cross-isaac/IsaacCross_Senior_Thesis/06_Figures_and_Media/Thesis_Figures/Ch03_Beam Source Design/He_leak_test_Ar_system.JPG

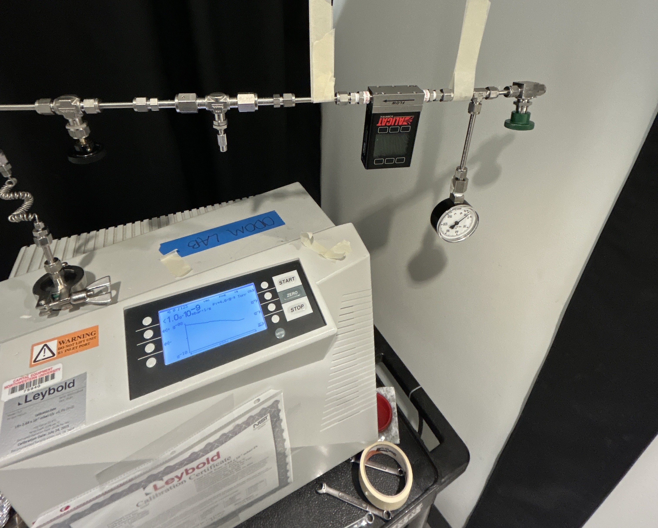
06_Figures_and_Media/Thesis_Figures/Ch03_Beam Source Design/He_leak_test_Ar_system.JPG
