cross-isaac/IsaacCross_Senior_Thesis/00_Thesis/README.md

# 00_Thesis — The thesis itself

- **`IsaacCross_SeniorThesis_2026.pdf`** — Final thesis (106 pages): *A Tunable Dual-Species
  Rubidium-Argon Beam Source for Controlled Doped Cryogenic Crystal Growth*.
  Chapters: 1 Intro · 2 Background (doped cryogenic crystals, T1/T2/T2*) ·
  3 Beam source design · 4 Characterization methods · 5 Characterization results ·
  6 Dipole-dipole broadening Monte Carlo · Appendices A–D (CAD drawings, Rb data,
  absorption data, simulation code).
- **`IsaacCross_SeniorThesis.zip`** — Full LaTeX source of the final document
  (chapter .tex files, figures, `references (2).bib`).
- **`thesis_content_tracker.md`** — Working outline used while writing: confirmed content,
  things tried and abandoned (fiber coupling, lock-in amplification), open questions
  (Method A vs. B divergence discrepancy, Rb flux ~100× below vapor-pressure expectation).
  Useful record of loose ends for follow-up work.

Note: an earlier, different LaTeX skeleton (9-chapter layout, AI-assisted) is archived at
`99_Archive/ai_generated_drafts/thesis_project_v2.zip`.
