cross-isaac/IsaacCross_Senior_Thesis/07_Talks_and_Posters/A Dual-Species Beam Source  for Doped Cryogenic Crystal Growth, CFP Pre talk.pptx

## A Dual-Species Beam Source for Doped Cryogenic Crystal Growth

Isaac K. Cross
04/14/2026 CFP Pre-talk

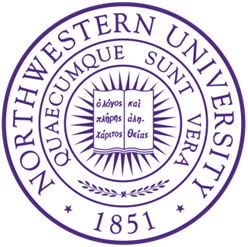
[picture p3: figure]
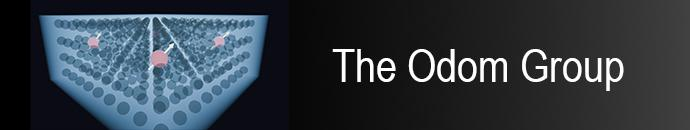
[picture p4: figure]
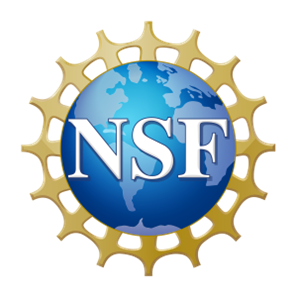
[picture p5: figure]

## Doped Cryogenic Crystal

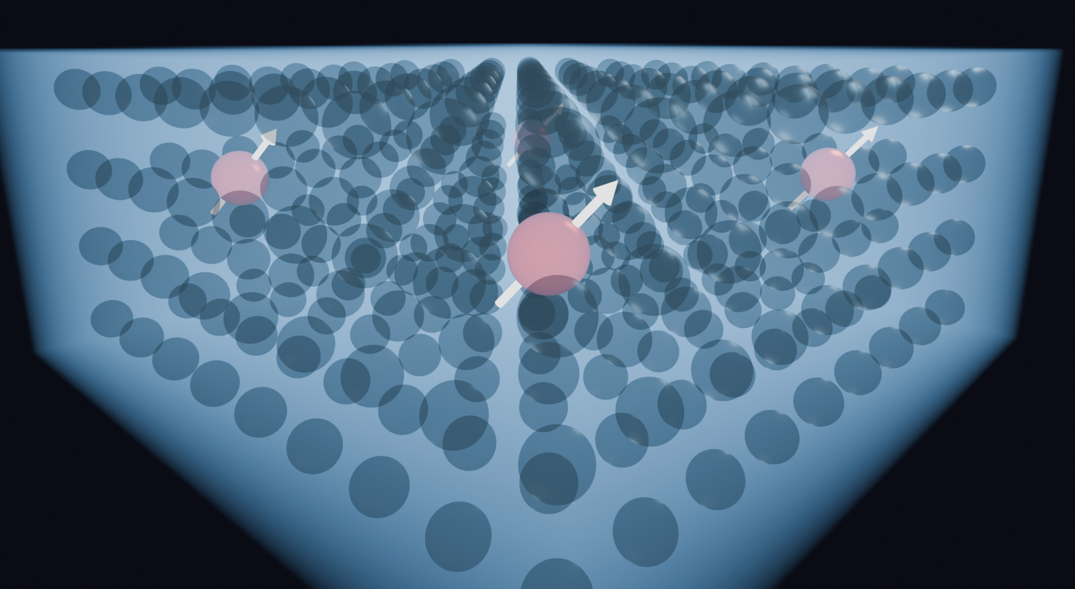
[picture p6: figure]

Inert Cryogenic Noble Gas Crystal Host
(e.g. Argon)

Dopant to be probed (e.g. Rb), up to 10^19 dopants/mm^3

*Not to scale

## Slide 3

Leading EDM Platforms

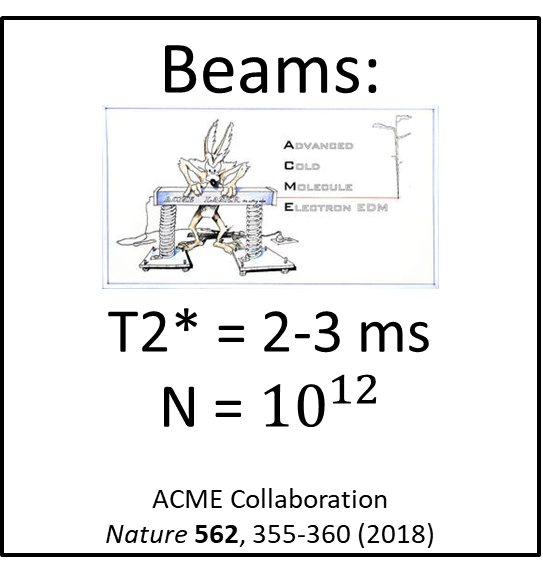
[picture p7: figure]
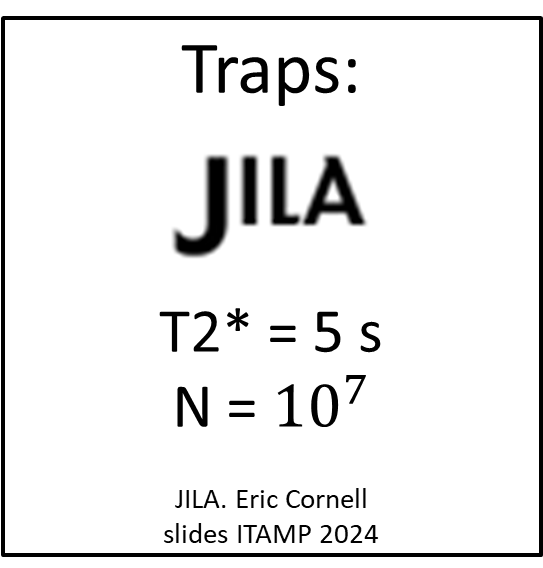
[picture p8: figure]
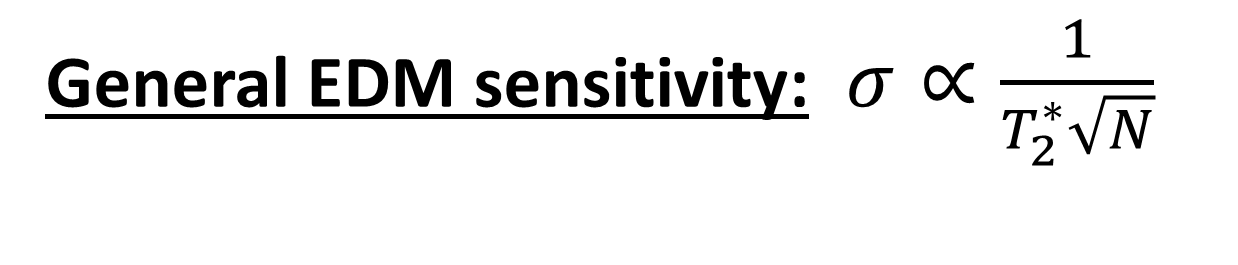
[picture p9: figure]

## Slide 4

Leading EDM Platforms

Doped Crystals?

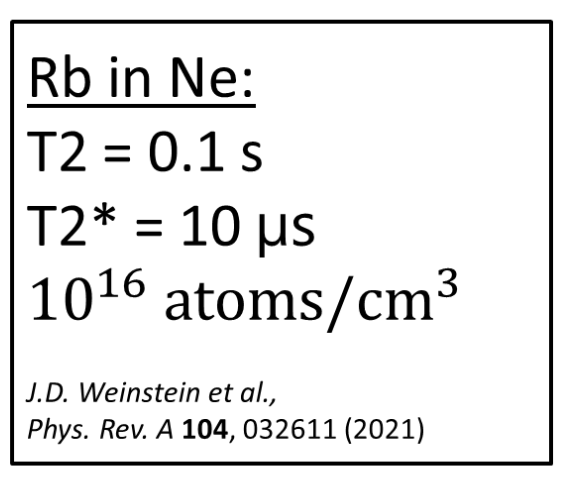
[picture p10: figure]

Notes: such that a doped cryocrystal could in principle provide in seconds the same uncertainty obtained by ACME in their 350-hour data set. Said a different way, the doped crystal would have over 1013 molecules in a 1 mm3 volume, which can be compared with the few hundred thousand molecules in the ACME-II beam at any given time.

## Our Growth Method

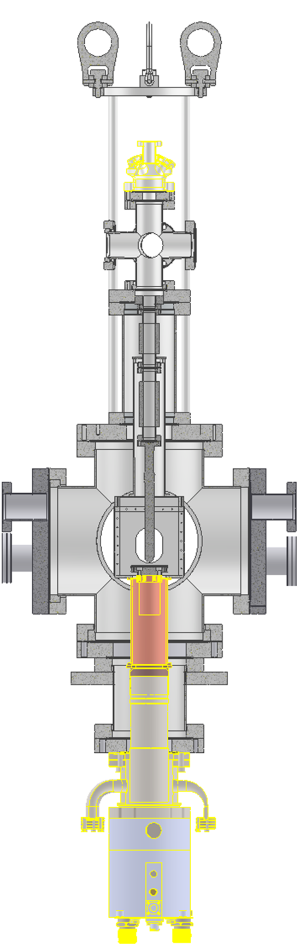
[picture p11: figure]
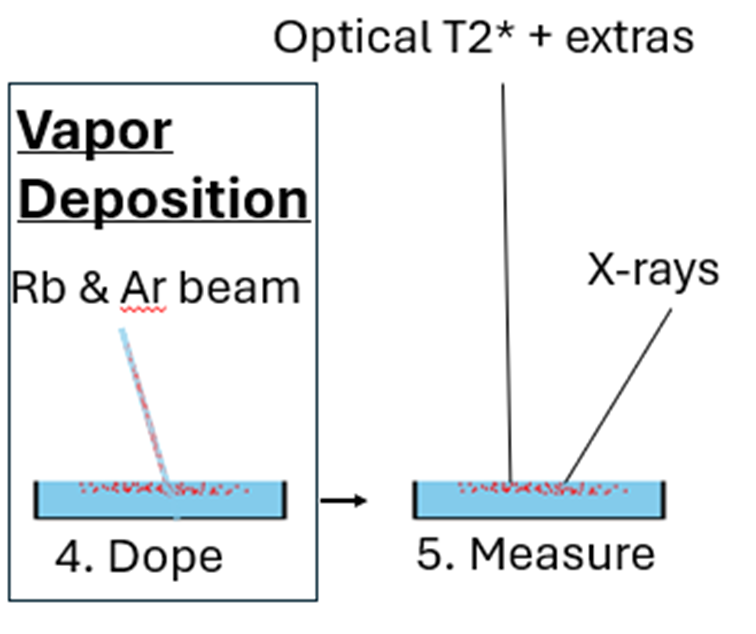
[picture p12: figure]
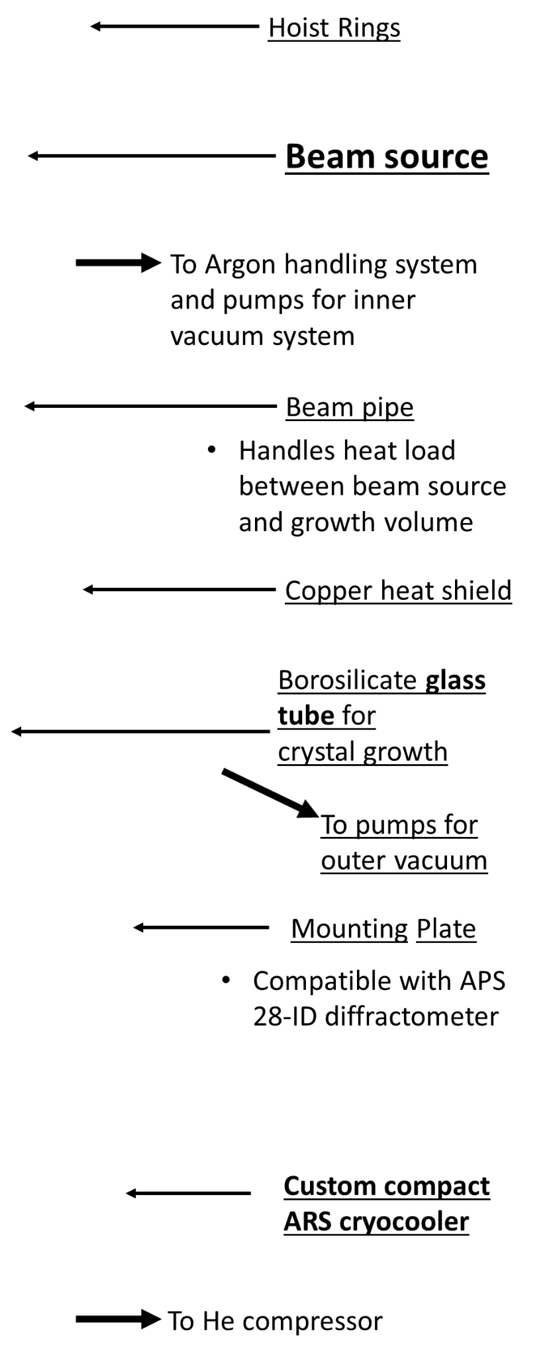
[picture p13: figure]

Notes: Expect to grow slower/ UHV

## Our Growth Method

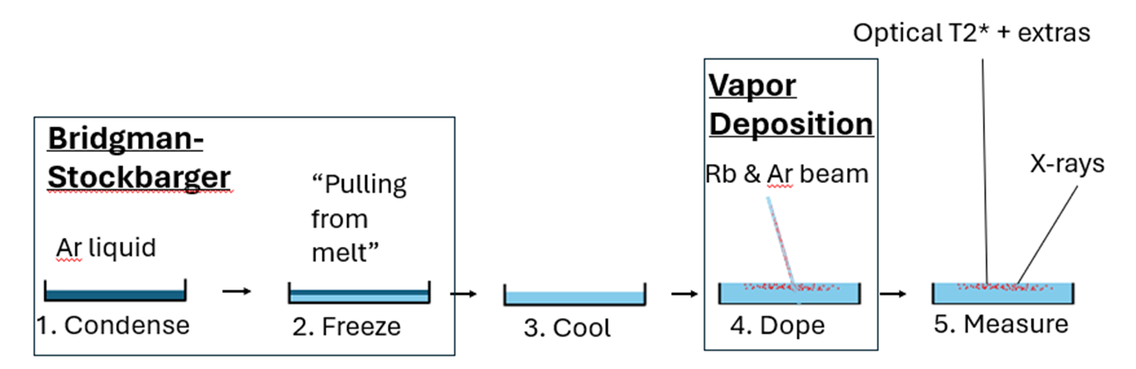
[picture p14: figure]
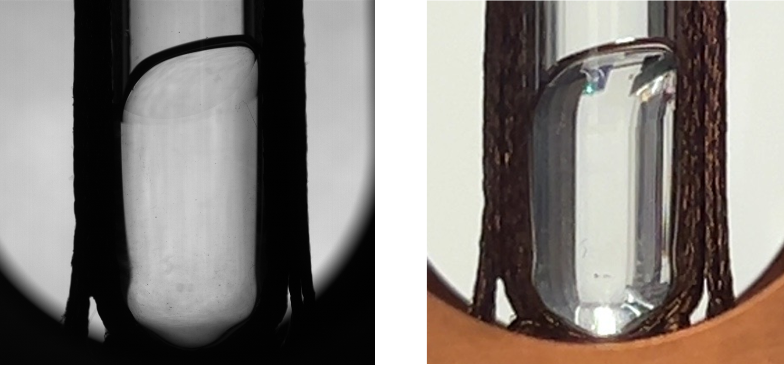
[picture p15: figure]

Ar Crystals!

Notes: Expect to grow slower/ UHV

## Our Growth Method

Ar Crystals!

Notes: Expect to grow slower/ UHV

## Beam Source Constraints

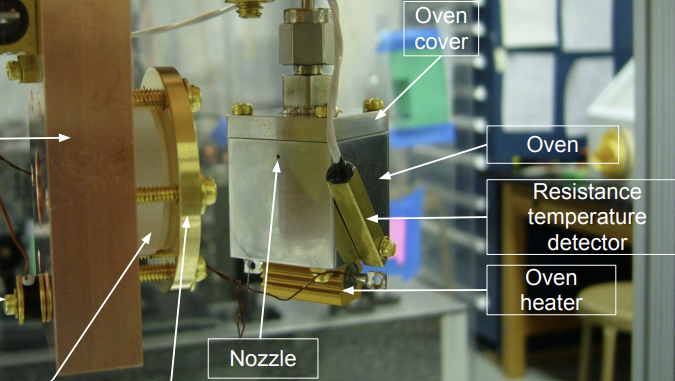
[picture p16: figure]

Regmi, 2013, M.S. thesis, University of Nevada, Reno.
Weinstein Group

Ar

Rb

- Dopant Density ∝P_(Rb) /P_(Ar)
- Growth Rate ∝P_(Ar) C_(nozzle)
- P_(Rb) ≪P_(Ar)

Notes: Also want slower growth rates than others therefore lower Ar Pressure and therefore even lower Rb pressure….

## Beam Source Constraints

Regmi, 2013, M.S. thesis, University of Nevada, Reno.
Weinstein Group

Ar

Rb

- Dopant Density ∝P_(Rb) /P_(Ar)
- Growth Rate ∝P_(Ar) C_(nozzle)
- P_(Rb) ≪P_(Ar) ⇒ T_(Rb) <0^(°) C

Notes: Also want slower growth rates than others therefore lower Ar Pressure and therefore even lower Rb pressure….

## Beam Source Constraints

Regmi, 2013, M.S. thesis, University of Nevada, Reno.
Weinstein Group

“Mixing Chamber”

Ar

“Rb Reservoir”

Rb

- P_(RbMc) ∝P_(RbRs) (C_V)/(C_V +C_N)

Notes: Check this shit plz

## Beam Source Constraints

~0.5 m

Ar

~1 cm

Rb

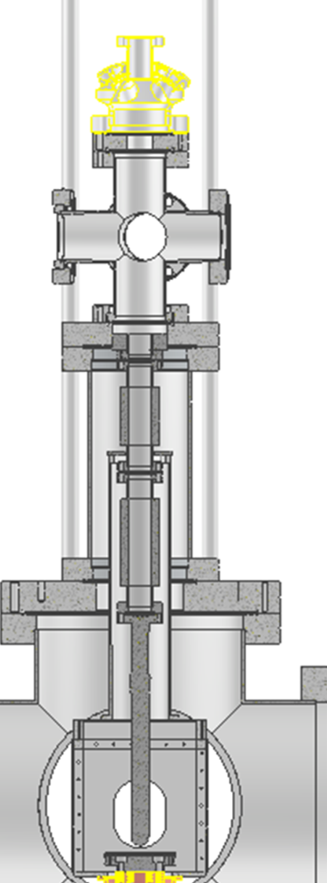
[picture p17: figure]

- Bridgman-Stockbarger ⇒ inner + outer chamber
- X-ray compatibility ⇒ strict spatial contraints
- ⇒ long path to reduce heat loads

Notes: Make it more clear how bridgman-stockbarger forces these connections and its a mechnical constraint.

## Beam Source Constraints

~0.5 m

Ar

Collimating Nozzle

~1 cm

Rb

- Need large Ar flux
- Narrow divergence

Notes: Be prepared for why not just increase Ar and Rb high enough and let it fly everywhere.

Think about Neon, gets very expensive….

## Microcapillary Nozzle Array

- 231, 100 µm ID, ~0.8 cm length microcapillaries
- Wire EDM cut 5ft microcapillary from MicroGroup
- Wire EDM cut 2.75” CF flange

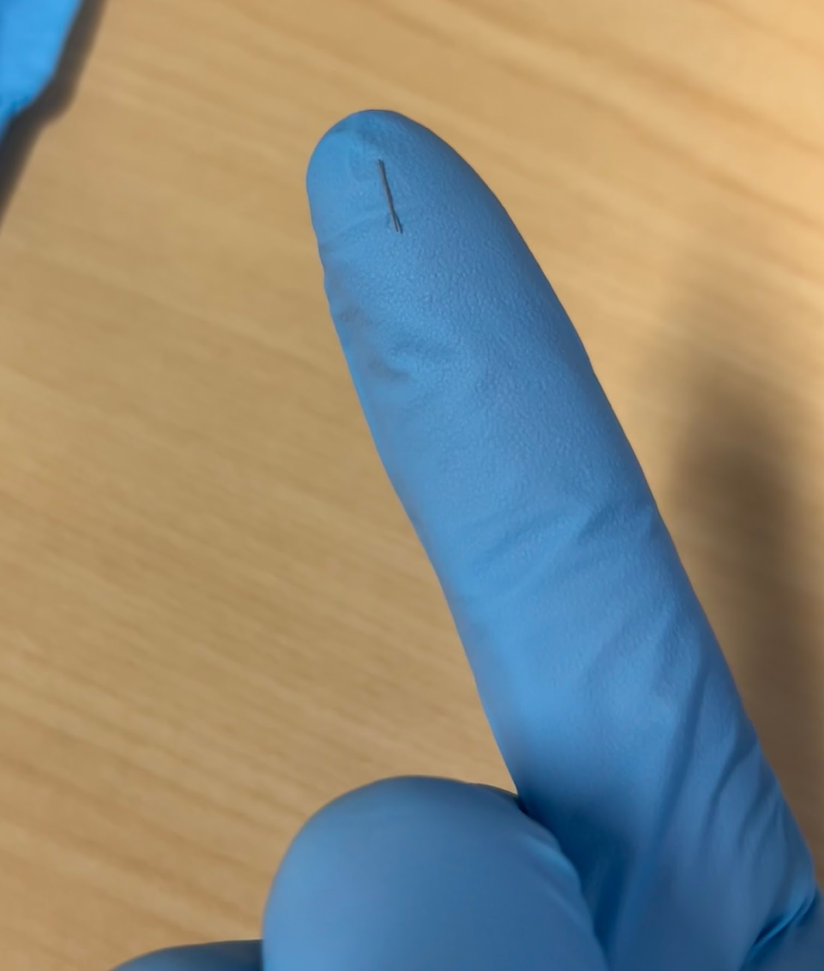
[picture p18: figure]
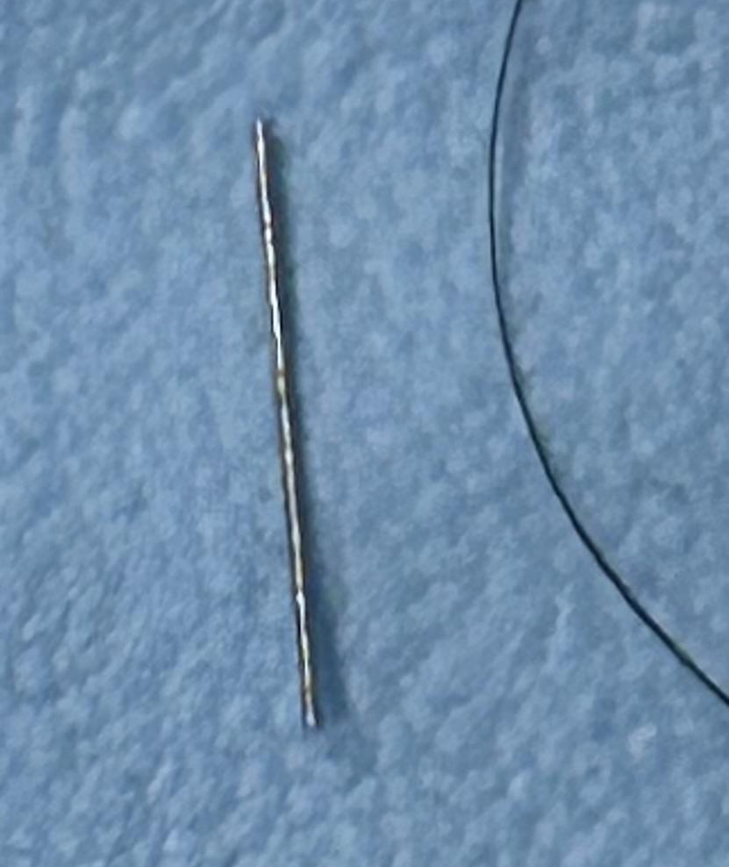
[picture p19: figure]

hair for reference

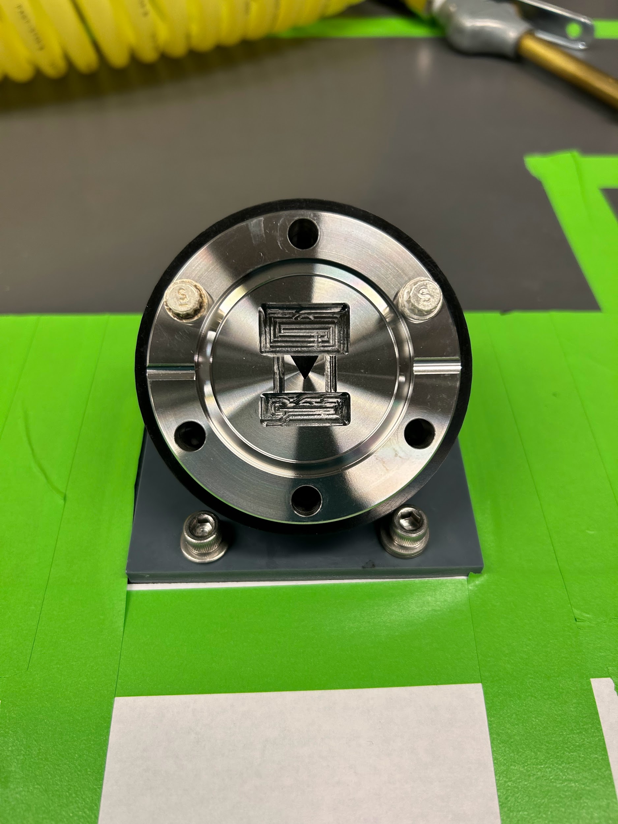
[picture p20: figure]

Assembly Setup

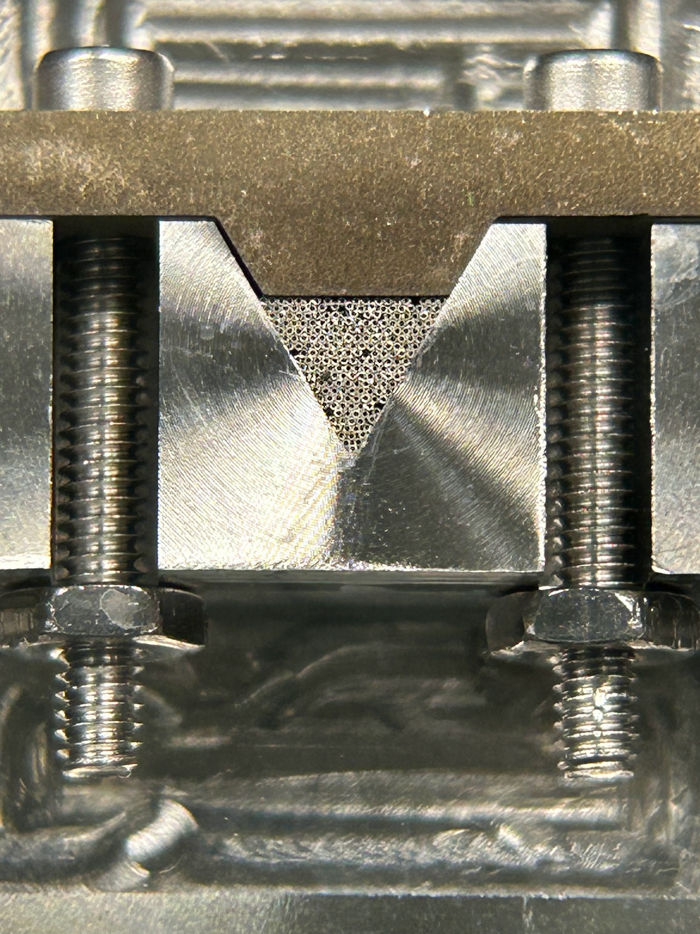
[picture p21: figure]

Oven Side

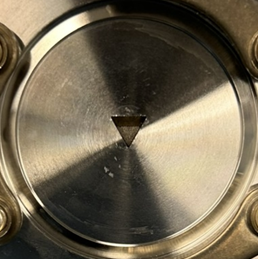
[picture p22: figure]

Growth Chamber Side

Original Design:
R. Senaratne et al., Rev. Sci. Instrum. 86, 023105 (2015).

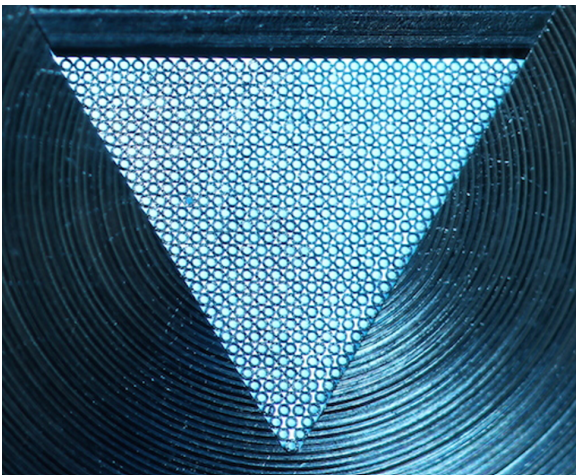
[picture p23: figure]
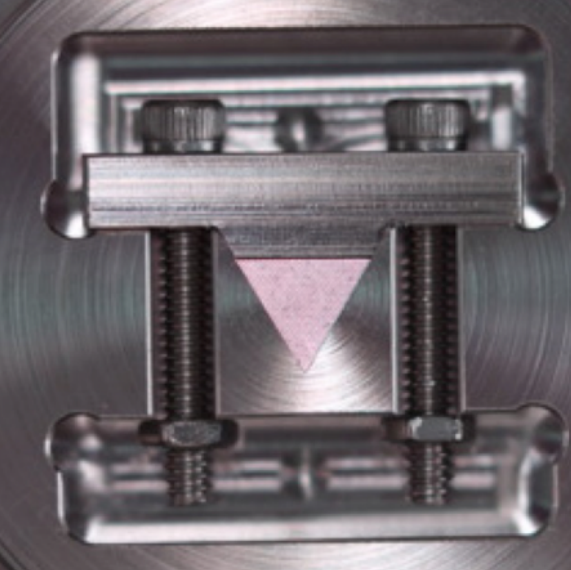
[picture p24: figure]

## Characterizing Beam Source

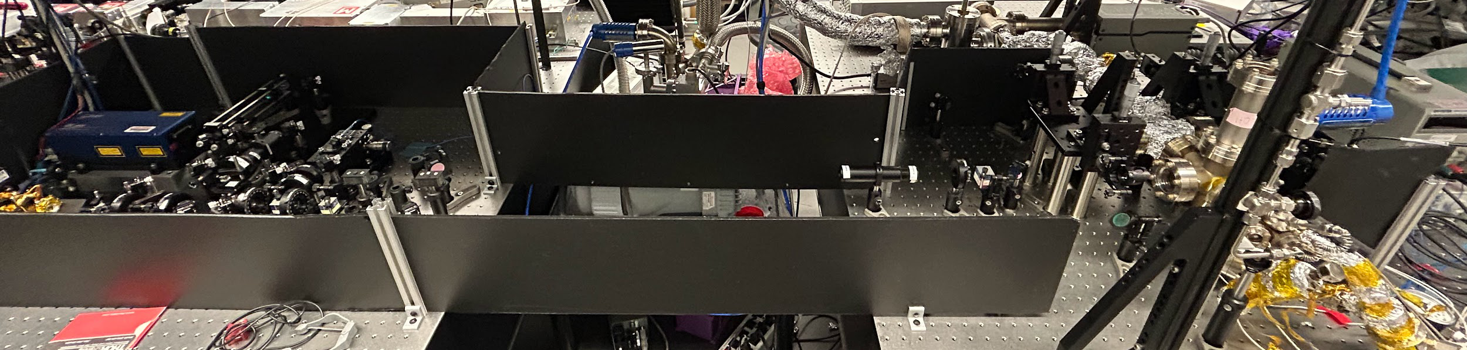
[picture p25: figure]

Nozzle

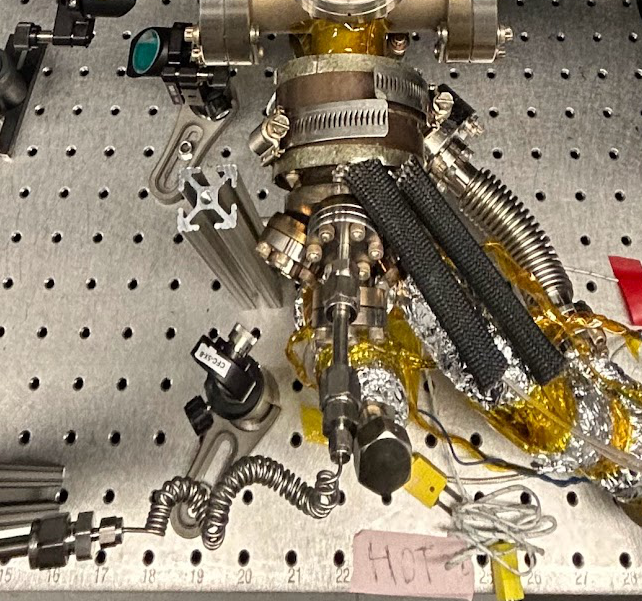
[picture p26: figure]

Rb Reservoir

Ar Line

## Characterizing Beam Source

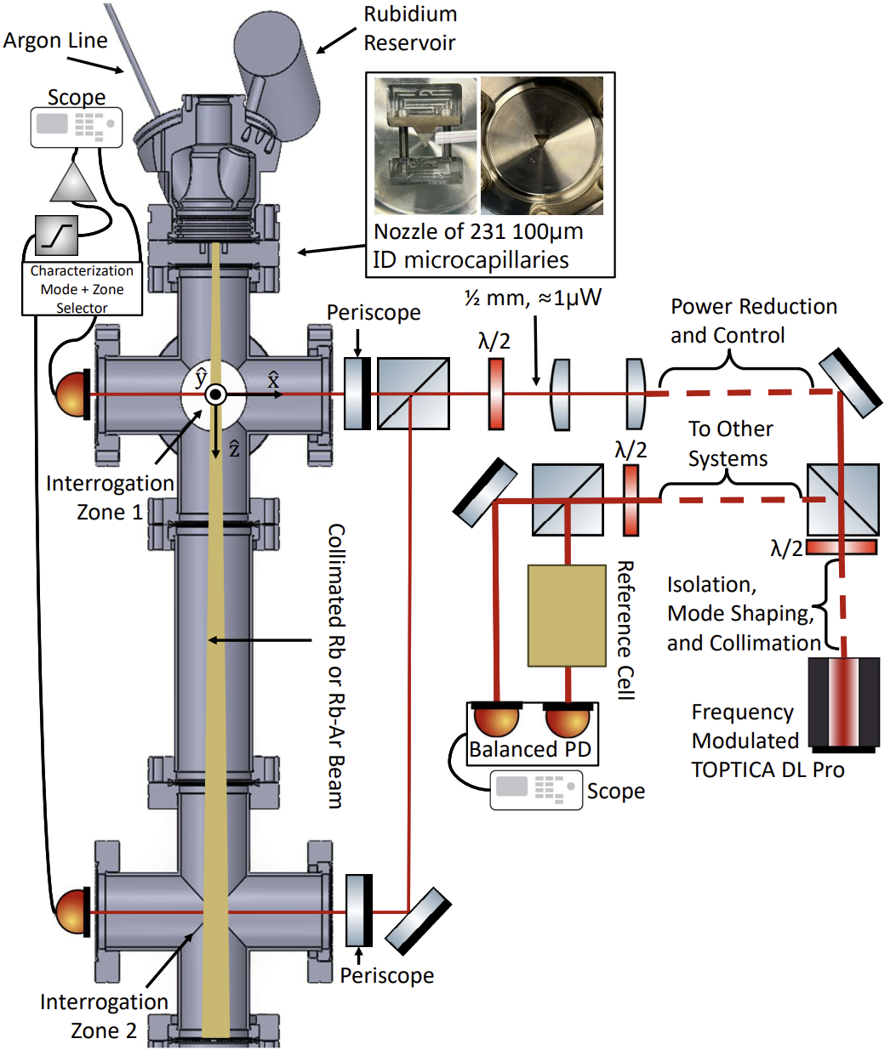
[picture p27: figure]
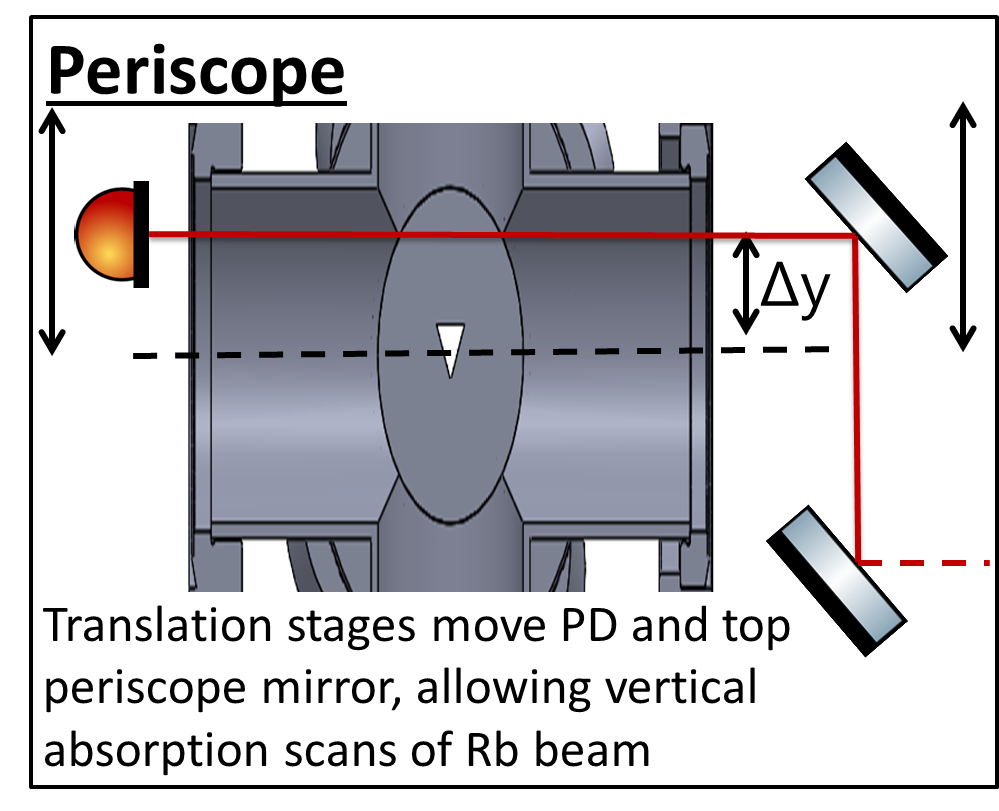
[picture p28: figure]

- λ_(Rb) ≤λ_(Ar)
- Want λ≥L_(cap)

## Characterizing Beam Source

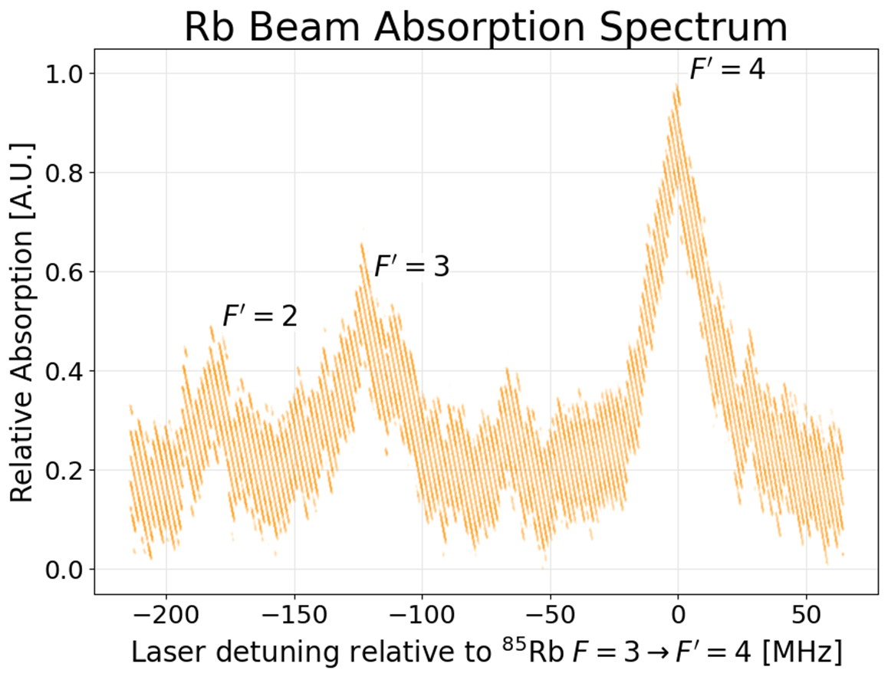
[picture p29: figure]
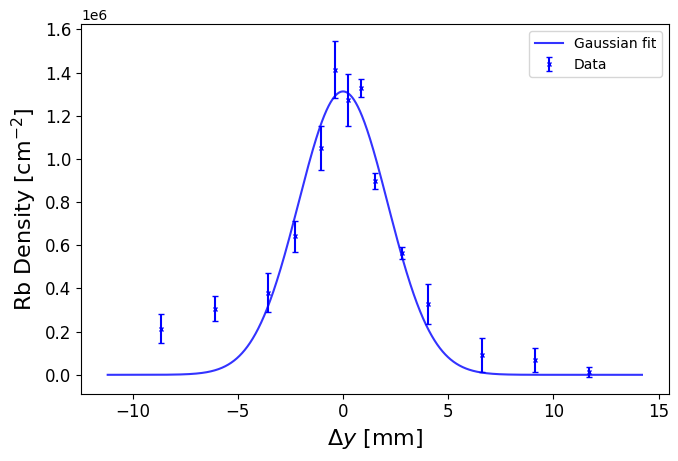
[picture p30: figure]

Notes:
Add line about sensitivity (acme stats) and time to grow crystal

## Characterizing Beam Source

- (α)_(1/e) =1±0.1 degrees
- Rb Flux: 2.5∗10^10 atoms/s
- Ar Flux: 5∗10^15 atoms/s
- Dopant Density: 10^17 dopants/cm^3
- Growth rate: 5 μm/hour

Notes:
Add line about sensitivity (acme stats) and time to grow crystal

## Characterizing Beam Source

- (α)_(1/e) =1±0.1 degrees
- Rb Flux: 2.5∗10^10 atoms/s
- Ar Flux: 5∗10^15 atoms/s
- Dopant Density: 10^17 dopants/cm^3
- Growth rate: 5 μm/hour
- ⇒10^13 dopants in 5 hours

Notes:
Add line about sensitivity (acme stats) and time to grow crystal

## Next Steps

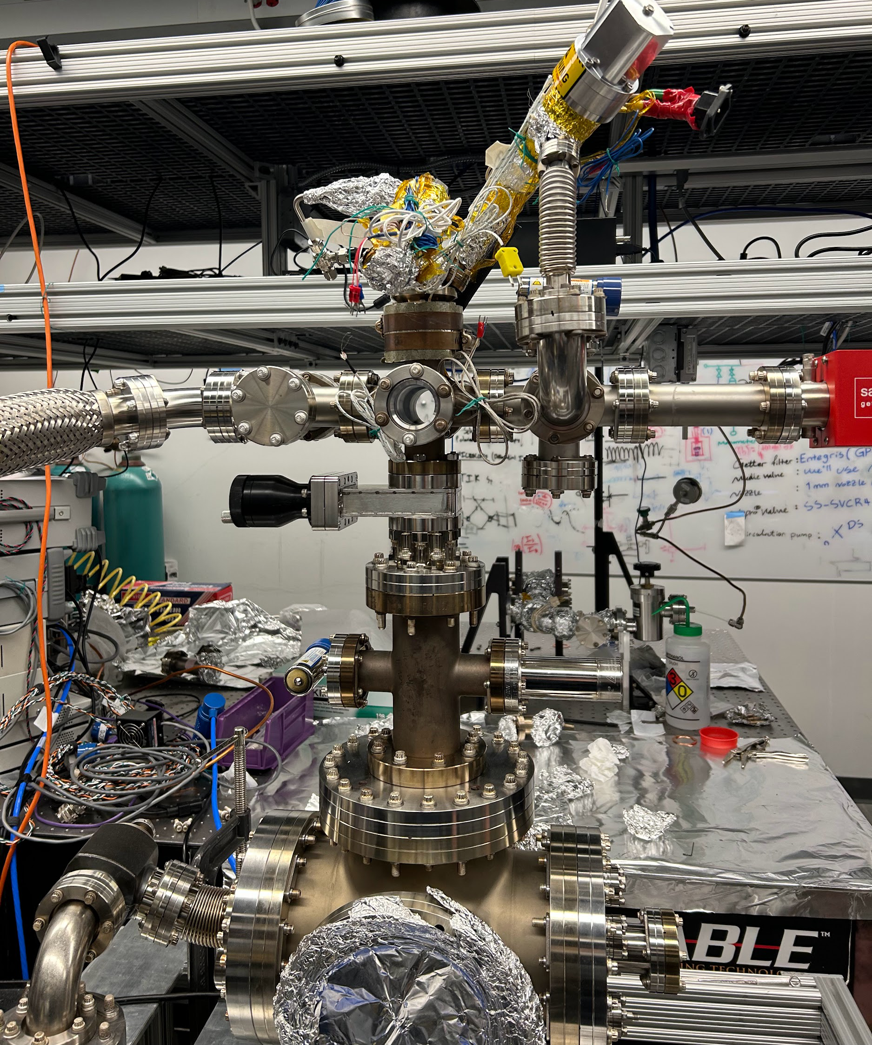
[picture p31: figure]

- Grow Doped Crystals!!
- Measure crystal properties to check beam characterization
  - Growth Rate/Dopant Density can be directly measured
- Explore larger parameter space

## Acknowledgements

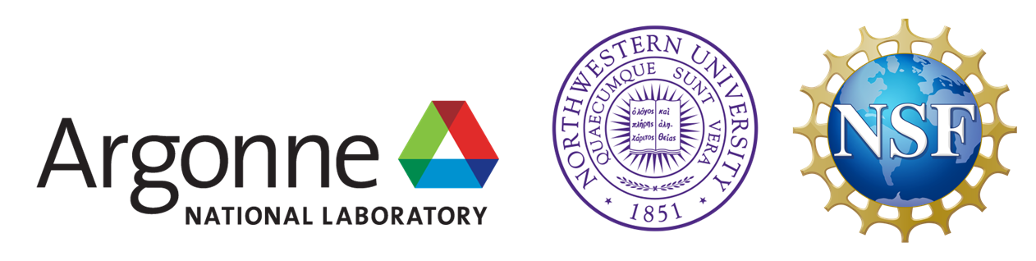
[picture p32: figure]
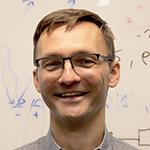
[picture p33: figure]

Brian Odom

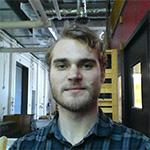
[picture p34: figure]

Daniel Lutes

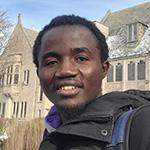
[picture p35: figure]

Joel Adhiambo

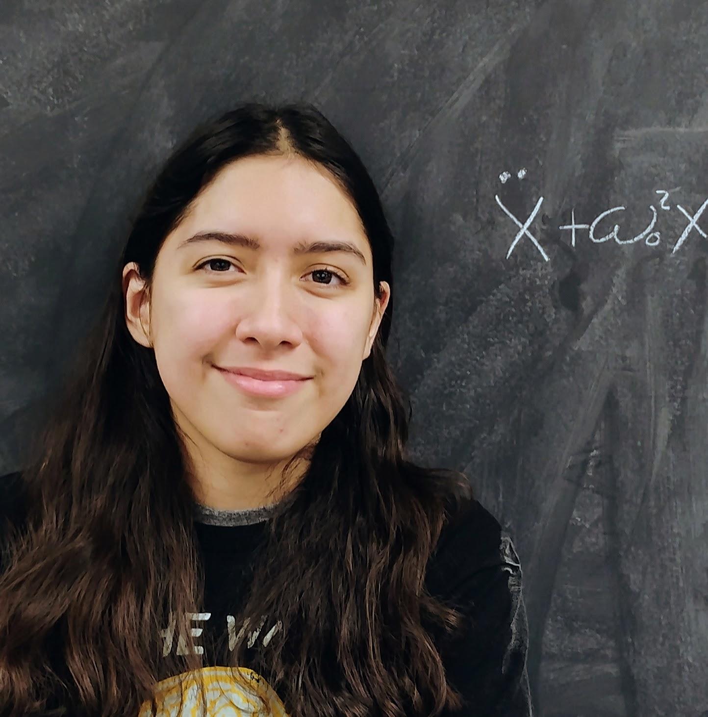
[picture p36: figure]

Haley Randall

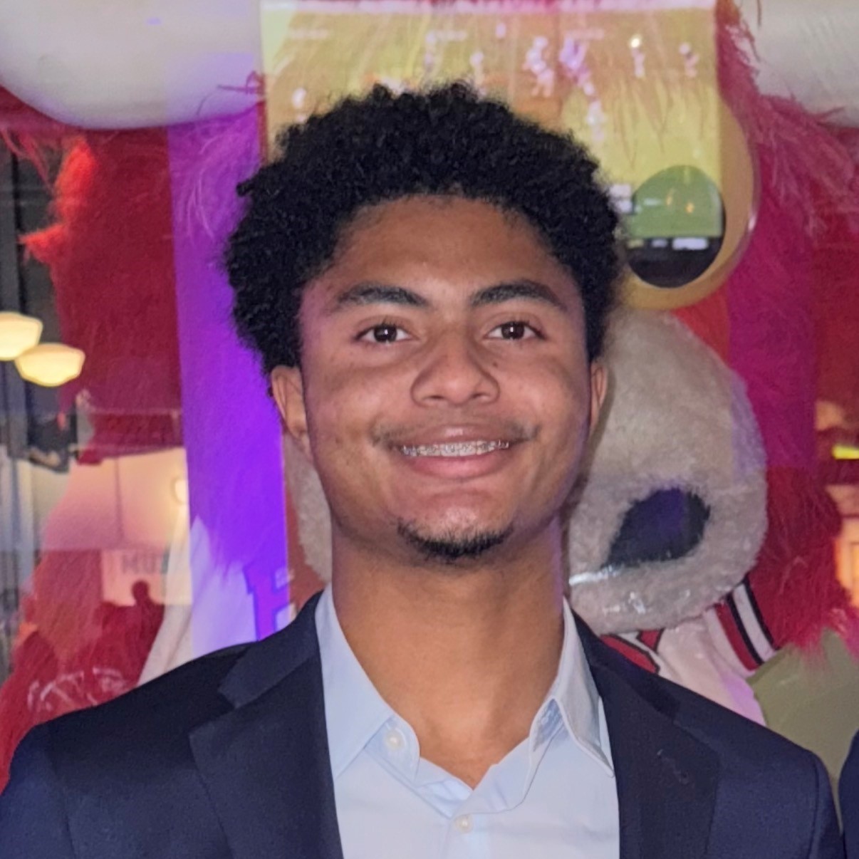
[picture p37: figure]

Brandon Lofton

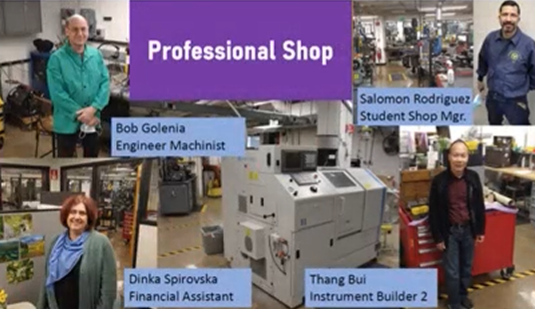
[picture p38: figure]

Kovachy
Lab

ACME

Xing Fan

Tim Kovachy

Sharika Saraf

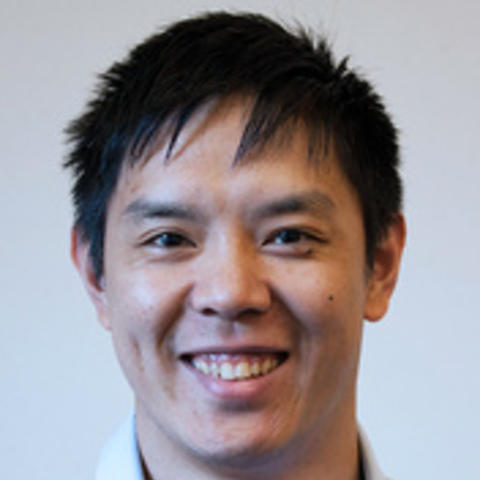
[picture p39: figure]
Prof. Xing Fan portrait

The study resulting in this presentation was assisted by a grant from the Undergraduate Research Grant Program which is administered by Northwestern University's Office of Undergraduate Research. However, the conclusions, opinions, and other statements in this presentation are the author's and not necessarily those of the sponsoring institution.

## Supplemental Slides:

## Divergence

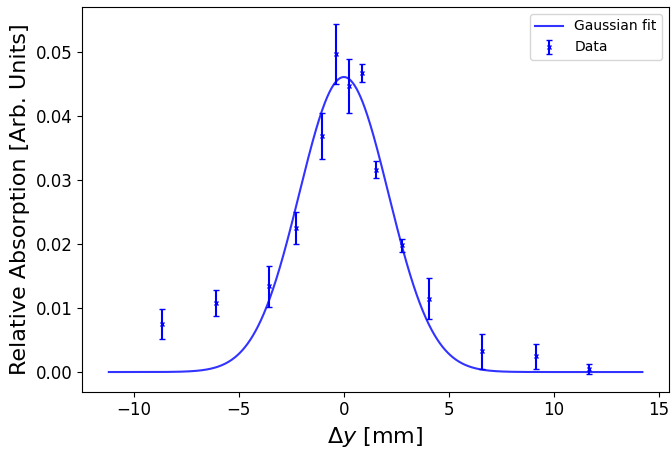
[picture p40: figure]

Θ

1/e width

Notes: Cut

## Slide 23

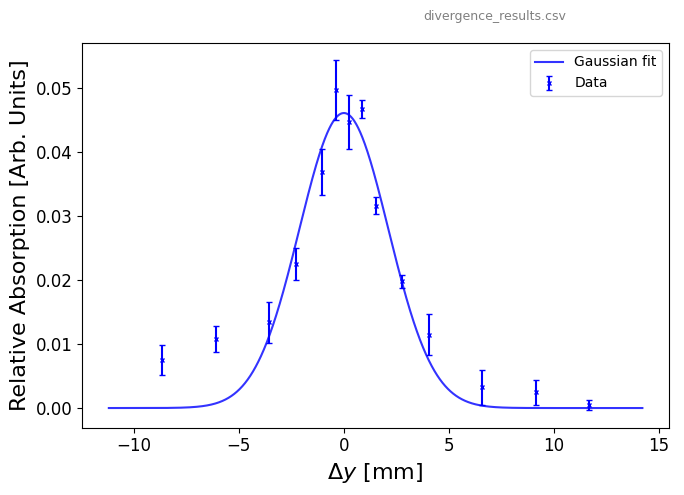
[picture p41: figure]
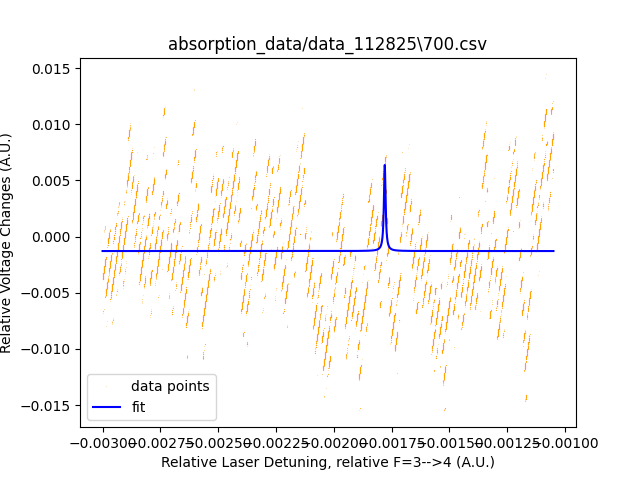
[picture p42: figure]

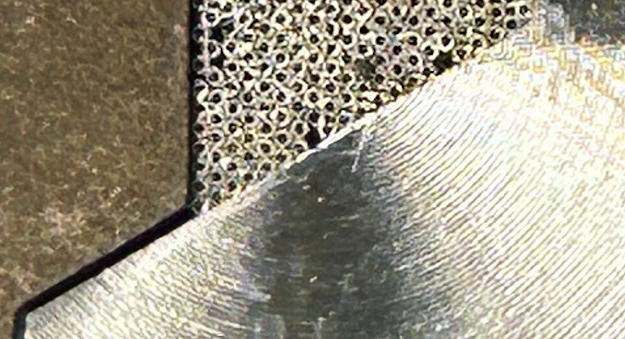
[picture p43: figure]

## Rb-Ar

Smth about Ar and Rb being same divergence….

- λ = k_B T/(sqrt[2]pi*d^2*P)
- Prb << Par
- λrb/λar ~ d_ar^2/d_rb^2
~½

- Want λ ~> L > d to get aspect ratio like divergence.
- -> λrb will exit ideal regime of divergence set by aspect ratio before λar does

Notes: Cut

## Slide 25

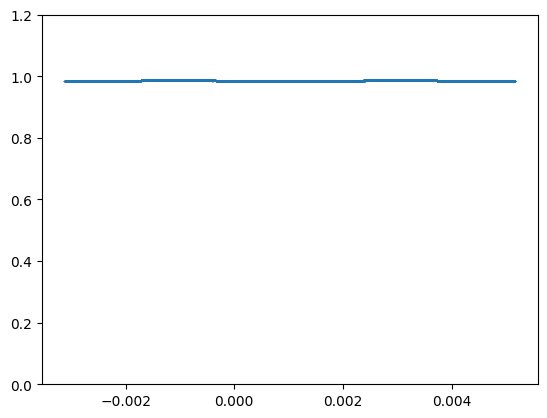
[picture p44: figure]
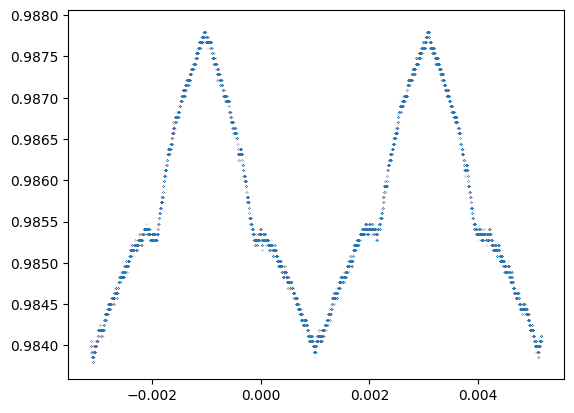
[picture p45: figure]
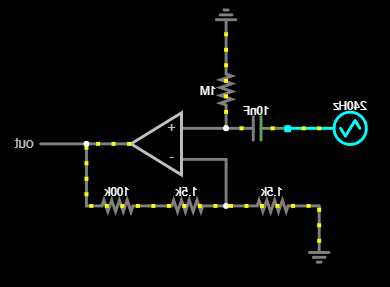
[picture p46: figure]
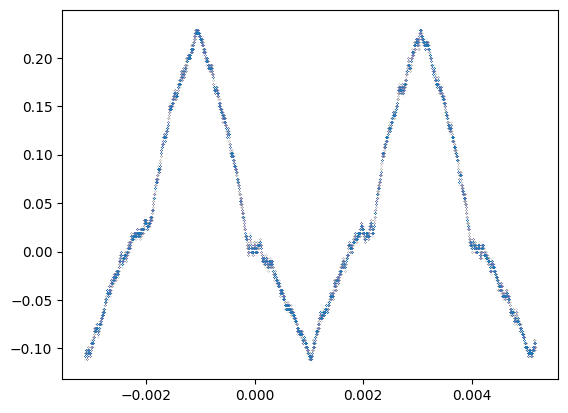
[picture p47: figure]
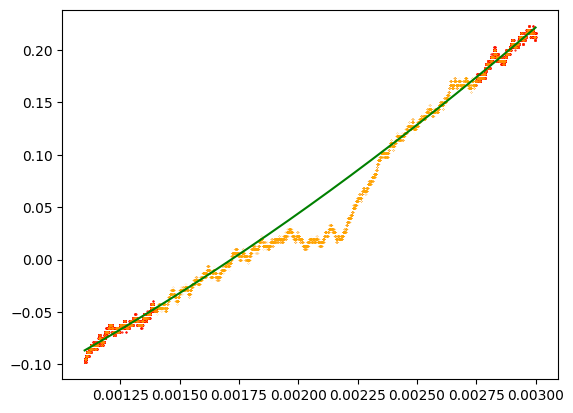
[picture p48: figure]
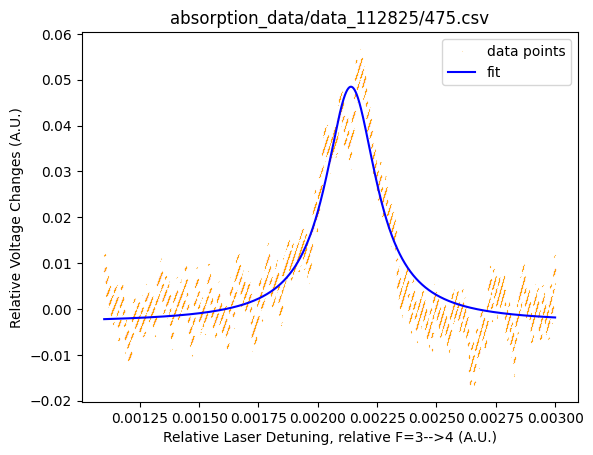
[picture p49: figure]

## Slide 26

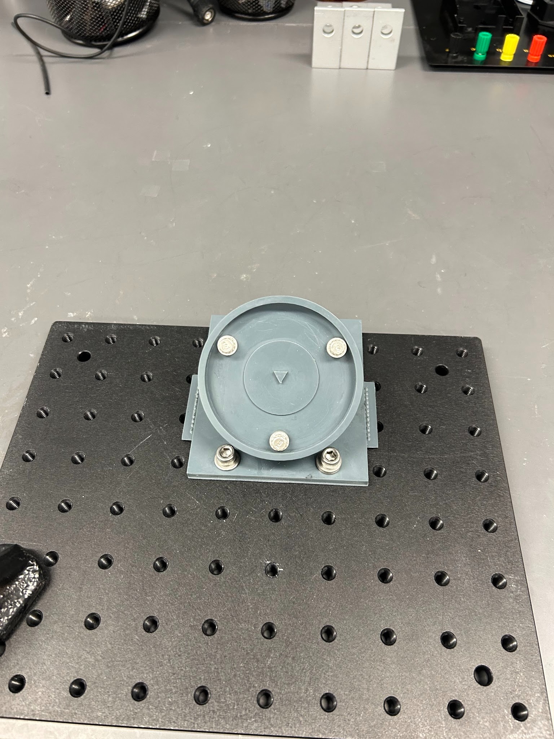
[picture p50: figure]
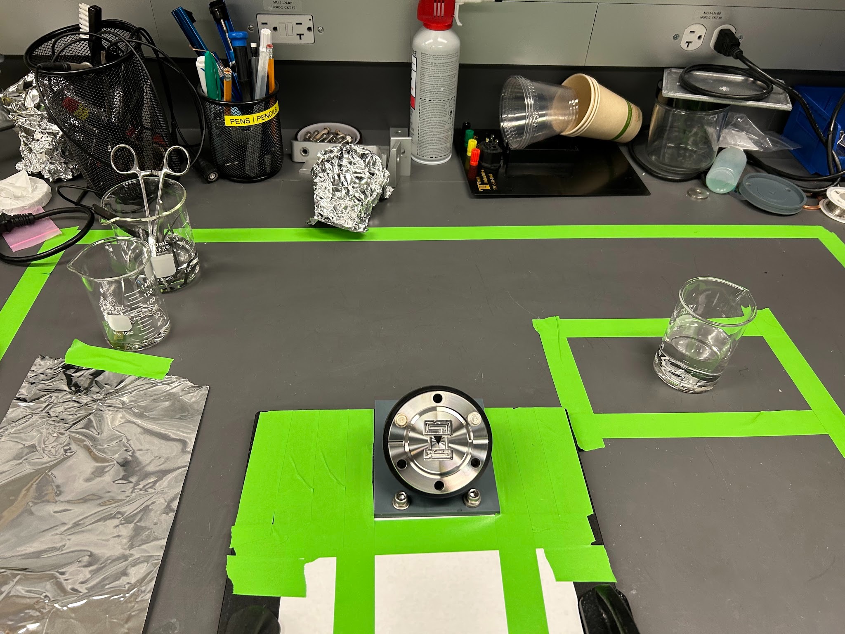
[picture p51: figure]
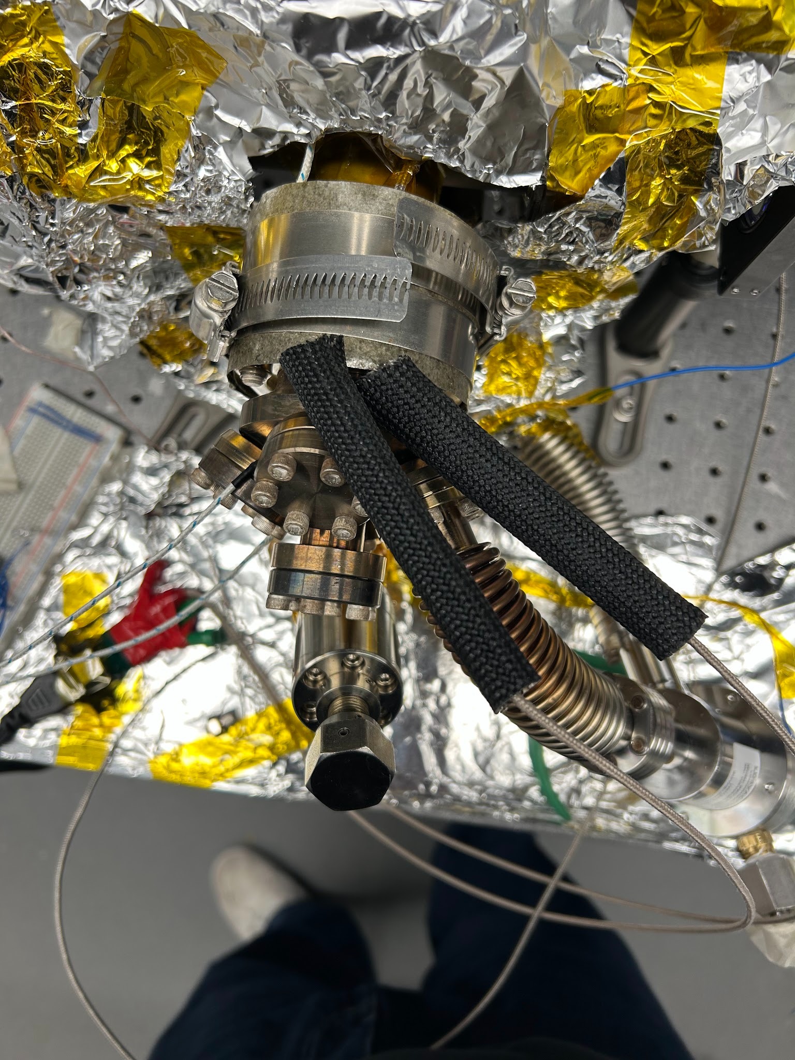
[picture p52: figure]

## Slide 27

Current Doped Cryogenic Crystals

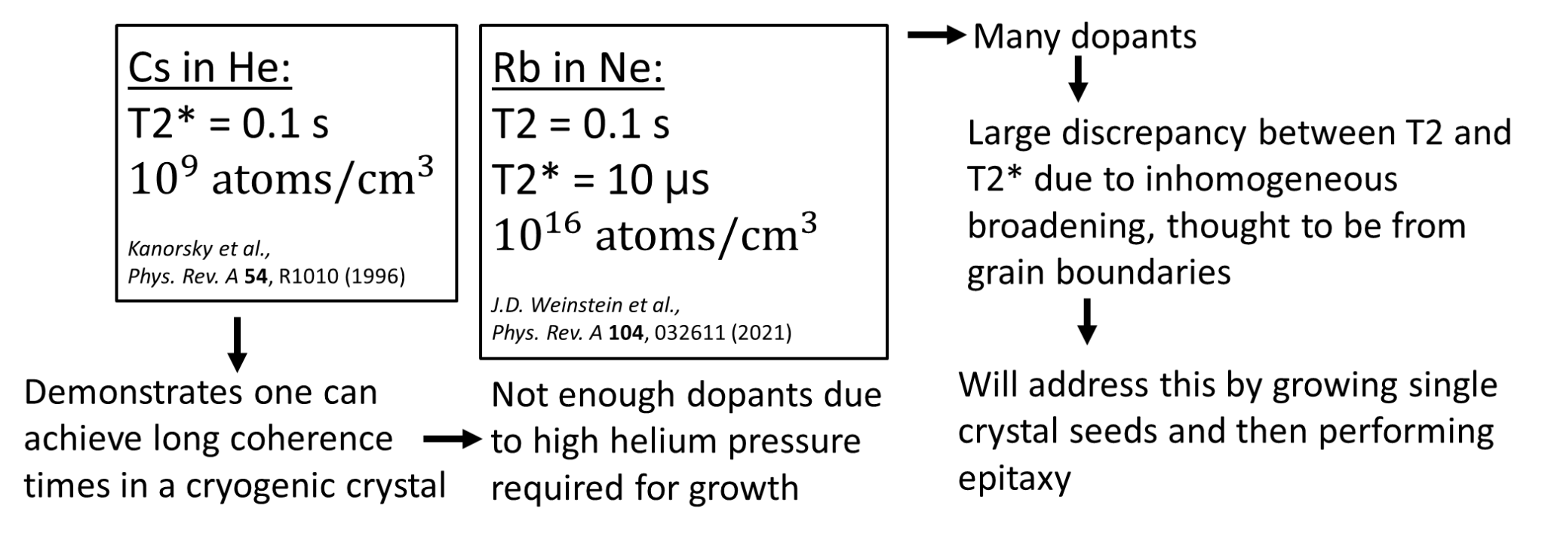
[picture p53: figure]

## Slide 28

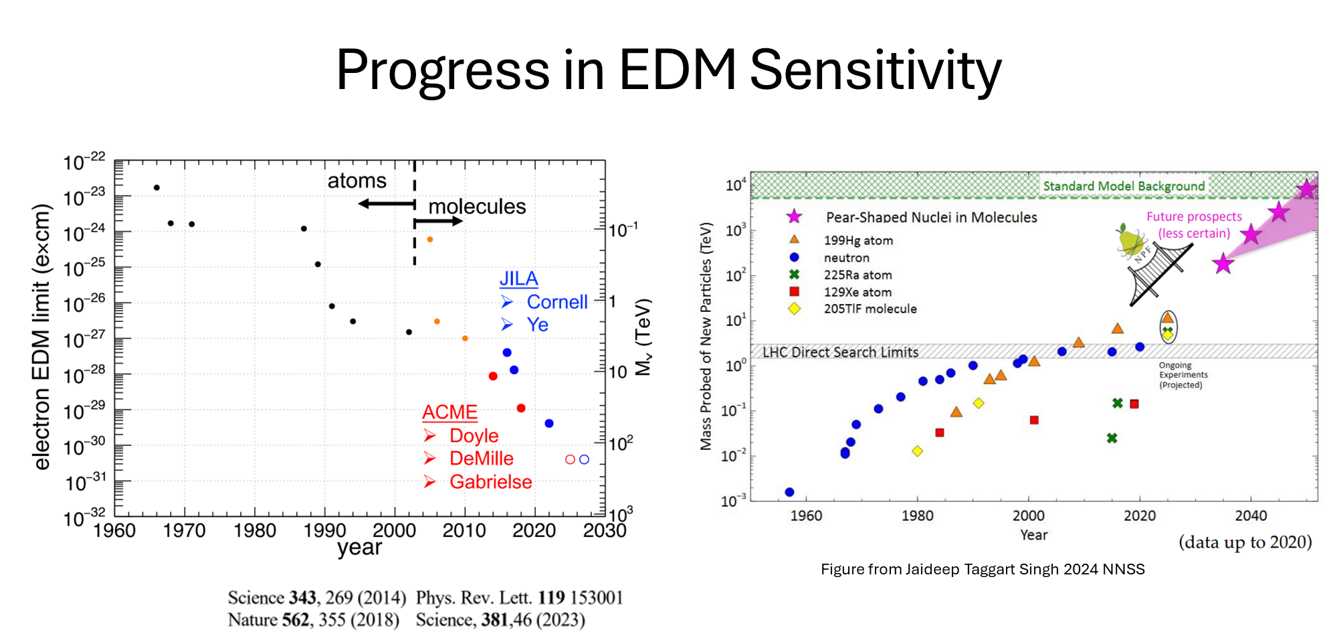
[picture p54: figure]

## Slide 29

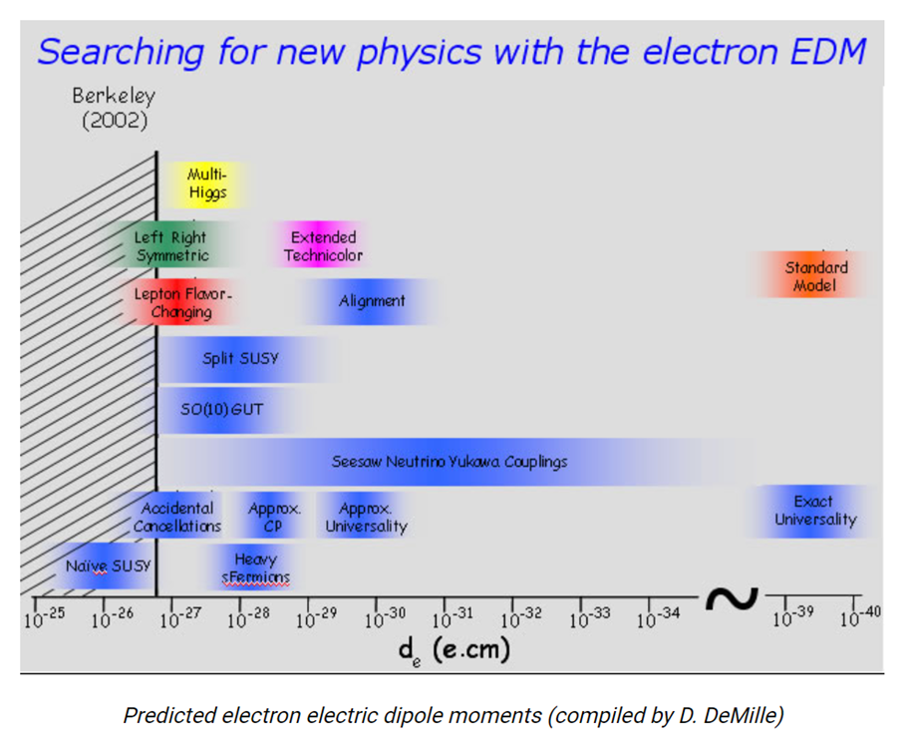
[picture p55: figure]
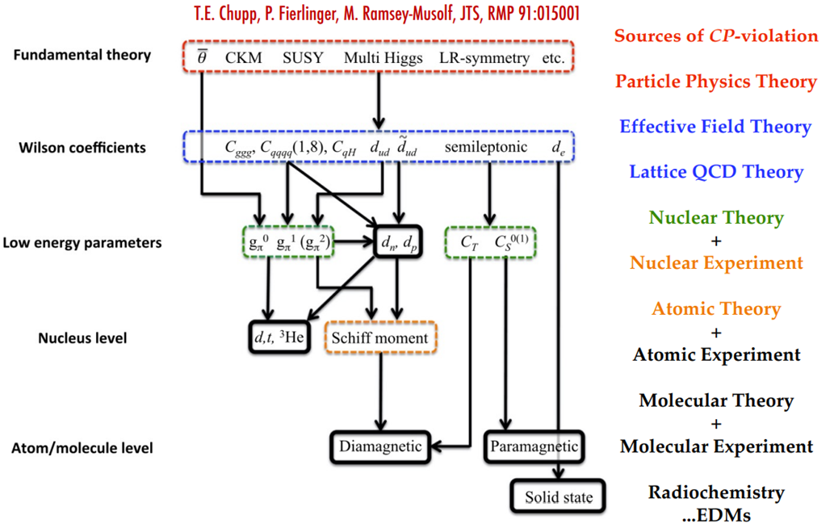
[picture p56: figure]

## Slide 30

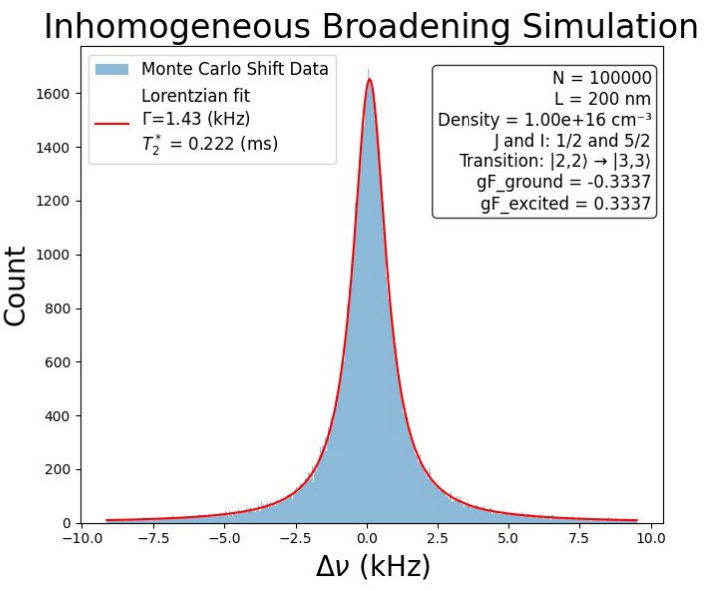
[picture p57: figure]
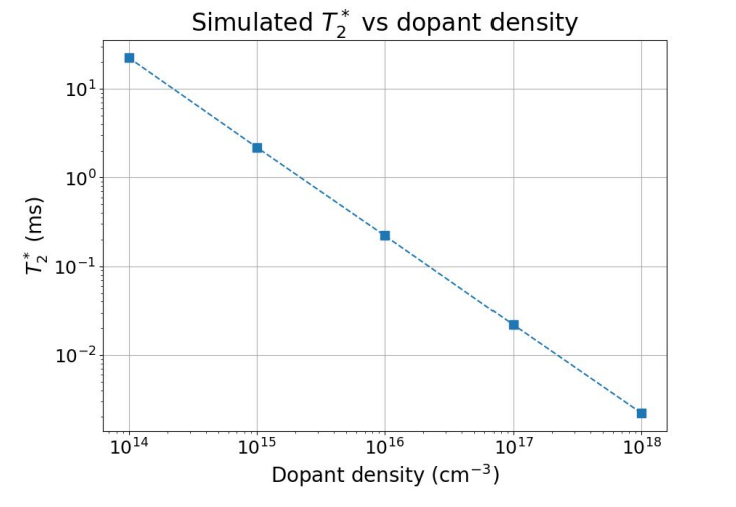
[picture p58: figure]

## Slide 31
