cross-isaac/IsaacCross_Senior_Thesis/07_Talks_and_Posters/ICross_421_Poster.pptx

POSTER TITLE
Author List
Department of Biomedical Engineering, Northwestern University, Evanston, IL, USA

Modeling Inhomogeneous Broadening through Spin-Spin Interactions
in Matrix Isolated Spin Ensembles
Isaac Cross
Northwestern University, Evanston, IL

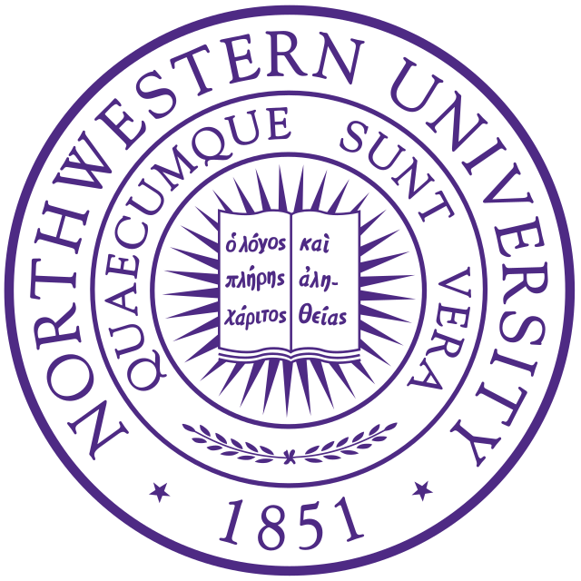
[picture p59: figure]
Northwestern University - Wikipedia
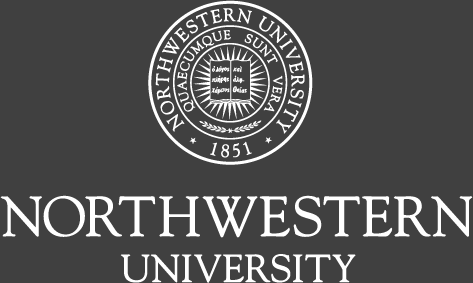
[picture p60: figure]

Introduction

A large field of physics involves looking at an atom’s internal “spin states” and the transitions between these states. These spin states act as incredibly sensitive probes and can be used to search for new physics. The sensitivity to many of these searches is proportional to 1/(T_2^(∗) √N) . We can improve N, number of spins probed, by isolating a huge number of them in a matrix. However, current matrix isolation experiments have a very small “coherence time”, T_2^(∗) due to inhomogeneous broadening. The source of this broadening is debated, some claim it’s from crystal defects, while others claim its from spins interacting. The goal of my project, therefore, is to model these spin interactions and the resulting inhomogeneous broadening using Monte Carlo Methods.

Broadening Model

- Inhomogeneous broadening can be thought of as the distribution of Δν in an ensemble of atoms (dopants).
- To estimate this distribution, we use a Monte Carlo method
- We start by defining a test cell with side length L . We place a test atom at the origin and distribute N_(neighbors) dopants, located at r_i , in the cell corresponding to the atom density ρ .

Test Cell Spin States Model:
- We choose an atomic transition to model at the central test atom
|F_1 ,m_(F,1) ⟩→|F_2 ,m_(F,2) ⟩
- Surrounding atoms are prepared into |F_1 ,m_(F,1) ⟩ using two “pumping efficiencies”
  - F efficiency p_F : fraction atoms forced into F_1 ; remaining assigned randomly to F_1 or F_2
  - m_F efficiency p_(m_F) : fraction atoms forced into m_(F,1) ; remaining assigned randomly over m_F =−F_1 ,…,+F_1

Spin Magnetization Model:
- Experiments typically apply a static magnetic field, B_0 , along the z-axes, which aligns the magnetic moments of our spins along z.
- To model variation in this alignment, we add alignment efficiency p_(align) : fraction of spins with magnetization set along z; remaining assigned random orientation on unit sphere.

Determining Broadening:
- Using the distribution of spins in our test cell we determine the total magnetic field at the origin and corresponding frequency shift:
B_z (0,0,0)=z⋅∑_(i=1)^(N_(neighbors)) B(−r_i ,m_i ) Δν=γ_(eff) B_z (0,0,0)
- By generating multiple test cells and collecting Δν each time, we can create a distribution of how often certain Δν ’s occur. Extracting inhomogeneous broadening

Results

How Broadening Model Scales With Key Inputs:
- Comparing T_2^(∗) times as we vary dopant density and change our pumping and alignment efficiencies.
- Modeling Rubidium-85 ( I=5/2 , J=1/2 ), transition: |2,2⟩→|3,3 ⟩

Compare to Experimental Results, High Dopant Density:
From [1]. Linewidths reported for K-39 ρ=5×10^16 cm^(−3) , Rb-85/87
ρ=1×10^18 cm^(−3) , and Cs-133 ρ=1×10^17 cm^(−3)

Compare to Experimental Results, Low Dopant Density:
From [2]. Rb-85 F=3, ρ=1.5×10^16 cm^(−3)

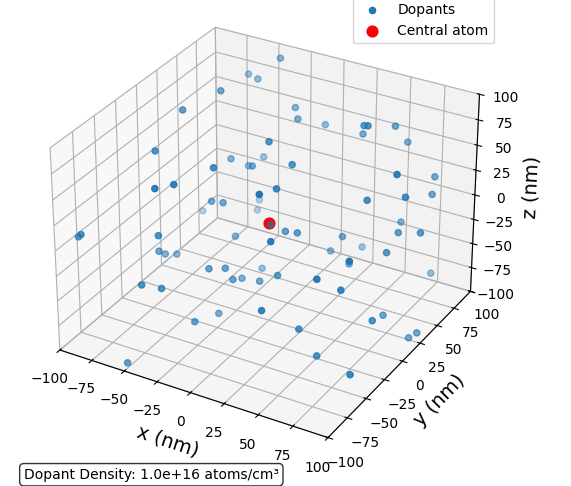
[picture p61: figure]

N_(neighbors) ~Poisson(λ)−1 , λ=ρL^3

r_i =(x_i ,y_i ,z_i )~Uniform[[−L/2,L/2]^3 ] , i=1,2,…,N_(neighbors)

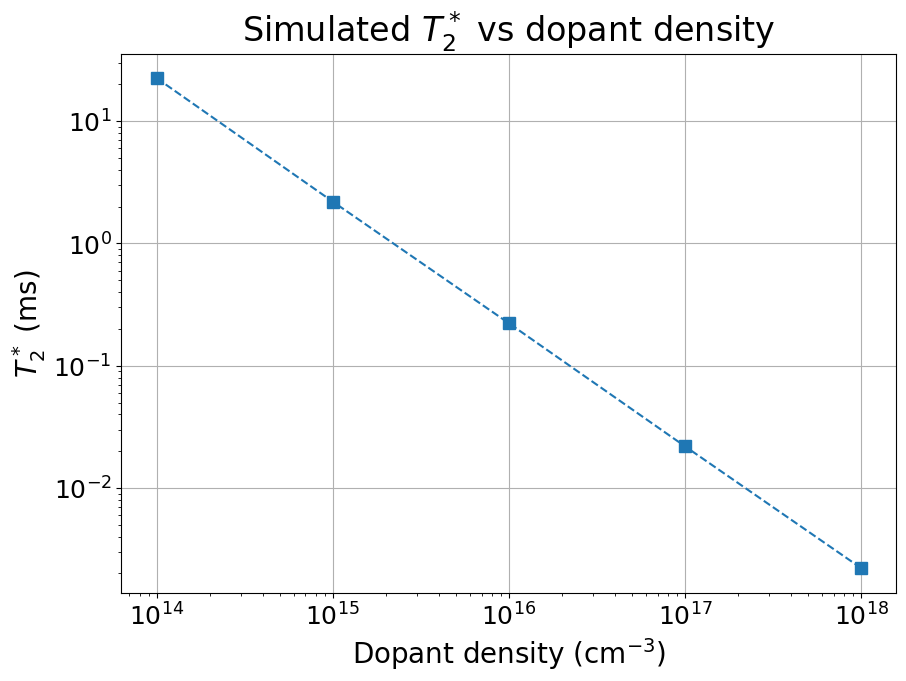
[picture p62: figure]
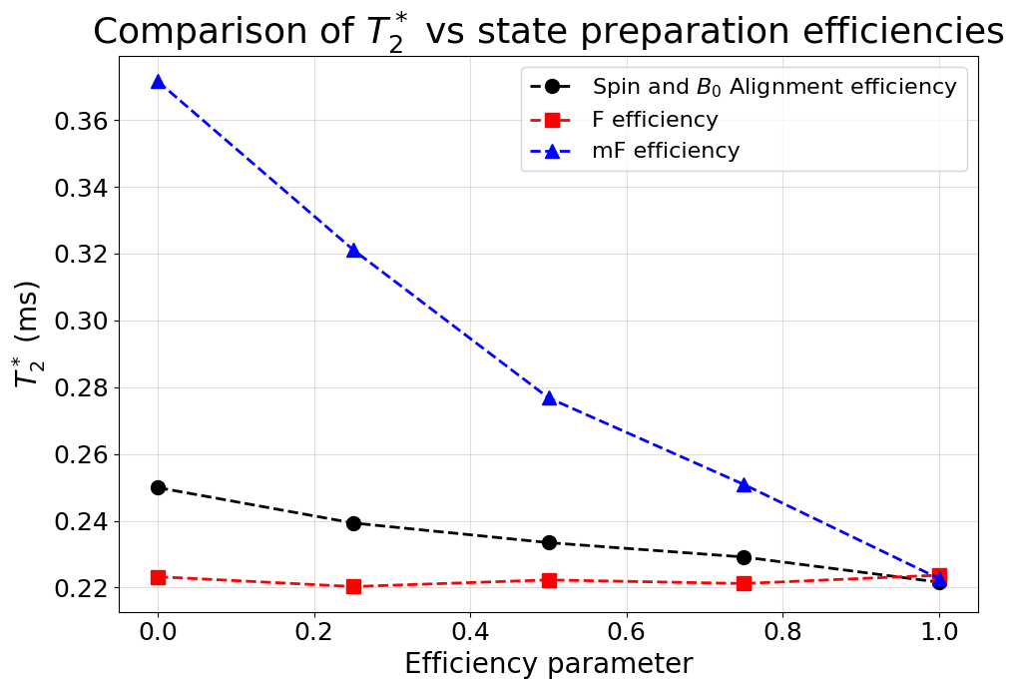
[picture p63: figure]

Spin-Spin Interaction Model

- Most experiments in atomic physics involve probing well defined transitions between spin states.
- This project models atomic transitions between two spin states labeled |F,m_F ⟩ .
- One drives this transition with a resonant frequency ν_0 .

- Ideally: all atoms in matrix have same energy splitting hν_0 . This would result in zero inhomogeneous broadening.
- However, neighboring spins can interact and shift each other’s energy. This interaction is largely through magnetic interactions.
- Model spins as dipole magnets (like a bar magnet)

Magnetic field at r relative to magnetic dipole:

Dipole “magnetic moment”:

Hyperfine Landé g-factor:

g_F ≈g_J (F(F+1)−I(I+1)+J(J+1))/(2F(F+1)) , g_J ≈2.0023

For the sake of this project, I,J,F, and m_F can all be thought of as input parameters defined by the atom and transition we are modeling.
Look at [4] if you want a physical understanding.

- Spin states experience “Zeeman shifts” in magnetic fields

Δν=(ΔE_(|F_2 ,m_(F,2) ⟩) −ΔE_(|F_1 ,m_(F,1) ⟩))/h=γ_(eff) B_z , γ_(eff) =(μ_B)/h(g_(F_2) m_(F,2) −g_(F_1) m_(F,1) )

Energy

|F_2 ,m_(F,2) ⟩

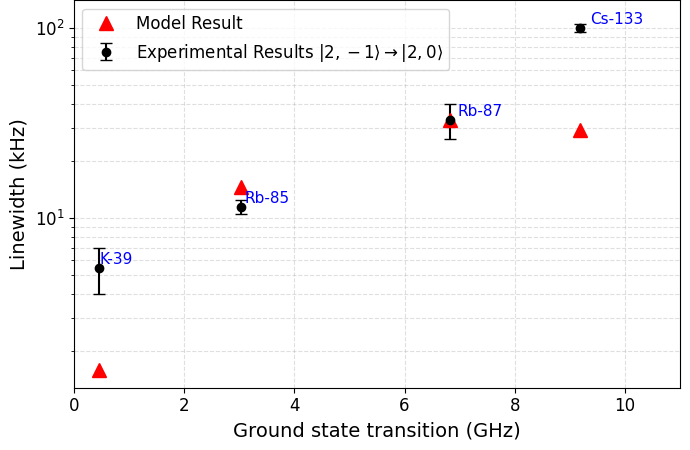
[picture p64: figure]
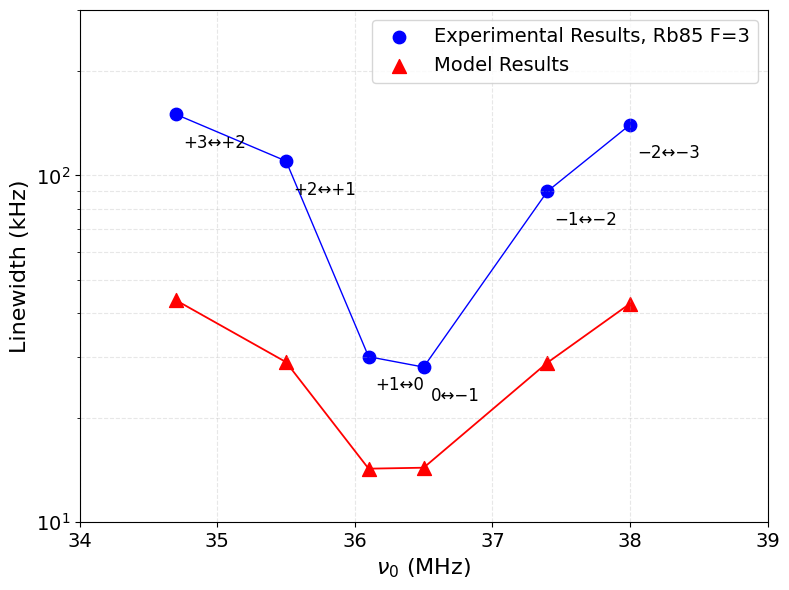
[picture p65: figure]

From [3] ρ=3×10^16 cm^(−3) :
Sodium-23 ( I=3/2 , J=1/2 ), transition: |1,1⟩→|2,2 ⟩
- Experimental Result: 989 kHz
- Model Result: 2.29 kHz

|F_1 ,m_(F,1) ⟩

hν_0

B(r,m)=(μ_0)/(4πr^3)[3r⋅(m⋅r)−m]

m= g_F m_F μ_B m

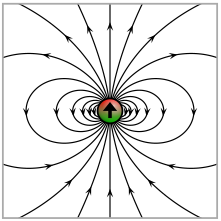
[picture p66: figure]

Modified from [5]

m

N

S

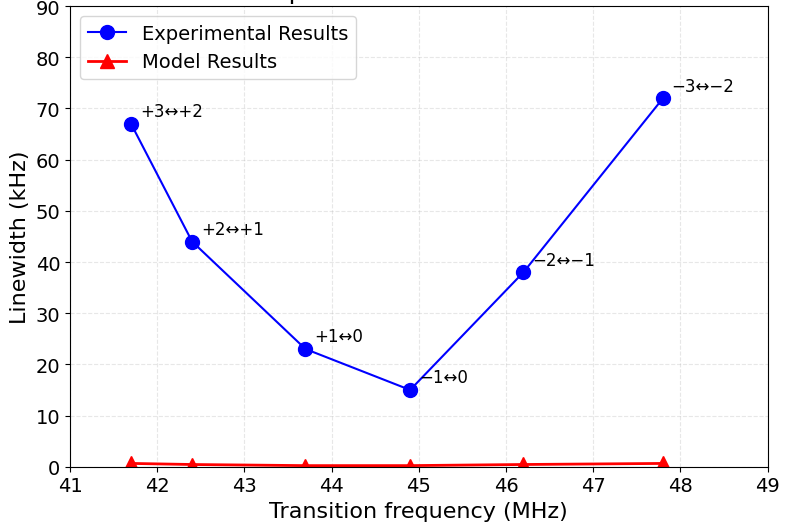
[picture p67: figure]

Conclusion

My inhomogeneous broadening simulation implies that while there is a regime where spin-spin interactions between atoms ( ρ≳10^18 atoms/cm^3 , for Rb) becomes a dominant factor for inhomogeneous broadening, at lower densities ( ρ~10^16 atoms/cm^3 ) it’s subdominant. Most labs tend to grow around ρ~10^16 atoms/cm^3 , so in this regime my model does not accurately predict inhomogeneous broadening. It is possible, however, that it provides a lower limit on broadening, that if achieved, would provide more sensitive measurements. One improvement, is that some matrices, like Ne, can have spins that interact with our atoms. Adding this would be important as both low dopant density results were in crystals that may have small spin-spin interactions.

Zeeman Shift: ΔE_(|F,m_F ⟩) =μ_B g_F m_F B_z

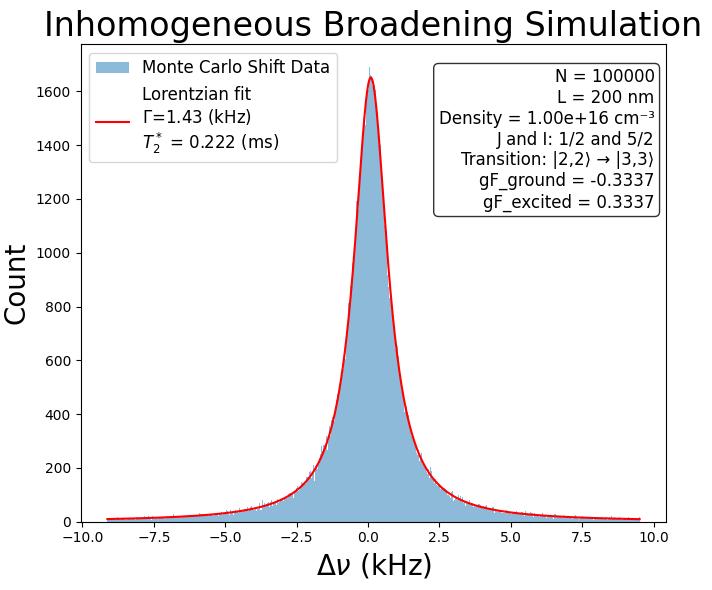
[picture p68: figure]

Fit with Lorentzian to extract inhomogeneous broadening linewidth Γ :

L(Δν)=A (Γ/2)/((Δν)^2 +(Γ/2)^2)

Coherence time:

Energy

|F_2 ,m_(F,2) ⟩

|F_1 ,m_(F,1) ⟩

ΔE_(|F_2 ,m_(F,2) ⟩)

h(ν_0 +Δν)

T_2^(∗) ≡1/(πΓ)

References & Acknowledgements

[1] S. Upadhyay, U. Dargyte, V. D. Dergachev, R. P. Prater, S. A. Varganov, T. V. Tscherbul, D. Patterson, and J. D. Weinstein, Spin coherence and optical properties of alkali-metal atoms in solid parahydrogen, Phys. Rev. A 100, 063419 (2019).
[2] U. Dargyte, D. M. Lancaster, and J. D. Weinstein, Optical and spin-coherence properties of rubidium atoms trapped in solid neon, Phys. Rev. A 104, 032611 (2021).
[3] A. N. Kanagin, N. de Zordo, A. Angerer, W. Kersten, N. Lagos, J. Schmiedmayer, and E. S. Redchenko, Impurities in cryogenic solids: a new platform for hybrid quantum systems, arXiv:2508.21651 (2025).
[4] D. A. Steck, Rubidium 85 D Line Data, available online at http://steck.us/alkalidata (revision 2.1.6, 20 September 2013).
[5] I. S. Grant and W. R. Phillips, Electromagnetism, 2nd ed., Manchester Physics Series (John Wiley & Sons, Chichester, 2008).
