cross-isaac/IsaacCross_Senior_Thesis/07_Talks_and_Posters/A Dual-Species Beam Source for Doped Cryogenic Crystal Growth, CFP Pre talk.pptx - Google Slides.pdf

# A Dual-Species Beam Source for Doped Cryogenic Crystal Growth

Isaac K. Cross

04/14/2026 CFP Pre-talk

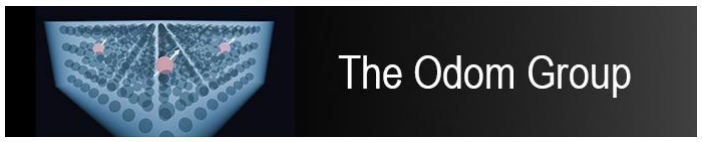
[picture p141: figure]
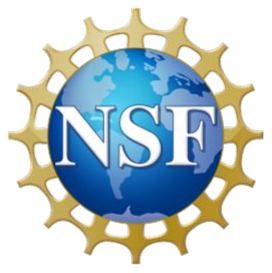
[picture p142: figure]
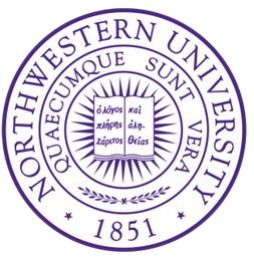
[picture p143: figure]

## Doped Cryogenic Crystal

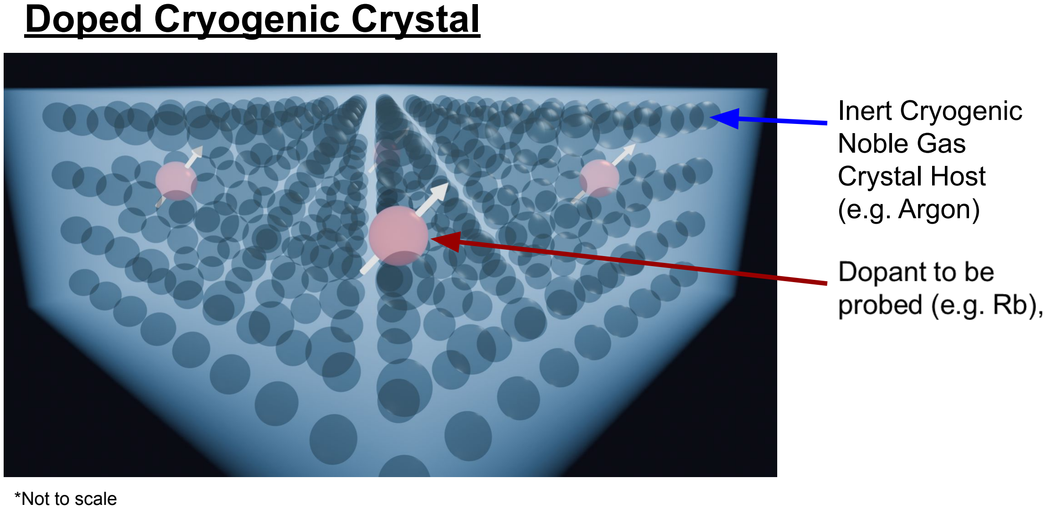
[picture p144: page 2]

Inert Cryogenic
Noble Gas
Crystal Host
(e.g. Argon)

*Not to scale

## Leading EDM Platforms

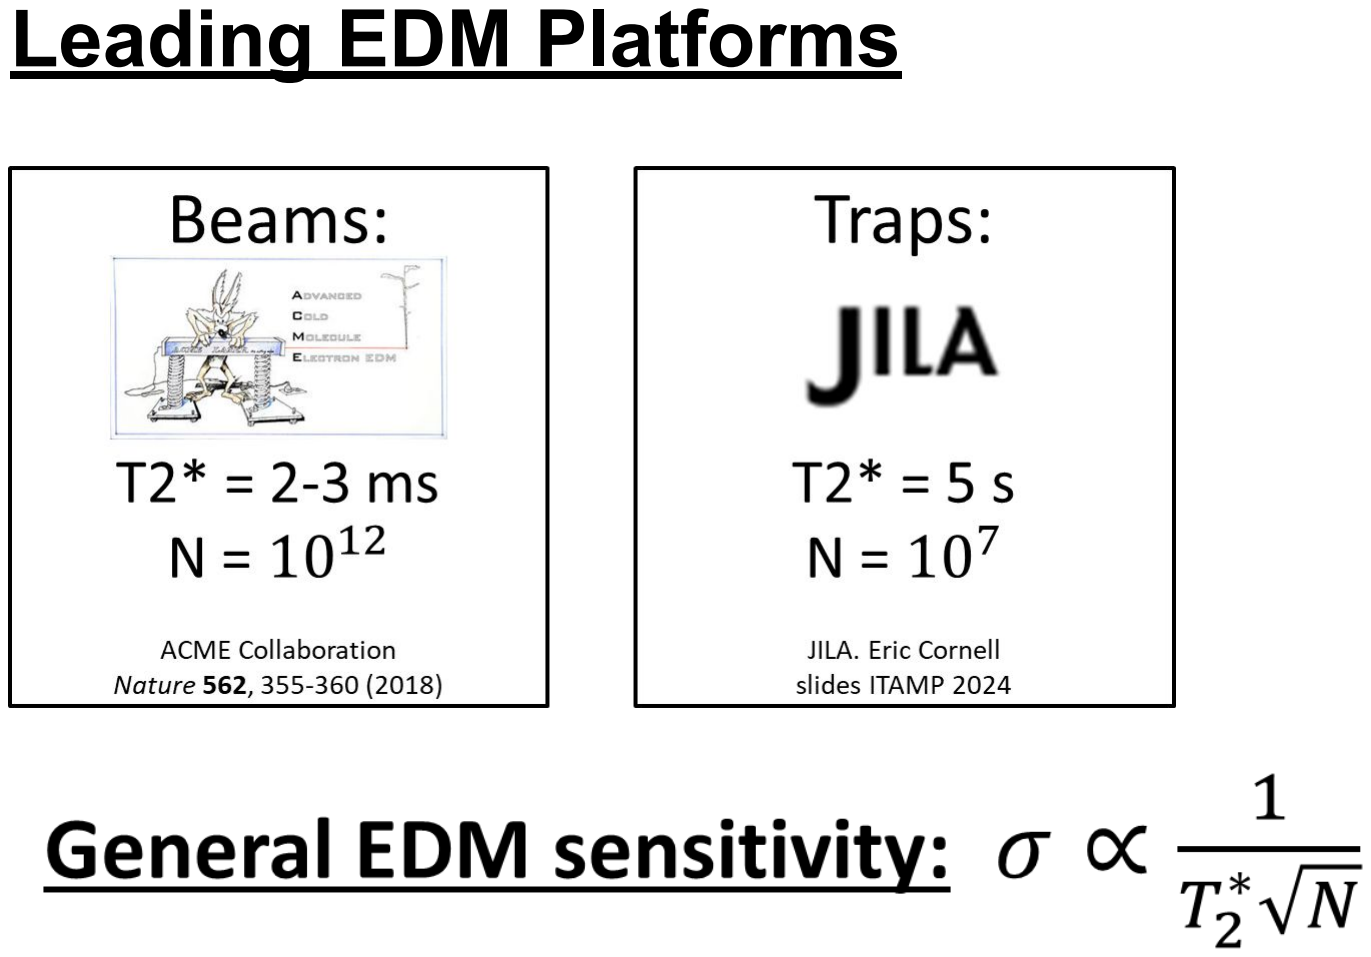
[picture p145: page 3]

## Leading EDM Platforms

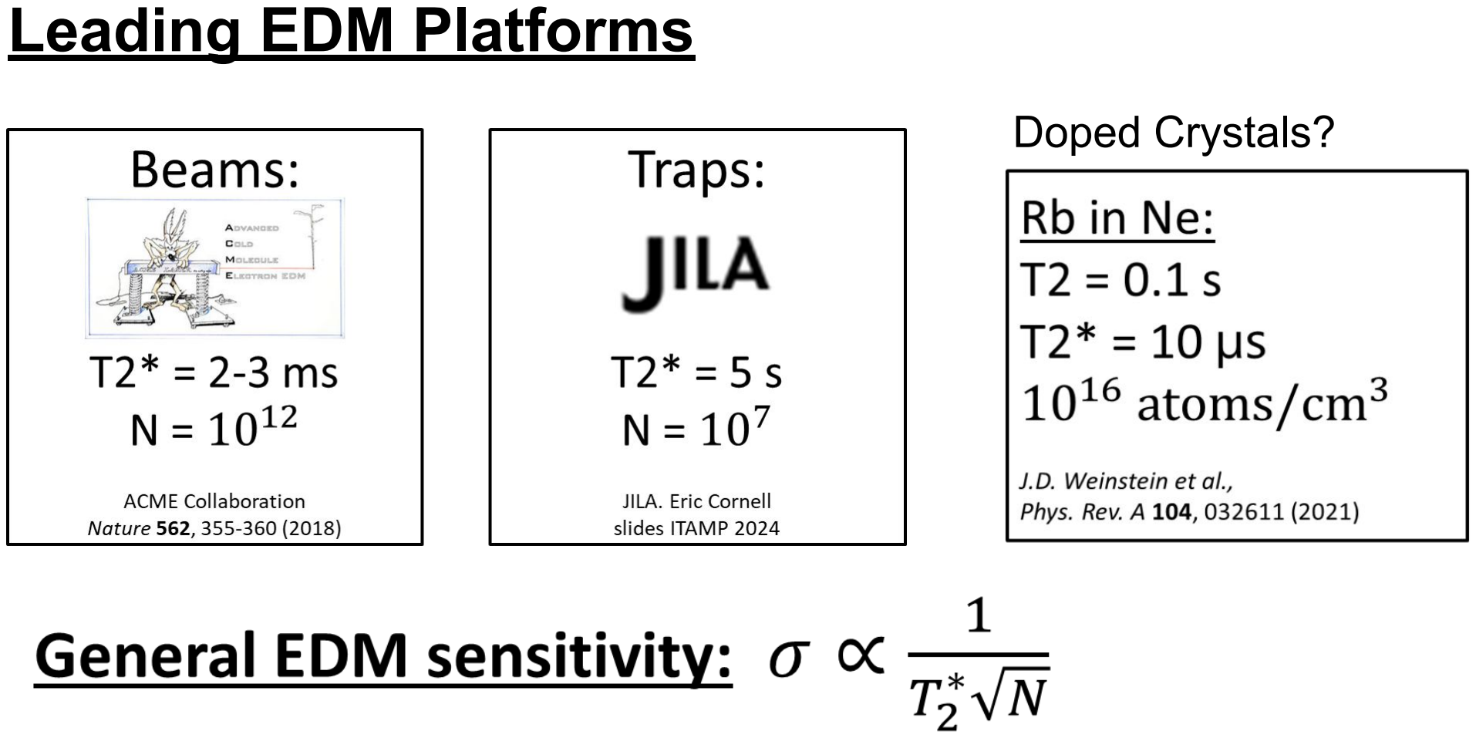
[picture p146: page 4]

Doped Crystals?

## Our Growth Method

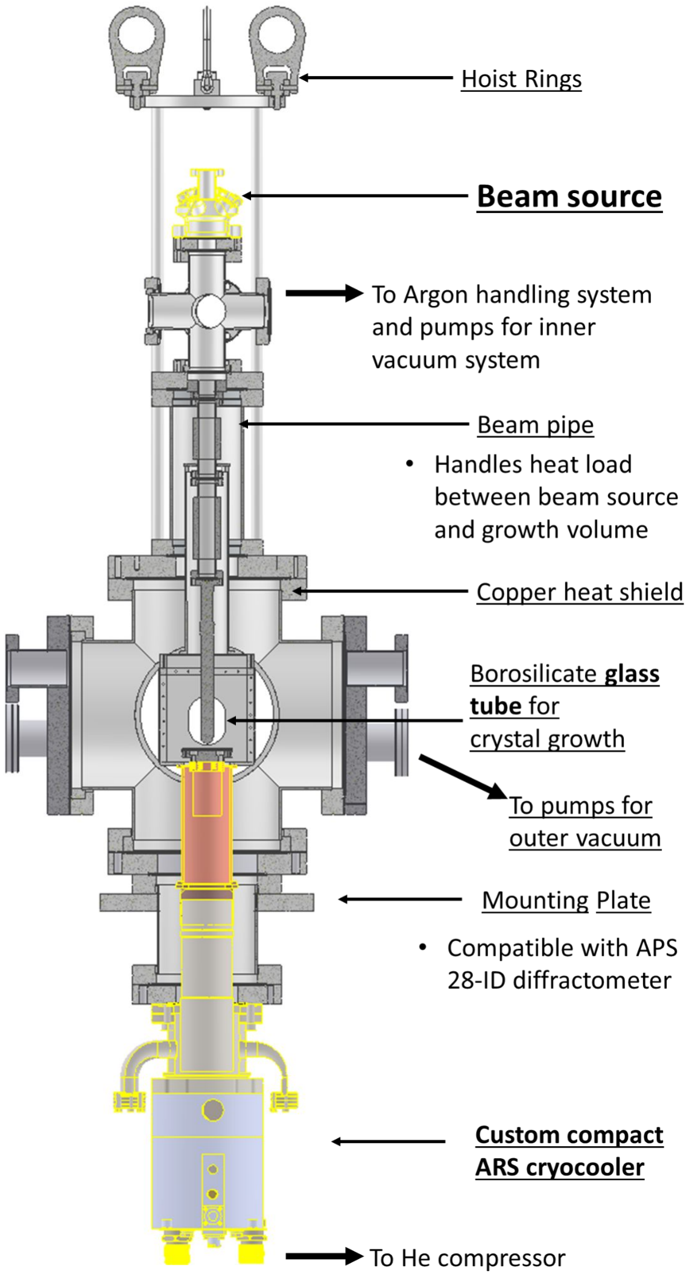
[picture p147: figure]
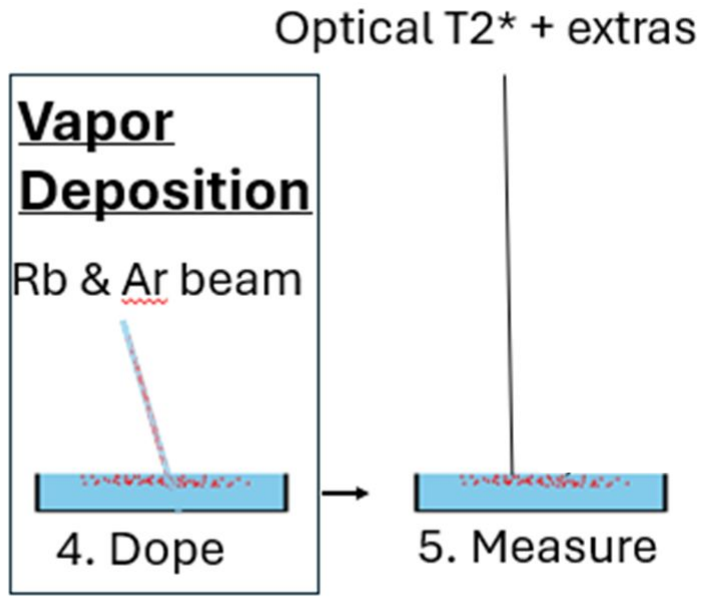
[picture p148: figure]

## Our Growth Method

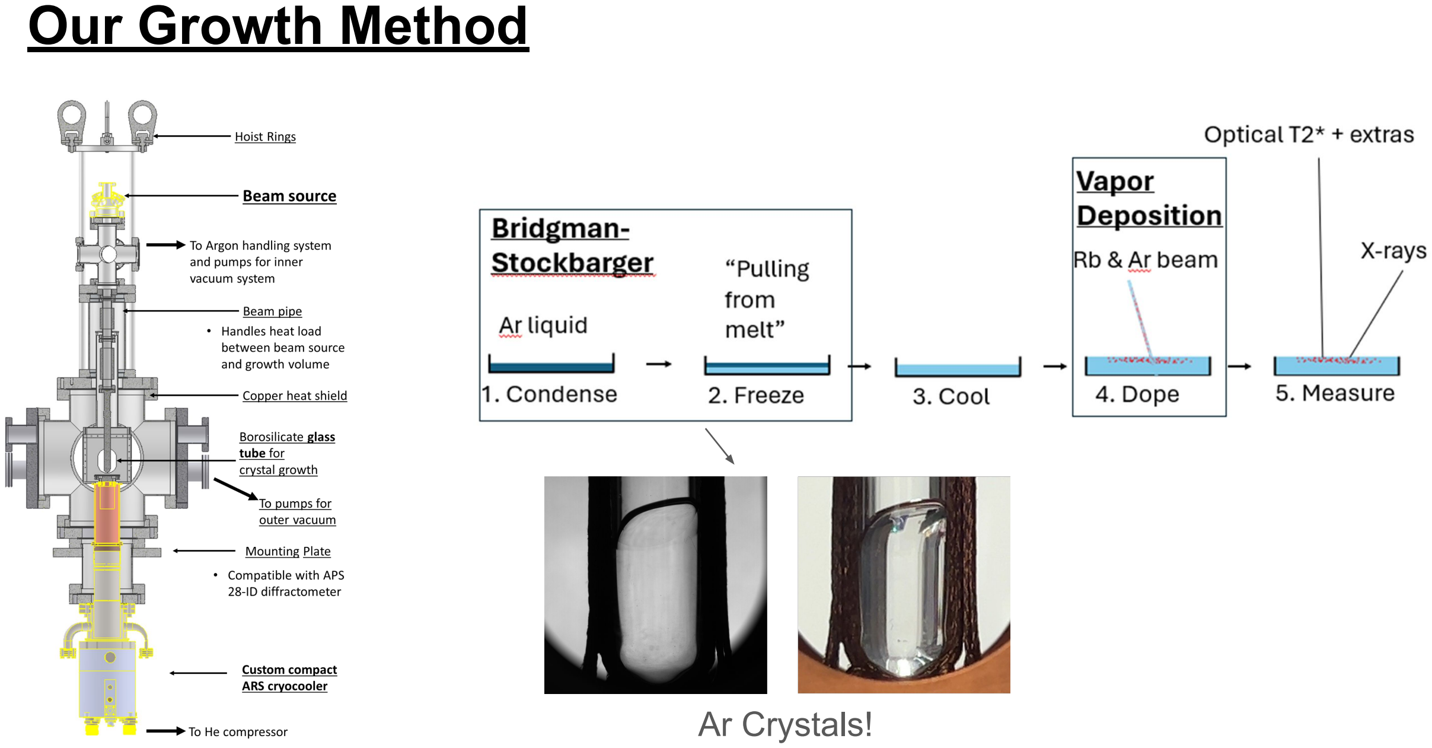
[picture p149: page 6]

Ar Crystals!

## Our Growth Method

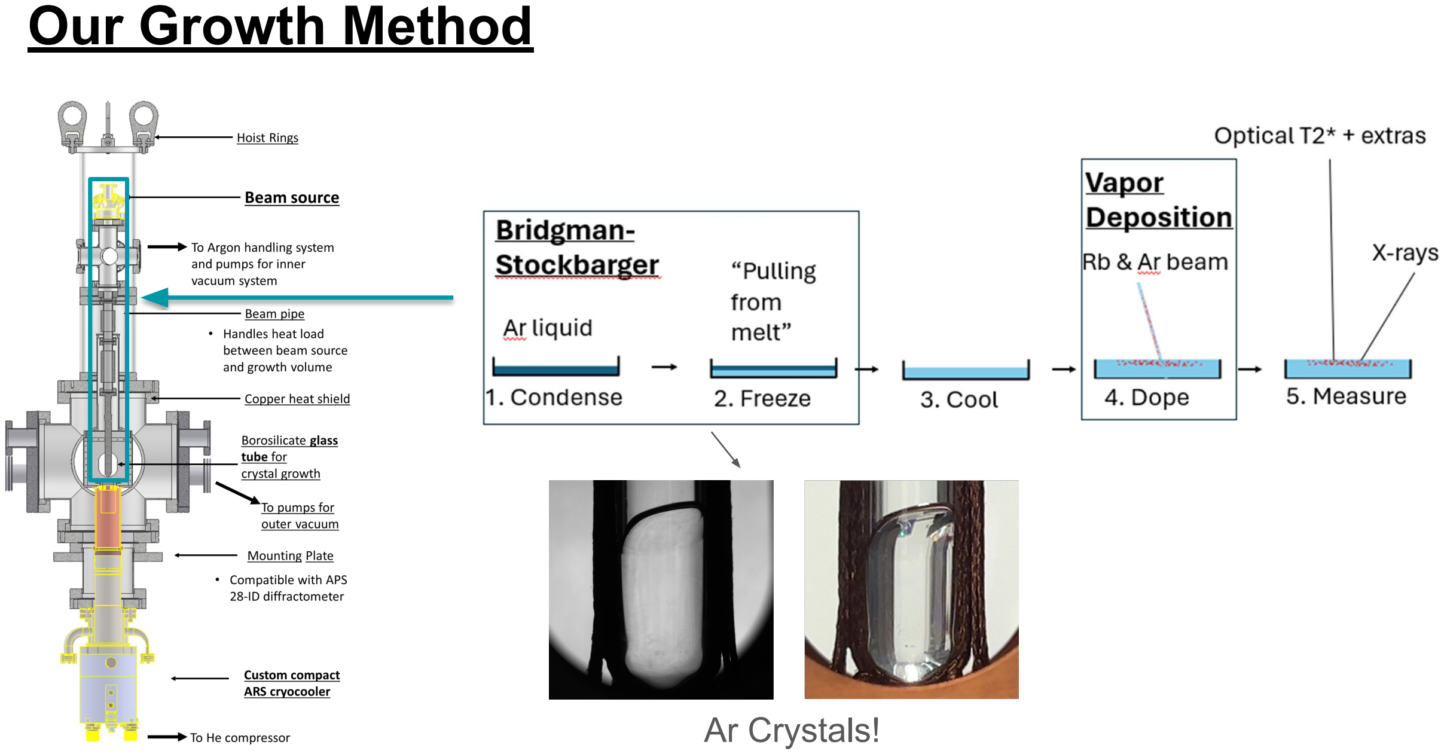
[picture p150: page 7]

Ar Crystals!

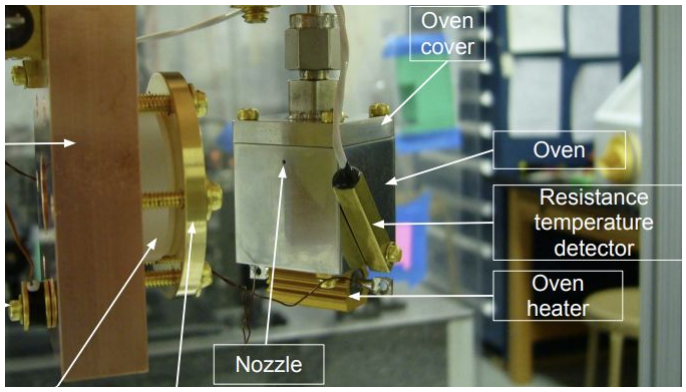
[picture p151: figure]

Regmi, 2013, M.S. thesis, University of Nevada, Reno. Weinstein Group

## Beam Source Constraints

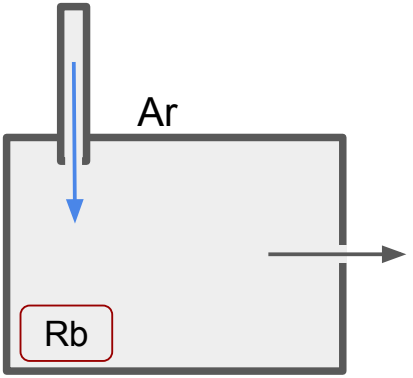
[picture p152: figure]

Regmi, 2013, M.S. thesis, University of Nevada, Reno. Weinstein Group

## Beam Source Constraints

## Beam Source Constraints

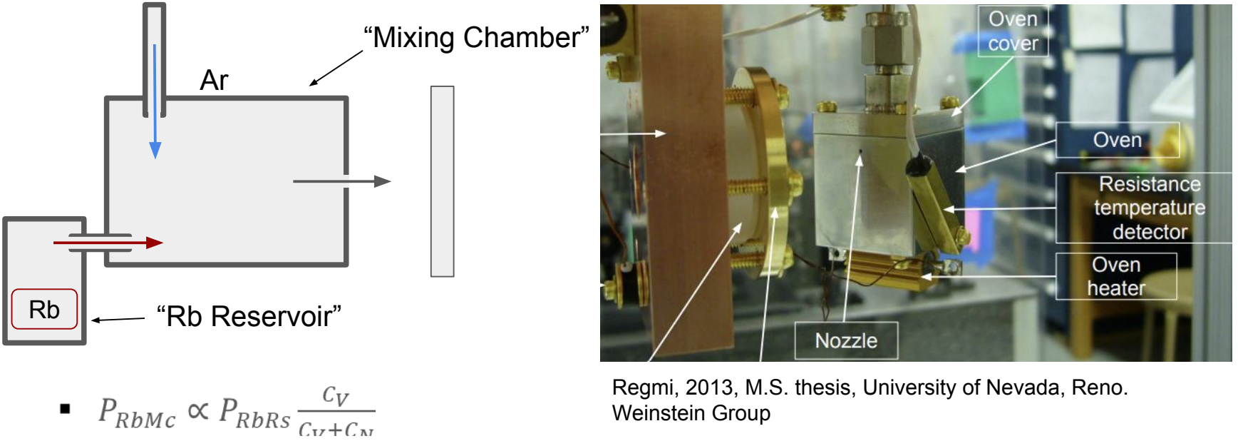
[picture p153: figure]
“Mixing Chamber”; “Rb Reservoir”; Weinstein Group

Regmi, 2013, M.S. thesis, University of Nevada, Reno.

## Beam Source Constraints

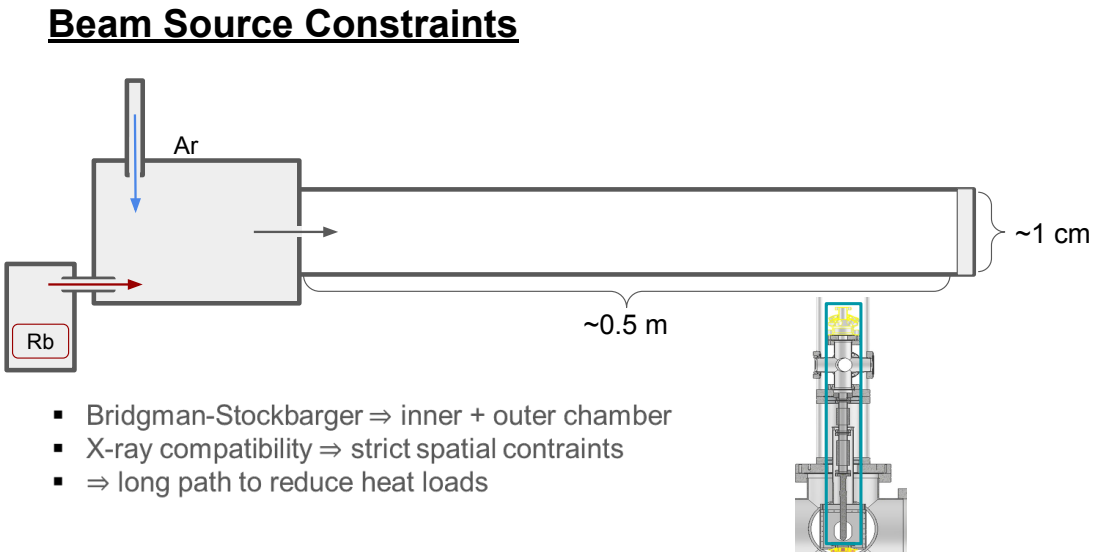
[picture p154: page 11]

## Beam Source Constraints

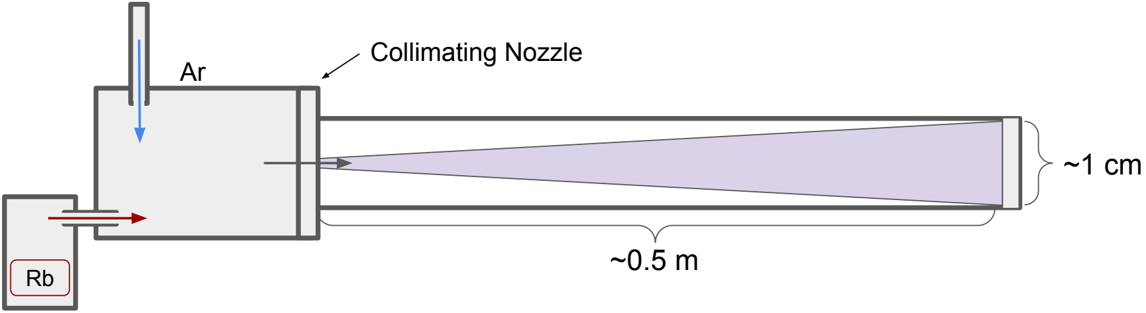
[picture p155: figure]
Collimating Nozzle

- Need large Ar flux
- Narrow divergence

## Microcapillary Nozzle Array

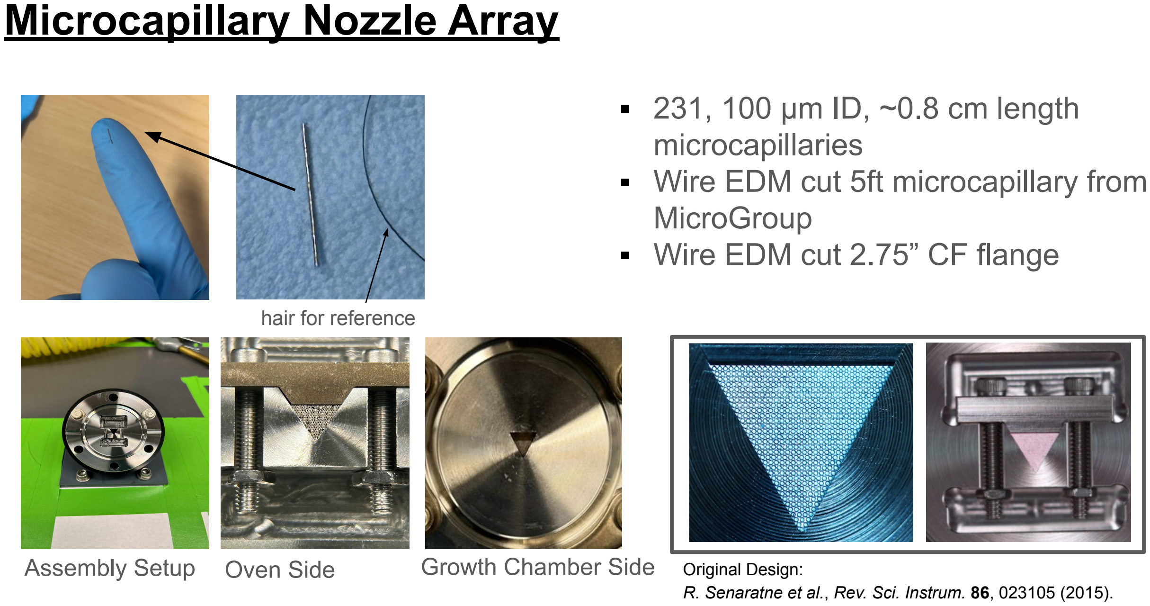
[picture p156: page 13]

Oven Side | Growth Chamber Side
- 231, 100 µm ID, ~0.8 cm length microcapillaries
- Wire EDM cut 5ft microcapillary from MicroGroup
- Wire EDM cut 2.75” CF flange

Assembly Setup

hair for reference

Original Design:
R. Senaratne et al., Rev. Sci. Instrum. 86, 023105 (2015).

## Characterizing Beam Source

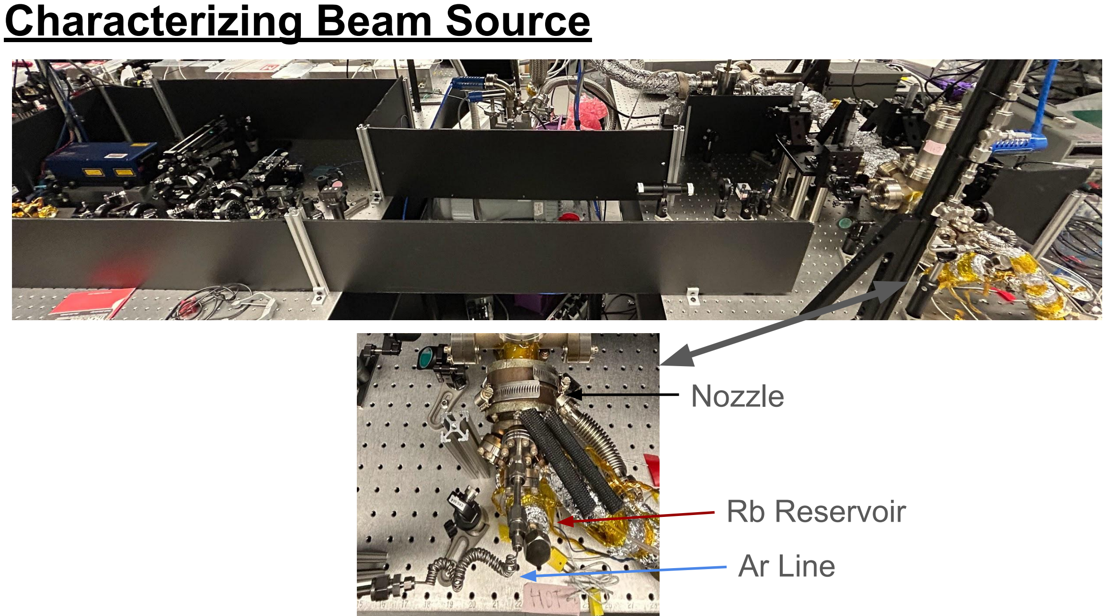
[picture p157: page 14]

Nozzle

Rb Reservoir

Ar Line

## Characterizing Beam Source

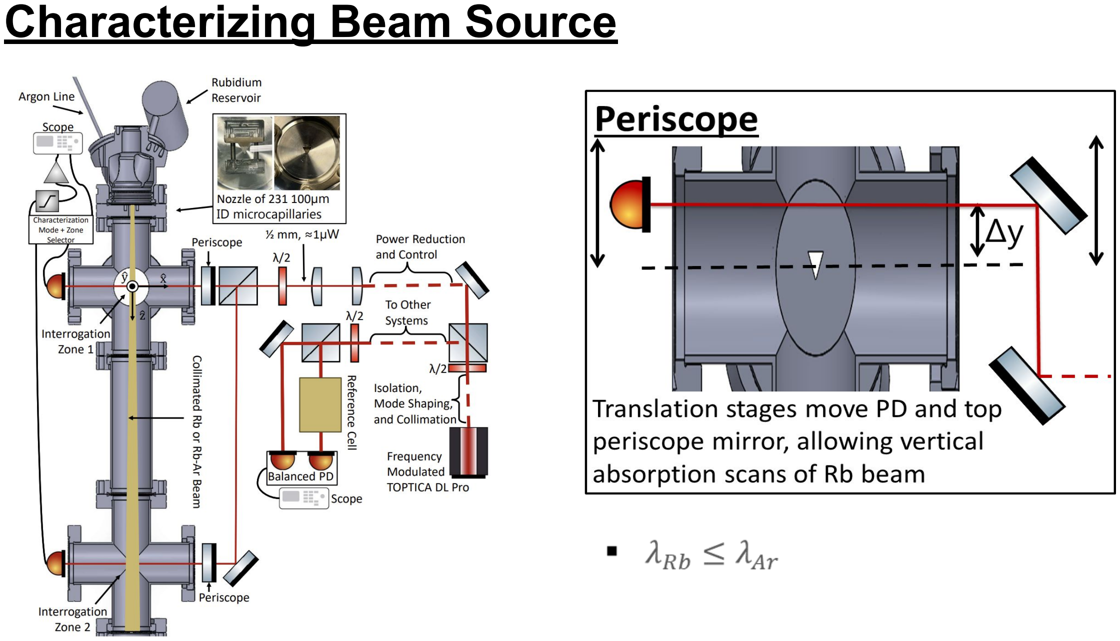
[picture p158: page 15]

## Characterizing Beam Source

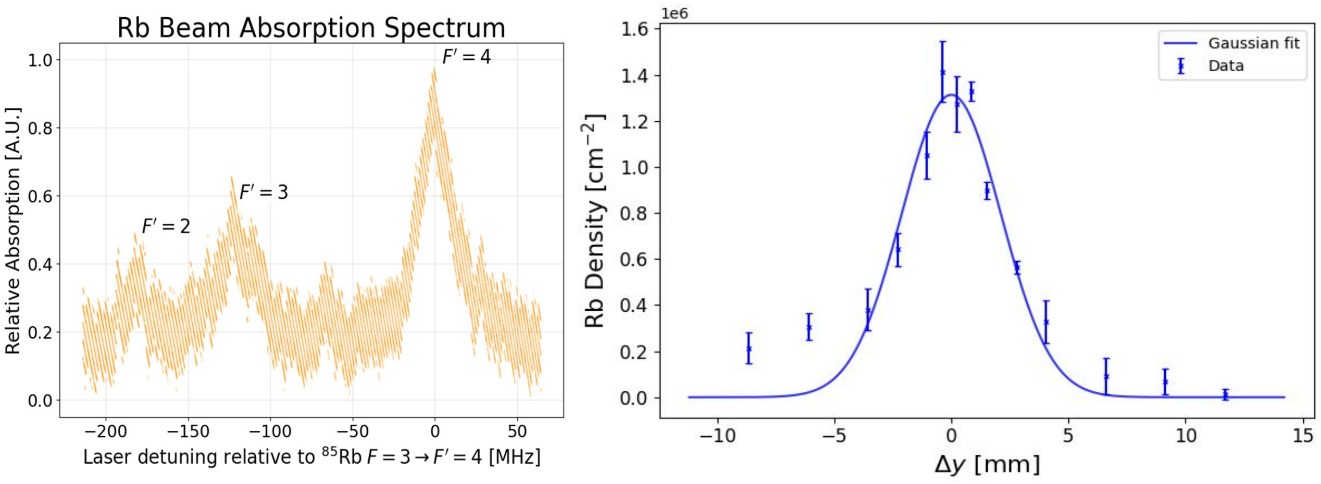
[picture p159: figure]

## Characterizing Beam Source

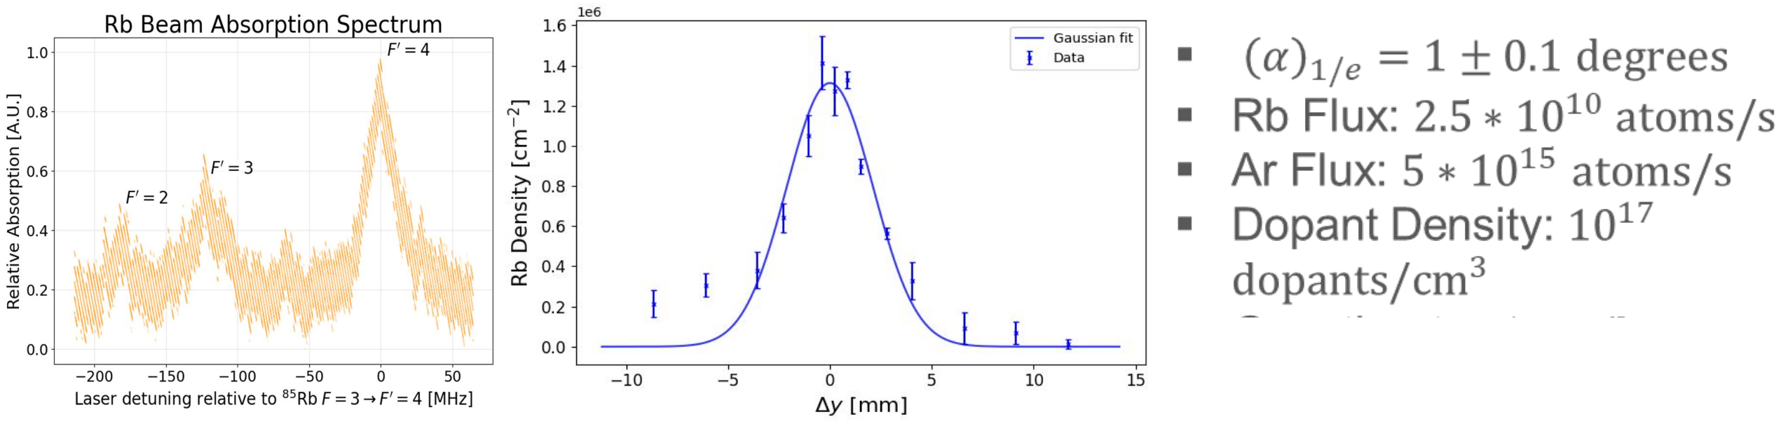
[picture p160: figure]

## Characterizing Beam Source

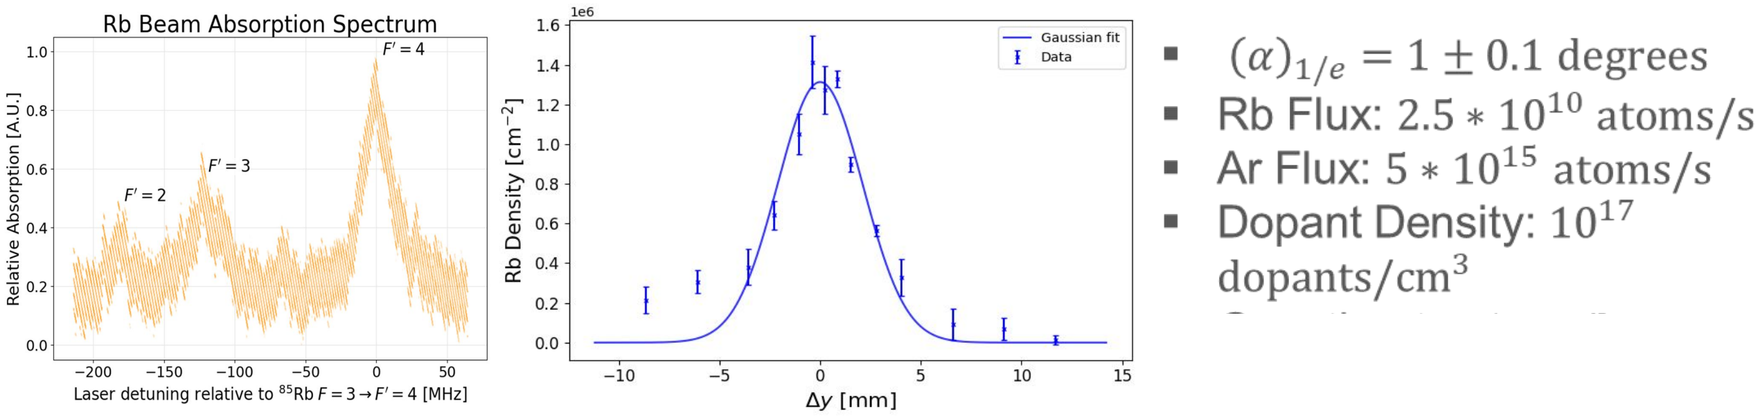
[picture p161: figure]

## Next Steps

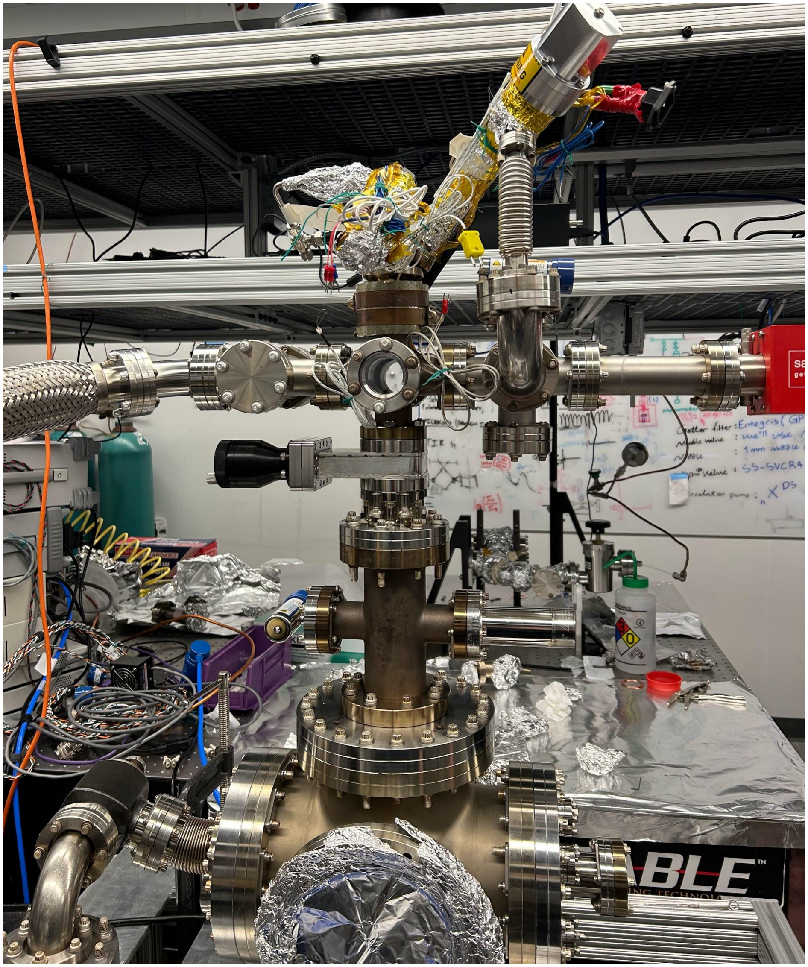
[picture p162: figure]

- Grow Doped Crystals!!
- Measure crystal properties to check beam characterization
- Growth Rate/Dopant Density can be directly measured
- Explore larger parameter space

## Acknowledgements

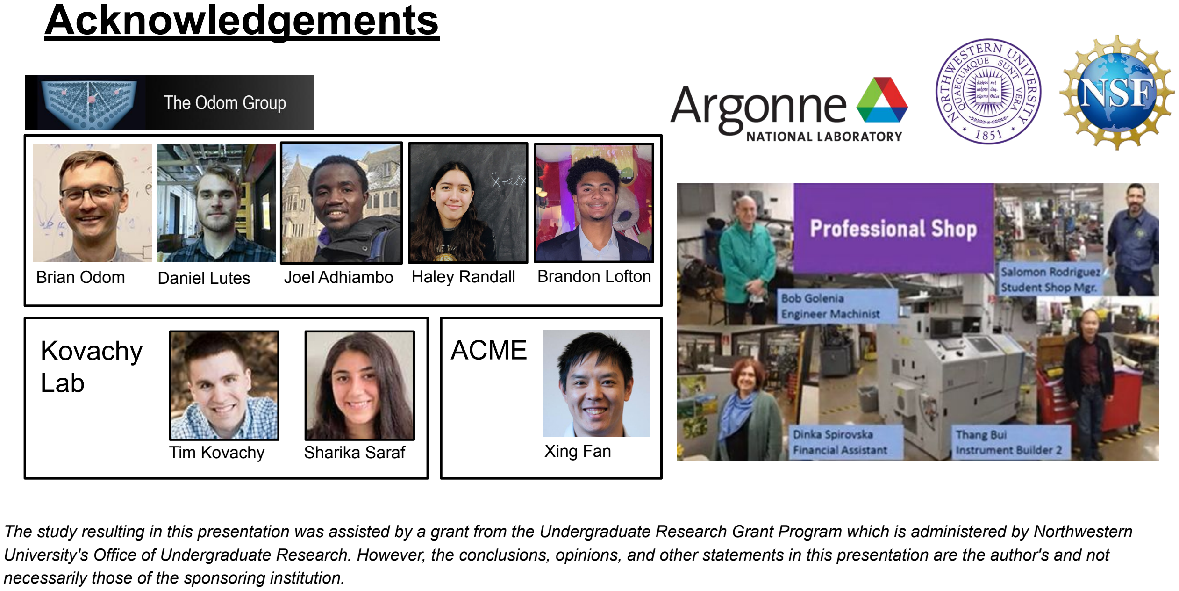
[picture p163: page 20]

The study resulting in this presentation was assisted by a grant from the Undergraduate Research Grant Program which is administered by Northwestern University's Office of Undergraduate Research. However, the conclusions, opinions, and other statements in this presentation are the author's and not necessarily those of the sponsoring institution.

Kovachy
Lab
Brian Odom | Daniel Lutes | Joel Adhiambo | Haley Randall | Brandon Lofton
Tim Kovachy | Sharika Saraf | Xing Fan

ACME

# Supplemental Slides:

## Divergence

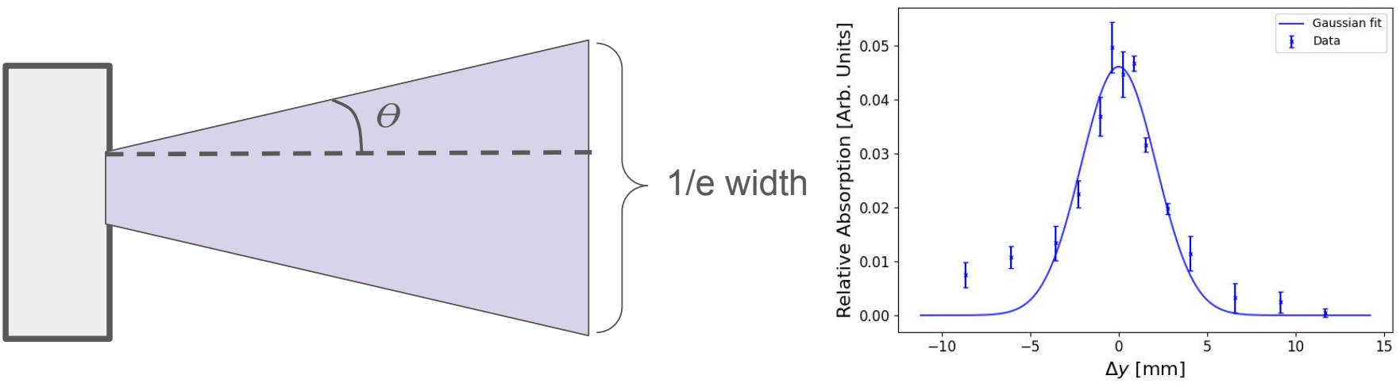
[picture p164: figure]
1/e width
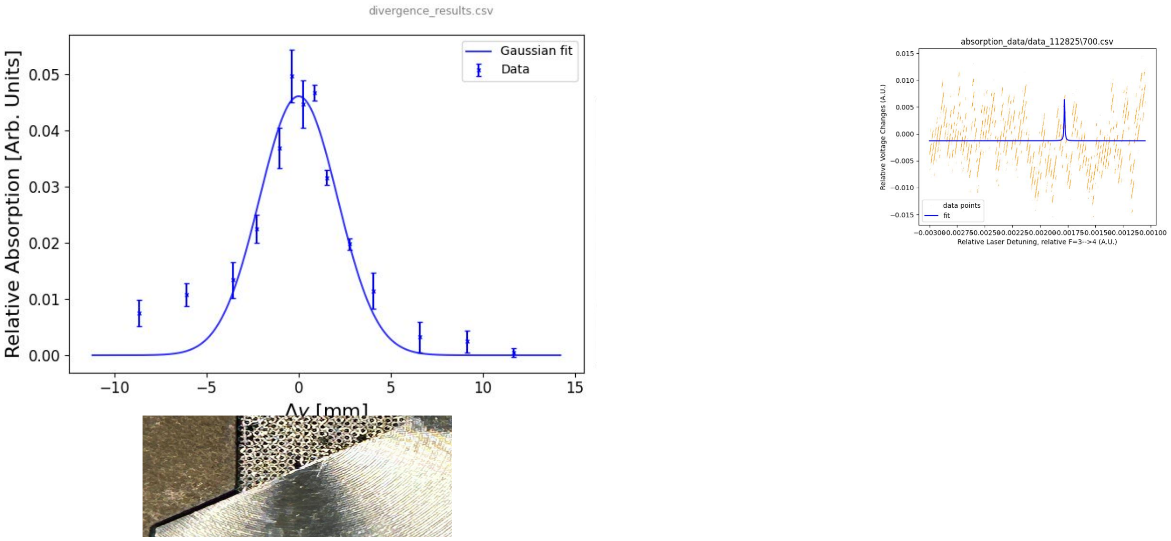
[picture p165: page 23]

## Rb-Ar

Smth about Ar and Rb being same divergence….

- λ = k_B T/(sqrt[2]pi*d^2*P)
- Prb << Par
- λrb/λar ~ d_ar^2/d_rb^2
~½

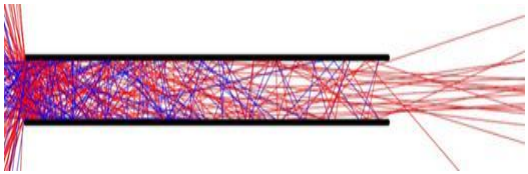
[picture p166: figure]

- Want λ ~> L > d to get
aspect ratio like divergence.
- -> λrb will exit ideal regime of divergence set by aspect ratio before λar does

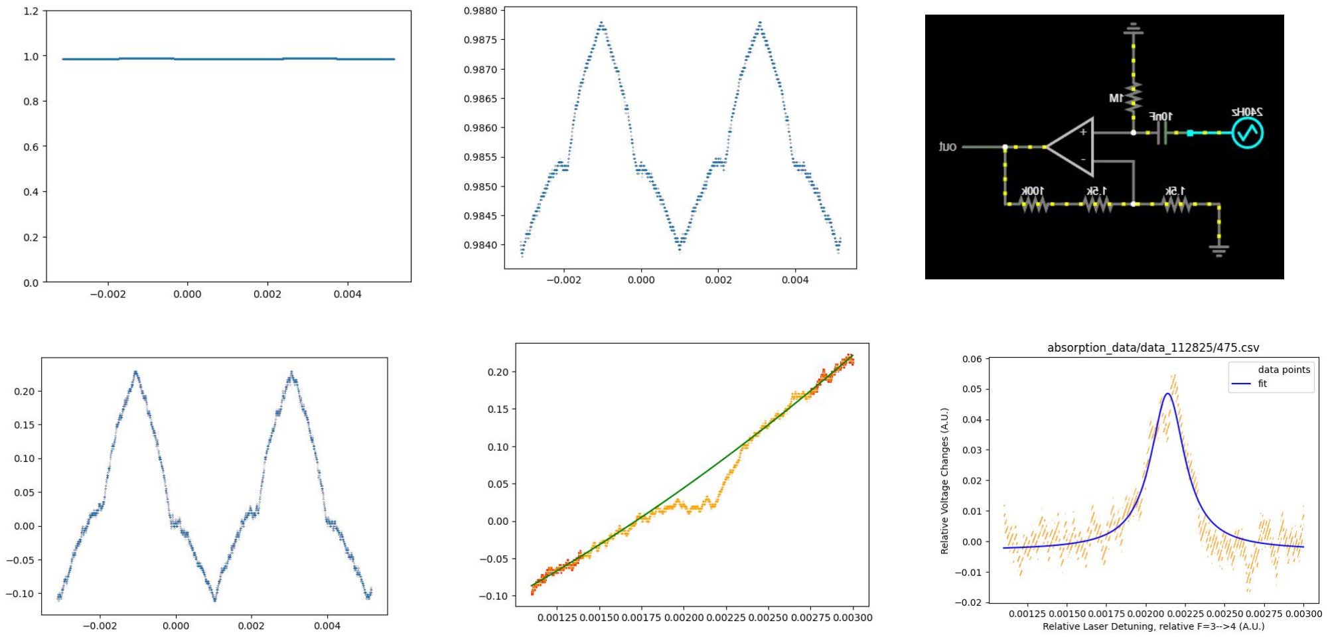
[picture p167: page 25]
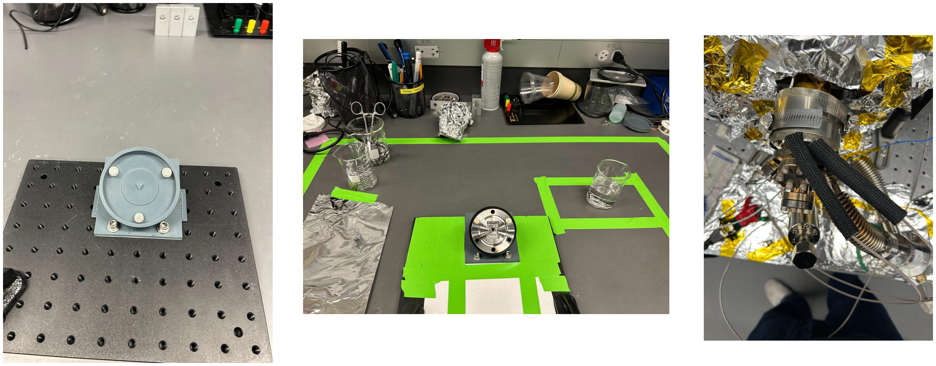
[picture p168: page 26]

## Current Doped Cryogenic Crystals

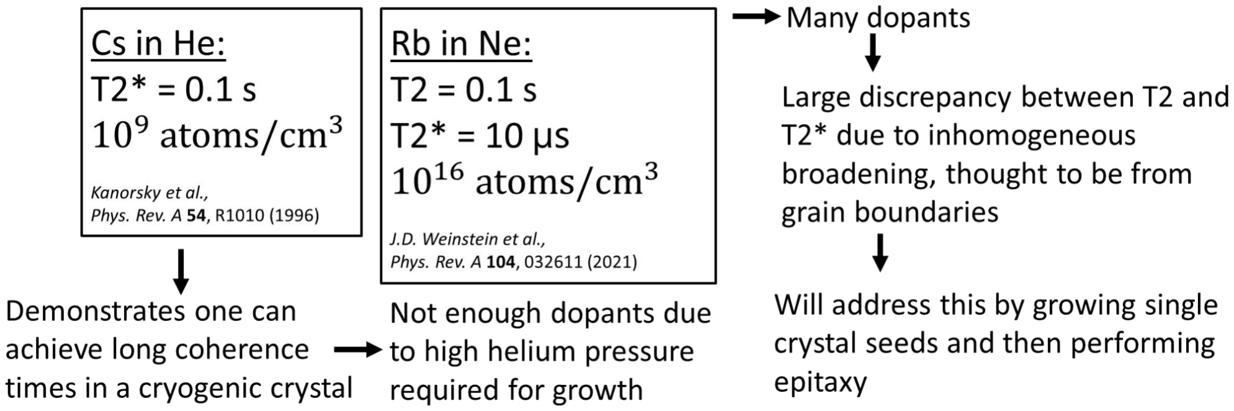
[picture p169: figure]
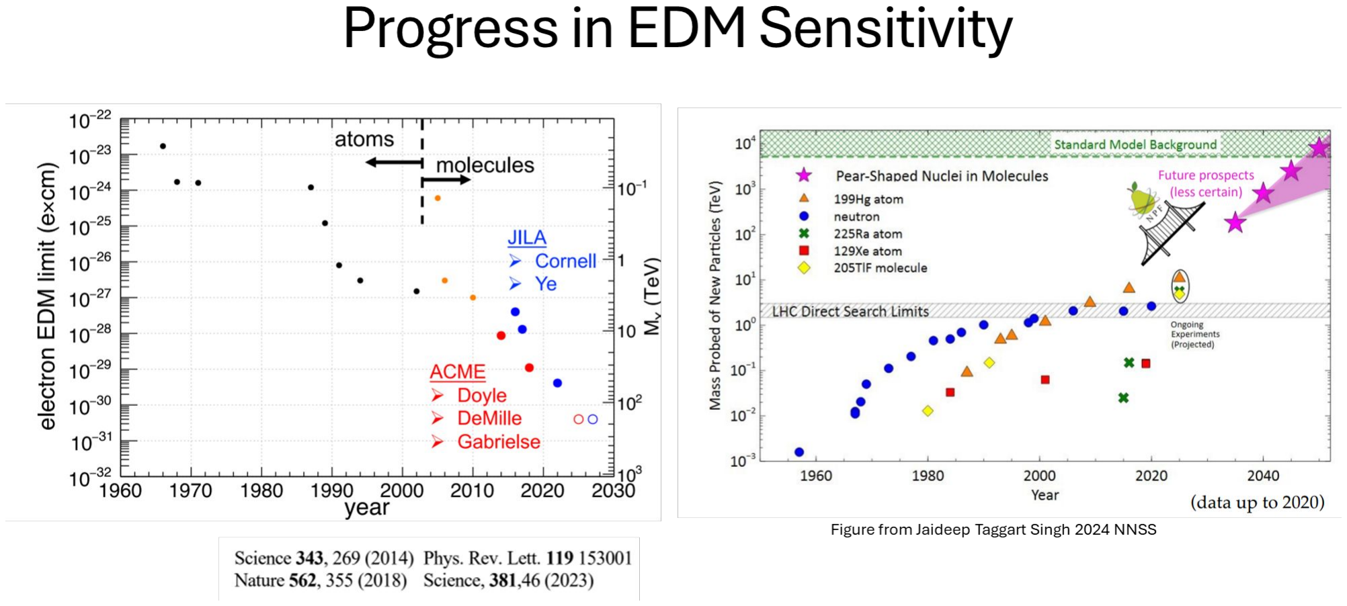
[picture p170: page 28]
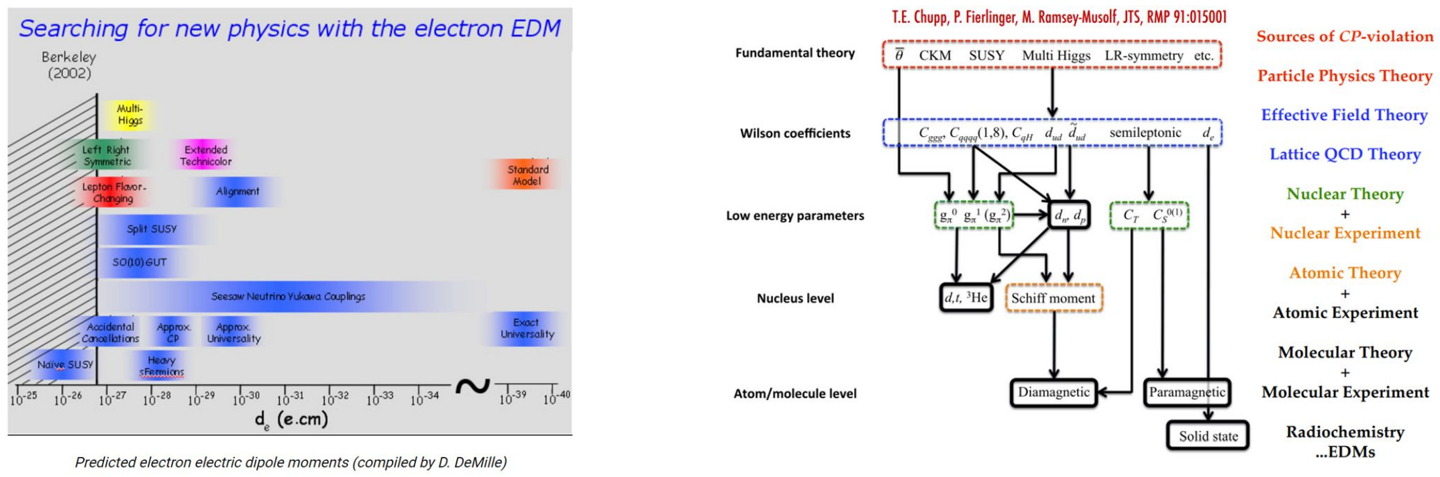
[picture p171: page 29]
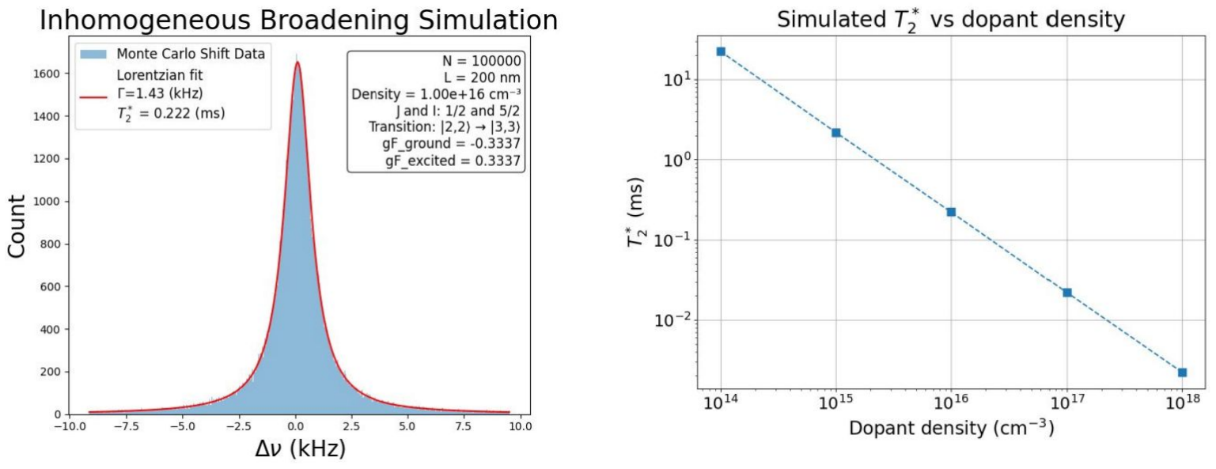
[picture p172: page 30]
