cross-isaac/IsaacCross_Senior_Thesis/08_Proposals_and_Applications/Reports/Apparatus_Diagram_and_Images.pdf

APPARATUS DIAGRAM AND IMAGES

Simplified diagram of dual-species beam characterization chamber and spectroscopy set up:

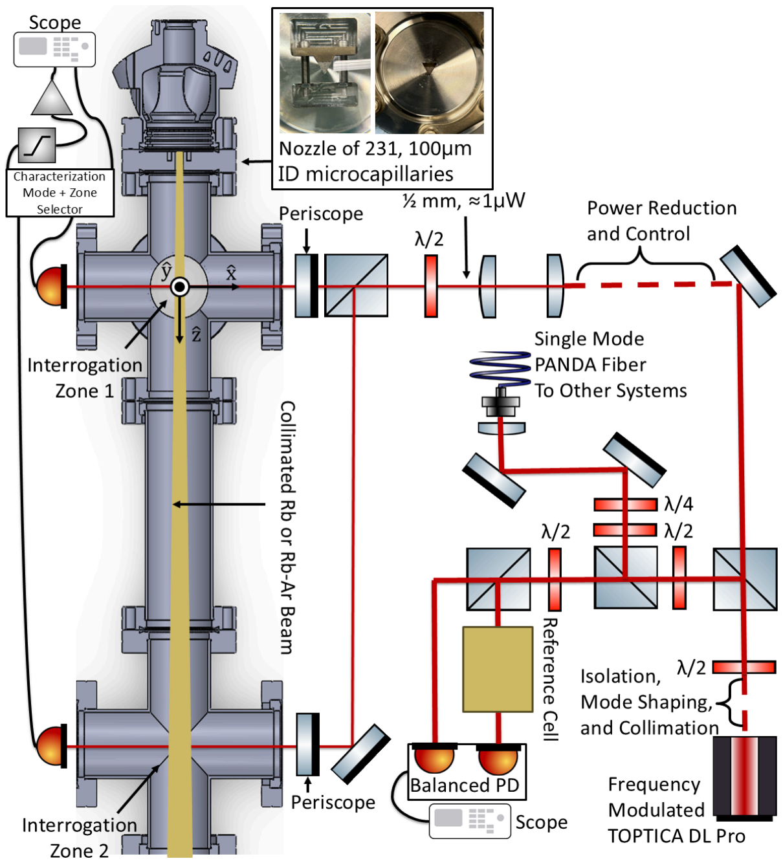
[picture p173: figure]

Rubidium spectroscopy setup for dual-species beam characterization:

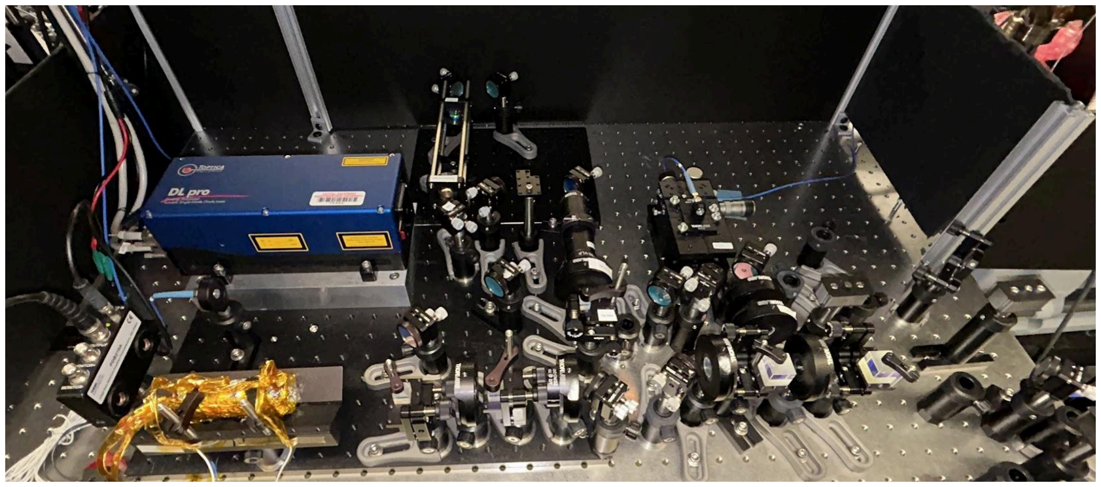
[picture p174: figure]

Dual-species characterization UHV chamber and beam source:

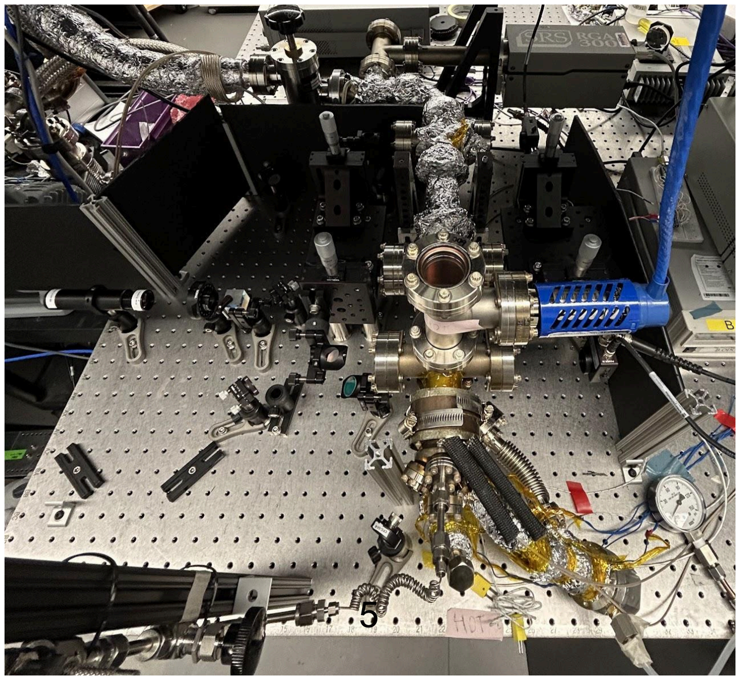
[picture p175: figure]
