cross-isaac/IsaacCross_Senior_Thesis/02_Beam_Source_Design/CAD/Crystal_Growth_Chamber/Local Aparatus Drawings/LA Split Labeled Drawing.pdf

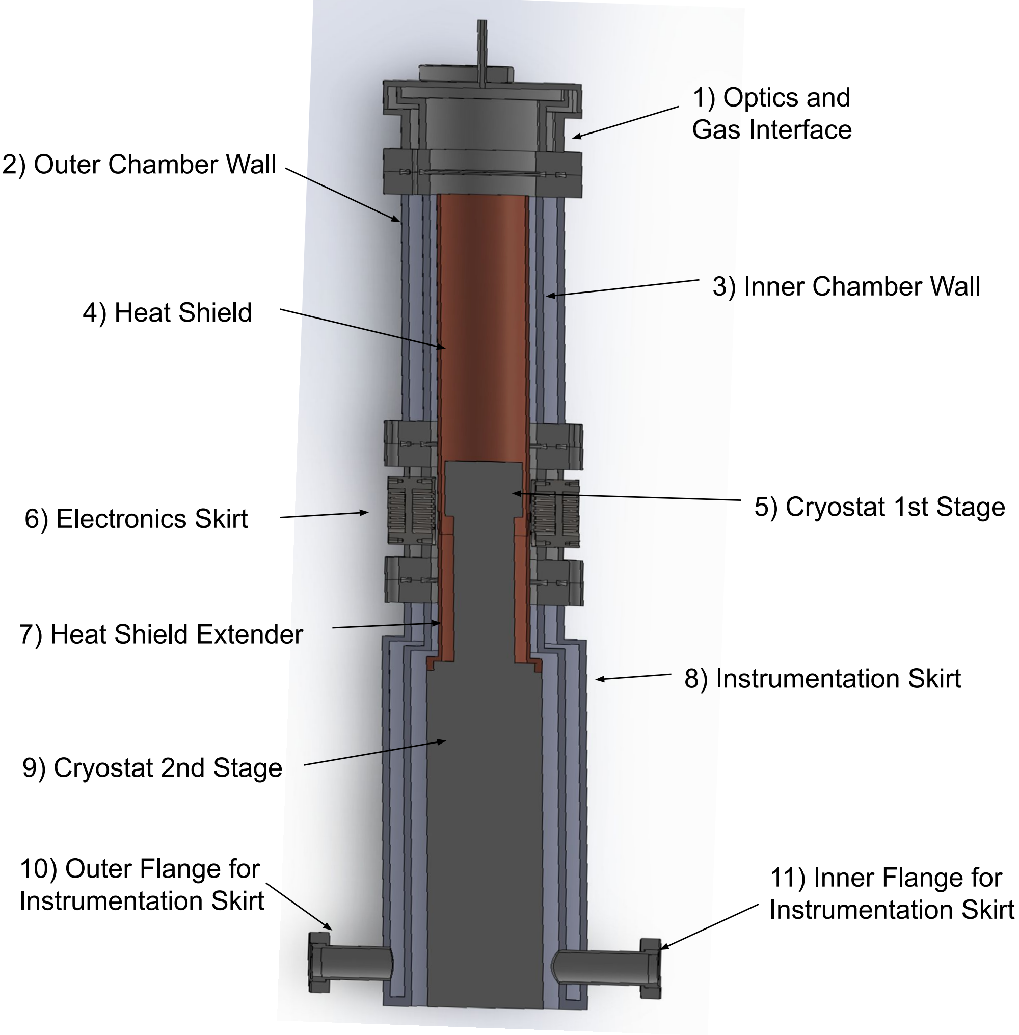
[picture p176: page 1]

1) Optics and
Gas Interface
2) Outer Chamber Wall
3) Inner Chamber Wall
4) Heat Shield
7) Heat Shield Extender
8) Instrumentation Skirt
9) Cryostat 2nd Stage
5) Cryostat 1st Stage 6) Electronics Skirt
11) Inner Flange for
Instrumentation Skirt
10) Outer Flange for
Instrumentation Skirt
