cross-isaac/IsaacCross_Senior_Thesis/02_Beam_Source_Design/CAD/Crystal_Growth_Chamber/CHEX Aparatus 2/CHEX Appartus 2 Drawings/Untitled drawing.pdf

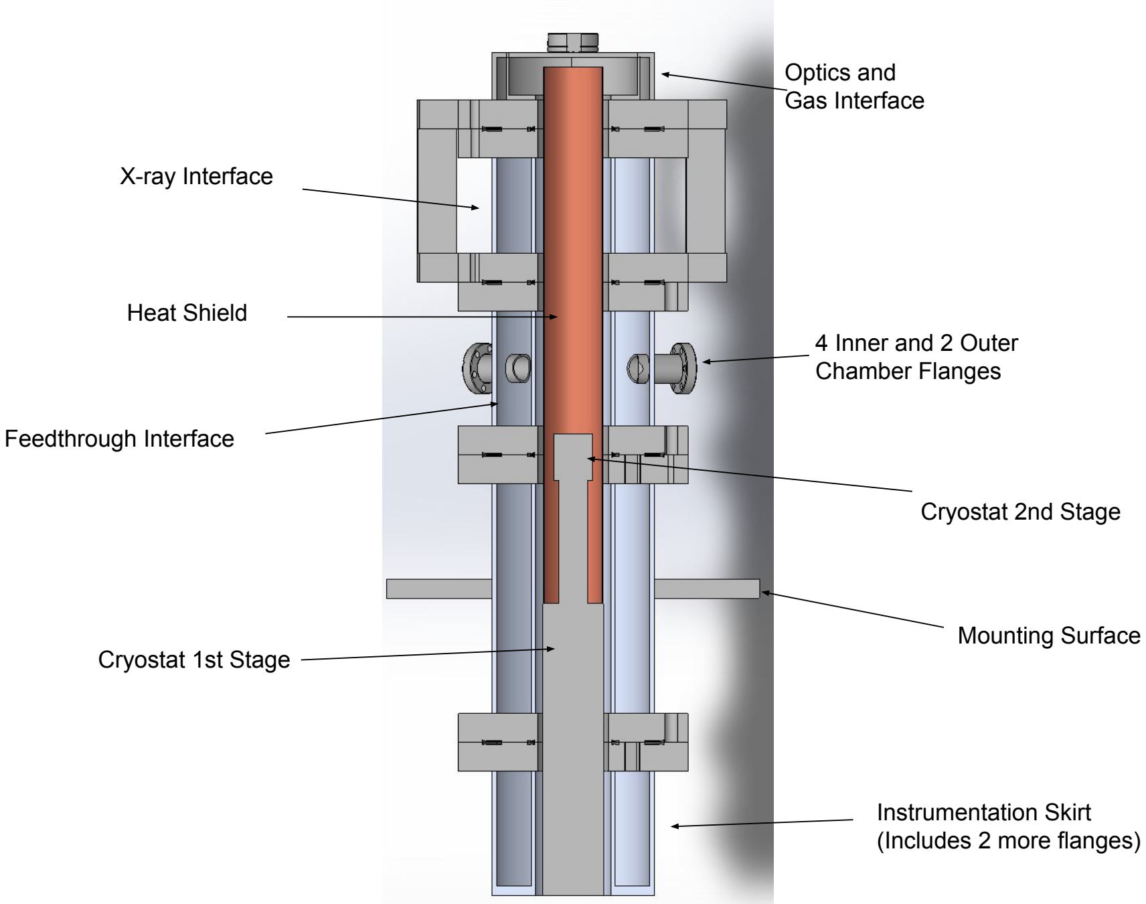
[picture p177: figure]
Optics and Gas Interface; Heat Shield; 4 Inner and 2 Outer Chamber Flanges; Instrumentation Skirt (Includes 2 more flanges); Cryostat 2nd Stage; Cryostat 1st Stage; X-ray Interface; Feedthrough Interface; Mounting Surface
