cross-isaac/IsaacCross_Senior_Thesis/09_Kovachy_Lab/Heating Data d4a6d0c4d1d640b1ab00f0d08784f62e.pdf

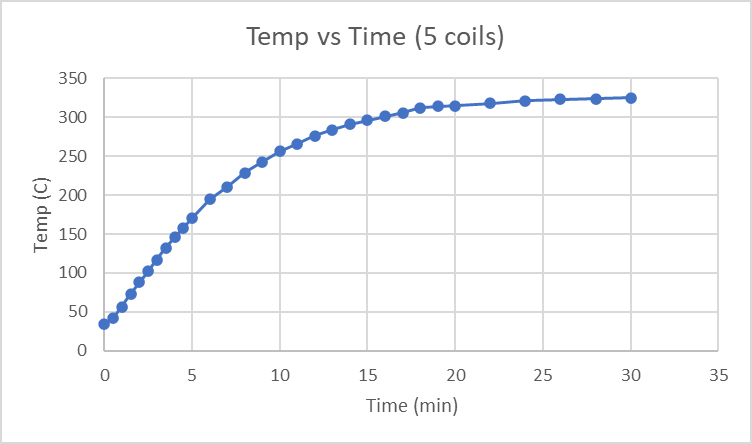
[picture p178: figure]

Heating Data | 1

# Heating Data

# SS Air Test @5amps

## 5 coils

Time (min) | Temp Core (C)
0 | 34
0.5 | 42.4
1 | 56.5
1.5 | 73.5
2 | 87.8
2.5 | 102.8
3 | 117.2
3.5 | 132.3
4 | 145.5
4.5 | 157.9
5 | 170.7
6 | 194.6
7 | 211
8 | 229
9 | 243
10 | 256
11 | 266
12 | 276
13 | 284
14 | 291
15 | 296
16 | 301

17 | 306
18 | 312
19 | 314
20 | 315
22 | 318
24 | 321
26 | 323
28 | 324
30 | 325

## 7 coils

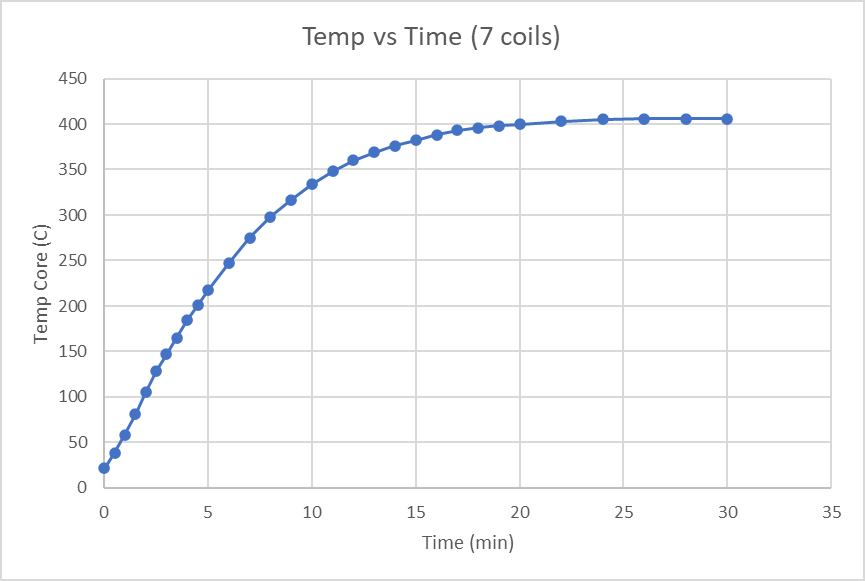
[picture p179: figure]

Time (min) | Temp Core (C)
0 | 21.8
0.5 | 38.8
1 | 58.6
1.5 | 81.2
2 | 105
2.5 | 128.7
3 | 146.8
3.5 | 165.1
4 | 184.7
4.5 | 201
5 | 218
6 | 247
7 | 275
8 | 298
9 | 317
10 | 334
11 | 348
12 | 360

13 | 369
14 | 376
15 | 382
16 | 388
17 | 393
18 | 396
19 | 398
20 | 400
22 | 403
24 | 405
26 | 406
28 | 406
30 | 406

## 9 coils

Time (min) | Temp Core (C)
0 | 25
0.5 | 43.6

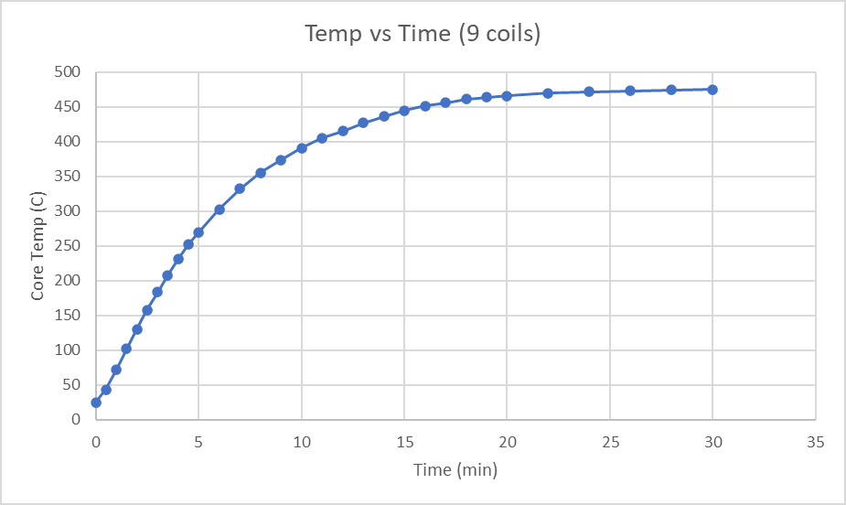
[picture p180: figure]

1 | 72.4
1.5 | 102.4
2 | 130.3
2.5 | 158.2
3 | 183.4
3.5 | 208
4 | 231
4.5 | 252
5 | 270
6 | 303
7 | 332

8 | 355
9 | 374
10 | 391
11 | 405
12 | 415
13 | 427
14 | 436
15 | 445
16 | 451
17 | 456
18 | 461
19 | 464
20 | 466
22 | 470
24 | 472
26 | 473
28 | 474
30 | 475

## 11 coils

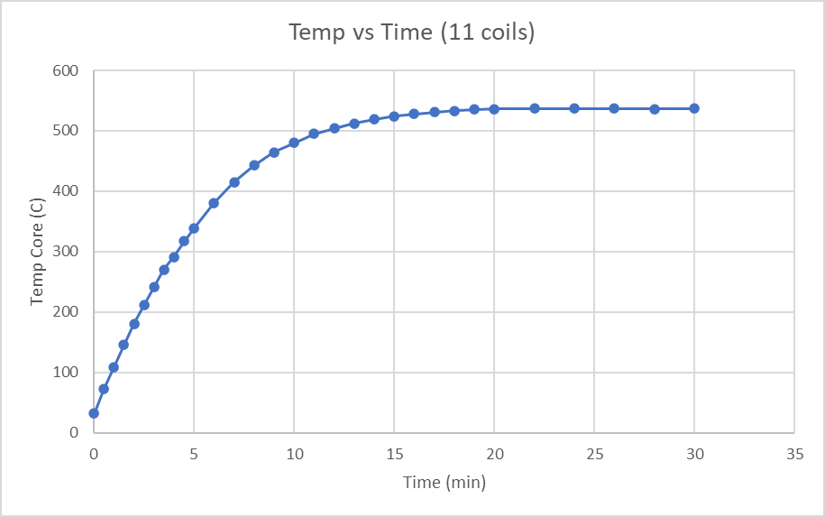
[picture p181: figure]

Time (min) | Temp Core (C)
0 | 32
0.5 | 73.1
1 | 108.4
1.5 | 145
2 | 180.2
2.5 | 211
3 | 241

3.5 | 270
4 | 291
4.5 | 317
5 | 339
6 | 381
7 | 415
8 | 443
9 | 464
10 | 480
11 | 495
12 | 504
13 | 512
14 | 519
15 | 524
16 | 528
17 | 531
18 | 533
19 | 535
20 | 536
22 | 537
24 | 537
26 | 537
28 | 536
30 | 537

## 13 coils

Time (min) | Temp Core (C)
0 | 28.9

Heating Data

6

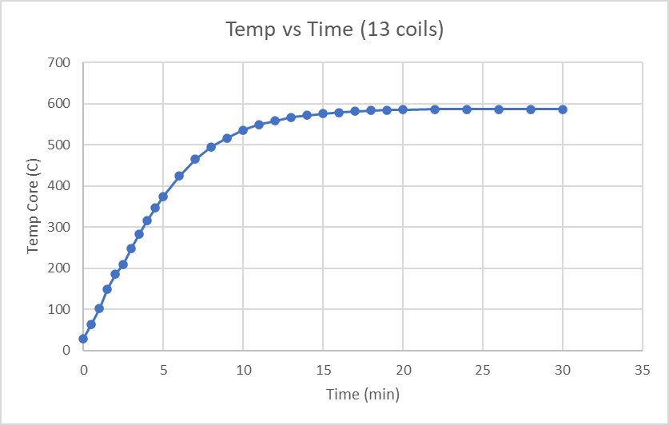
[picture p182: figure]

0.5 | 63.9 1 | 102
1.5 | 150 2 186
2.5 | 210 3 249
3.5 | 284 4 317
4.5 | 347 5 | 375 6 | 424 7 | 465 8 | 495 9 | 517
10 | 536 11 550
12 | 558
13 | 567
14 | 572
15 | 576
16 | 579
17 | 582
18 | 584
19 | 585
20 | 586
22 | 587
24 | 587
26 | 587
28 | 587
30 | 587

*Aluminum at 5amps and 13 coils reached 587 as well

# Max Temps:

The maximum temperatures for SS tests in air are: 325°C for 5 coils, 406°C for 7 coils, 475°C for 9 coils, 537°C for 11 coils, and 587°C for 13 coils. Maximum temperature for SS test in vacuum is: 362°C for 5 coils

# Max Temp vs #Coils

Coils | Max temp
5 | 325
7 | 406
9 | 475
11 | 537
13 | 587

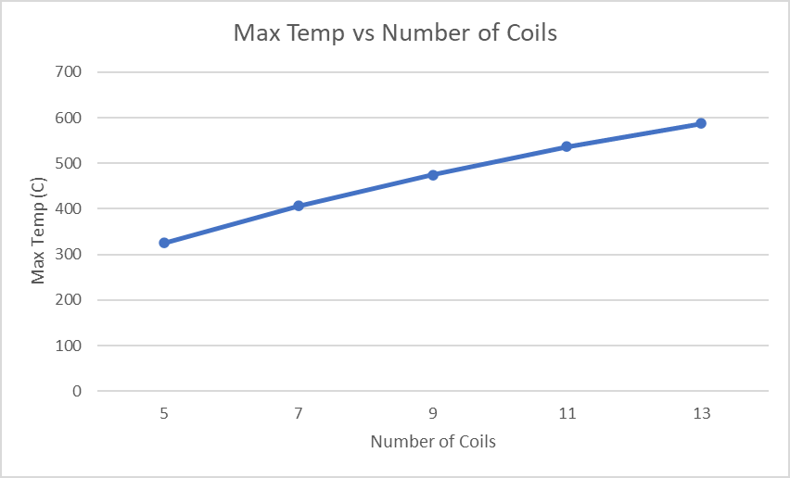
[picture p183: figure]

Approximate Equation for line:

# Copper Air Test @5amps

## 4 coils

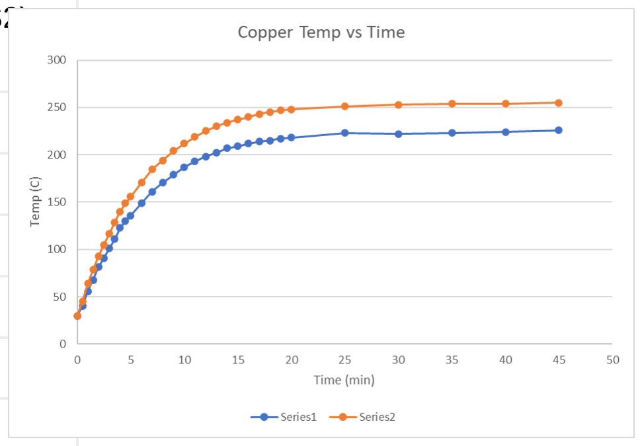
[picture p184: figure]

Time (min) | TOP (S1)(C) | BOTTOM (S2) (C)
0 | 30 | 30
0.5 | 40 | 45
1 | 56 | 64
1.5 | 67.8 | 78.6
2 | 81.5 | 92.5
2.5 | 90.6 | 104.5
3 | 101.4 | 117
3.5 | 110.9 | 128.8
4 | 122.9 | 140
4.5 | 129.7 | 148.8
5 | 135.8 | 155.7
6 | 148.9 | 170.6
7 | 161 | 184.5
8 | 170.5 | 194
9 | 179 | 204
10 | 186.9 | 212
11 | 192.9 | 219
12 | 198 | 225
13 | 202 | 230
14 | 207 | 234

## Tm = 32.75C + 171.25

15 | 209 | 237
16 | 212 | 240
17 | 214 | 243
18 | 215 | 245
19 | 217 | 247
20 | 218 | 248
25 | 223 | 251
30 | 222 | 253
35 | 223 | 254
40 | 224 | 254
45 | 226 | 255

## 5 coils

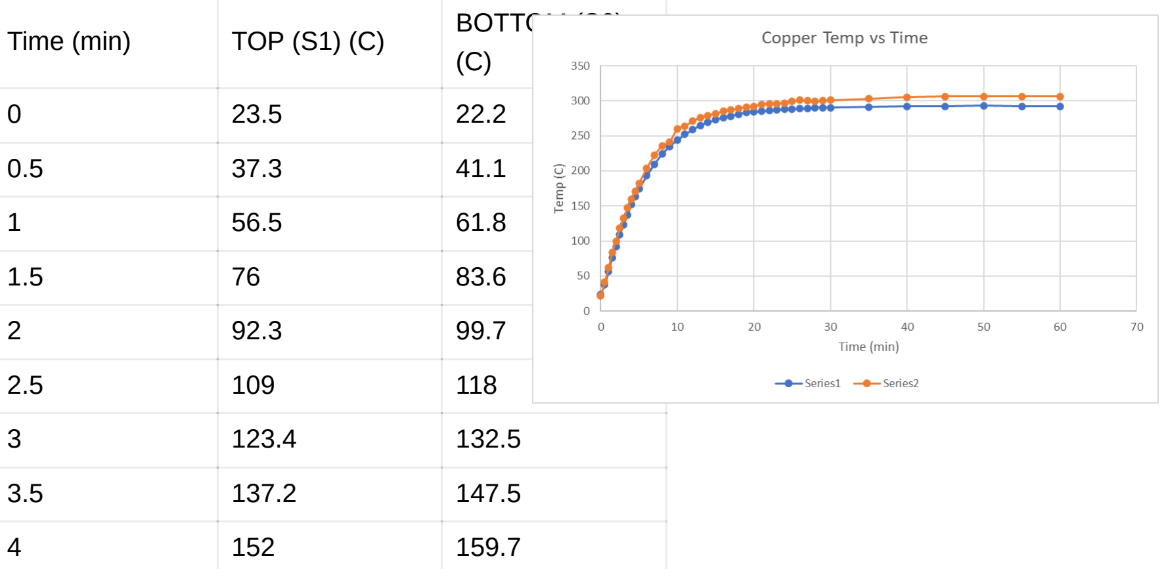
[picture p185: figure]
Time (min); TOP (S1) (C); BOTTOM (S2) (C)

4.5 | 163.7 | 170.6
5 | 174.3 | 181.7
6 | 193.3 | 204
7 | 209 | 222
8 | 224 | 236

9 | 235 | 241
10 | 244 252 | 260 11 264
12 | 259 | 271
13 | 265 | 276
14 | 269 | 279
15 | 273 | 282
16 | 276 | 285
17 | 278 | 287
18 | 281 | 289
19 | 283 | 291
20 | 284 | 292
21 | 285 | 295
22 | 286 | 296
23 | 287 | 296
24 | 288 | 297
25 | 288 | 299
26 | 289 | 301
27 | 289 | 300
28 | 290 | 299
29 | 290 | 300
30 | 290 | 301
35 | 291 | 303
40 | 292 | 305
45 | 292 | 306
50 | 293 | 306
55 | 292 | 306
60 | 292 | 306

## 6 coils

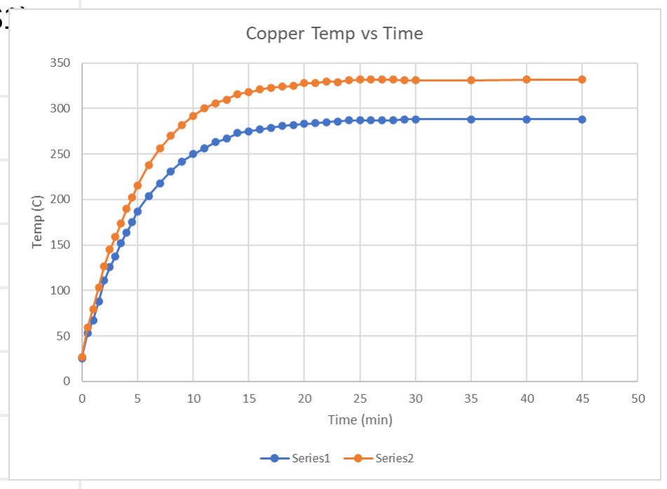
[picture p186: figure]

Time (min) | TOP (S1) (C) | BOTTOM (S1) (C)
0 | 25.6 | 26.6
0.5 | 52.8 | 59
1 | 67.1 | 79.5
1.5 | 87.5 | 103.5
2 | 110.7 | 126.5
2.5 | 125.4 | 144.9
3 | 137.3 | 158.7
3.5 | 152.3 | 173.8
4 | 163.6 | 189.8
4.5 | 175 | 202
5 | 186.8 | 215
6 | 204 | 238
7 | 218 | 256
8 | 231 | 270
9 | 242 | 282
10 | 250 | 292
11 | 256 | 300
12 | 263 | 306
13 | 267 | 310
14 | 273 | 316
15 | 275 | 318
16 | 277 | 321
17 | 279 | 323
18 | 281 | 324
19 | 282 | 325
20 | 283 | 328

21 | 284 | 328
22 | 285 | 330
23 | 286 | 329
24 | 287 | 331
25 | 287 | 332
26 | 287 | 332
27 | 287 | 332
28 | 287 | 332
29 | 288 | 331
30 | 288 | 331
35 | 288 | 331
40 | 288 | 332
45 | 288 | 332

# Vacuum Testing

# Empty Baseline

8/9/23

2:44

3:04

4:10

4:30

8/10/23

8:36

10:32

12:58

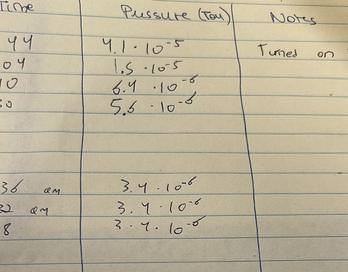
[picture p187: figure]

Started at 1131 torr and over ~24 hour dropped to 3.4E-6

Final Partial Pressures:

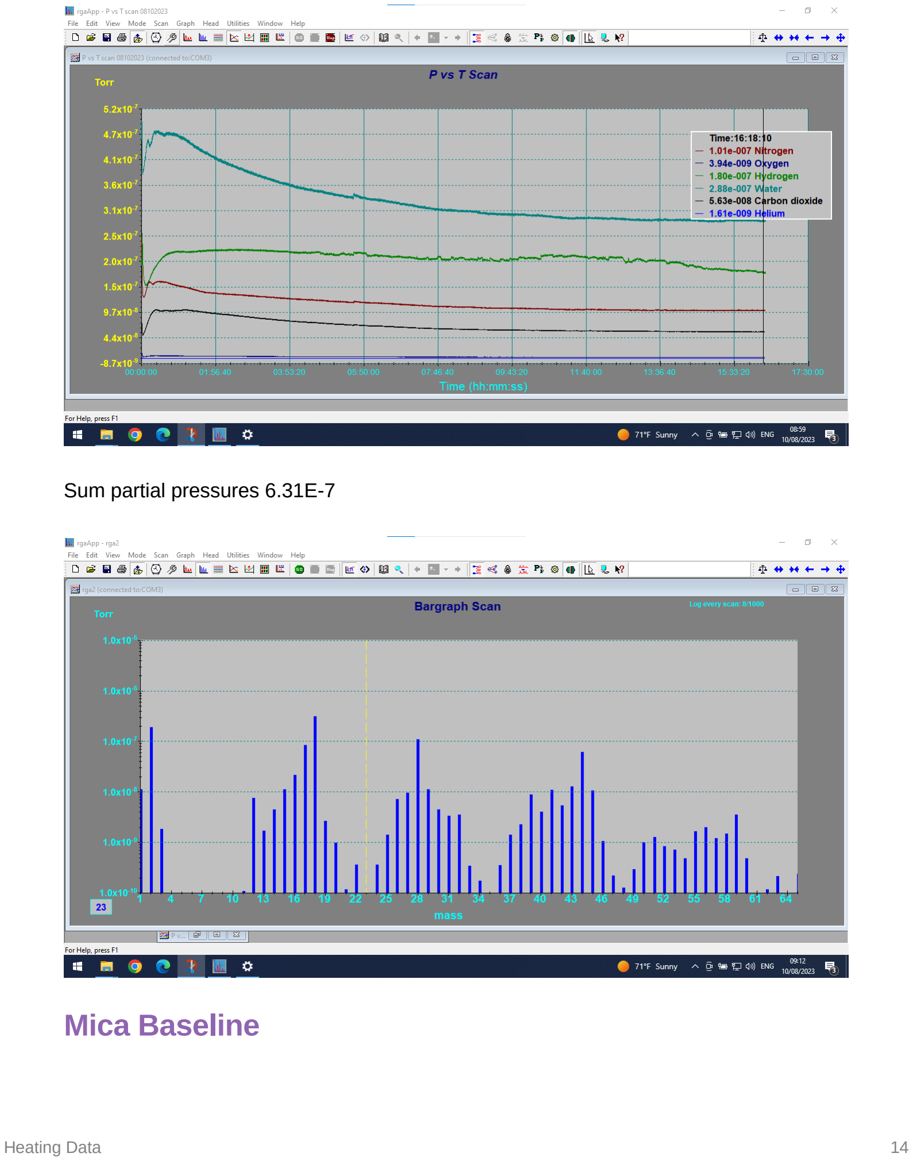
[picture p188: page 14]

Sum partial pressures 6.31E-7

# Mica Baseline

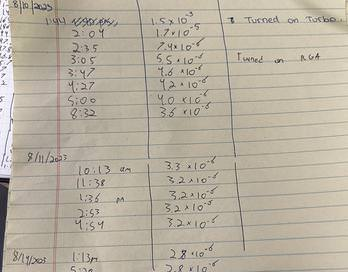
[picture p189: figure]

Started at 1131 torr, after 24 hours dropped to 3.2E-6, after ~124 hours dropped to 2.5E-6

Final Partial Pressures:

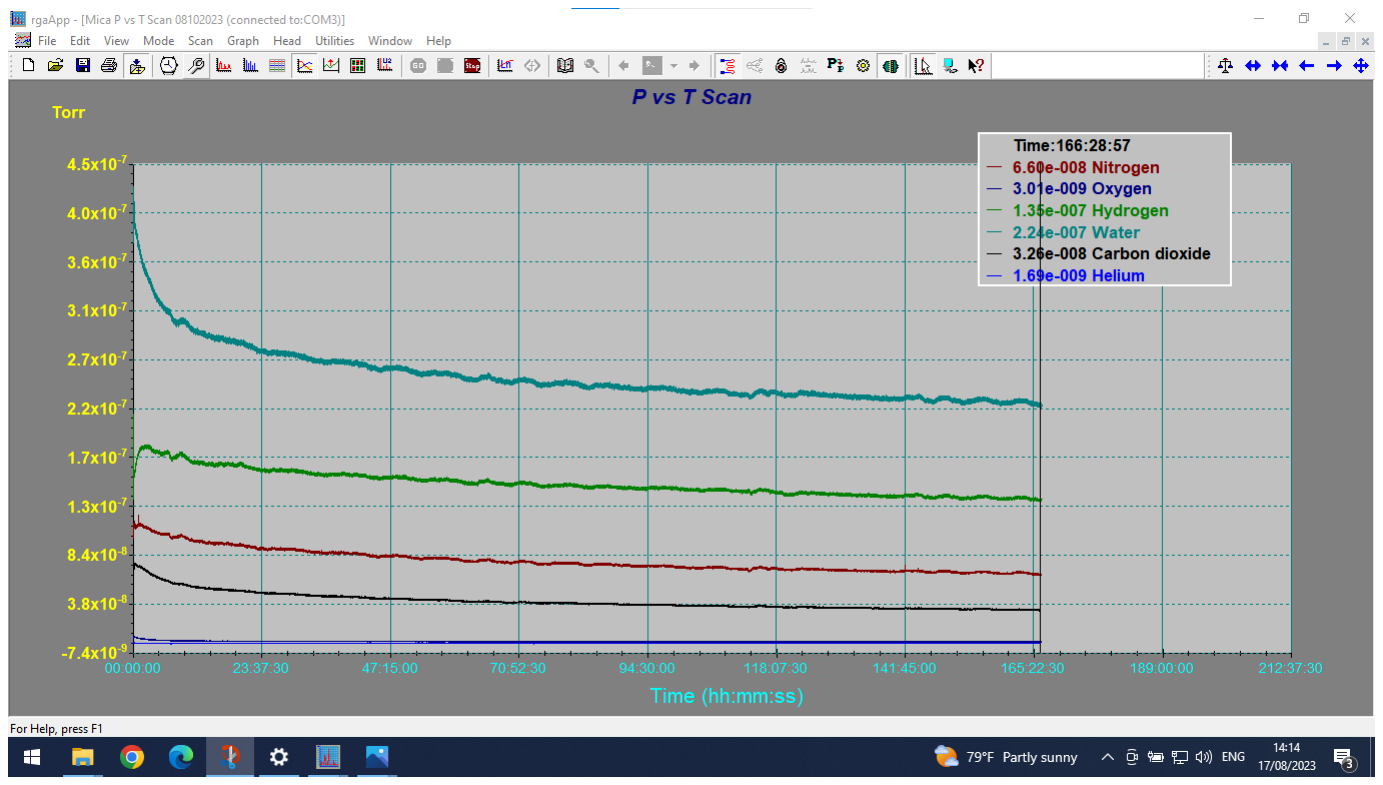
[picture p190: figure]

# Mica + SS Reservoir Baseline

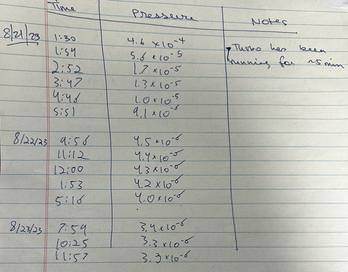
[picture p191: figure]

Started at ~1130 torr, after ~24 hours dropped to 4.3E-6 torr, after ~70 hours dropped to 3.3E-6

Final Partial Pressures/Partial Pressure Before Heating:

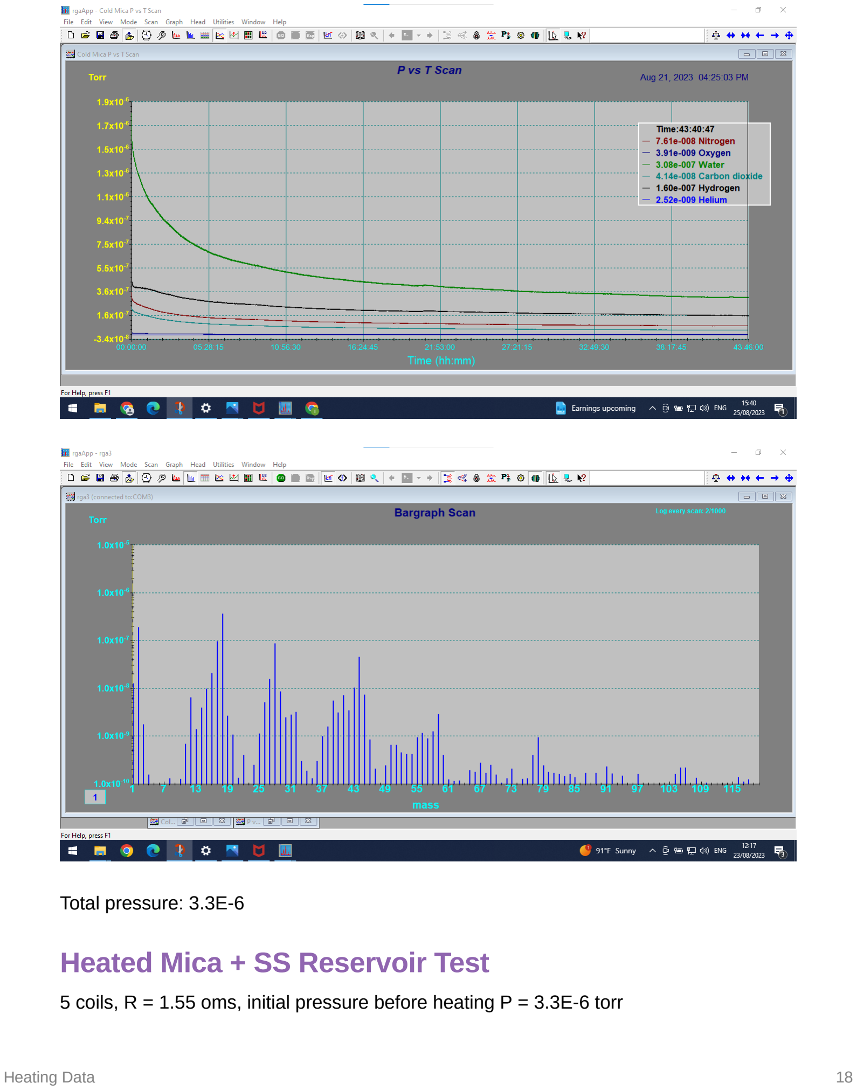
[picture p192: page 18]

Total pressure: 3.3E-6

# Heated Mica + SS Reservoir Test

5 coils, R = 1.55 oms, initial pressure before heating P = 3.3E-6 torr

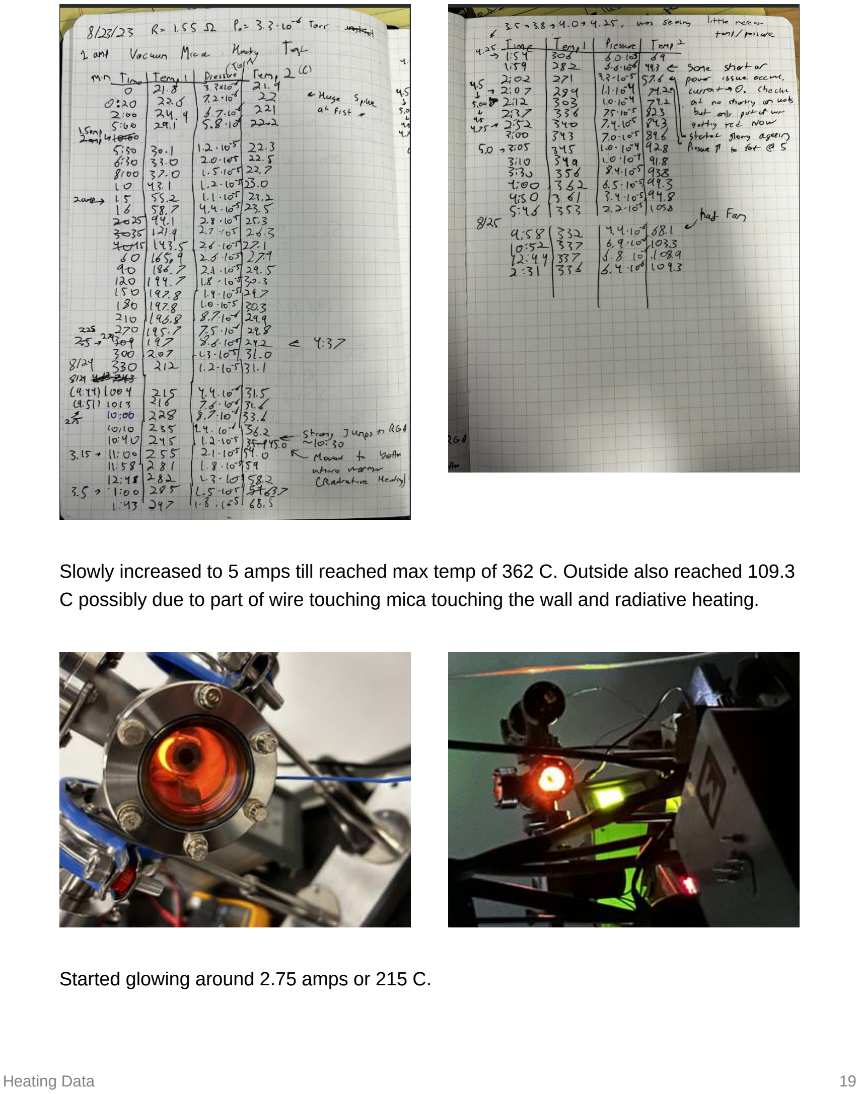
[picture p193: page 19]

Slowly increased to 5 amps till reached max temp of 362 C. Outside also reached 109.3 C possibly due to part of wire touching mica touching the wall and radiative heating.

Started glowing around 2.75 amps or 215 C.

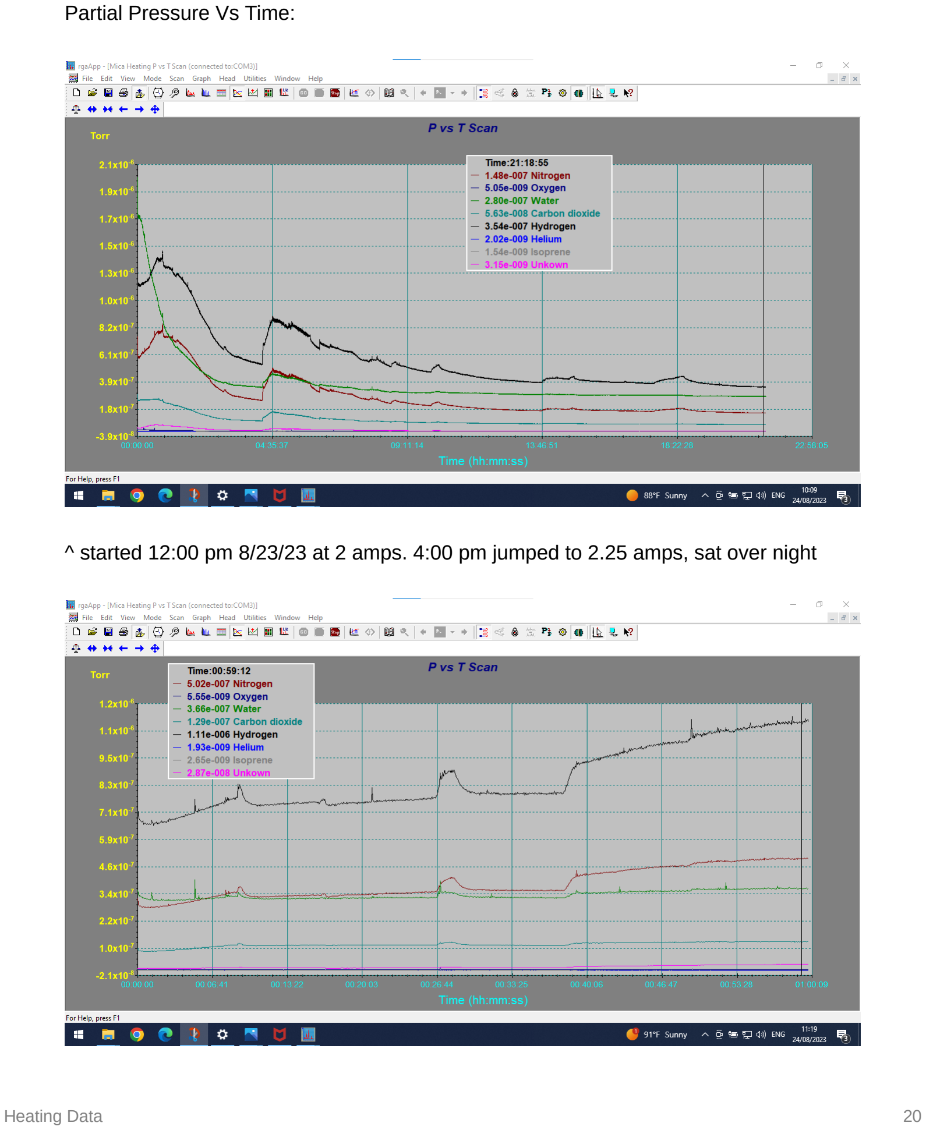
[picture p194: page 20]

Partial Pressure Vs Time:

^ started 12:00 pm 8/23/23 at 2 amps. 4:00 pm jumped to 2.25 amps, sat over night

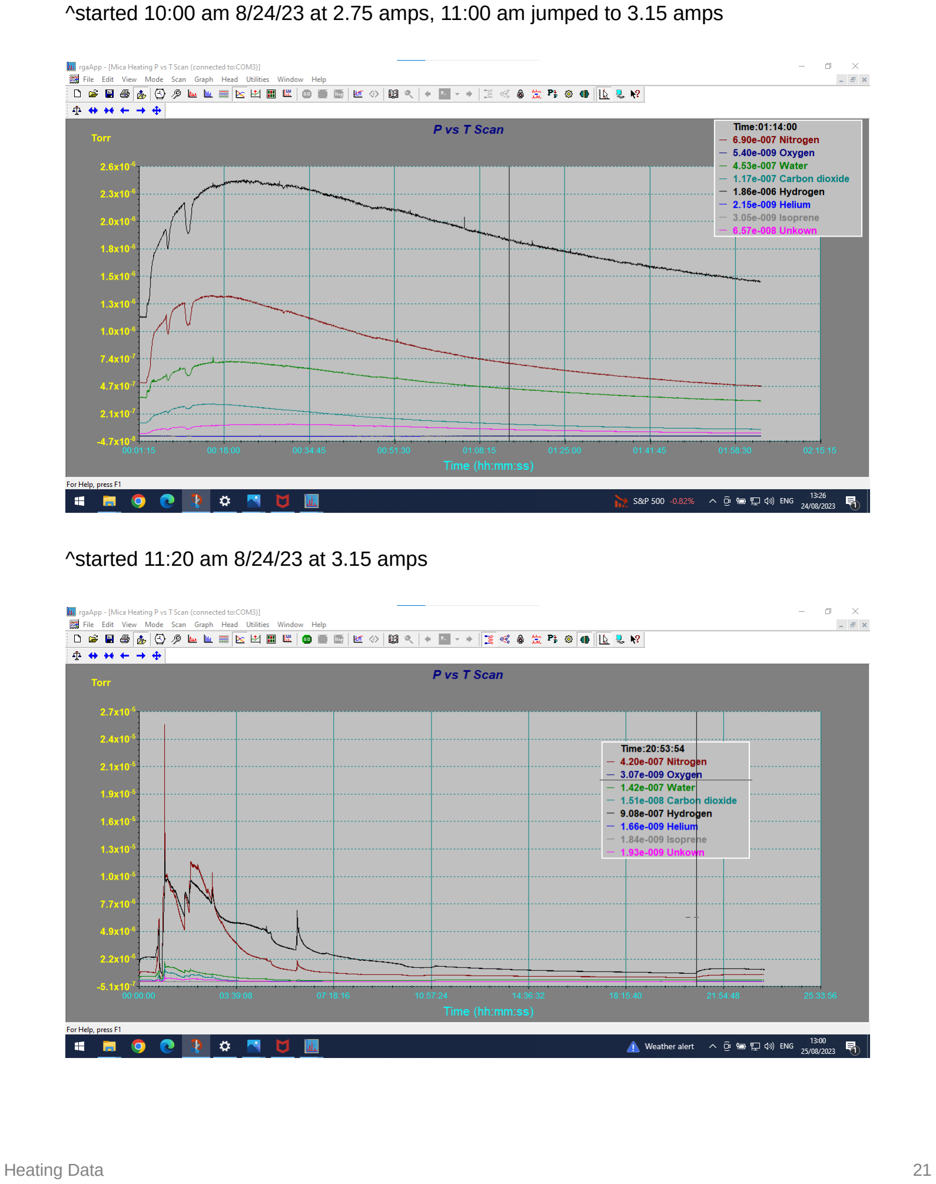
[picture p195: page 21]

^started 10:00 am 8/24/23 at 2.75 amps, 11:00 am jumped to 3.15 amps

^started 11:20 am 8/24/23 at 3.15 amps

^started 1:30 pm 8/24/23. 1:50 pm jumped to 4.25 amps, 2:10 pm jumped to 4.5 (accidently went to 5 for a second correlating to huge spike in nitrogen and helium seen before going back down to 4.5), 2:52 pm jumped to 4.75 amps, 3:05 jumped to 5.0 amps.

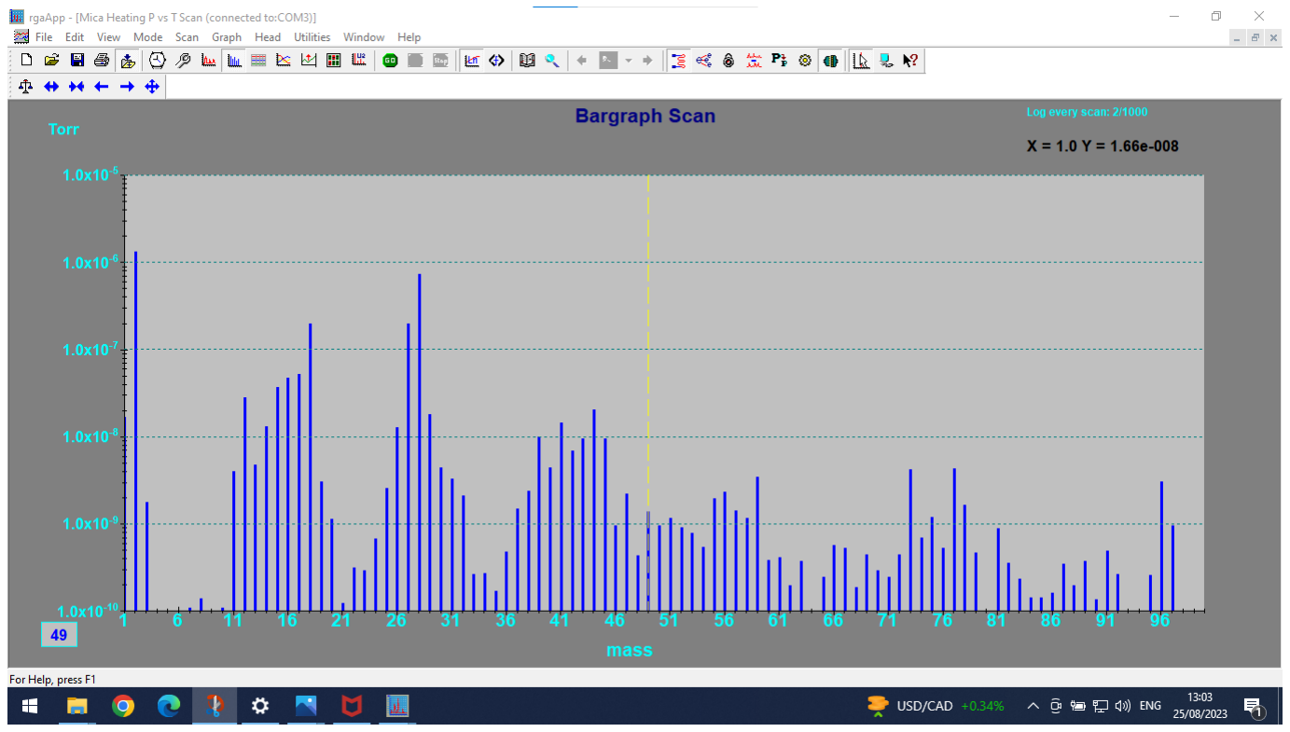
[picture p196: figure]

^Taken 12:40 pm 8/25/223. Total pressure 6.8E-6

# Comparing Hot and Cold Pressures:

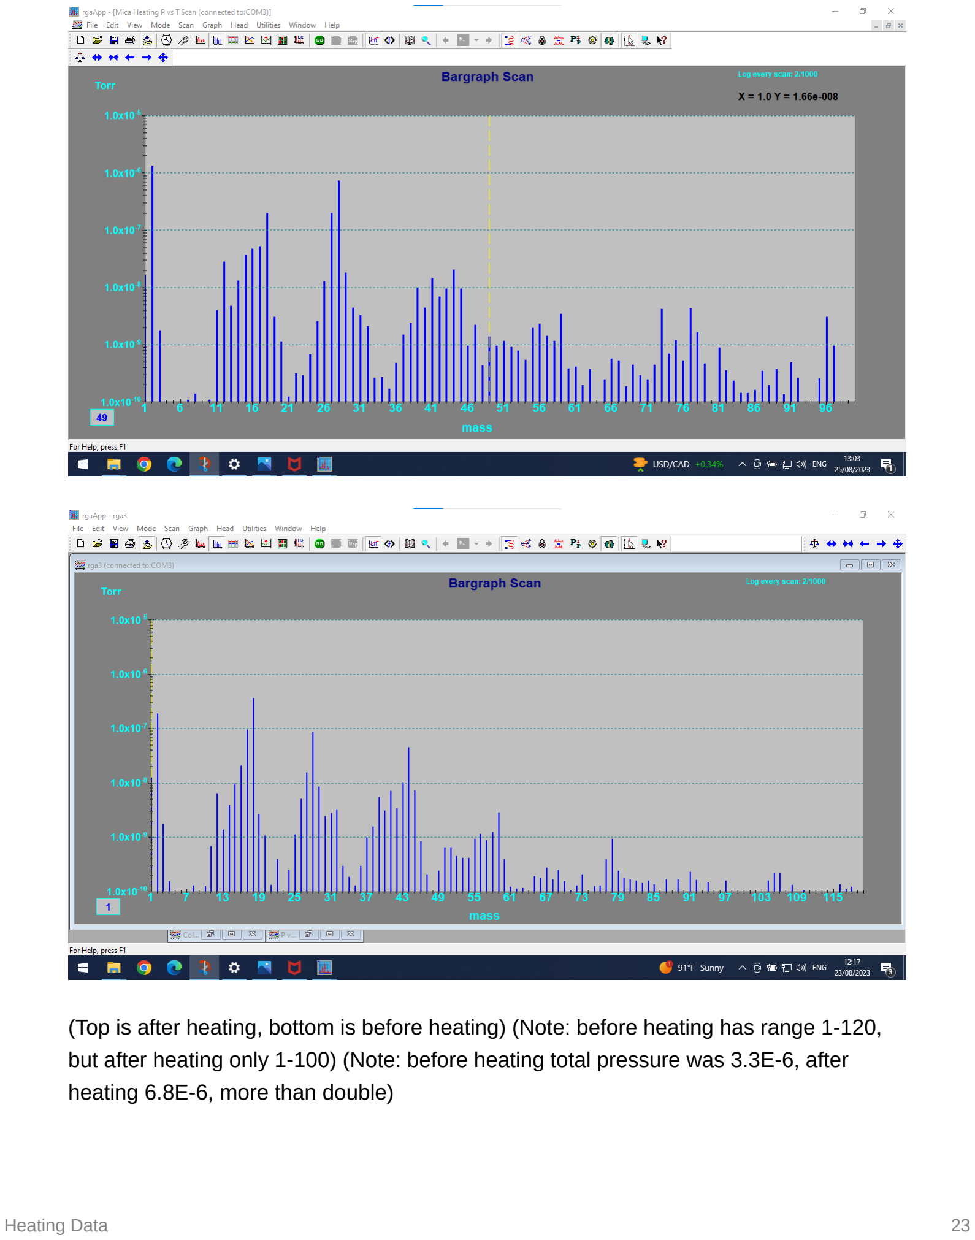
[picture p197: page 23]

(Top is after heating, bottom is before heating) (Note: before heating has range 1-120, but after heating only 1-100) (Note: before heating total pressure was 3.3E-6, after heating 6.8E-6, more than double)

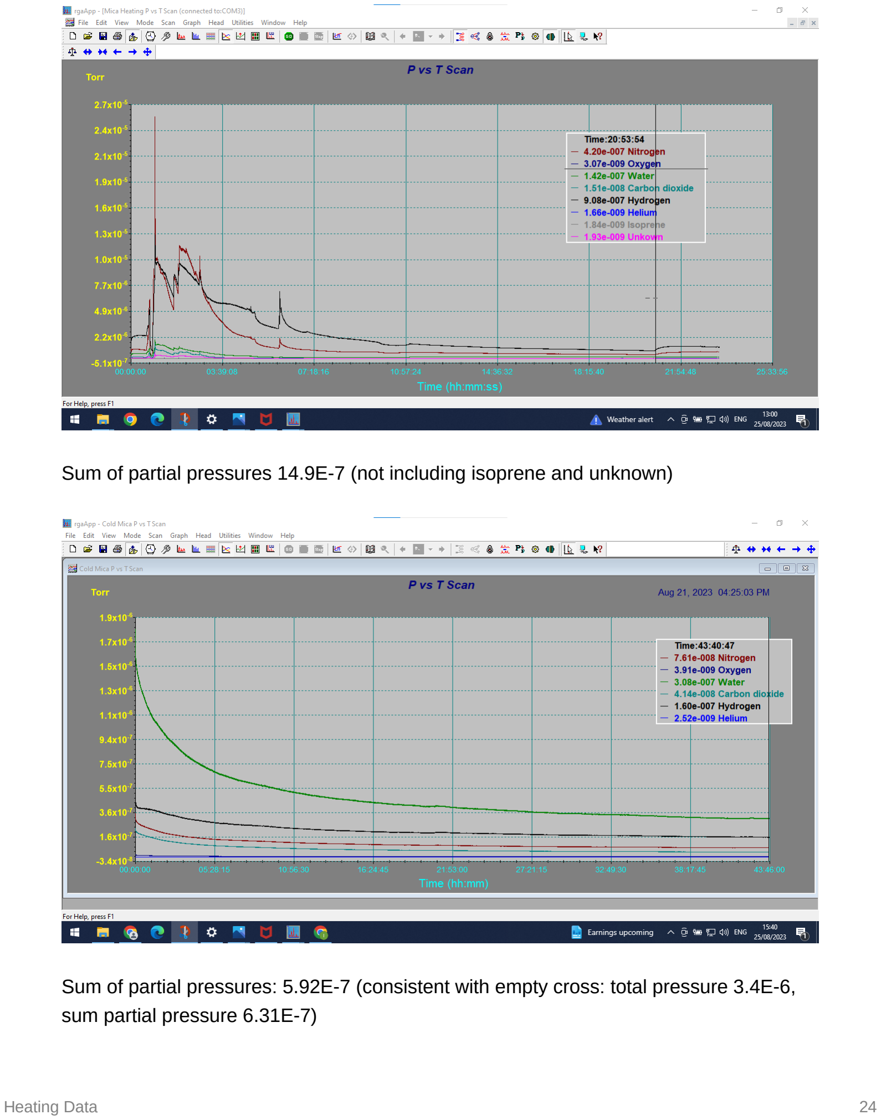
[picture p198: page 24]

Sum of partial pressures 14.9E-7 (not including isoprene and unknown)

Sum of partial pressures: 5.92E-7 (consistent with empty cross: total pressure 3.4E-6, sum partial pressure 6.31E-7)

Difference in partial pressures of each gass in heat compared to cold test:

Nitrogen: 1.86x

Oxygen: 0.79x

Water: 0.46x

Carbon Dioxide: 0.36x

Hydrogen: 1.76x

Helium: 0.65x

Chemical Compositions:

Isoprene: C5H8

Mica:

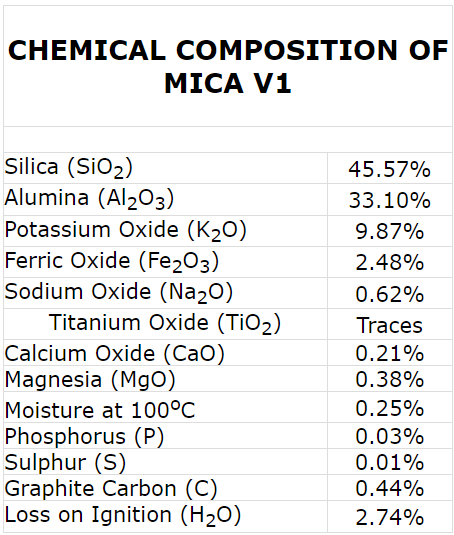
[picture p199: figure]
