cross-isaac/IsaacCross_Senior_Thesis/07_Talks_and_Posters/README.md

# 07_Talks_and_Posters — Presentations of this work

- **`A Dual-Species Beam Source for Doped Cryogenic Crystal Growth, CFP Pre talk.pptx`**
  (+ Google Slides PDF export) — talk on the beam source project (CFP prelim).
- **`MCAW_2025_OdomPoster.pptx/.pdf`** — Odom Lab poster, Midwest Cold Atom Workshop 2025.
- **`ICross_421_Poster.pptx/.pdf`** — poster for the ES_APPM 421 broadening-simulation
  project (see `05_Broadening_Simulation`).
- **`Rodd flyer2.pdf`** — outreach/recruiting flyer.
