cross-isaac/IsaacCross_Senior_Thesis/08_Proposals_and_Applications/README.md

# 08_Proposals_and_Applications — Funding, applications, and career documents

## Proposals/

Northwestern undergraduate research grant applications, named by outcome:
- `WURG2023_IsaacCross (Got).pdf` — Winter URG (funded; Kovachy lab work).
- `SURG2023/2024_IsaacCross (Did Not Get).pdf`, `MSRG2024/2025_IsaacCross (Did Not Get).pdf`
  — unfunded applications.
- `SURG2025_IsaacCross (Got).pdf` — Summer URG (funded; acknowledged in the thesis).
- `description_plus_extra_OdomLab.pdf` — Odom lab / project description supplement.

## Reports/

- `CrossIsaac_GRFP_GraduateResearchPlan2025.pdf`, `CrossIsaac_GRFP_PersonalStatement2025.pdf`
  — NSF GRFP application (the `01_References/NSF Research Plan Papers` folder was
  collected for this).
- `Isaac_Cross_SOP_JHU.pdf`, `Isaac_Cross_Personal_History_Statement.pdf` — grad school
  application documents.
- `ICross_421_Final_Report_BroadeningSim.pdf` — 421 course report (identical copy lives
  with the simulation in `05_Broadening_Simulation`).
- `ICross_480_Final_Report_CrystalClock.pdf` — Physics 480 final report (crystal clock).
- `Apparatus_Diagram_and_Images.pdf` — apparatus summary document.
- `Isaac_Cross_CV_Physics_II.pdf` — CV (newer version).

Root: `Isaac_Cross_CV_Physics.pdf` — earlier CV version (both kept intentionally).
