cross-isaac/IsaacCross_Senior_Thesis/02_Beam_Source_Design/CAD/Oven_SW_Models/Nozzle/Sketches/Untitled document - Google Docs.pdf

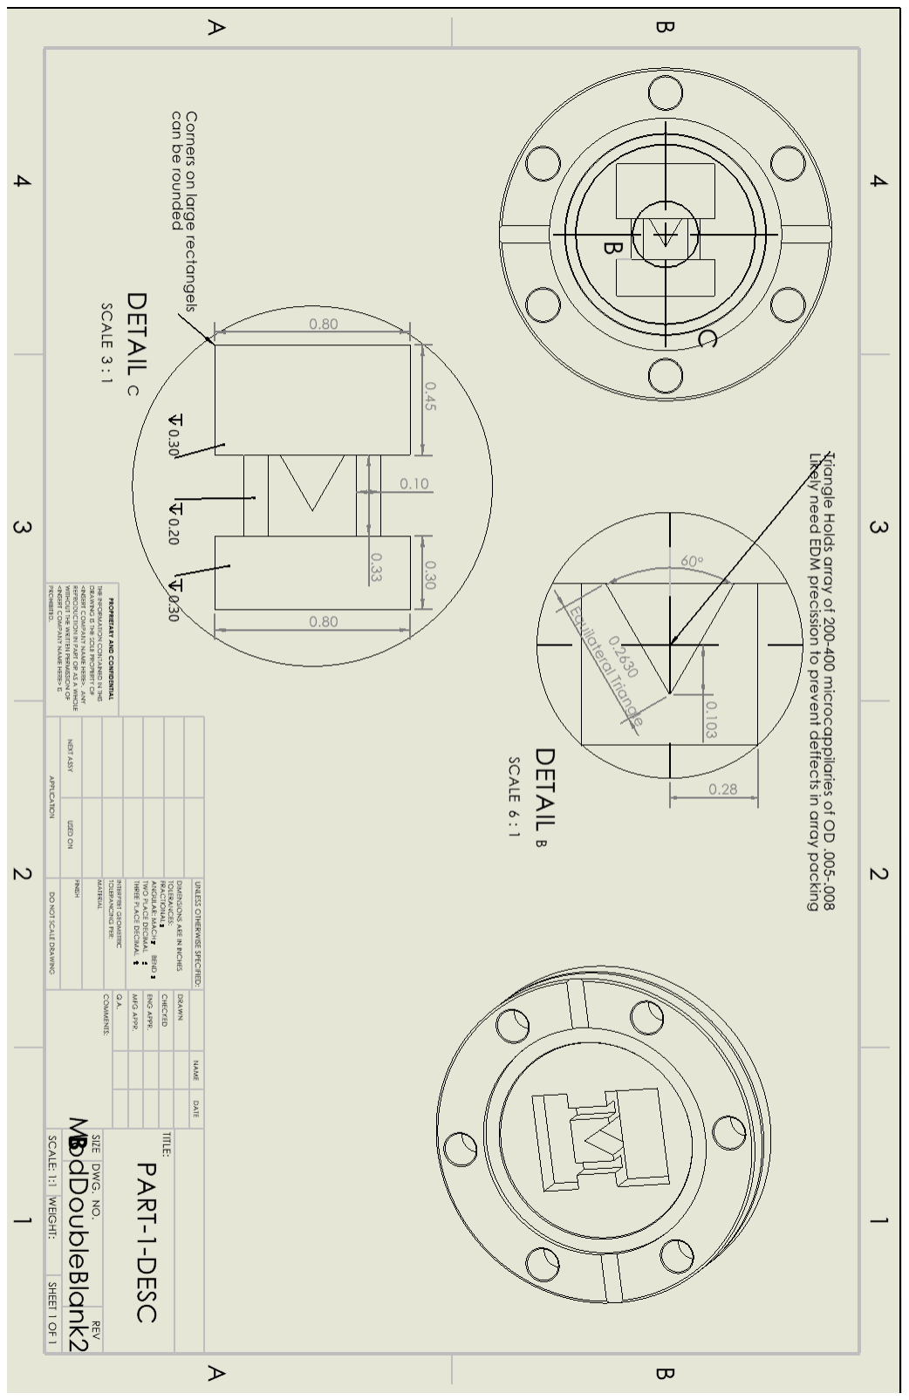
[picture p215: page 1]
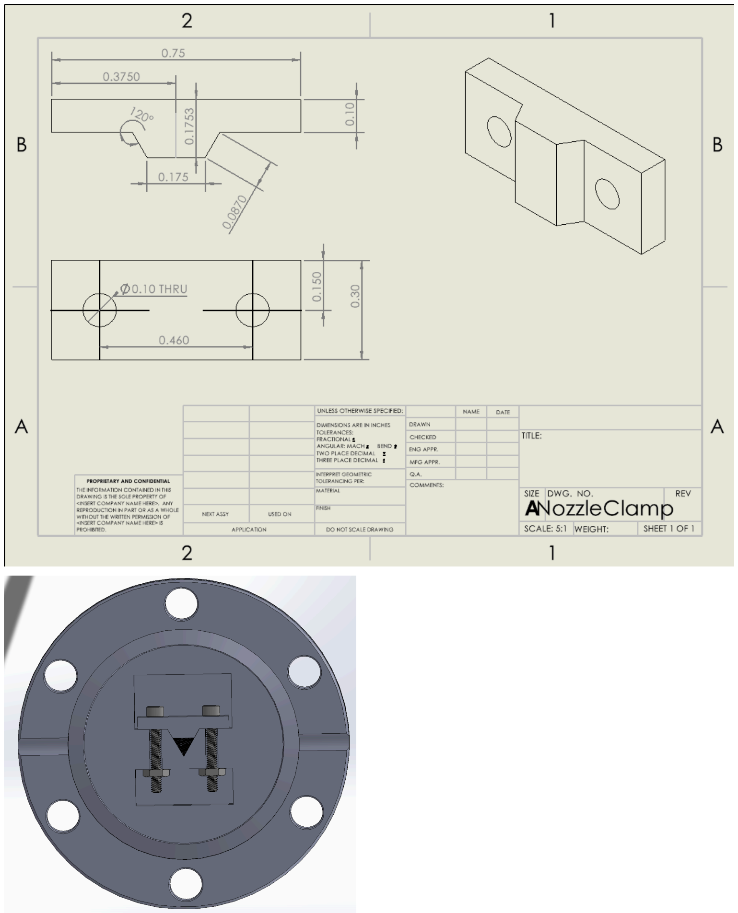
[picture p216: page 2]
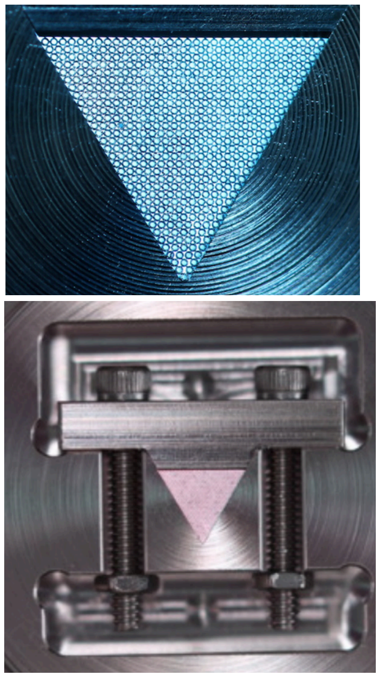
[picture p217: page 3]
