cross-isaac/IsaacCross_Senior_Thesis/99_Archive/README.md

# 99_Archive — Duplicates and drafts (safe to ignore, kept deliberately)

Nothing in here is needed to understand or reproduce the thesis.

## duplicates/ *(git-ignored)*

Byte-identical copies (verified by MD5 hash) of files that live elsewhere in the repo.
Moved here instead of deleted, per explicit choice:

- `data_101225_Far - Copy/`, `data_101225_Near - Copy/` — full copies of the raw
  absorption data in `04_.../absorption_data/data_101225/Far|Near`.
- `data_101225_full2converted.csv` — was at `data_101225/` root; identical to
  `data_101225/Far/full2converted.csv` (566 MB).
- `RelativeAbs{Far,Near} - Copy*.csv` — copies of results CSVs.
- `Summary Plots - Copy/`, `Summary Plots Good/` — copies/subset of
  `06_.../Thesis_Figures/ch06_results/Summary Plots`.
- `ICross_421_Poster.pptx` — identical to the copy in `07_Talks_and_Posters`.
- `MSRG2024.pdf`, `SURG2024.pdf`, `WURG Proposal 2023.pdf`,
  `description plus extra (1)*.pdf` — identical to the copies in `08_.../Proposals`.

(Exact-duplicate copies of *published papers* were deleted outright rather than archived —
one copy of each remains in `01_References`. This includes the former root files
`4409_1_online.pdf` (= Ross & Sonntag) and second copies of the Foot and Moore textbooks,
the Upadhyay and Regmi theses, and the Senaratne nozzle paper.)

## ai_generated_drafts/

AI-assisted drafts kept for reference (formerly the `AI shit` folder):
- `flux_derivation.pdf`, `oven_design.pdf` — draft derivations/design writeups.
- `thesis_project_v2.zip` — an alternate 9-chapter LaTeX skeleton that was not used
  (final thesis source is in `00_Thesis`).
- `Deep_Research_Prompt.pdf` — AI research prompt document.
