cross-isaac/IsaacCross_Senior_Thesis/99_Archive/ai_generated_drafts/Deep_Research_Prompt.pdf

# Understanding & Optimizing the Growth of Doped Cryogenic Noble Gas Crystals with a Dual-Species Atomic Beam

## 1 Objective

This Deep Research task aims to develop a detailed understanding of how to grow large, high-quality noble gas single crystals doped with Rb (or Cs) using a dual-species atomic beam of Rb and Ar. The focus is on:

- Understanding the key physics of cryogenic doped crystal formation.
- Identifying critical crystal properties that impact performance.
- Determining experimental variables to systematically explore the phase space of crystal growth.
- Investigating how the dual-species Rb/Ar beam interacts with crystal formation and which aspects of the beam must be characterized and controlled.

## 2 Key Areas of Focus

### 2.1 Deep Understanding of Cryogenic Doped Crystal Growth

- What are the fundamental physical principles governing the growth of noble gas single crystals doped with Rb or Cs?
- What mechanisms control dopant incorporation into the crystal lattice?
- How do temperature, deposition rates, and cooling conditions impact crystallinity and defect formation?
- What are the structural and phase stability conditions for noble gas solids?

1

### 2.2 Key Crystal Properties for Experimental Applications

- What crystal properties are most important for applications related to EDM measurements and long T

∗
2

times?

- What influences dopant uniformity, trapping site consistency, and defect density?
- How do different growth conditions impact dopant positioning and phase stability?

### 2.3 Experimental Framework for Investigating Crystal Growth

- Which key experimental parameters should be systematically varied?

– Temperature, deposition rate, cooling speed, Rb/Ar ratio, beam flux, divergence, substrate interactions.

- How should experimental results be analyzed to determine optimal growth conditions?
- What techniques exist for mapping out the phase space of crystal growth and defect formation?
- Are there precedents for using similar experimental approaches?

### 2.4 Understanding & Characterizing the Dual-Species Rb/Ar

Beam

- How does a dual-species beam affect doping efficiency and crystal growth compared to a single-species beam?
- What are the key parameters of the beam that need to be controlled and measured?

– Rb/Ar flux ratio, velocity distribution, divergence, sticking probability.

- What aspects of the beam can be adjusted in the oven design to influence doping?
- Are there existing studies using dual-species atomic beams for noble gas crystal growth? If not, what aspects make this approach novel?

### 2.5 Best Techniques for Analyzing the Beam & Crystal

- Beam Characterization:

– Schlieren imaging for Ar flow visualization.

2

– Saturated absorption spectroscopy (SAS) for Rb velocity distribution.
– Laser-induced fluorescence (LIF) for detecting Rb density & states.

– Absorption spectroscopy for measuring both Rb and Ar density profiles.

- Crystal Characterization:

– Photoluminescence (PL) and Raman spectroscopy for dopant distribution & defect detection.

– Fluorescence spectroscopy for assessing site uniformity.
– Potential (secondary) role of X-ray diffraction (XRD) for structural analysis.

### 2.6 Identifying Gaps in Knowledge & Future Experiments

- What experimental unknowns remain?
- What experimental steps should be taken first to explore phase space?
- How can these results be linked to optimizing oven conditions?

## 3 Research Approach & Methodology

- Analyze all provided PDFs and synthesize their findings.
- Conduct additional web-based research to find:

– Existing atomic beam doping techniques.
– Dual-species atomic beam applications (if they exist).

– Fundamental studies on dopant incorporation into noble gas solids.

– Experimental methodologies for cryogenic single crystal growth.

## 4 Strict Citation Requirements

- Every piece of information must be properly cited from either the provided sources or newly found research.
- If a question cannot be answered, the report must explicitly state this rather than inventing an answer.
- Maintain scientific integrity—no speculative claims, only evidence-based conclusions.

3

## 5 Expected Output Format

The Deep Research output should be a structured scientific report, including:

- Introduction: Overview of doped noble gas solids & their applications.
- Background on Cryogenic Crystal Growth: Theoretical principles of deposition & doping.
- Atomic Beam Physics & Characterization: How the dual-species Rb/Ar beam influences growth.
- Experimental Methods: Suggested techniques for beam & crystal analysis.
- Recommended Experimental Framework: How to systematically explore crystal growth conditions.
- Comparative Analysis: Comparison to prior research.
- Conclusions & Open Questions: Remaining experimental challenges & next steps.

4
