cross-isaac/IsaacCross_Senior_Thesis/02_Beam_Source_Design/CAD/Chamber_SW_Models/Block Diagram Beam Source Angle2.PNG

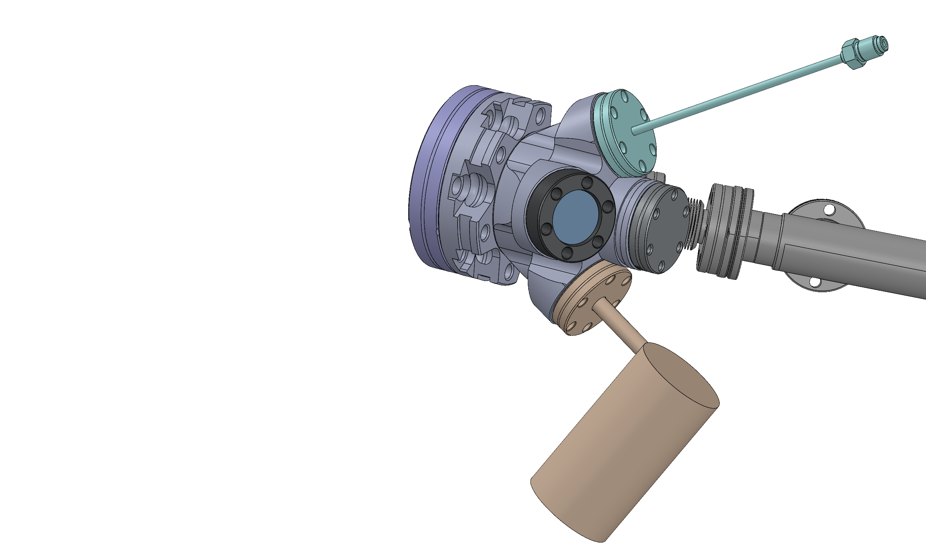
02_Beam_Source_Design/CAD/Chamber_SW_Models/Block Diagram Beam Source Angle2.PNG
