cross-isaac/IsaacCross_Senior_Thesis/02_Beam_Source_Design/CAD/Crystal_Growth_Chamber/CHEX Aparatus 2/CHEX Appartus 2 Drawings/Screenshot 2024-01-05 183253.png

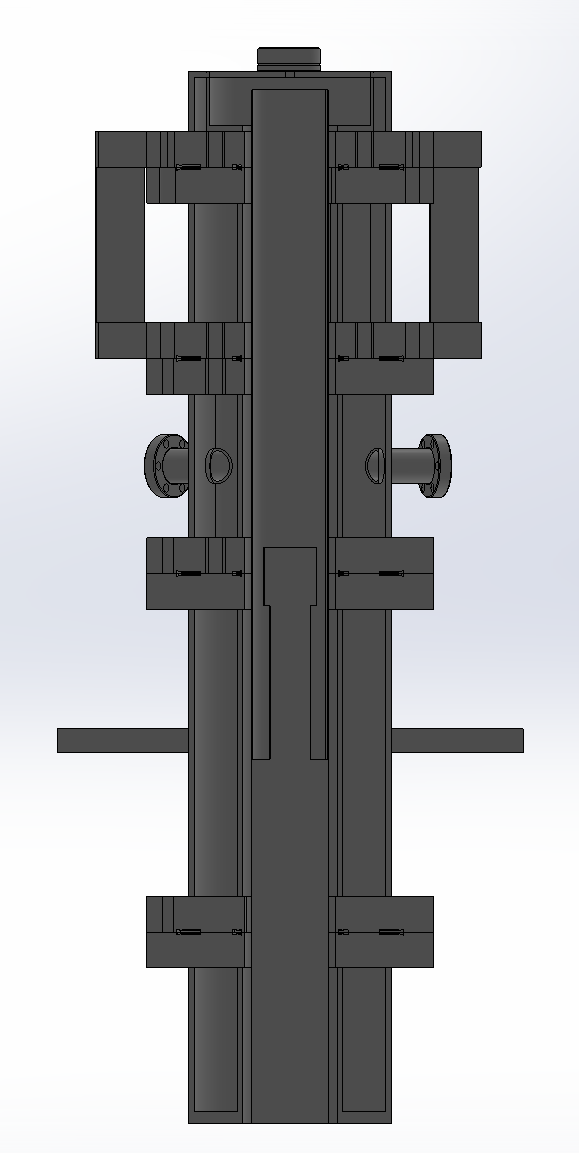
02_Beam_Source_Design/CAD/Crystal_Growth_Chamber/CHEX Aparatus 2/CHEX Appartus 2 Drawings/Screenshot 2024-01-05 183253.png
