cross-isaac/IsaacCross_Senior_Thesis/02_Beam_Source_Design/CAD/Crystal_Growth_Chamber/CHEX Aparatus 2/CHEX Appartus 2 Drawings/Screenshot 2024-01-08 161338.png

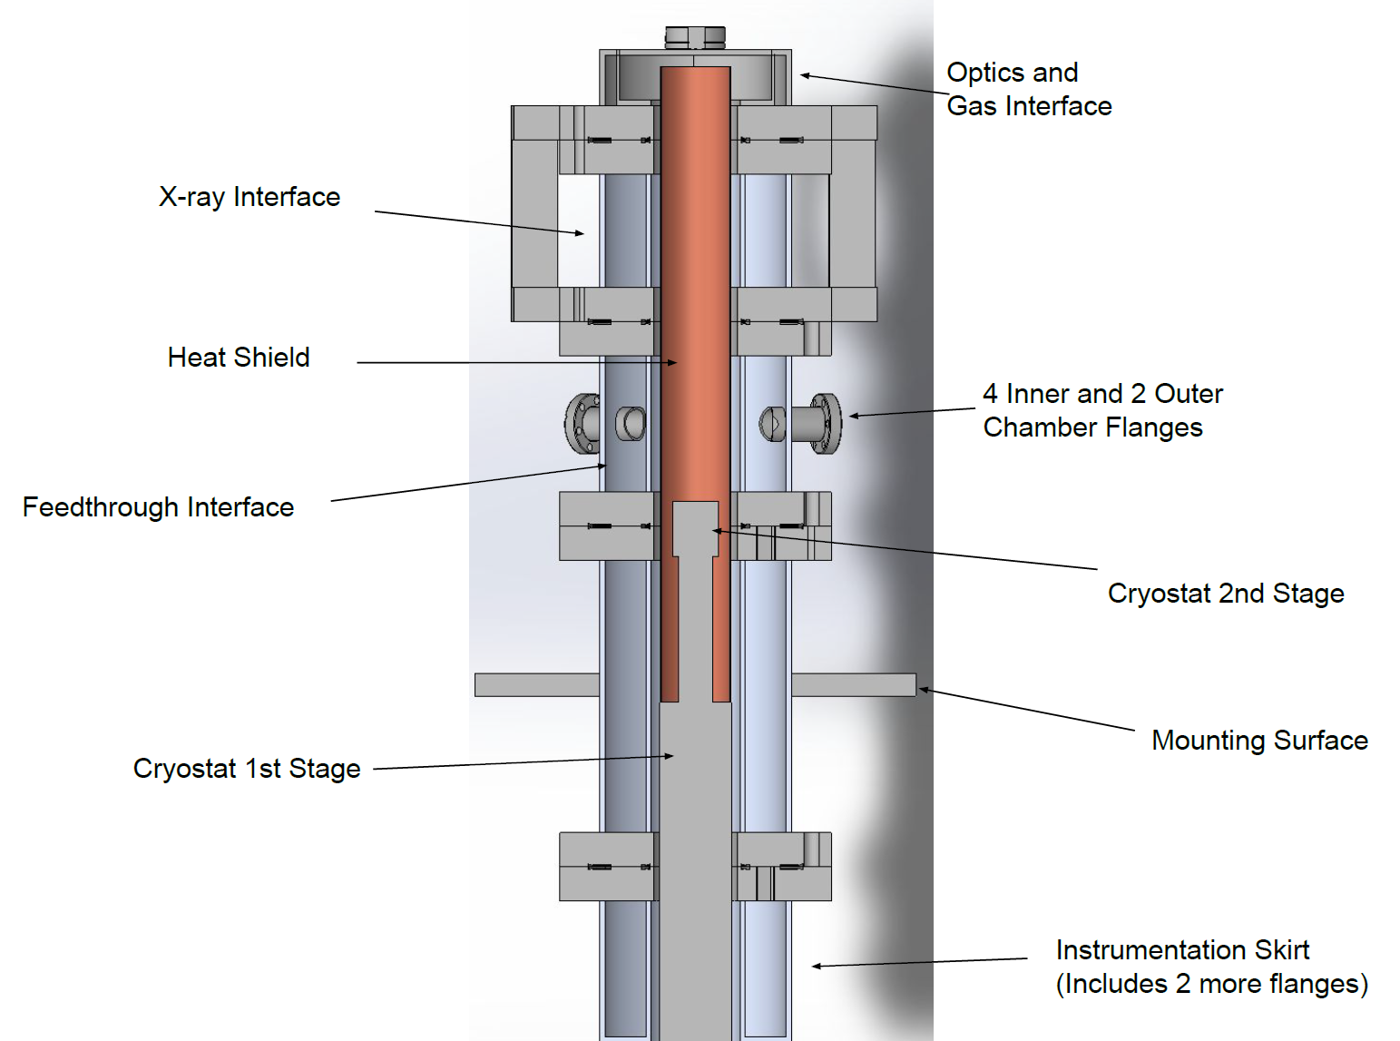
02_Beam_Source_Design/CAD/Crystal_Growth_Chamber/CHEX Aparatus 2/CHEX Appartus 2 Drawings/Screenshot 2024-01-08 161338.png
