cross-isaac/IsaacCross_Senior_Thesis/02_Beam_Source_Design/CAD/Crystal_Growth_Chamber/Local Aparatus Drawings/LA Top Slice.png

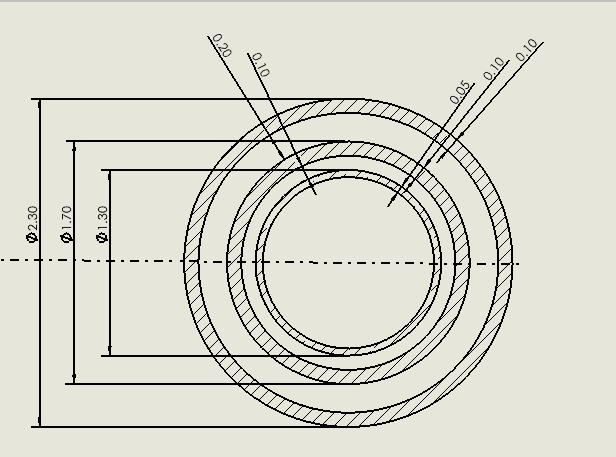
02_Beam_Source_Design/CAD/Crystal_Growth_Chamber/Local Aparatus Drawings/LA Top Slice.png
