cross-isaac/IsaacCross_Senior_Thesis/02_Beam_Source_Design/CAD/Oven_SW_Models/Nozzle/Sketches/ModBlankFront.png

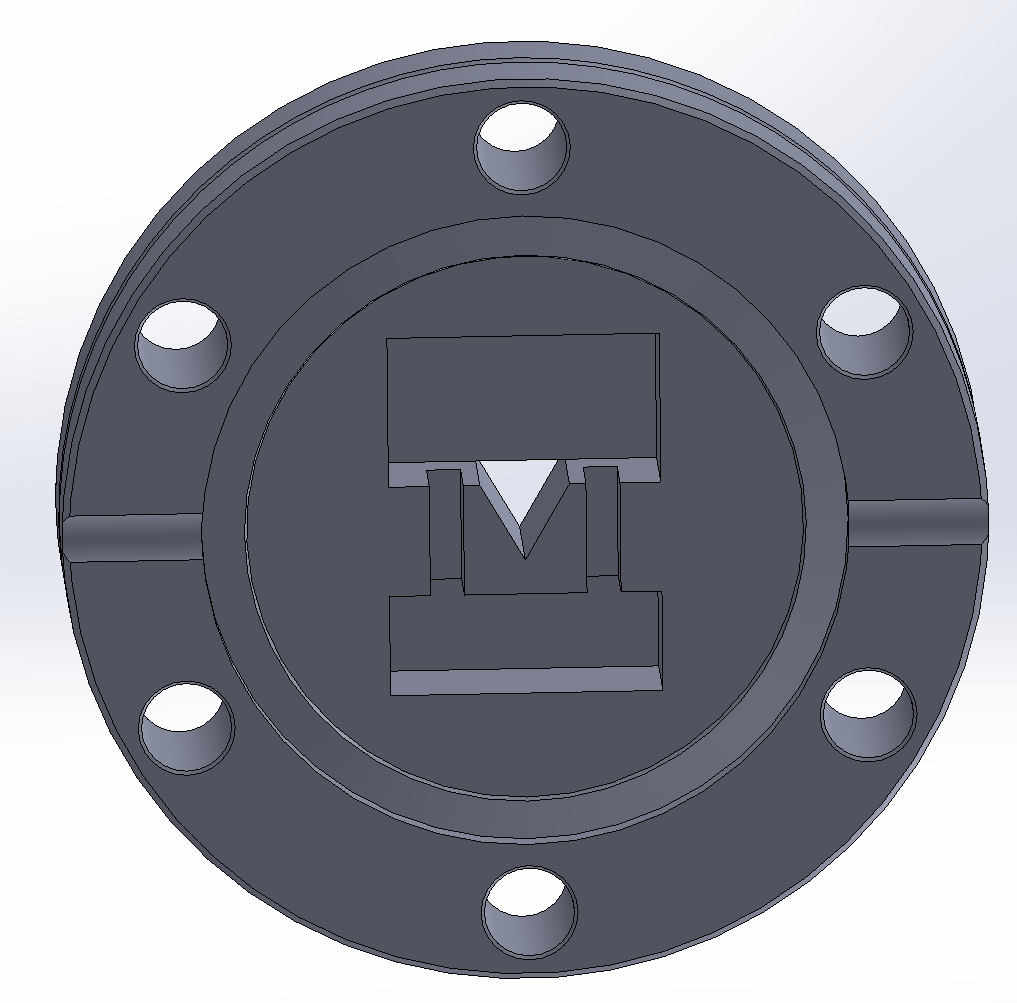
02_Beam_Source_Design/CAD/Oven_SW_Models/Nozzle/Sketches/ModBlankFront.png
