cross-isaac/IsaacCross_Senior_Thesis/02_Beam_Source_Design/TiltTolerances/NozzleTolCalcPic.png

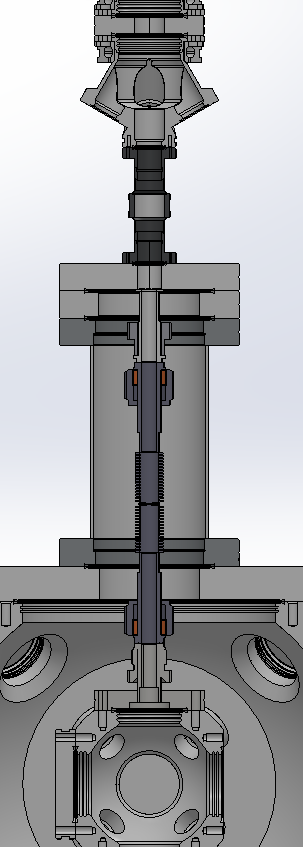
02_Beam_Source_Design/TiltTolerances/NozzleTolCalcPic.png
