cross-isaac/IsaacCross_Senior_Thesis/06_Figures_and_Media/Thesis_Figures/Ch03_Beam Source Design/half_loaded.jpg

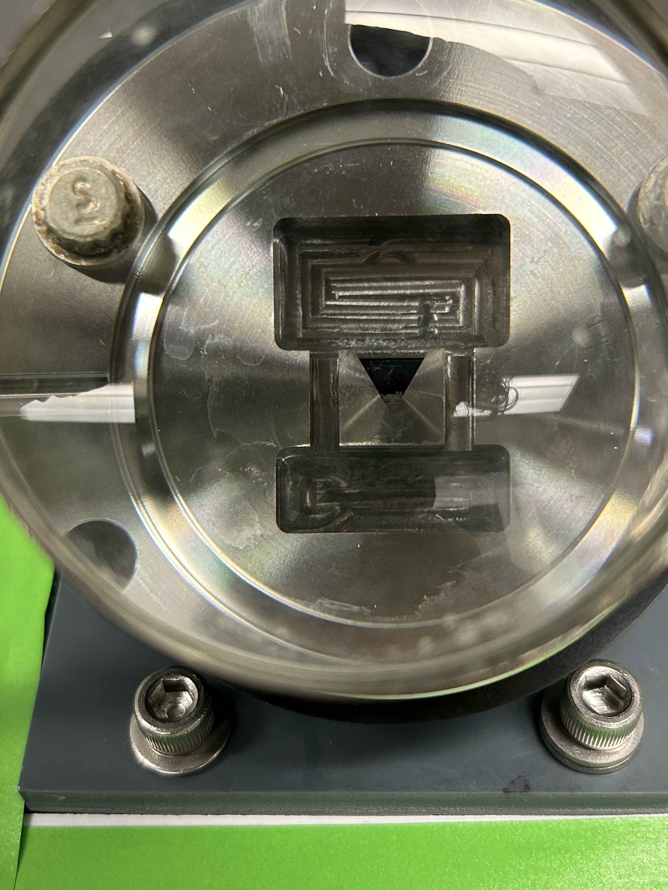
06_Figures_and_Media/Thesis_Figures/Ch03_Beam Source Design/half_loaded.jpg
