cross-isaac/IsaacCross_Senior_Thesis/06_Figures_and_Media/Thesis_Figures/Ch03_Beam Source Design/IMG_7610.jpg

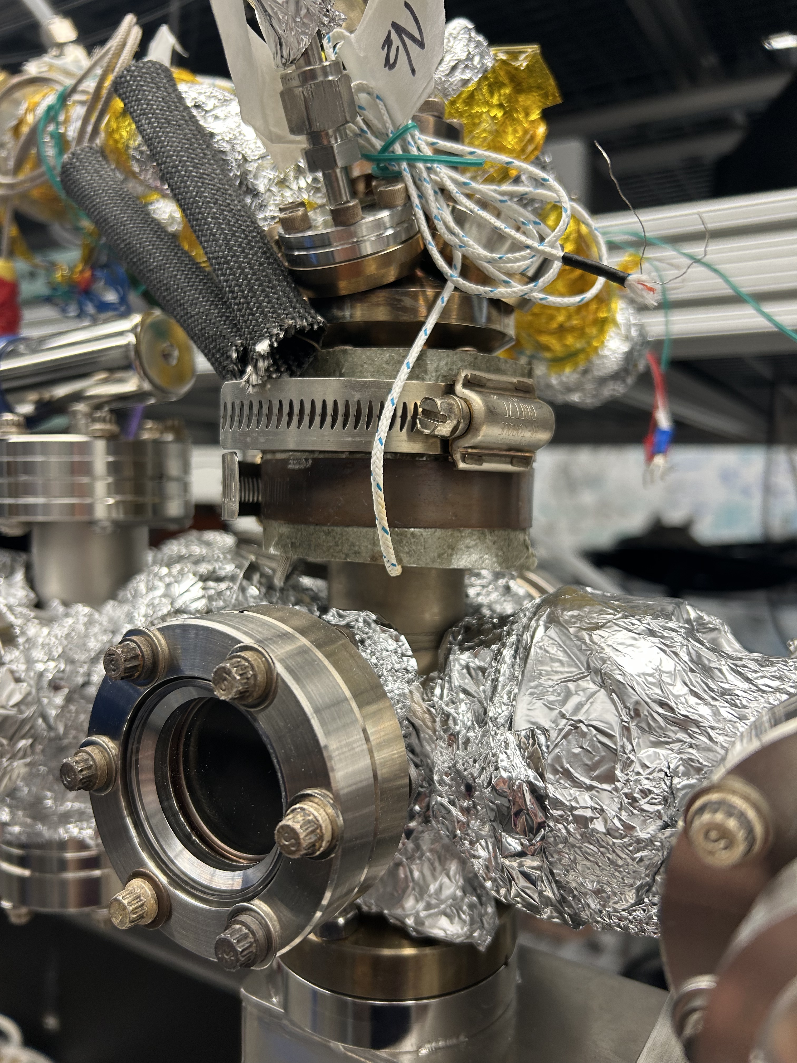
06_Figures_and_Media/Thesis_Figures/Ch03_Beam Source Design/IMG_7610.jpg
