cross-isaac/IsaacCross_Senior_Thesis/06_Figures_and_Media/Thesis_Figures/Ch03_Beam Source Design/IMG_92949DA8-83A5-45BE-927E-CF276A249BD9.JPEG

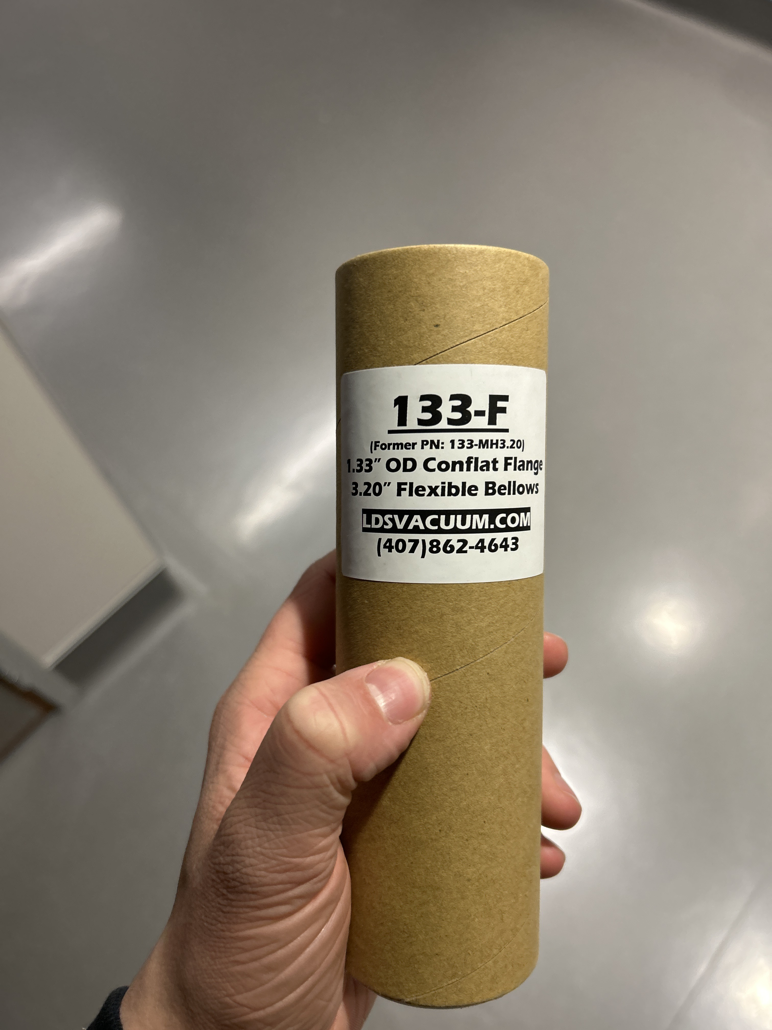
06_Figures_and_Media/Thesis_Figures/Ch03_Beam Source Design/IMG_92949DA8-83A5-45BE-927E-CF276A249BD9.JPEG
