cross-isaac/IsaacCross_Senior_Thesis/06_Figures_and_Media/Thesis_Figures/Ch03_Beam Source Design/Screenshot 2026-04-22 133359.png

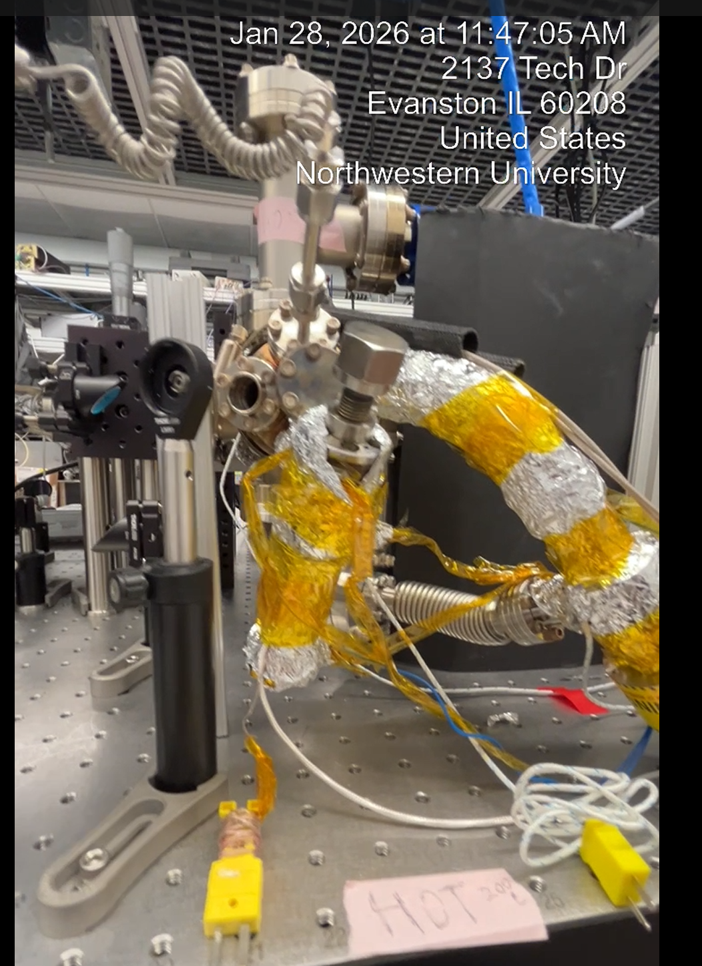
06_Figures_and_Media/Thesis_Figures/Ch03_Beam Source Design/Screenshot 2026-04-22 133359.png
