cross-isaac/IsaacCross_Senior_Thesis/06_Figures_and_Media/Thesis_Figures/Ch04_heater/reservoir_dim.png

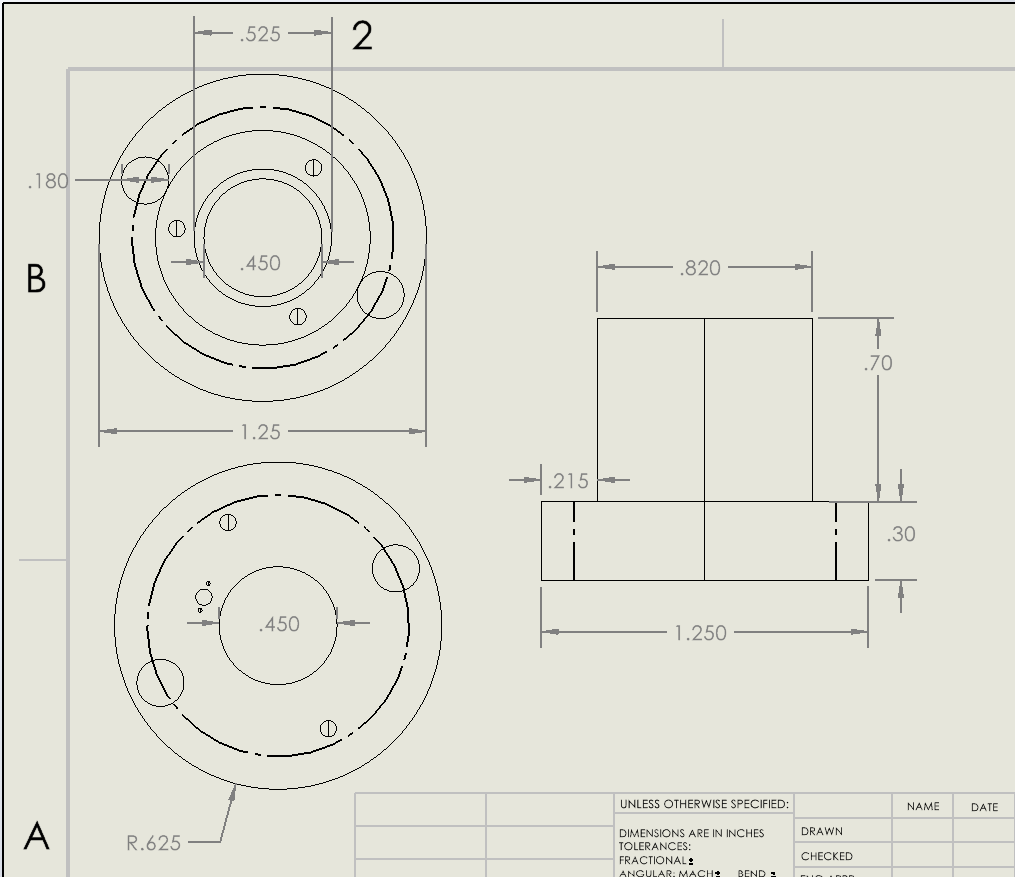
06_Figures_and_Media/Thesis_Figures/Ch04_heater/reservoir_dim.png
