cross-isaac/IsaacCross_Senior_Thesis/06_Figures_and_Media/Thesis_Figures/Ch05_characterization_methods/doppler_broadened_spectrum.png

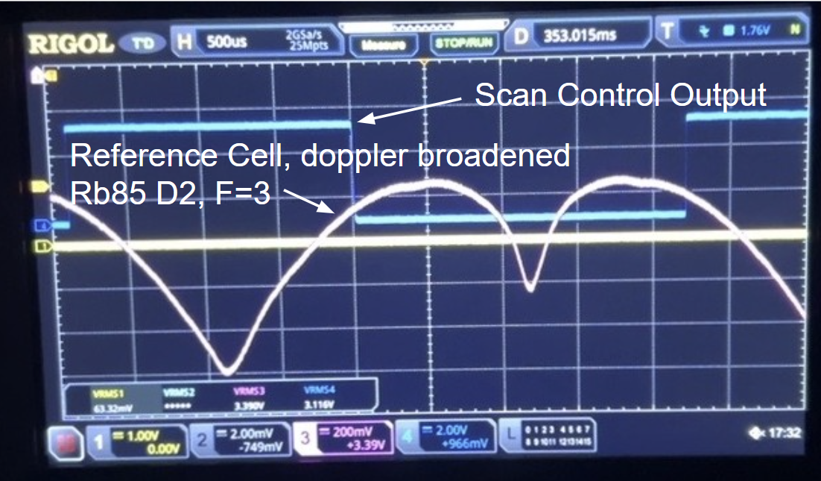
06_Figures_and_Media/Thesis_Figures/Ch05_characterization_methods/doppler_broadened_spectrum.png
