cross-isaac/IsaacCross_Senior_Thesis/06_Figures_and_Media/Thesis_Figures/Ch07_monte_carlo_sim/sim_v_analytic.png

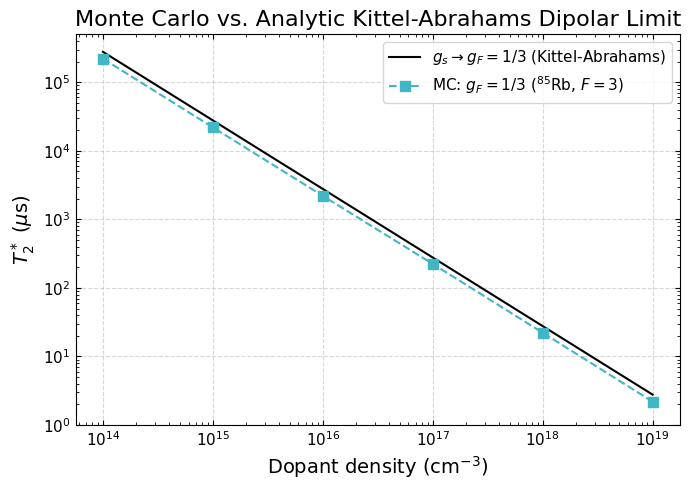
06_Figures_and_Media/Thesis_Figures/Ch07_monte_carlo_sim/sim_v_analytic.png
