cross-isaac/IsaacCross_Senior_Thesis/09_Kovachy_Lab/Referene Cell/Reference Cell/baffle/baffle assembly.SLDASM

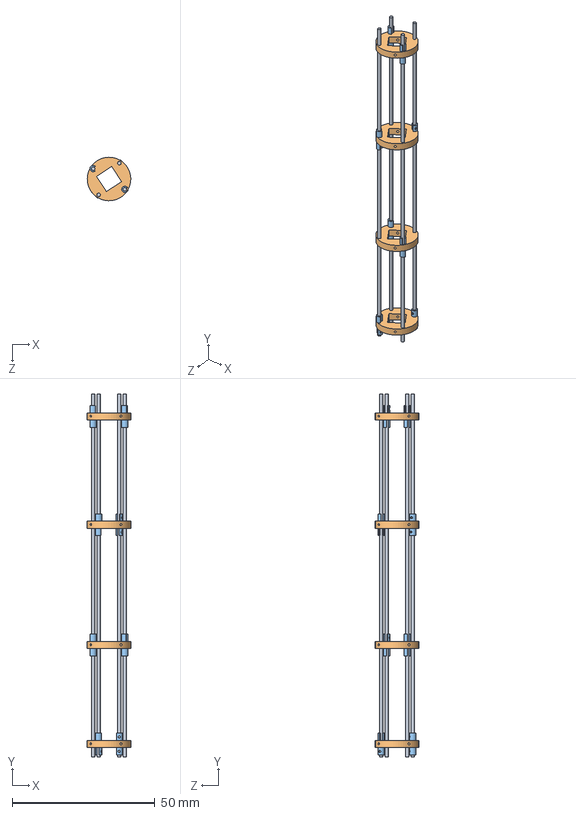
[picture p249: CAD file, 2026-07-06]
09_Kovachy_Lab/Referene Cell/Reference Cell/baffle/baffle assembly.SLDASM
15.2 x 127.0 x 15.2 mm
rod x 4
baffle piece x 4
clamp x 16
