cross-isaac/IsaacCross_Senior_Thesis/02_Beam_Source_Design/CAD/Crystal_Growth_Chamber/CHEX Cryo Chamber/CHEX stuff for Isaac/CHEX stuff for Isaac/CHEX S/CHEX S Full Chamber + Cryo.STEP

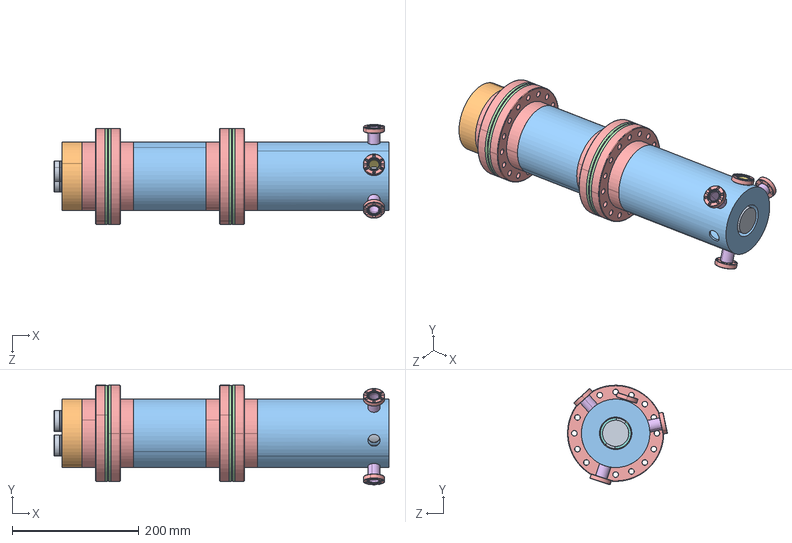
[picture p250: CAD file, 2026-07-06]
02_Beam_Source_Design/CAD/Crystal_Growth_Chamber/CHEX Cryo Chamber/CHEX stuff for Isaac/CHEX stuff for Isaac/CHEX S/CHEX S Full Chamber + Cryo.STEP
528.2 x 157.0 x 157.5 mm
Simple CryoStat
CHEX S Main Chamber
LOS5021049.stp
LOS5021027.stp
CHEX S OGI 1 inner.stp
9110025.stp x 2
CHEX S OGI 1 outer.stp
LOS5021027 x 3
LOS5021049 x 3
Intrsumentation Skirt CHEX S
CHEX S Heat Shield Extender
inner chamber flange pipe draft.stp x 3
longer flange thing draft
