cross-isaac/IsaacCross_Senior_Thesis/09_Kovachy_Lab/Referene Cell/Reference Cell/long 133cf ube.SLDASM

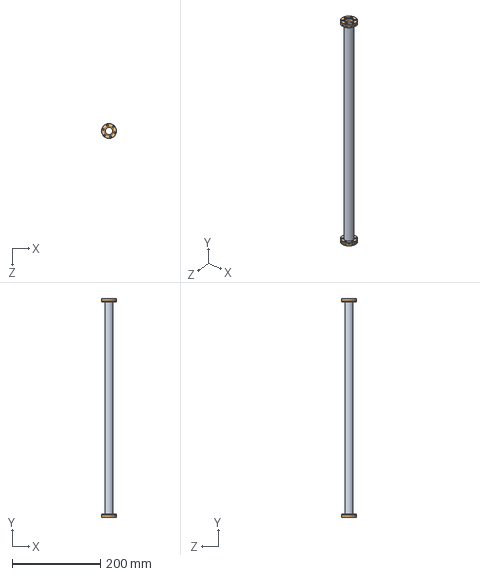
[picture p251: CAD file, 2026-07-06]
09_Kovachy_Lab/Referene Cell/Reference Cell/long 133cf ube.SLDASM
33.8 x 495.5 x 33.8 mm
tube
dff133x062.stp x 2
