cross-isaac/IsaacCross_Senior_Thesis/02_Beam_Source_Design/CAD/Crystal_Growth_Chamber/CHEX Cryo Chamber/CHEX stuff for Isaac/CHEX stuff for Isaac/CHEX S/CHEX S Main Chamber.SLDPRT

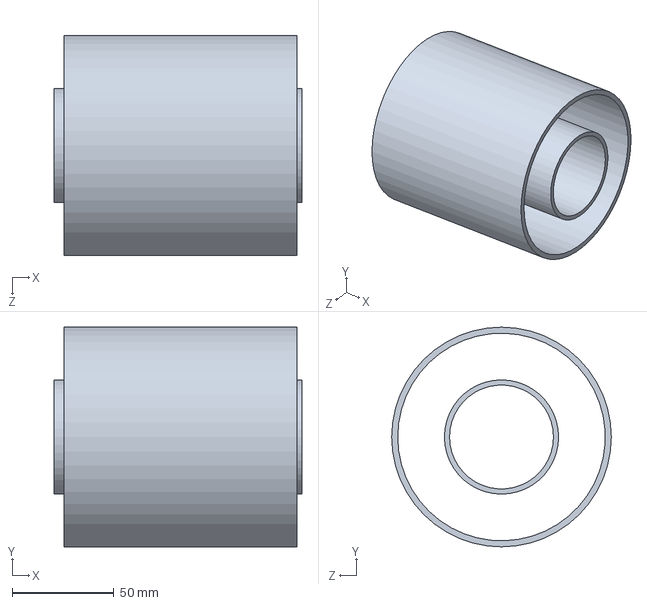
[picture p252: CAD file, 2026-07-06]
02_Beam_Source_Design/CAD/Crystal_Growth_Chamber/CHEX Cryo Chamber/CHEX stuff for Isaac/CHEX stuff for Isaac/CHEX S/CHEX S Main Chamber.SLDPRT
121.9 x 108.0 x 108.0 mm
