cross-isaac/IsaacCross_Senior_Thesis/09_Kovachy_Lab/Referene Cell/Reference Cell/hot window/hot window stack RHD.SLDASM

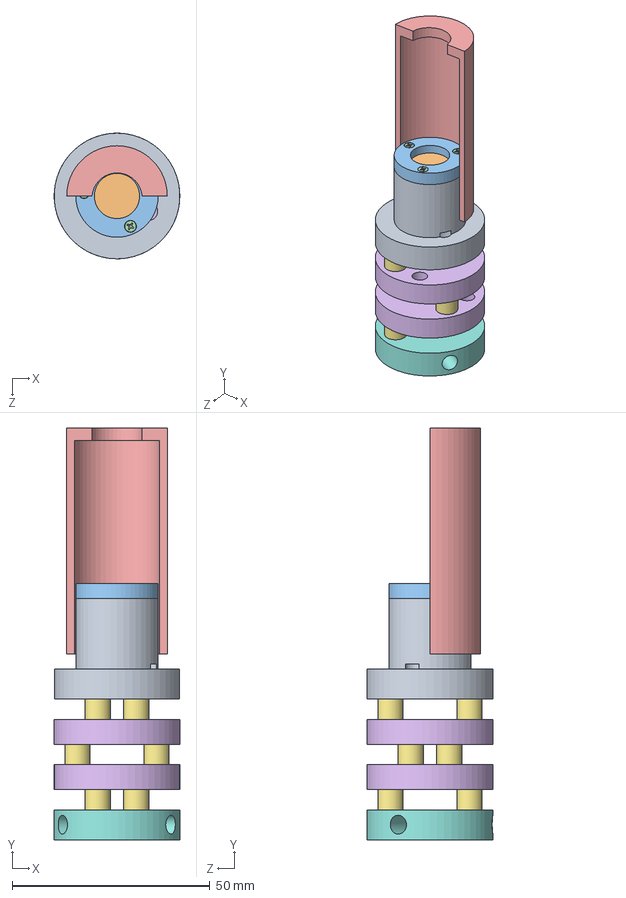
[picture p253: CAD file, 2026-07-06]
09_Kovachy_Lab/Referene Cell/Reference Cell/hot window/hot window stack RHD.SLDASM
31.7 x 104.1 x 31.8 mm
copper base_square
0.5window
window capture ring_RHD
91771A055_Passivated 18-8 Stainless Steel Phillips Flat Head Screw x 3
0.5shield
0.5middleringRHD x 2
spacer x 6
0.5outerringRHD
