cross-isaac/IsaacCross_Senior_Thesis/09_Kovachy_Lab/Strontium Resevoir/Assembled Res 2.0.SLDASM

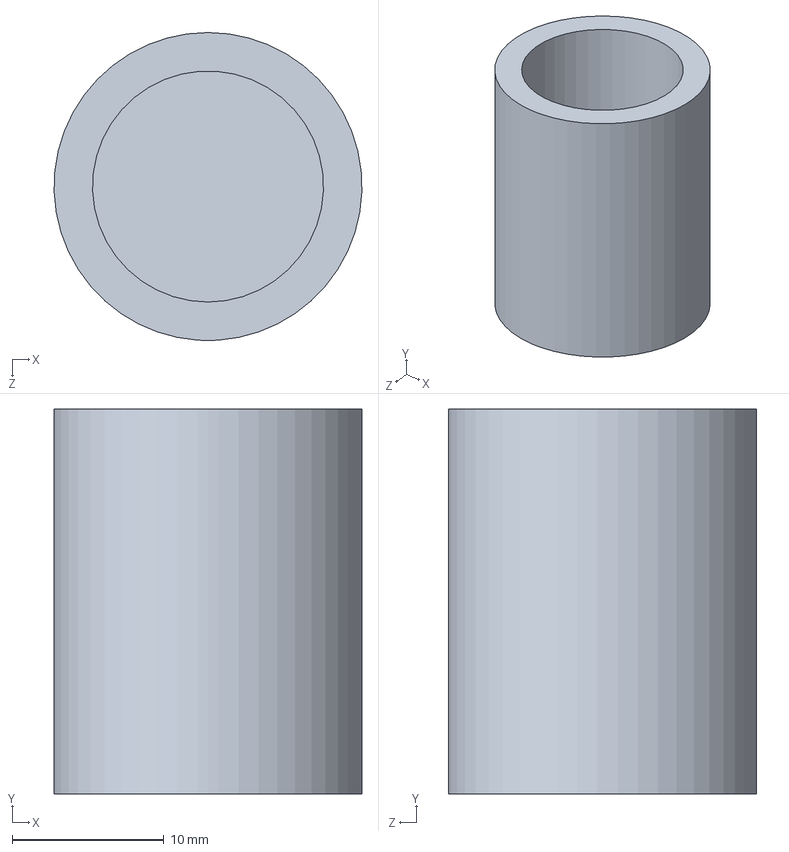
[picture p254: CAD file, 2026-07-06]
09_Kovachy_Lab/Strontium Resevoir/Assembled Res 2.0.SLDASM
20.3 x 25.4 x 20.3 mm
