cross-isaac/IsaacCross_Senior_Thesis/09_Kovachy_Lab/Copper Piece/hot window stack RHDRevC.SLDASM

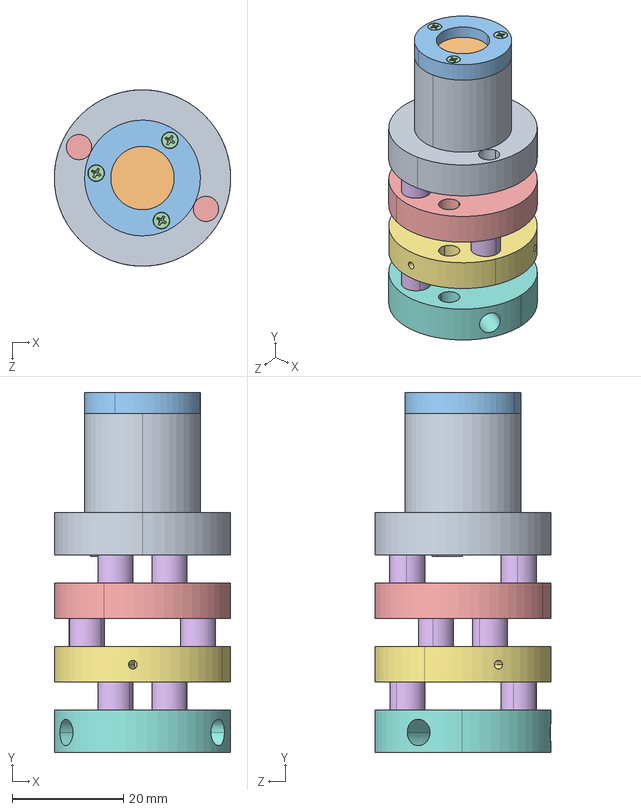
[picture p255: CAD file, 2026-07-06]
09_Kovachy_Lab/Copper Piece/hot window stack RHDRevC.SLDASM
31.7 x 64.8 x 31.8 mm
copper base_square.STEP
0.5window.STEP
window capture ring_RHD.STEP
91771A055_Passivated 18-8 Stainless Steel Phillips Flat Head Screw_91771A055.STEP x 3
0.5middleringRHD.STEP
spacer.STEP x 6
0.5middlemiddleringRHD.STEP
0.5outerringRHD.STEP
TCcapture.STEP
