cross-isaac/IsaacCross_Senior_Thesis/09_Kovachy_Lab/Referene Cell/Reference Cell/hot window/0.5 inch sapph window design/hotwindowstack0.5.SLDASM

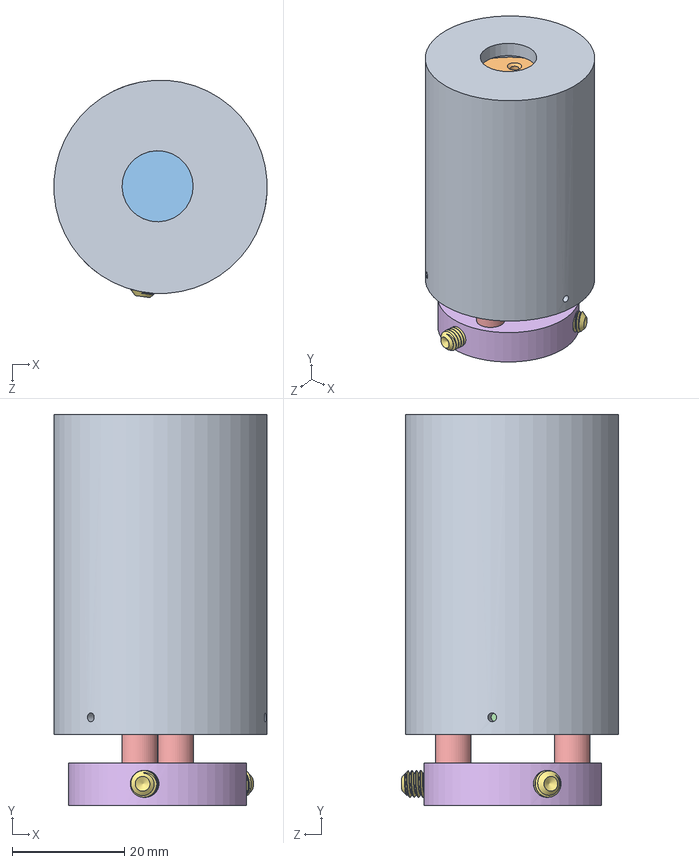
[picture p256: CAD file, 2026-07-06]
09_Kovachy_Lab/Referene Cell/Reference Cell/hot window/0.5 inch sapph window design/hotwindowstack0.5.SLDASM
38.0 x 69.8 x 38.8 mm
0.5copperbase
0.5window
0.5middlering x 2
spacer x 6
0.5outerring
0.5shield
92311A426_18-8 Stainless Steel Cup-Point Set Screw x 3
