cross-isaac/IsaacCross_Senior_Thesis/02_Beam_Source_Design/CAD/Crystal_Growth_Chamber/CHEX Cryo Chamber/CHEX stuff for Isaac/CHEX stuff for Isaac/CHEX L/CHEX L Full Chamber + Cryo.STEP

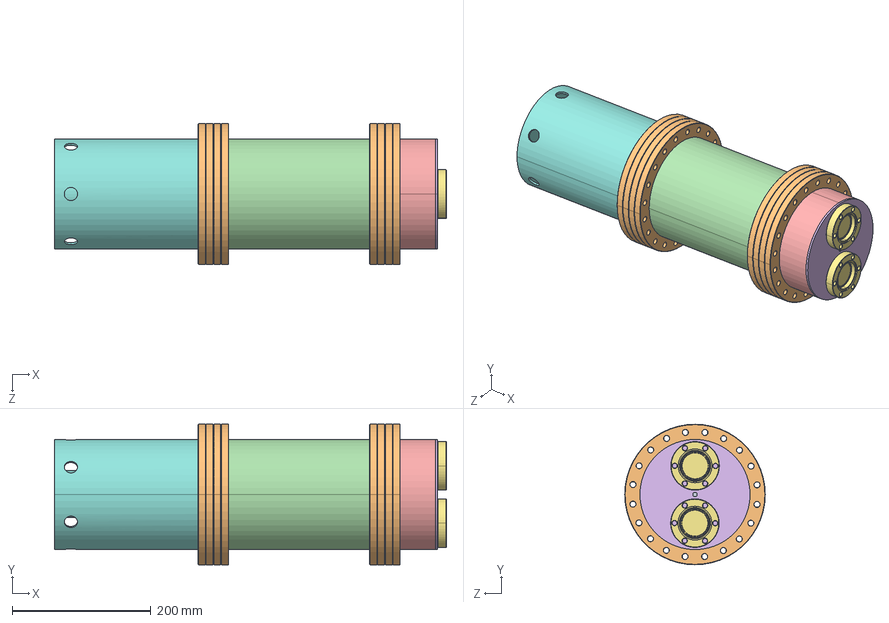
[picture p257: CAD file, 2026-07-06]
02_Beam_Source_Design/CAD/Crystal_Growth_Chamber/CHEX Cryo Chamber/CHEX stuff for Isaac/CHEX stuff for Isaac/CHEX L/CHEX L Full Chamber + Cryo.STEP
564.9 x 202.5 x 202.5 mm
5004103a x 3
5004149a x 3
CHEX L Main Chamber
5004149.stp
5004103.stp
L OGI outer 1.stp
L OGI Inner.stp
9110027.stp x 2
Intrsumentation Skirt CHEX L
Simple CryoStat
CHEX L Heat Shield
