cross-isaac/IsaacCross_Senior_Thesis/09_Kovachy_Lab/Optics Board/Optics Board Simple.SLDASM

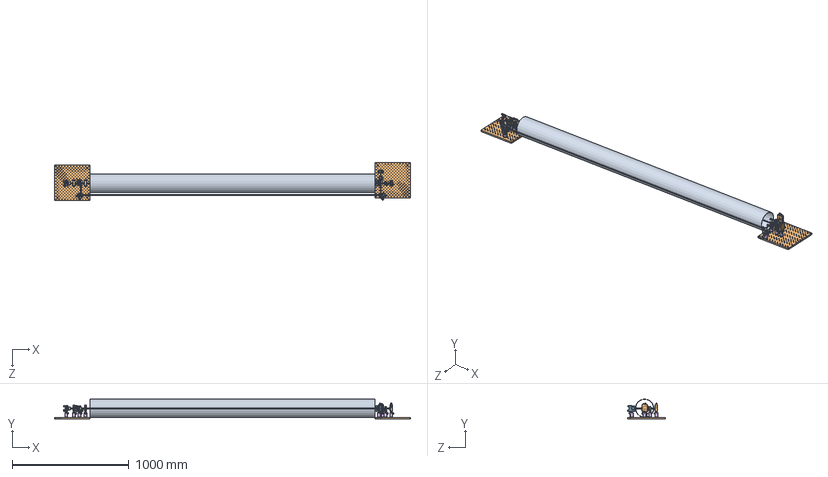
[picture p258: CAD file, 2026-07-06]
09_Kovachy_Lab/Optics Board/Optics Board Simple.SLDASM
3047.4 x 170.2 x 327.6 mm
MB12D-Solidworks x 2
WPH05M-694-Solidworks x 2
BE1-Solidworks x 11
TR1.5-Solidworks x 11
PH1.5-Solidworks x 11
RSP1-Solidworks x 2
PM3-Solidworks x 2
KM100PM-Solidworks x 2
PBS122-Solidworks x 2
KS1CE-Solidworks x 2
PF10-03-G01-Solidworks x 2
F810APC-635-Solidworks
KM100-Solidworks (2)
AD15NT-Solidworks
LBF254-040-Solidworks x 2
LMR1-Solidworks (1) x 2
PDA8A2-Solidworks x 2
Thick Laser 2.1
