cross-isaac/IsaacCross_Senior_Thesis/02_Beam_Source_Design/CAD/Crystal_Growth_Chamber/CHEX Cryo Chamber/CHEX stuff for Isaac/CHEX stuff for Isaac/CHEX L/CHEX L Main Chamber.SLDPRT

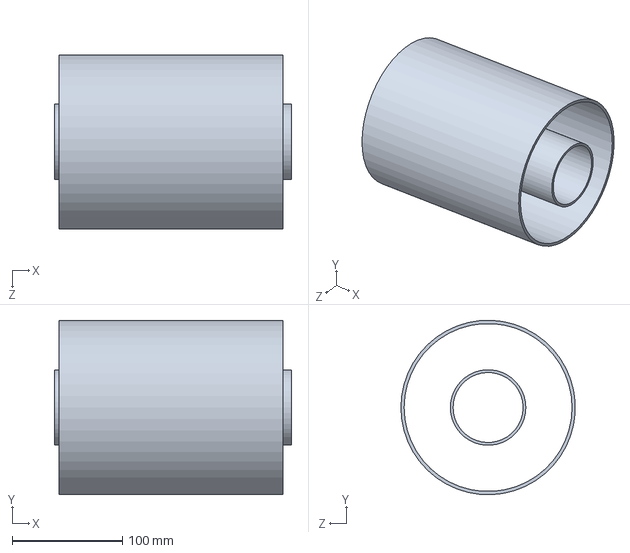
[picture p259: CAD file, 2026-07-06]
02_Beam_Source_Design/CAD/Crystal_Growth_Chamber/CHEX Cryo Chamber/CHEX stuff for Isaac/CHEX stuff for Isaac/CHEX L/CHEX L Main Chamber.SLDPRT
215.1 x 158.3 x 158.2 mm
