cross-isaac/IsaacCross_Senior_Thesis/09_Kovachy_Lab/Copper Piece/Copper Piece.SLDASM

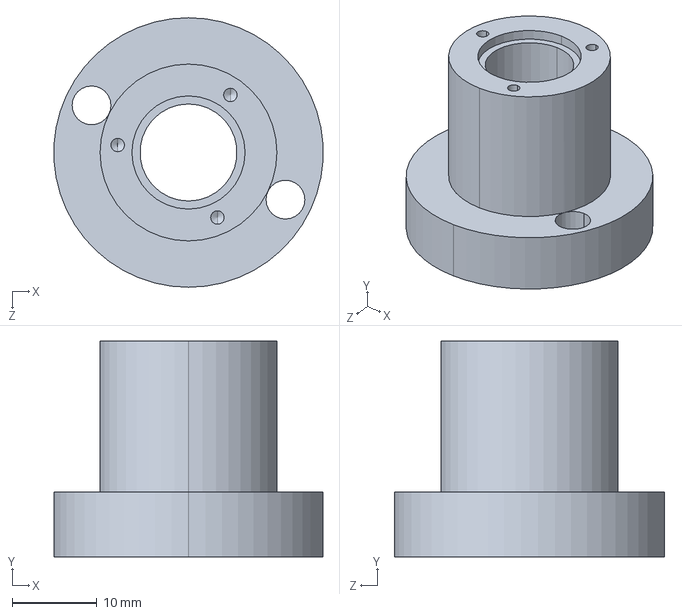
[picture p260: CAD file, 2026-07-06]
09_Kovachy_Lab/Copper Piece/Copper Piece.SLDASM
31.7 x 25.4 x 31.8 mm
