cross-isaac/IsaacCross_Senior_Thesis/09_Kovachy_Lab/Strontium Resevoir/_gold_evaporator (1).SLDASM

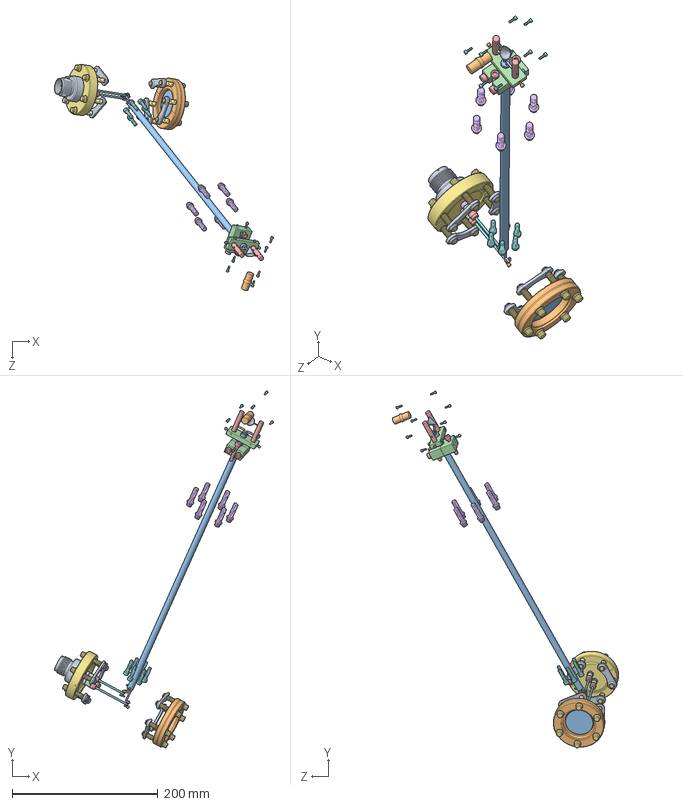
[picture p261: CAD file, 2026-07-06]
09_Kovachy_Lab/Strontium Resevoir/_gold_evaporator (1).SLDASM
300.5 x 489.7 x 310.2 mm
Filament
Sample Holder
New Double Bore Ceramic Insulator
Supporter Filament-Wire Ceramic Base
Supporter Wire-Filament Copper Pillar x 2
New Wire Long
New Wire Short
98511A111_LIGHTWEIGHT ALUMINUM SOCKET HEAD CAP SCREW x 8
92313A013_TYPE 316 SS CUP POINT SET SCREW x 10
98511A111_LIGHTWEIGHT ALUMINUM SOCKET HEAD CAP SCREW same x 4
92185A083_TYPE 316 SS SOCKET HEAD CAP SCREW x 2
New Sandwich Collar
92185A992_TYPE 316 SS SOCKET HEAD CAP SCREW x 4
0.875_91271A573_STEEL 12-POINT FLANGE HEAD CAP SCREW x 6
91271A573_STEEL 12-POINT FLANGE HEAD CAP SCREW x 12
92185A197_TYPE 316 SS SOCKET HEAD CAP SCREW x 6
platenut_CFF2.75_0.25_inch x 6
VPZL-275_FLANGE
VPZL-275_INNER
0012601K x 2
0010302U x 2
0010401S x 2
0337203A
0095104B x 2
0337402A
