cross-isaac/IsaacCross_Senior_Thesis/09_Kovachy_Lab/Referene Cell/Reference Cell/modifiedCFflange.SLDASM

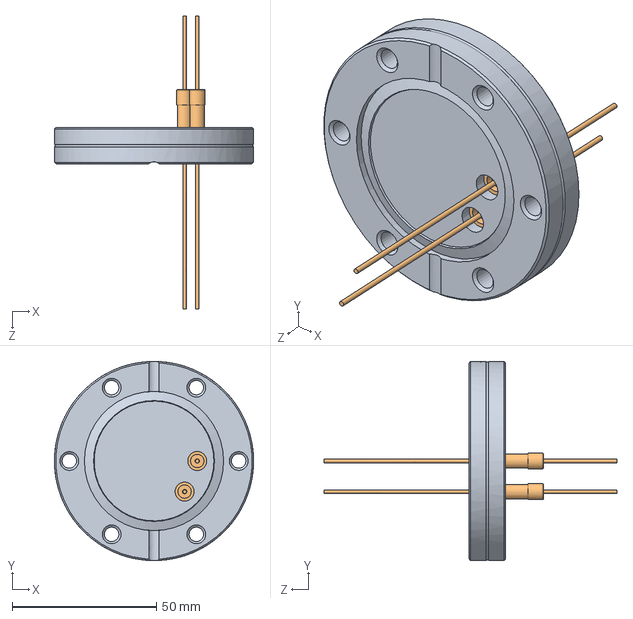
[picture p262: CAD file, 2026-07-06]
09_Kovachy_Lab/Referene Cell/Reference Cell/modifiedCFflange.SLDASM
69.1 x 69.1 x 101.6 mm
f0275x000_modified
P108041 x 2
