cross-isaac/IsaacCross_Senior_Thesis/02_Beam_Source_Design/CAD/Crystal_Growth_Chamber/Chambes Side by Side.STEP

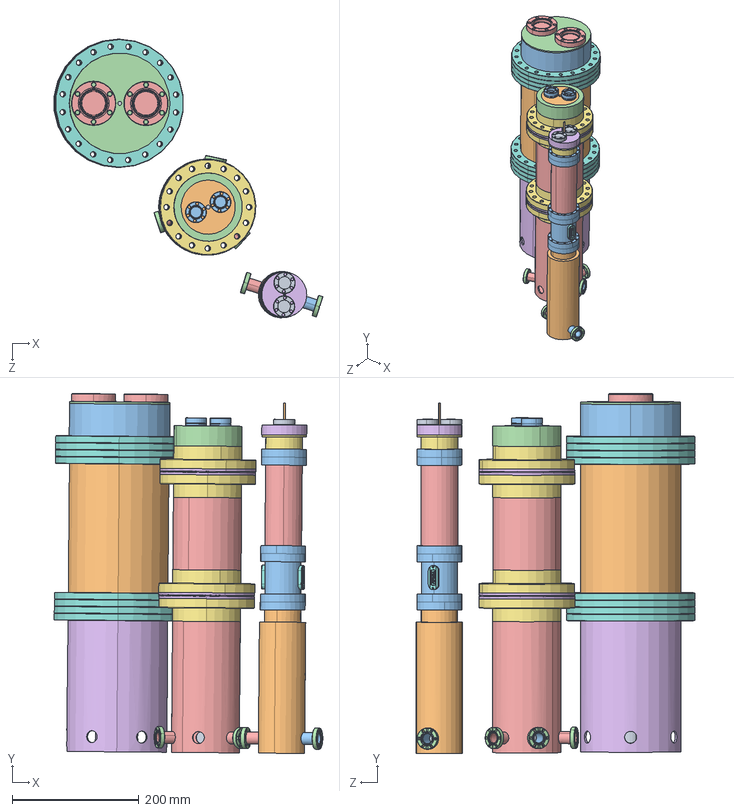
[picture p263: CAD file, 2026-07-06]
02_Beam_Source_Design/CAD/Crystal_Growth_Chamber/Chambes Side by Side.STEP
424.0 x 568.1 x 439.7 mm
Simple CryoStat x 3
Intrsumentation Skirt 1.0
double knife edge flange (1) x 5
outer chamber flange pipe draft.stp
Heat Shield Extender
Heat Shield
9218-D9-37-SS_15 pin 1mm.stp x 2
9210-PIN-FENI.stp x 30
electronics skirt walls.stp
Simplified Chamber
Top plate_1.stp
double knife edge flange_1.stp
outer wall nipple_1.stp
inner wall nipple_1.stp
A1671_1.stp x 2
straw_1.stp
longer flange thing draft x 2
CHEX S Main Chamber
LOS5021049.stp
LOS5021027.stp
CHEX S OGI 1 inner.stp
9110025.stp x 2
CHEX S OGI 1 outer.stp
LOS5021027 x 3
LOS5021049 x 3
Intrsumentation Skirt CHEX S
CHEX S Heat Shield Extender
inner chamber flange pipe draft.stp x 3
5004103a x 3
5004149a x 3
CHEX L Main Chamber
5004149.stp
5004103.stp
L OGI outer 1.stp
L OGI Inner.stp
9110027.stp x 2
Intrsumentation Skirt CHEX L
CHEX L Heat Shield
