cross-isaac/IsaacCross_Senior_Thesis/02_Beam_Source_Design/CAD/Crystal_Growth_Chamber/CHEX Aparatus 2/apparatus 2.stp

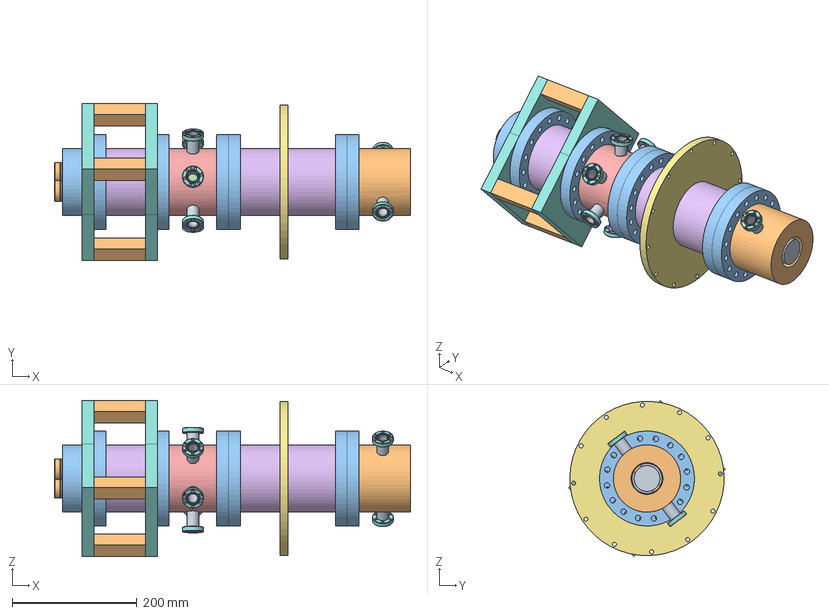
[picture p264: CAD file, 2026-07-06]
02_Beam_Source_Design/CAD/Crystal_Growth_Chamber/CHEX Aparatus 2/apparatus 2.stp
571.5 x 252.3 x 250.5 mm
Simple CryoStat
instrumentation skirt a2
SChex dkl 1 x 8
feedthru int a2
al portion 1
CHEX S OGI 1 inner
CHEX S OGI 1 outer
rough heat shield
extender wall
mounting plate
longer flange thing draft x 8
8020 standin x 4
