cross-isaac/IsaacCross_Senior_Thesis/02_Beam_Source_Design/CAD/Crystal_Growth_Chamber/CHEX Aparatus 2/Feedthru int for IC (1)/Inner Feedthrough Chamber.SLDPRT

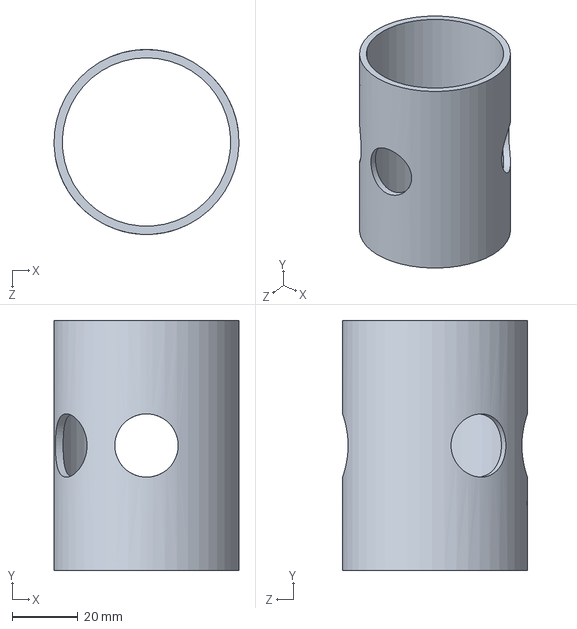
[picture p265: CAD file, 2026-07-06]
02_Beam_Source_Design/CAD/Crystal_Growth_Chamber/CHEX Aparatus 2/Feedthru int for IC (1)/Inner Feedthrough Chamber.SLDPRT
56.4 x 76.2 x 56.4 mm
