cross-isaac/IsaacCross_Senior_Thesis/02_Beam_Source_Design/CAD/Crystal_Growth_Chamber/CHEX Cryo Chamber/CHEX stuff for Isaac/CHEX stuff for Isaac/CHEX S/CHEX S Heat Shield Extender.SLDPRT

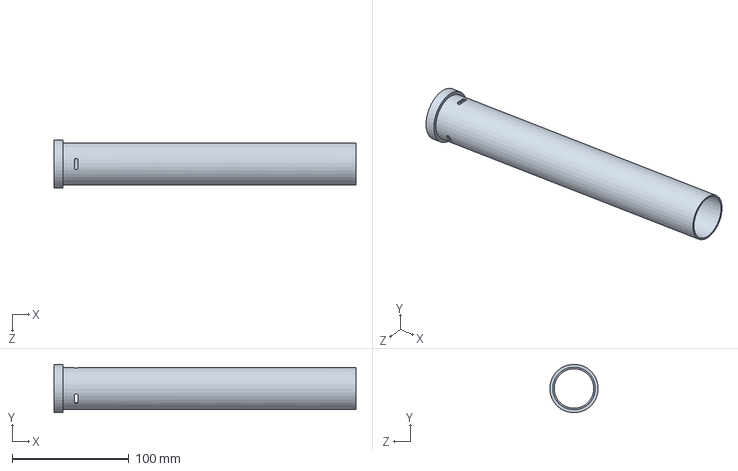
[picture p266: CAD file, 2026-07-06]
02_Beam_Source_Design/CAD/Crystal_Growth_Chamber/CHEX Cryo Chamber/CHEX stuff for Isaac/CHEX stuff for Isaac/CHEX S/CHEX S Heat Shield Extender.SLDPRT
258.3 x 41.3 x 41.4 mm
