cross-isaac/IsaacCross_Senior_Thesis/02_Beam_Source_Design/CAD/Crystal_Growth_Chamber/Cryo Skirt/double knife edge flange (1).stp

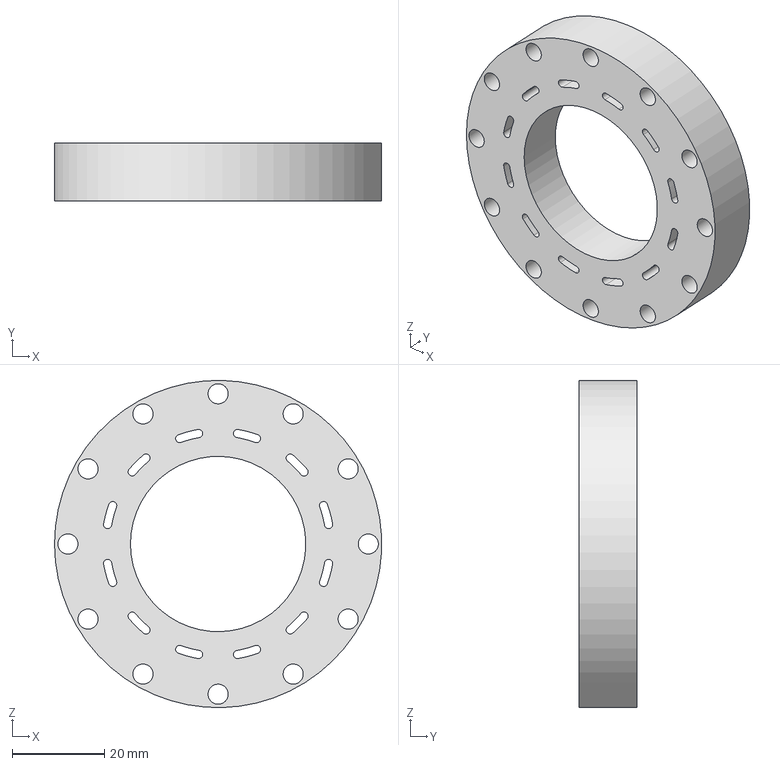
[picture p267: CAD file, 2026-07-06]
02_Beam_Source_Design/CAD/Crystal_Growth_Chamber/Cryo Skirt/double knife edge flange (1).stp
71.1 x 12.7 x 71.1 mm
