cross-isaac/IsaacCross_Senior_Thesis/02_Beam_Source_Design/CAD/Crystal_Growth_Chamber/Local Chamber/Intrsumentation Skirt 1.0.STEP

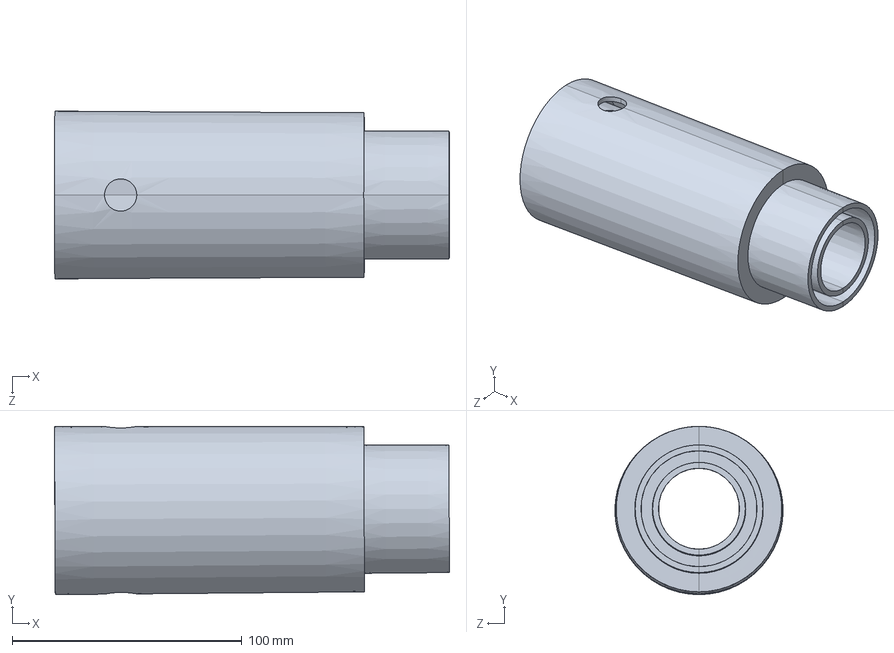
[picture p268: CAD file, 2026-07-06]
02_Beam_Source_Design/CAD/Crystal_Growth_Chamber/Local Chamber/Intrsumentation Skirt 1.0.STEP
171.9 x 73.3 x 73.3 mm
