cross-isaac/IsaacCross_Senior_Thesis/02_Beam_Source_Design/CAD/Oven_SW_Models/Nozzle/NozzleClamp.SLDPRT

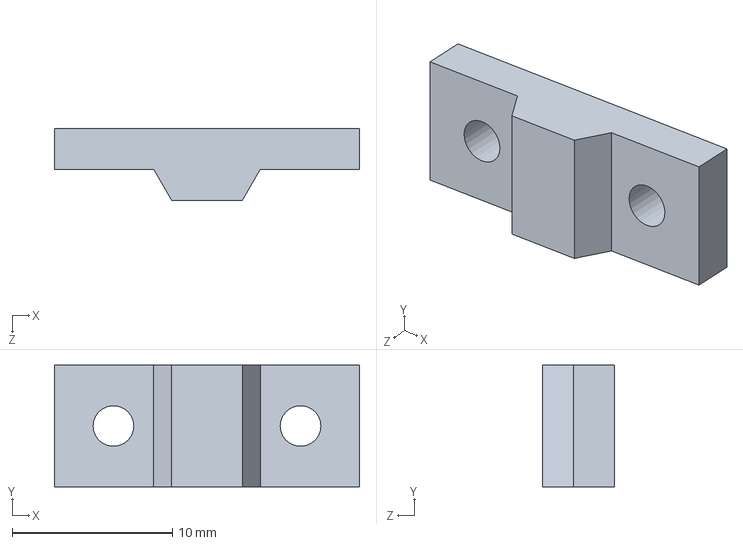
[picture p269: CAD file, 2026-07-06]
02_Beam_Source_Design/CAD/Oven_SW_Models/Nozzle/NozzleClamp.SLDPRT
19.1 x 7.62 x 4.48 mm
