cross-isaac/IsaacCross_Senior_Thesis/09_Kovachy_Lab/Copper Piece/2.0/0.5outerringRHD 2.0.SLDPRT

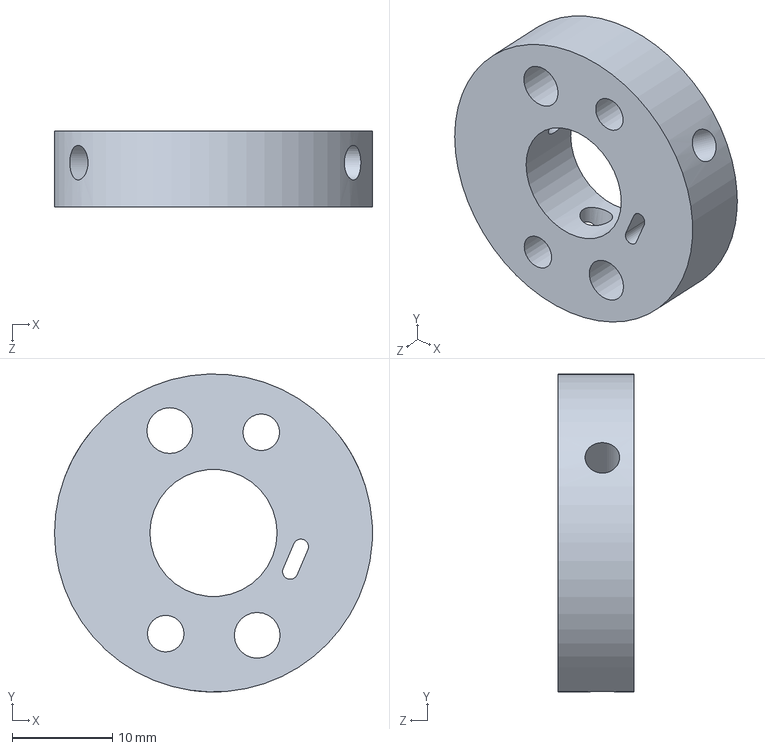
[picture p271: CAD file, 2026-07-06]
09_Kovachy_Lab/Copper Piece/2.0/0.5outerringRHD 2.0.SLDPRT
31.8 x 31.7 x 7.62 mm
