cross-isaac/IsaacCross_Senior_Thesis/09_Kovachy_Lab/Optics Board/Mounts/RSP1-Solidworks.sldprt

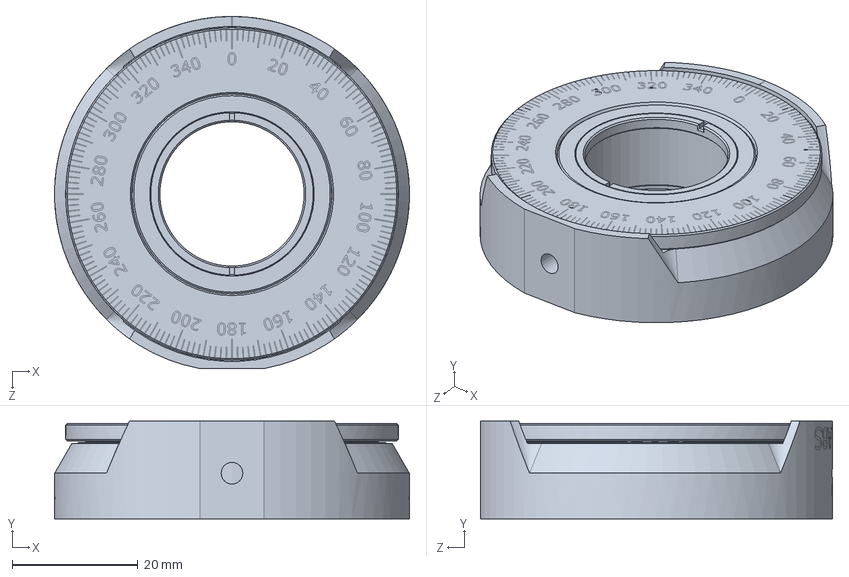
[picture p272: CAD file, 2026-07-06]
09_Kovachy_Lab/Optics Board/Mounts/RSP1-Solidworks.sldprt
56.4 x 15.5 x 55.9 mm
