cross-isaac/IsaacCross_Senior_Thesis/09_Kovachy_Lab/Optics Board/Optics Board Simple Laser.SLDPRT

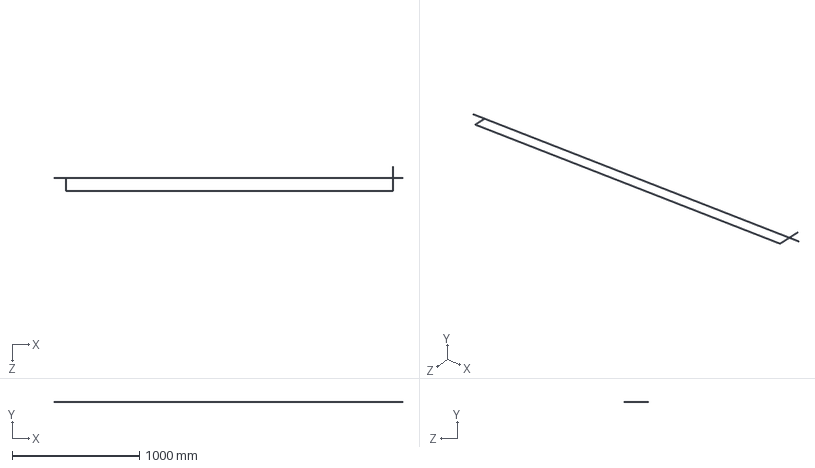
[picture p273: CAD file, 2026-07-06]
09_Kovachy_Lab/Optics Board/Optics Board Simple Laser.SLDPRT
2739.4 x 6.71 x 193.1 mm
