cross-isaac/IsaacCross_Senior_Thesis/09_Kovachy_Lab/Optics Board/Optics/PF10-03-G01-Solidworks.sldprt

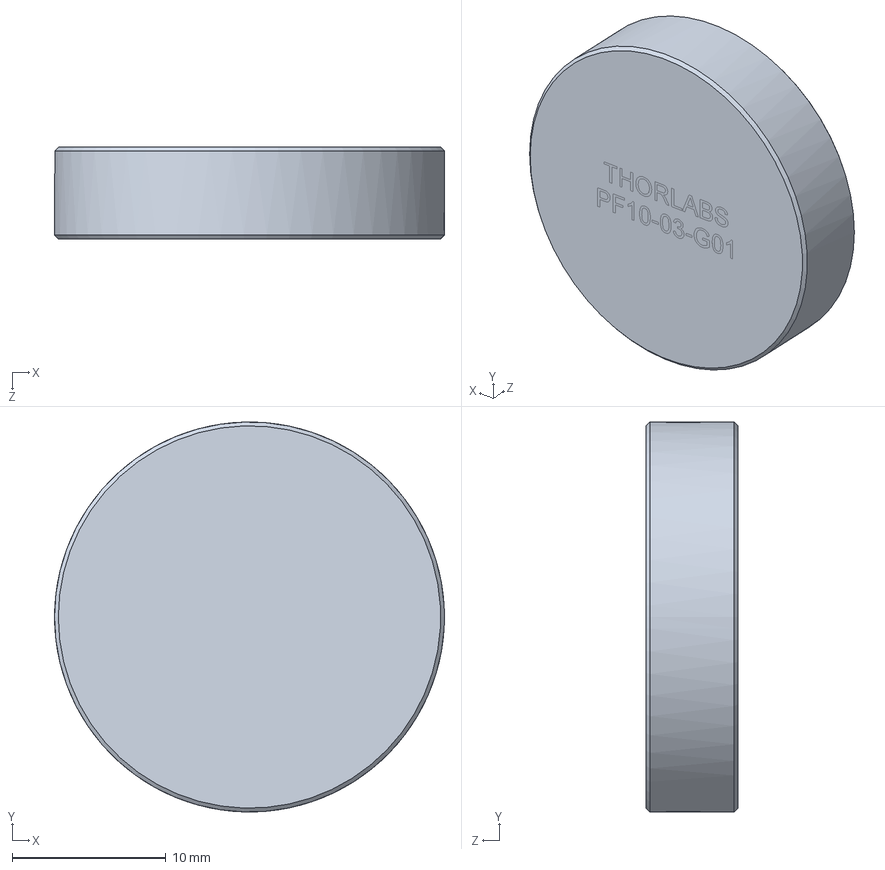
[picture p274: CAD file, 2026-07-06]
09_Kovachy_Lab/Optics Board/Optics/PF10-03-G01-Solidworks.sldprt
25.4 x 25.4 x 6.00 mm
