cross-isaac/IsaacCross_Senior_Thesis/09_Kovachy_Lab/Referene Cell/Reference Cell/hot window/0.5 inch sapph window design/0.5window.SLDPRT

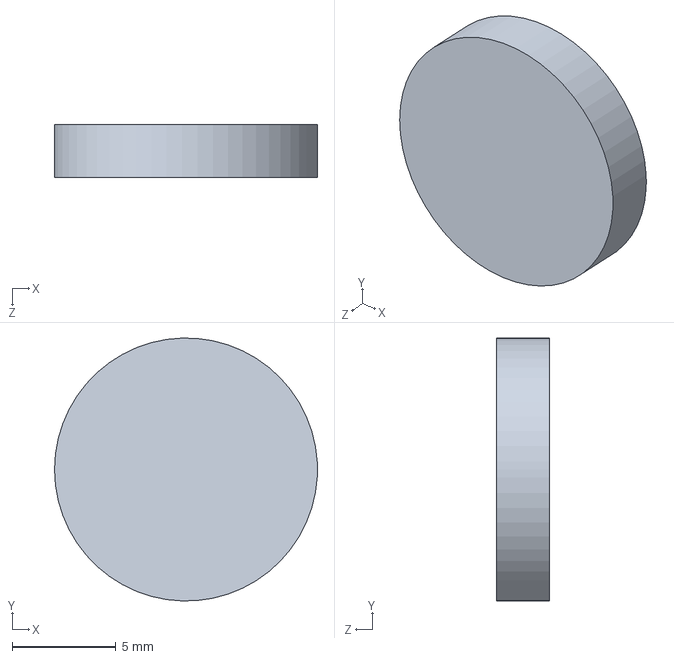
[picture p275: CAD file, 2026-07-06]
09_Kovachy_Lab/Referene Cell/Reference Cell/hot window/0.5 inch sapph window design/0.5window.SLDPRT
12.7 x 12.7 x 2.54 mm
