cross-isaac/IsaacCross_Senior_Thesis/09_Kovachy_Lab/Referene Cell/Reference Cell/hot window/0.5 inch sapph window resistive heater design/hot window stack RHDRevC.STEP

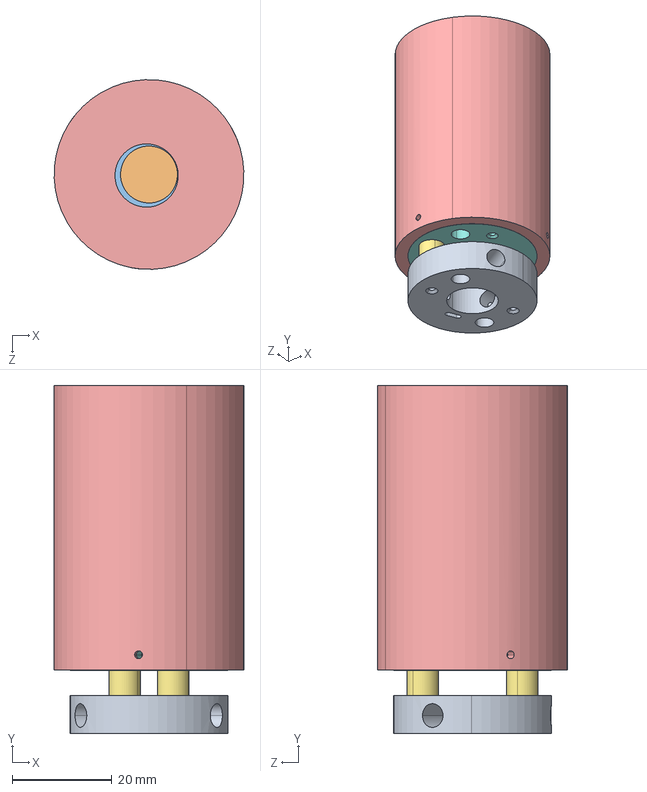
[picture p276: CAD file, 2026-07-06]
09_Kovachy_Lab/Referene Cell/Reference Cell/hot window/0.5 inch sapph window resistive heater design/hot window stack RHDRevC.STEP
38.1 x 69.9 x 38.1 mm
copper base_square
0.5window
window capture ring_RHD
91771A055_Passivated 18-8 Stainless Steel Phillips Flat Head Screw_91771A055 x 3
0.5shield
0.5middleringRHD
spacer x 6
0.5middlemiddleringRHD
0.5outerringRHD
TCcapture
