cross-isaac/IsaacCross_Senior_Thesis/09_Kovachy_Lab/Referene Cell/Reference Cell/hot window/hot window/spacer.SLDPRT

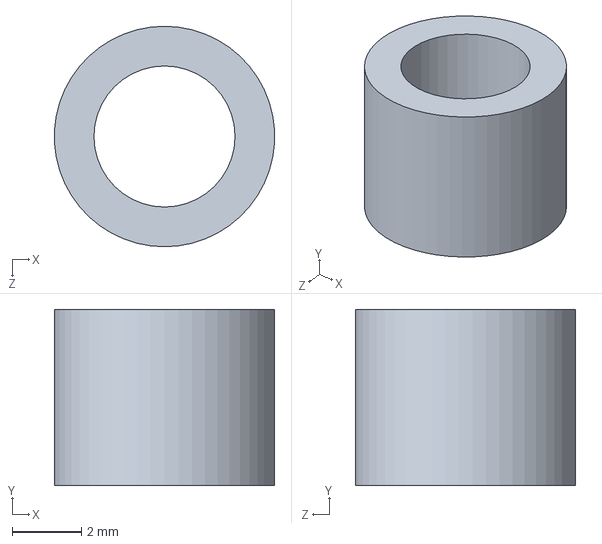
[picture p277: CAD file, 2026-07-06]
09_Kovachy_Lab/Referene Cell/Reference Cell/hot window/hot window/spacer.SLDPRT
6.34 x 5.08 x 6.35 mm
