cross-isaac/IsaacCross_Senior_Thesis/09_Kovachy_Lab/Referene Cell/Reference Cell/long cf nipple/tube.SLDPRT

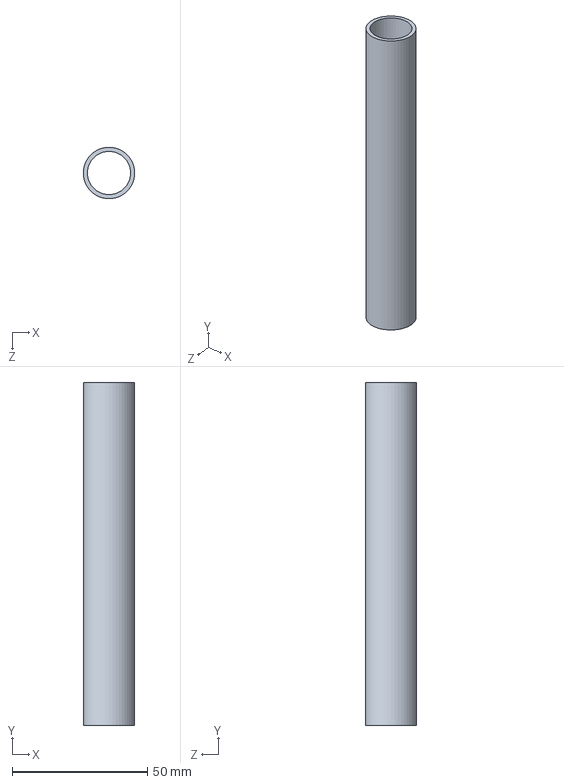
[picture p278: CAD file, 2026-07-06]
09_Kovachy_Lab/Referene Cell/Reference Cell/long cf nipple/tube.SLDPRT
19.1 x 127.0 x 19.1 mm
