cross-isaac/IsaacCross_Senior_Thesis/09_Kovachy_Lab/Referene Cell/Reference Cell/rf337x275t.stp

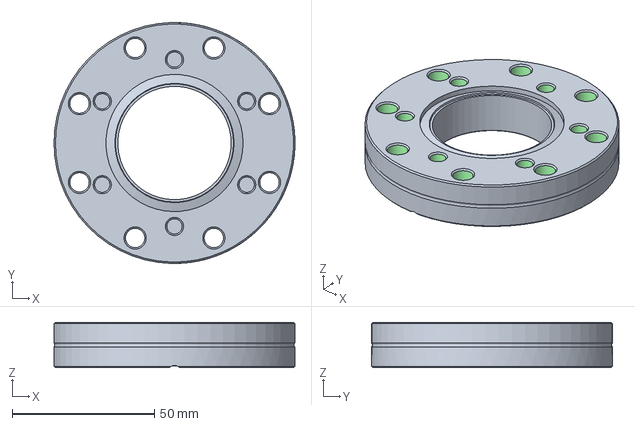
[picture p279: CAD file, 2026-07-06]
09_Kovachy_Lab/Referene Cell/Reference Cell/rf337x275t.stp
84.8 x 84.8 x 16.0 mm
