cross-isaac/IsaacCross_Senior_Thesis/09_Kovachy_Lab/Strontium Resevoir/oven/Oven.STEP/Strontium Oven.STEP

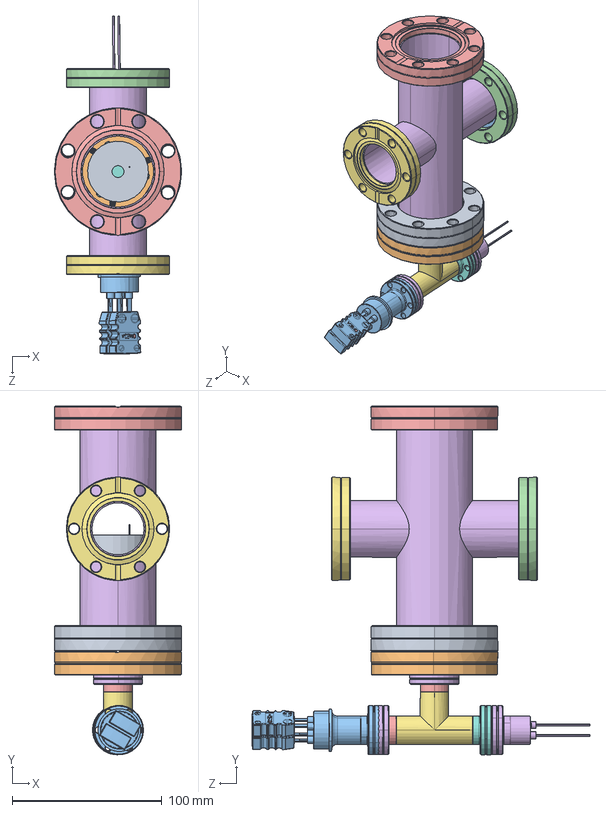
[picture p280: CAD file, 2026-07-06]
09_Kovachy_Lab/Strontium Resevoir/oven/Oven.STEP/Strontium Oven.STEP
85.1 x 232.9 x 225.7 mm
P0000439.stp.STEP
P0000494.stp.STEP
P0000489.stp.STEP
P0000436.stp.STEP
P0000157.stp.STEP
P0002155.stp.STEP
P0000127.stp.STEP
Sr Reservoir.STEP
shield.STEP
spaceroven (anchor).STEP
spaceroven (shield).STEP
94335A115_Electrical-Insulating Female Threaded Standoff_94335A115.STEP x 6
92196A425_18-8 Stainless Steel Socket Head Screw_92196A425.STEP x 12
TCapture.STEP
94610A210_Extreme-Temperature Ceramic Washer (1)_94610A210.STEP x 2
92949A078_18-8 Stainless Steel Button Head Hex Drive Screw_92949A078.STEP x 4
Sr Clamp.STEP
Sr Clamp 2.STEP
91771A931_Passivated 18-8 Stainless Steel Phillips Flat Head Screw_91771A931.STEP
3009A287_Hardened Undersized High-Speed M2 Tool Steel Rod_3009A287.STEP
P0001598_1.stp.STEP x 2
P0000430_1.stp.STEP x 2
P0002051_1.stp.STEP
P0001581_1.stp.STEP
92311A193_18-8 Stainless Steel Cup-Point Set Screw_92311A193.STEP x 3
rf337x133.stp.STEP
tft2ky00002.stp.STEP
eft0124052z.stp.STEP
