cross-isaac/IsaacCross_Senior_Thesis/09_Kovachy_Lab/Strontium Resevoir/oven/shield.SLDPRT

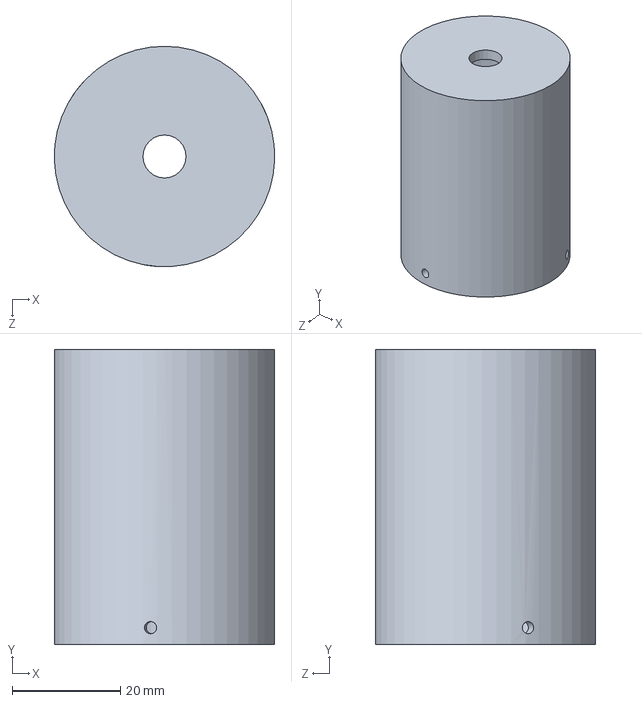
[picture p281: CAD file, 2026-07-06]
09_Kovachy_Lab/Strontium Resevoir/oven/shield.SLDPRT
40.6 x 54.4 x 40.6 mm
