cross-isaac/IsaacCross_Senior_Thesis/09_Kovachy_Lab/Strontium Resevoir/reservoir (1).SLDPRT

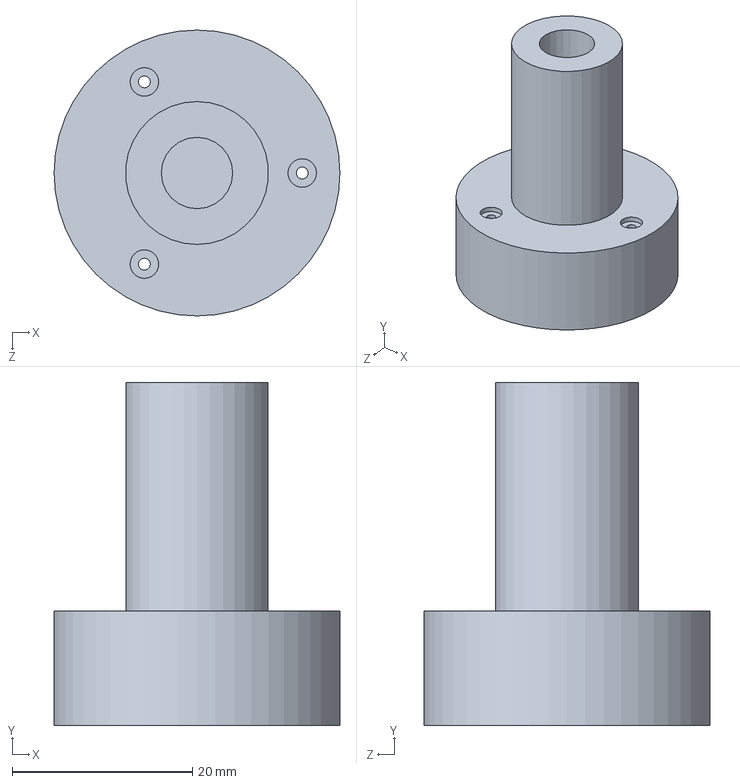
[picture p282: CAD file, 2026-07-06]
09_Kovachy_Lab/Strontium Resevoir/reservoir (1).SLDPRT
31.8 x 38.1 x 31.8 mm
