cross-isaac/IsaacCross_Senior_Thesis/02_Beam_Source_Design/CAD/Chamber_SW_Models/vpzl-133ldio3.SLDPRT

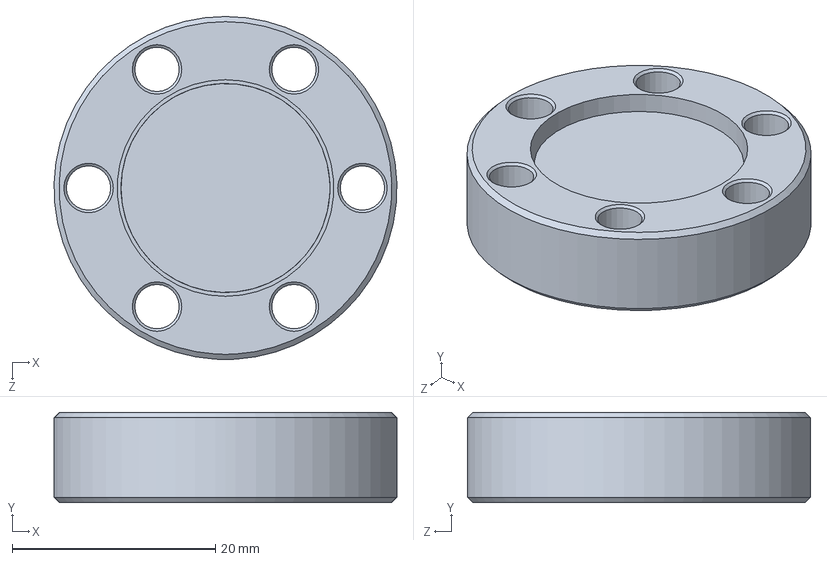
[picture p283: CAD file, 2026-07-06]
02_Beam_Source_Design/CAD/Chamber_SW_Models/vpzl-133ldio3.SLDPRT
33.8 x 8.86 x 33.8 mm
