cross-isaac/IsaacCross_Senior_Thesis/02_Beam_Source_Design/CAD/Crystal_Growth_Chamber/CHEX Aparatus 2/Feedthru int for IC (1)/feedthru int a2.stp

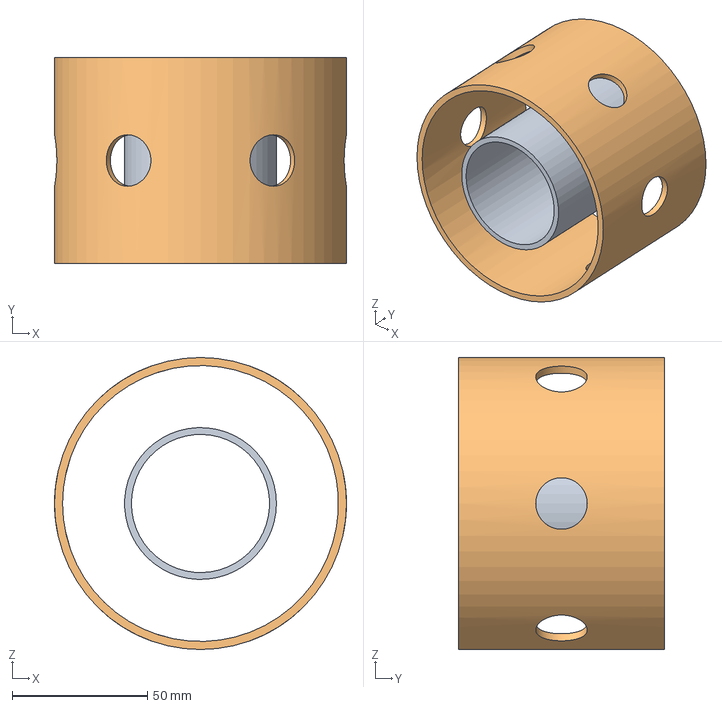
[picture p284: CAD file, 2026-07-06]
02_Beam_Source_Design/CAD/Crystal_Growth_Chamber/CHEX Aparatus 2/Feedthru int for IC (1)/feedthru int a2.stp
107.9 x 76.2 x 107.9 mm
