cross-isaac/IsaacCross_Senior_Thesis/02_Beam_Source_Design/CAD/Crystal_Growth_Chamber/Local Chamber/Simplified Chamber.SLDPRT

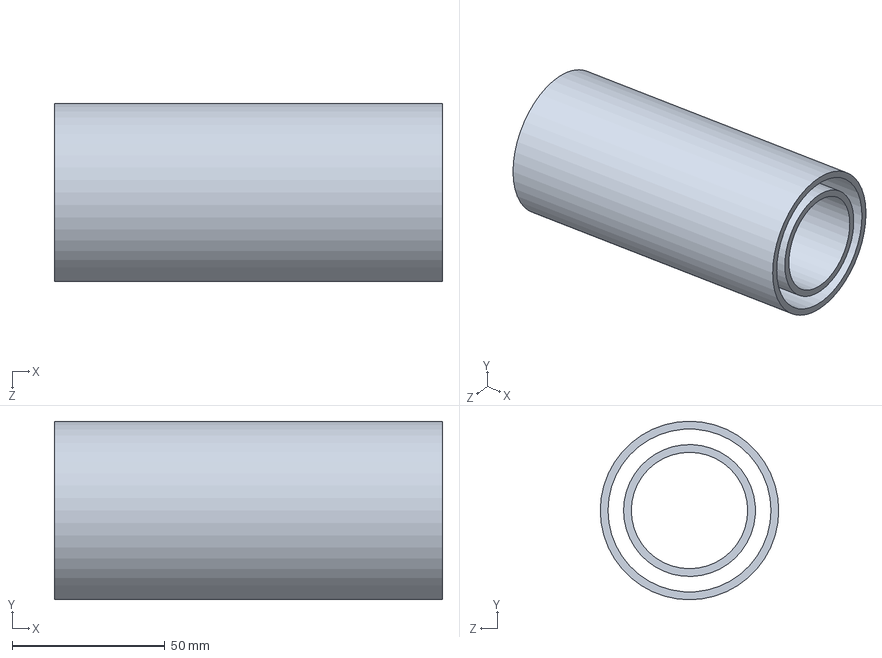
[picture p286: CAD file, 2026-07-06]
02_Beam_Source_Design/CAD/Crystal_Growth_Chamber/Local Chamber/Simplified Chamber.SLDPRT
127.0 x 58.4 x 58.4 mm
