cross-isaac/IsaacCross_Senior_Thesis/02_Beam_Source_Design/CAD/Oven_SW_Models/Components/cross.SLDPRT

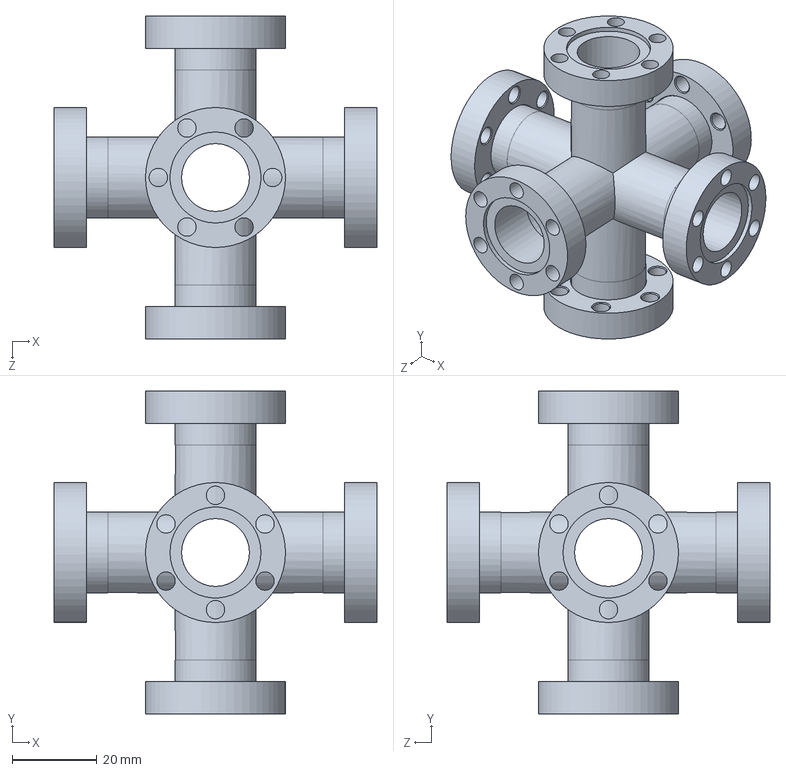
[picture p287: CAD file, 2026-07-06]
02_Beam_Source_Design/CAD/Oven_SW_Models/Components/cross.SLDPRT
76.2 x 76.2 x 76.2 mm
