cross-isaac/IsaacCross_Senior_Thesis/02_Beam_Source_Design/CAD/Oven_SW_Models/Oven/Capillaries.SLDPRT

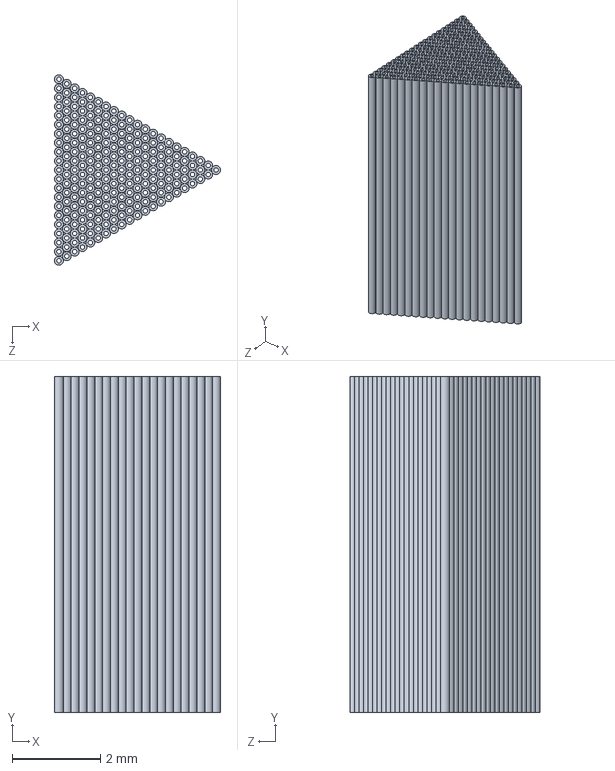
[picture p288: CAD file, 2026-07-06]
02_Beam_Source_Design/CAD/Oven_SW_Models/Oven/Capillaries.SLDPRT
3.77 x 7.62 x 4.32 mm
