cross-isaac/IsaacCross_Senior_Thesis/09_Kovachy_Lab/Copper Piece/2.0/0.5middlemiddleringRHD 2.0.SLDPRT

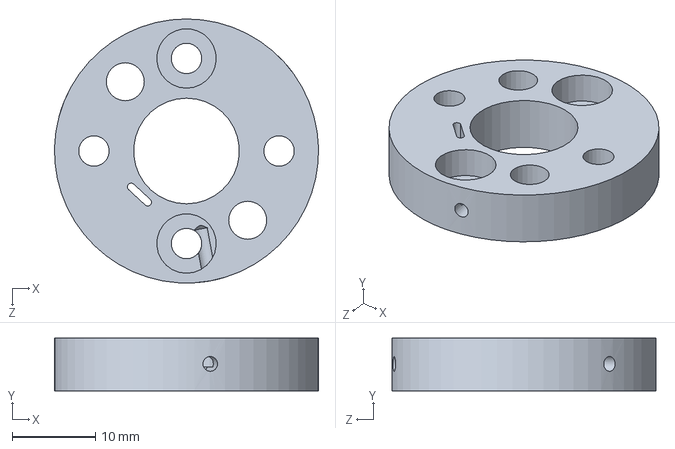
[picture p289: CAD file, 2026-07-06]
09_Kovachy_Lab/Copper Piece/2.0/0.5middlemiddleringRHD 2.0.SLDPRT
31.7 x 6.35 x 31.8 mm
