cross-isaac/IsaacCross_Senior_Thesis/09_Kovachy_Lab/Copper Piece/Copper Cap.SLDPRT

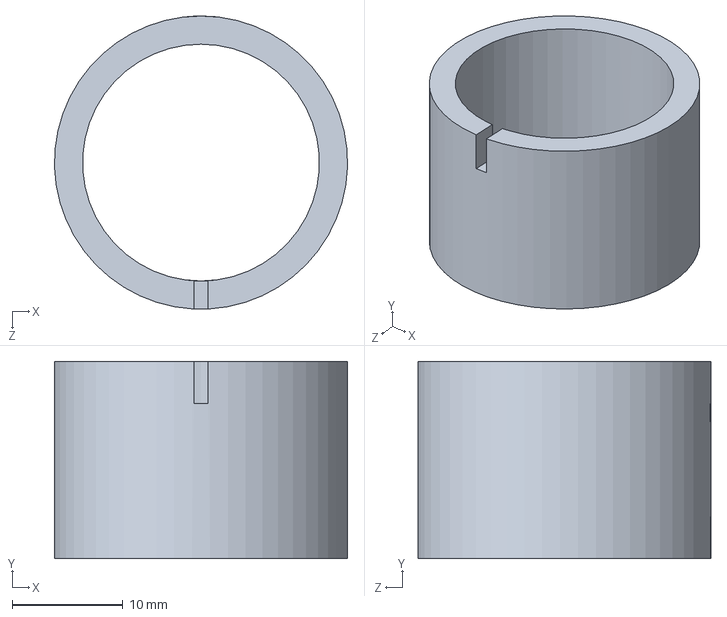
[picture p290: CAD file, 2026-07-06]
09_Kovachy_Lab/Copper Piece/Copper Cap.SLDPRT
26.4 x 17.8 x 26.4 mm
