cross-isaac/IsaacCross_Senior_Thesis/09_Kovachy_Lab/Optics Board/Mounts/BE1-Solidworks.sldprt

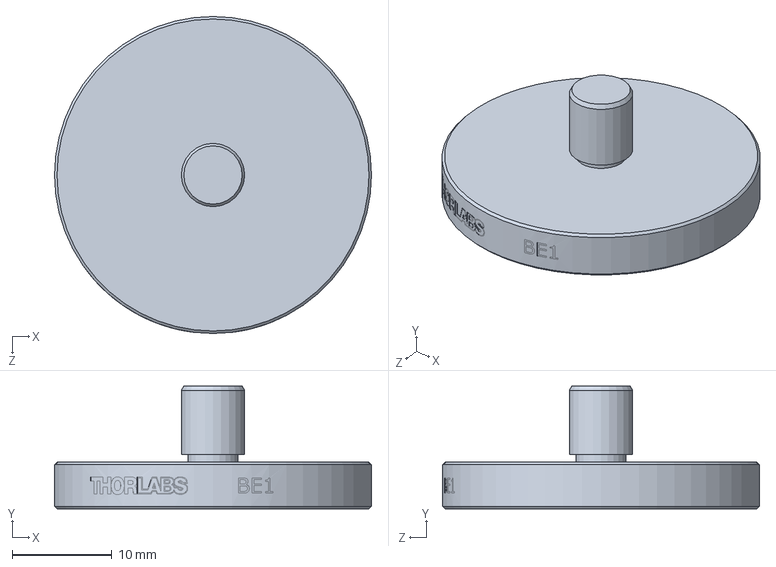
[picture p291: CAD file, 2026-07-06]
09_Kovachy_Lab/Optics Board/Mounts/BE1-Solidworks.sldprt
31.8 x 12.3 x 31.8 mm
