cross-isaac/IsaacCross_Senior_Thesis/09_Kovachy_Lab/Optics Board/Optics/PBS122-Solidworks.sldprt

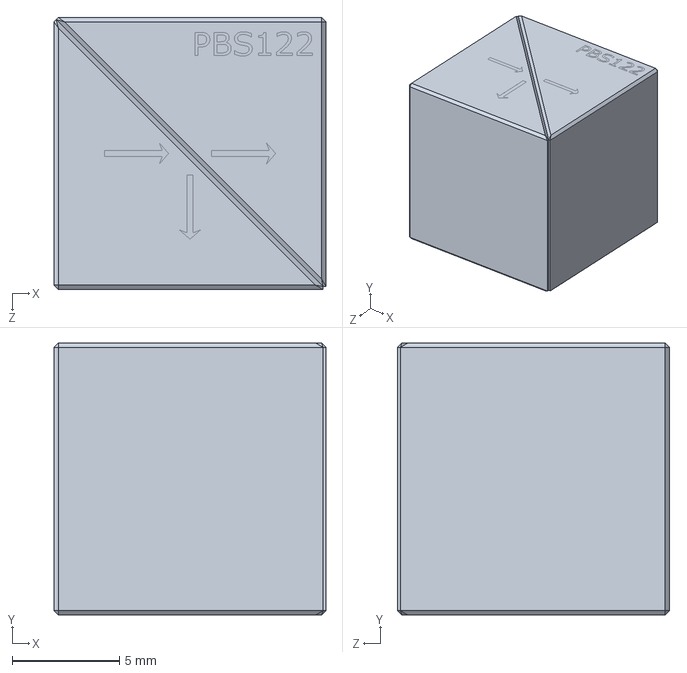
[picture p292: CAD file, 2026-07-06]
09_Kovachy_Lab/Optics Board/Optics/PBS122-Solidworks.sldprt
12.7 x 12.7 x 12.7 mm
