cross-isaac/IsaacCross_Senior_Thesis/09_Kovachy_Lab/Referene Cell/Reference Cell/baffle/baffle piece.SLDPRT

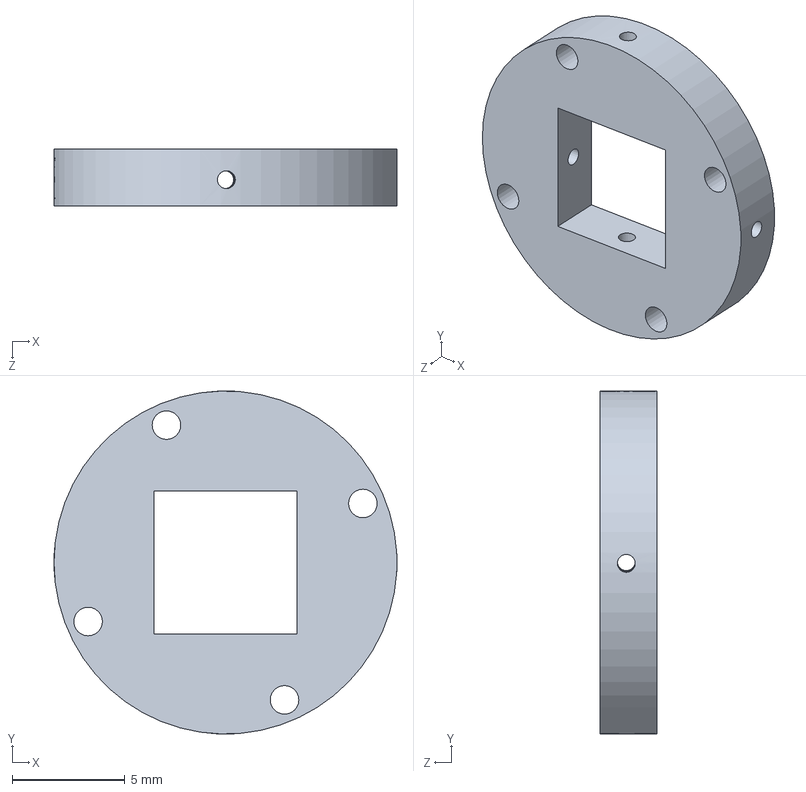
[picture p293: CAD file, 2026-07-06]
09_Kovachy_Lab/Referene Cell/Reference Cell/baffle/baffle piece.SLDPRT
15.2 x 15.2 x 2.54 mm
