cross-isaac/IsaacCross_Senior_Thesis/09_Kovachy_Lab/Referene Cell/Reference Cell/hot window/0.5 inch sapph window design/0.5shield.SLDPRT

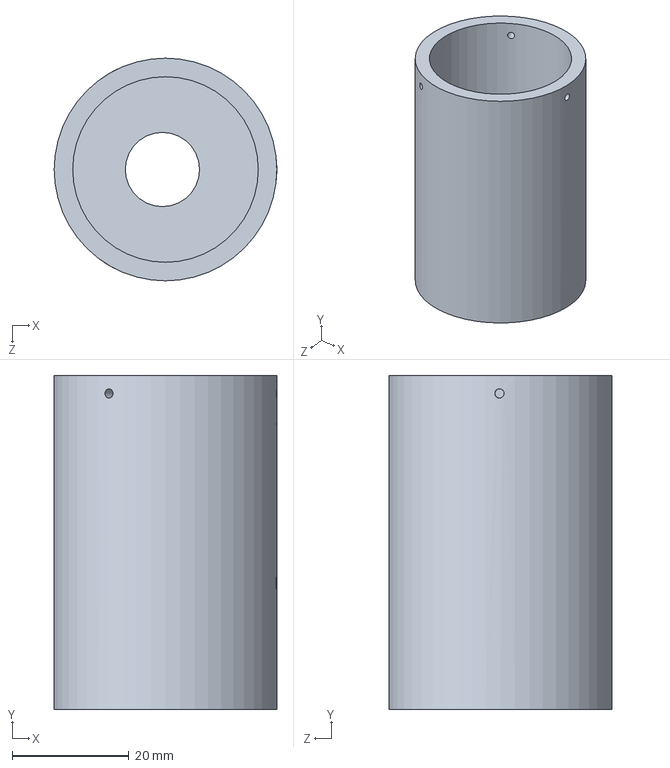
[picture p294: CAD file, 2026-07-06]
09_Kovachy_Lab/Referene Cell/Reference Cell/hot window/0.5 inch sapph window design/0.5shield.SLDPRT
38.1 x 57.1 x 38.1 mm
