cross-isaac/IsaacCross_Senior_Thesis/02_Beam_Source_Design/CAD/Chamber_SW_Models/f0133n000tln.SLDPRT

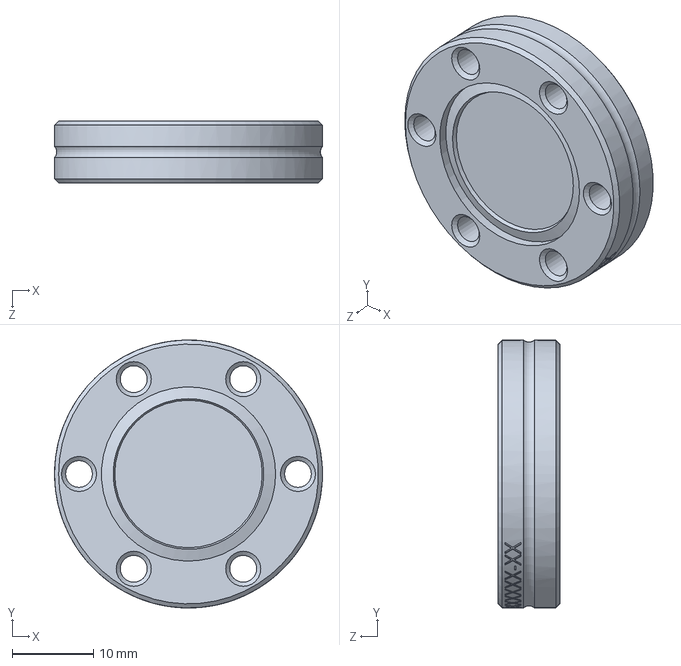
[picture p296: CAD file, 2026-07-06]
02_Beam_Source_Design/CAD/Chamber_SW_Models/f0133n000tln.SLDPRT
33.0 x 33.0 x 7.62 mm
