cross-isaac/IsaacCross_Senior_Thesis/02_Beam_Source_Design/CAD/Oven_SW_Models/Components/valve.SLDPRT

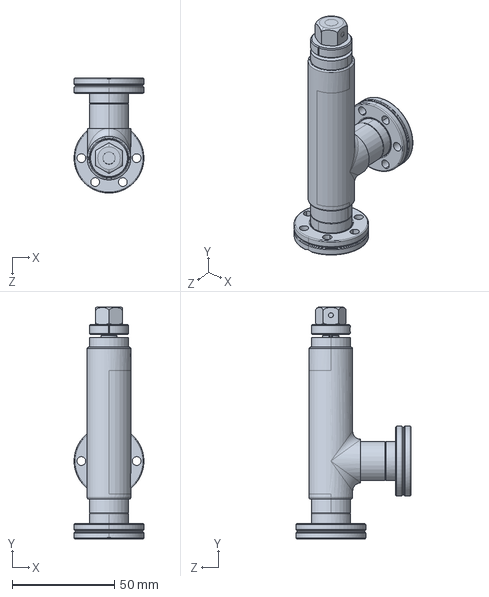
[picture p297: CAD file, 2026-07-06]
02_Beam_Source_Design/CAD/Oven_SW_Models/Components/valve.SLDPRT
34.1 x 113.3 x 56.2 mm
