cross-isaac/IsaacCross_Senior_Thesis/02_Beam_Source_Design/CAD/Oven_SW_Models/Nozzle/ModifiedFlange.SLDPRT

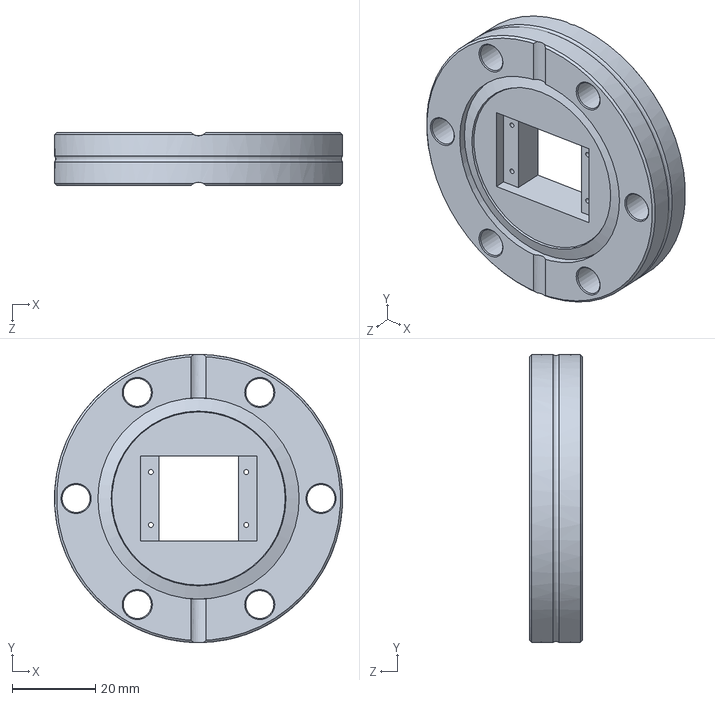
[picture p298: CAD file, 2026-07-06]
02_Beam_Source_Design/CAD/Oven_SW_Models/Nozzle/ModifiedFlange.SLDPRT
69.1 x 69.1 x 12.7 mm
