cross-isaac/IsaacCross_Senior_Thesis/02_Beam_Source_Design/CAD/Oven_SW_Models/Oven/Multiplexer.SLDPRT

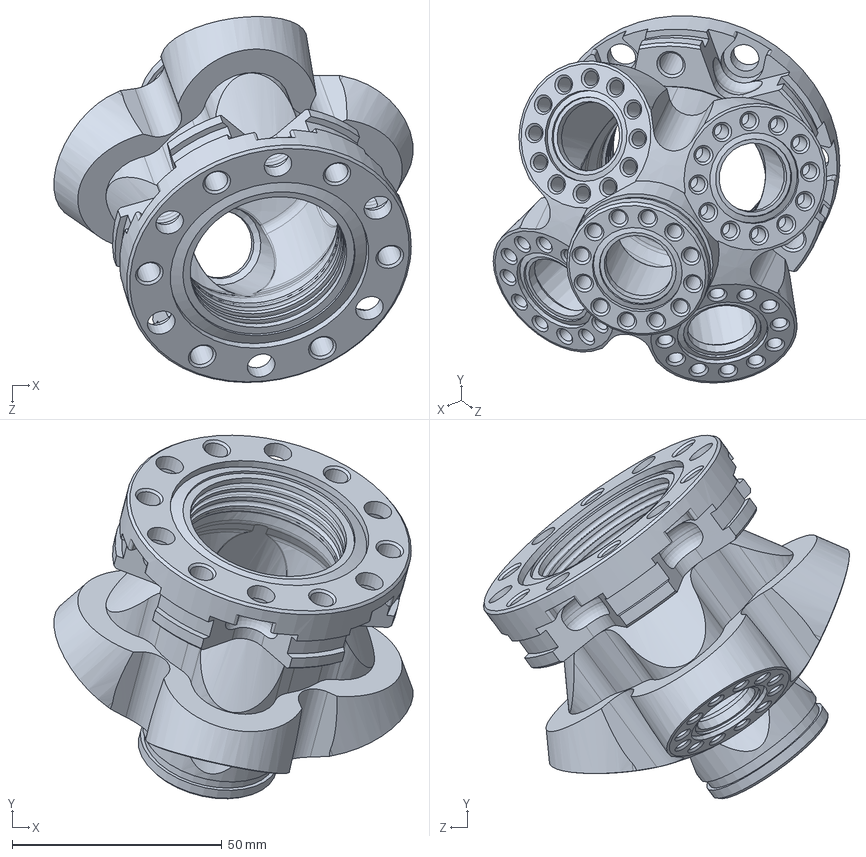
[picture p299: CAD file, 2026-07-06]
02_Beam_Source_Design/CAD/Oven_SW_Models/Oven/Multiplexer.SLDPRT
85.5 x 86.6 x 87.2 mm
