cross-isaac/IsaacCross_Senior_Thesis/09_Kovachy_Lab/Copper Piece/2.0/copper base_square 2.0.SLDPRT

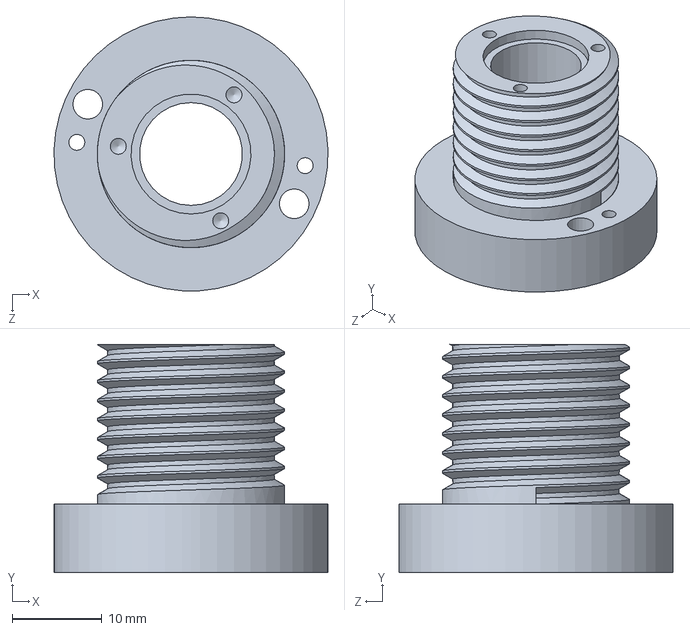
[picture p300: CAD file, 2026-07-06]
09_Kovachy_Lab/Copper Piece/2.0/copper base_square 2.0.SLDPRT
30.5 x 25.4 x 30.5 mm
