cross-isaac/IsaacCross_Senior_Thesis/09_Kovachy_Lab/Optics Board/F810APC-635-Solidworks.sldprt

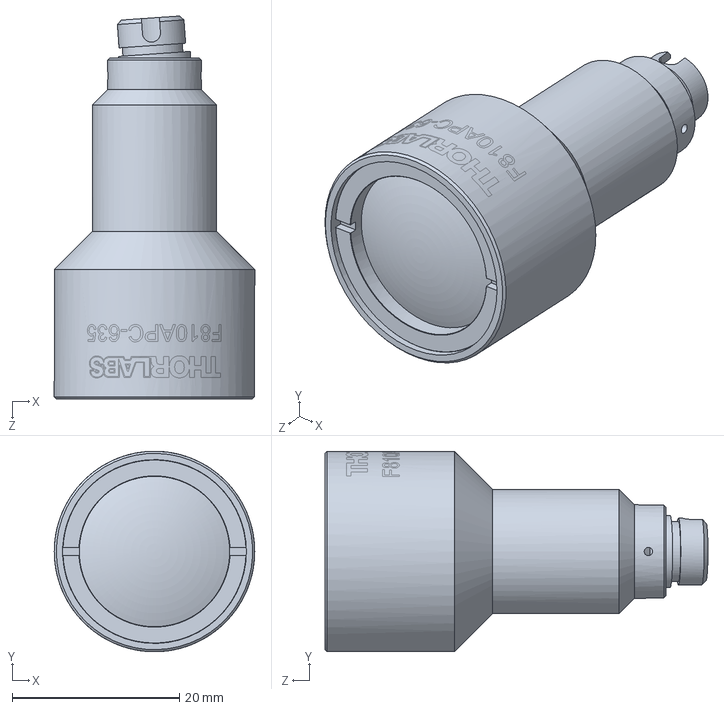
[picture p301: CAD file, 2026-07-06]
09_Kovachy_Lab/Optics Board/F810APC-635-Solidworks.sldprt
24.0 x 24.0 x 45.8 mm
