cross-isaac/IsaacCross_Senior_Thesis/09_Kovachy_Lab/Optics Board/Mounts/LMR1-Solidworks (1).sldprt

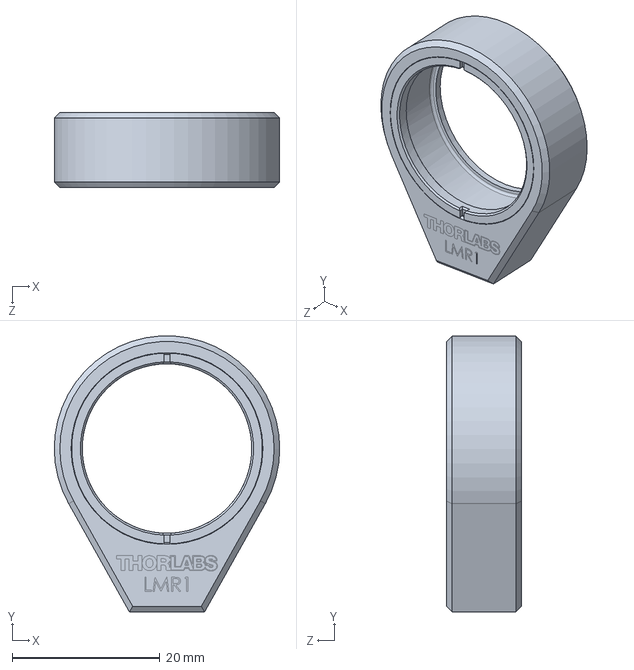
[picture p302: CAD file, 2026-07-06]
09_Kovachy_Lab/Optics Board/Mounts/LMR1-Solidworks (1).sldprt
30.5 x 37.3 x 10.2 mm
