cross-isaac/IsaacCross_Senior_Thesis/09_Kovachy_Lab/Optics Board/Optics/WPH05M-694-Solidworks.sldprt

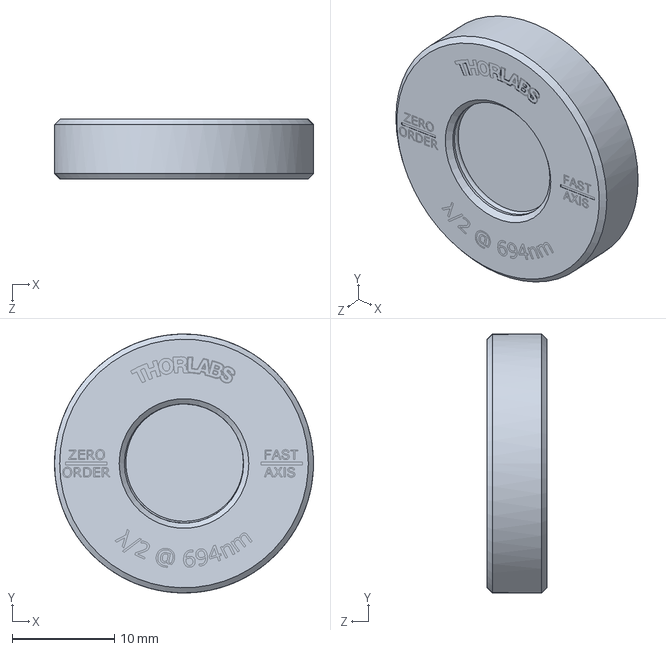
[picture p303: CAD file, 2026-07-06]
09_Kovachy_Lab/Optics Board/Optics/WPH05M-694-Solidworks.sldprt
25.4 x 25.4 x 5.84 mm
