cross-isaac/IsaacCross_Senior_Thesis/09_Kovachy_Lab/Referene Cell/Reference Cell/baffle/clamp.SLDPRT

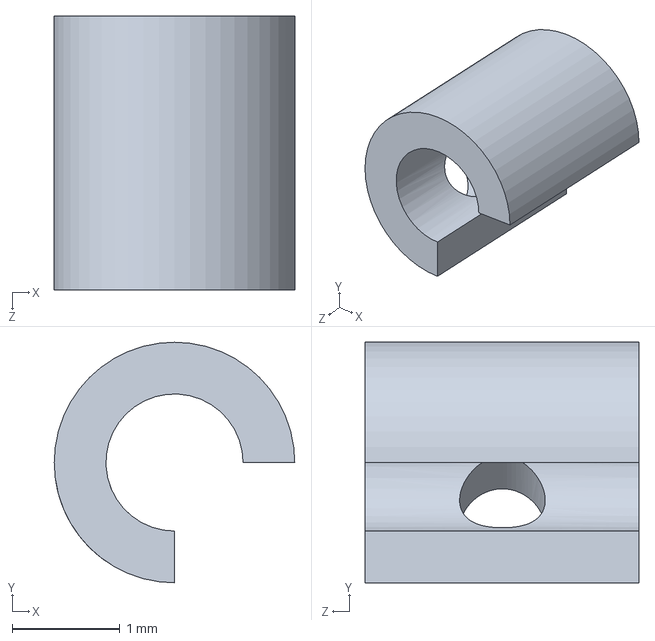
[picture p304: CAD file, 2026-07-06]
09_Kovachy_Lab/Referene Cell/Reference Cell/baffle/clamp.SLDPRT
2.23 x 2.23 x 2.54 mm
