cross-isaac/IsaacCross_Senior_Thesis/09_Kovachy_Lab/Referene Cell/Reference Cell/hot window/0.5 inch sapph window design/0.5outerring.SLDPRT

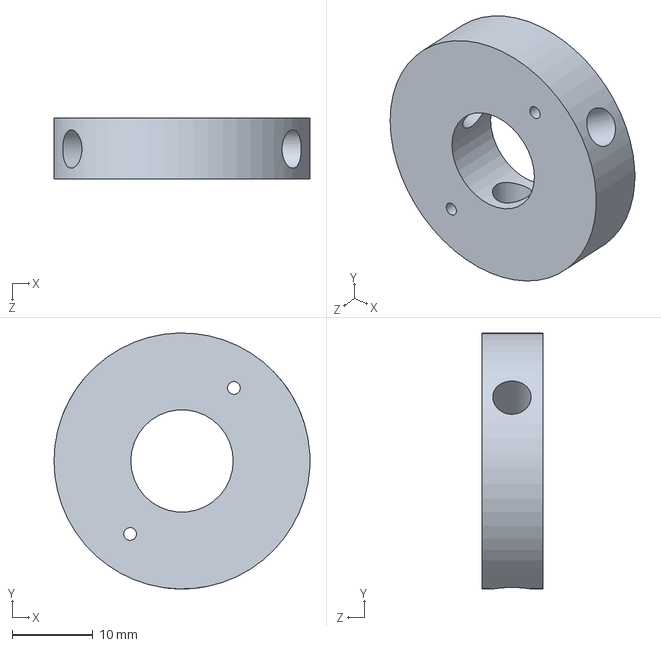
[picture p305: CAD file, 2026-07-06]
09_Kovachy_Lab/Referene Cell/Reference Cell/hot window/0.5 inch sapph window design/0.5outerring.SLDPRT
31.8 x 31.7 x 7.62 mm
