cross-isaac/IsaacCross_Senior_Thesis/09_Kovachy_Lab/Strontium Resevoir/oven/Oven.STEP/spaceroven (anchor).STEP

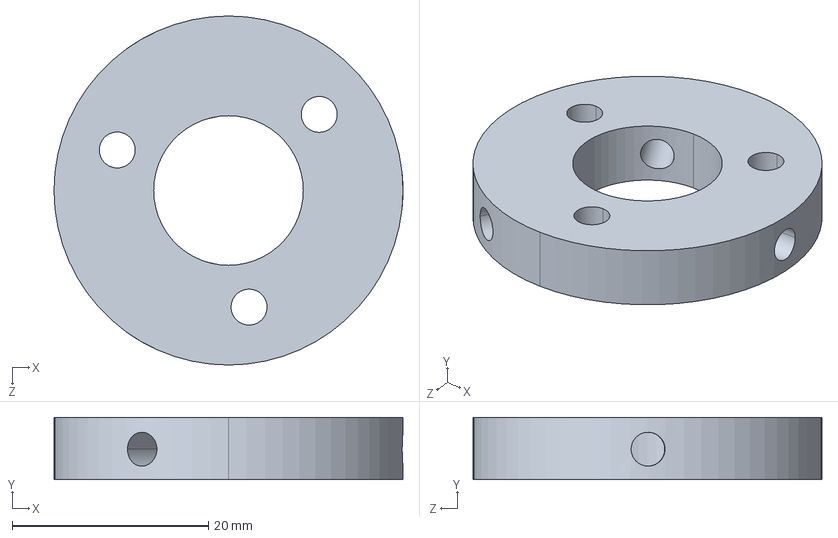
[picture p306: CAD file, 2026-07-06]
09_Kovachy_Lab/Strontium Resevoir/oven/Oven.STEP/spaceroven (anchor).STEP
35.6 x 6.35 x 35.6 mm
