cross-isaac/IsaacCross_Senior_Thesis/09_Kovachy_Lab/Strontium Resevoir/oven/Sr Clamp.SLDPRT

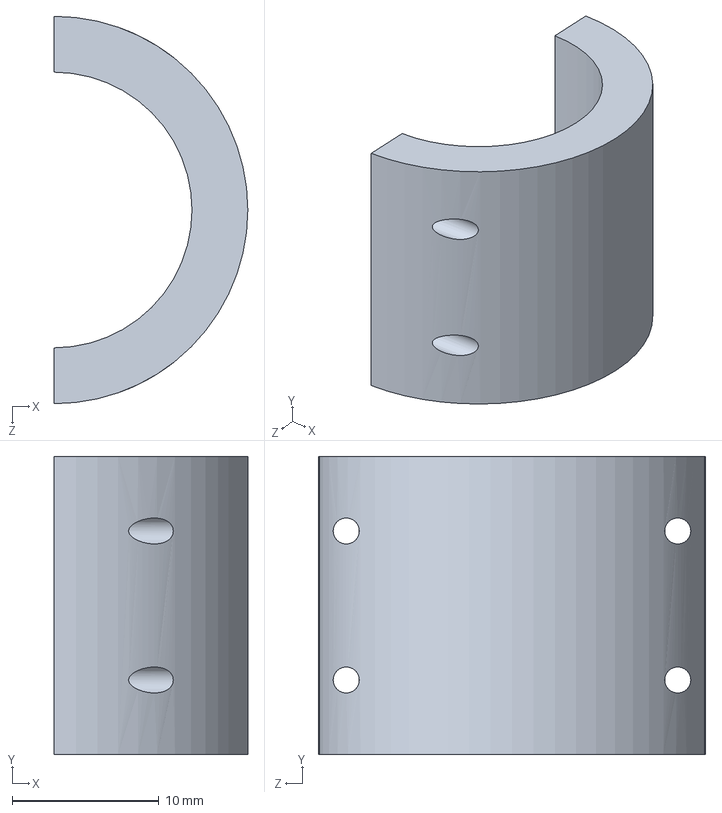
[picture p307: CAD file, 2026-07-06]
09_Kovachy_Lab/Strontium Resevoir/oven/Sr Clamp.SLDPRT
13.2 x 20.3 x 26.4 mm
