cross-isaac/IsaacCross_Senior_Thesis/02_Beam_Source_Design/CAD/Crystal_Growth_Chamber/CHEX Aparatus 2/Feedthru int for IC (1)/longer flange thing draft.stp

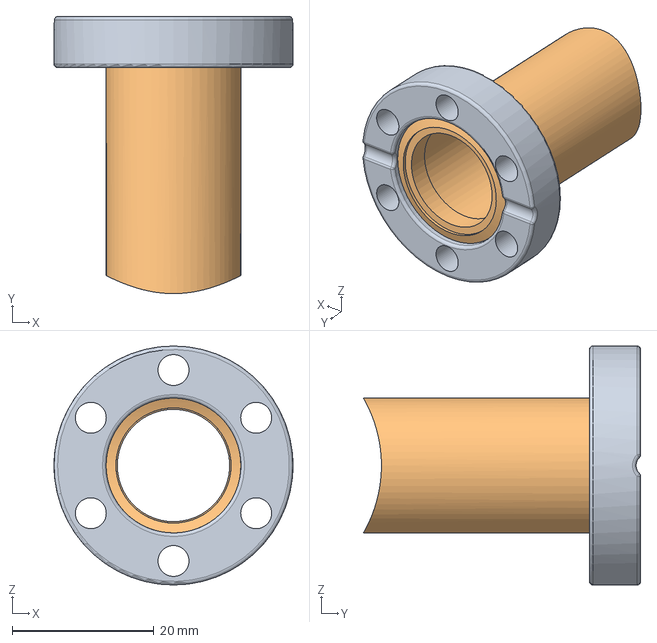
[picture p308: CAD file, 2026-07-06]
02_Beam_Source_Design/CAD/Crystal_Growth_Chamber/CHEX Aparatus 2/Feedthru int for IC (1)/longer flange thing draft.stp
33.8 x 39.2 x 33.8 mm
