cross-isaac/IsaacCross_Senior_Thesis/02_Beam_Source_Design/CAD/Crystal_Growth_Chamber/Local Chamber/Heat Shield.SLDPRT

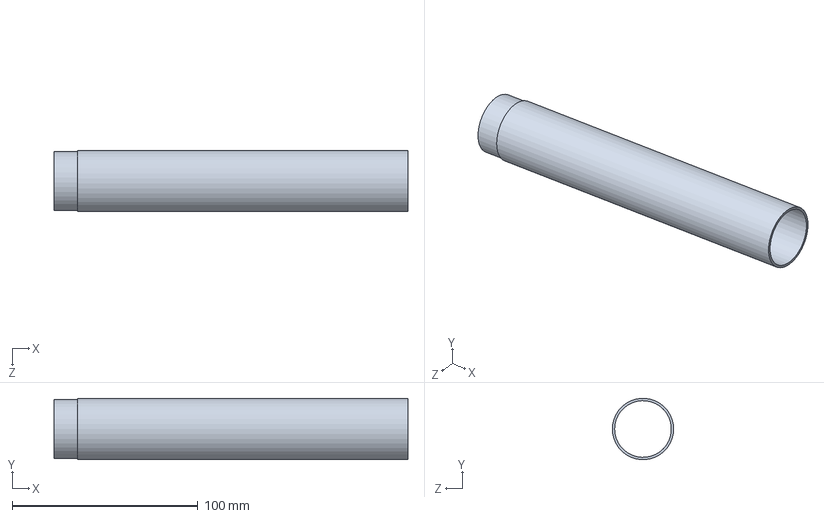
[picture p311: CAD file, 2026-07-06]
02_Beam_Source_Design/CAD/Crystal_Growth_Chamber/Local Chamber/Heat Shield.SLDPRT
190.5 x 32.9 x 33.0 mm
