cross-isaac/IsaacCross_Senior_Thesis/02_Beam_Source_Design/CAD/Oven_SW_Models/Components/Nozzle.SLDPRT

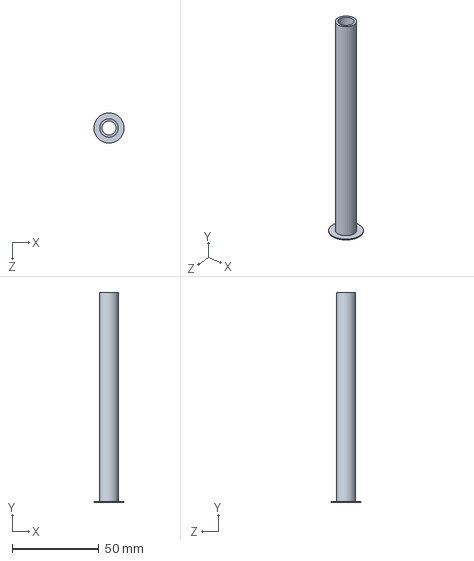
[picture p312: CAD file, 2026-07-06]
02_Beam_Source_Design/CAD/Oven_SW_Models/Components/Nozzle.SLDPRT
17.4 x 120.9 x 17.4 mm
