cross-isaac/IsaacCross_Senior_Thesis/02_Beam_Source_Design/CAD/Oven_SW_Models/Nozzle/Nozzle.STEP

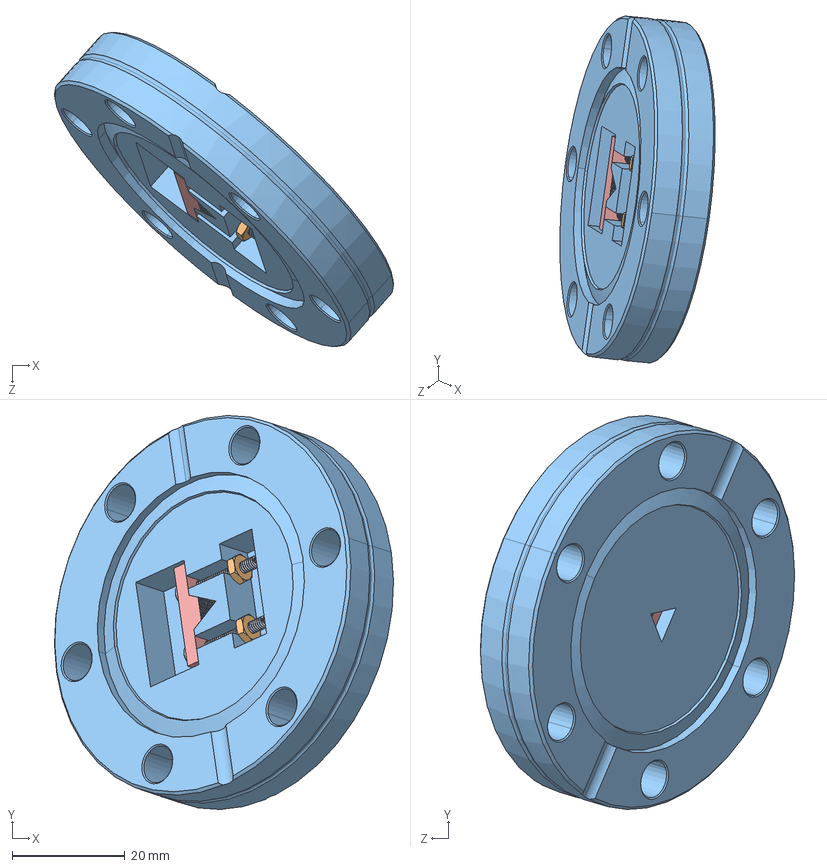
[picture p313: CAD file, 2026-07-06]
02_Beam_Source_Design/CAD/Oven_SW_Models/Nozzle/Nozzle.STEP
60.2 x 70.0 x 55.8 mm
92196A083_18-8 Stainless Steel Socket Head Screw_92196A083 x 2
91841A003_18-8 Stainless Steel Hex Nut_91841A003 x 2
ModifiedFlangeV1
Capillaries
NozzleClamp
