cross-isaac/IsaacCross_Senior_Thesis/02_Beam_Source_Design/CAD/Oven_SW_Models/Oven/Part74.SLDPRT

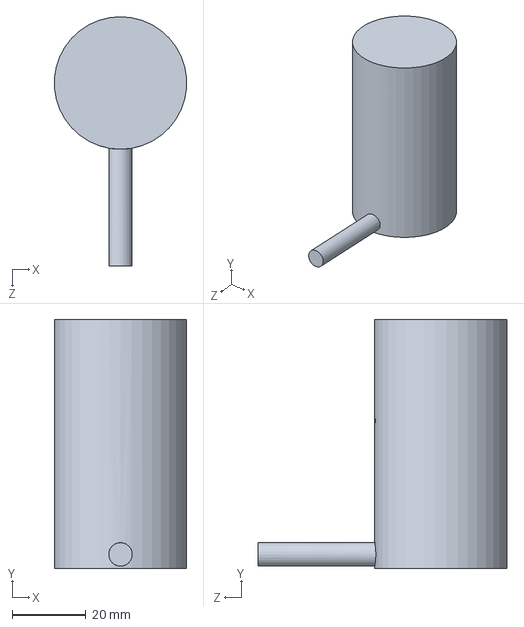
[picture p314: CAD file, 2026-07-06]
02_Beam_Source_Design/CAD/Oven_SW_Models/Oven/Part74.SLDPRT
35.7 x 67.3 x 67.4 mm
