cross-isaac/IsaacCross_Senior_Thesis/09_Kovachy_Lab/Copper Piece/2.0/Assem1.STEP

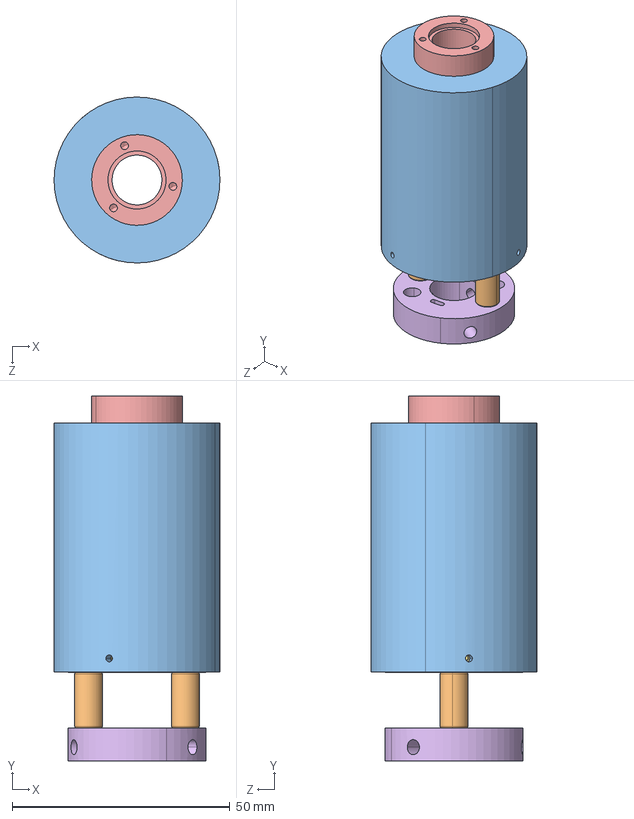
[picture p315: CAD file, 2026-07-06]
09_Kovachy_Lab/Copper Piece/2.0/Assem1.STEP
38.1 x 83.8 x 38.1 mm
0.5middleringRHD 2.0
94335A115_Electrical-Insulating Female Threaded Standoff_94335A115 x 6
0.5shield 2.0
94610A210_Extreme-Temperature Ceramic Washer (1)_94610A210
copper base_square 2.1
0.5outerringRHD 2.0
0.5middlemiddleringRHD 2.0
94635A110_Ceramic Hex Nut_94635A110
92196A425_18-8 Stainless Steel Socket Head Screw_92196A425
94355A221_18-8 Stainless Steel Flat-Tip Set Screws_94355A221
