cross-isaac/IsaacCross_Senior_Thesis/09_Kovachy_Lab/Optics Board/MB12D-Solidworks.sldprt

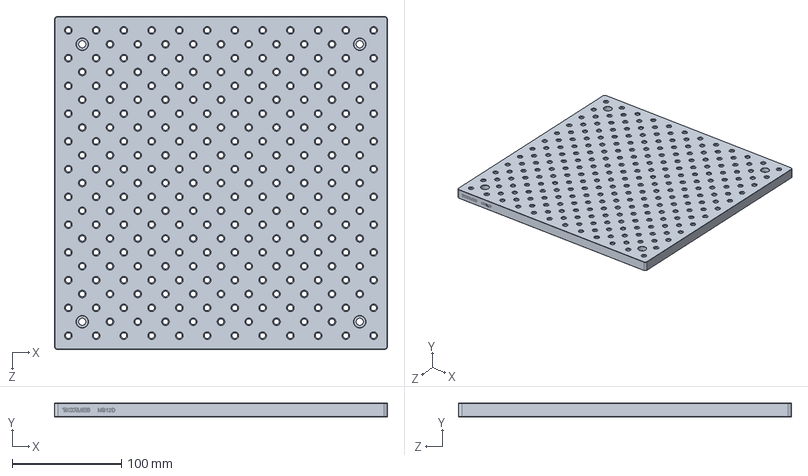
[picture p316: CAD file, 2026-07-06]
09_Kovachy_Lab/Optics Board/MB12D-Solidworks.sldprt
304.8 x 12.7 x 304.8 mm
