cross-isaac/IsaacCross_Senior_Thesis/09_Kovachy_Lab/Optics Board/Mounts/PH2-Solidworks.sldprt

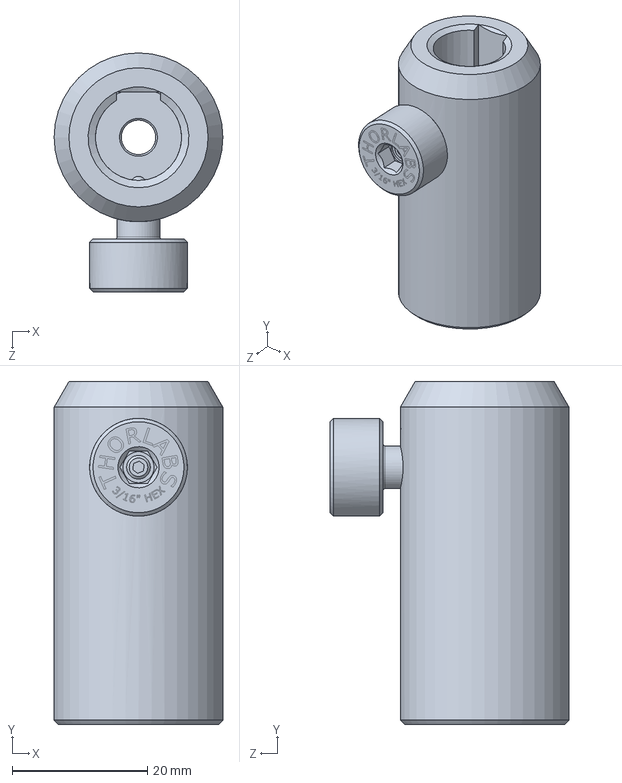
[picture p317: CAD file, 2026-07-06]
09_Kovachy_Lab/Optics Board/Mounts/PH2-Solidworks.sldprt
25.0 x 50.8 x 35.4 mm
