cross-isaac/IsaacCross_Senior_Thesis/09_Kovachy_Lab/Optics Board/Optics/LBF254-040-Solidworks.sldprt

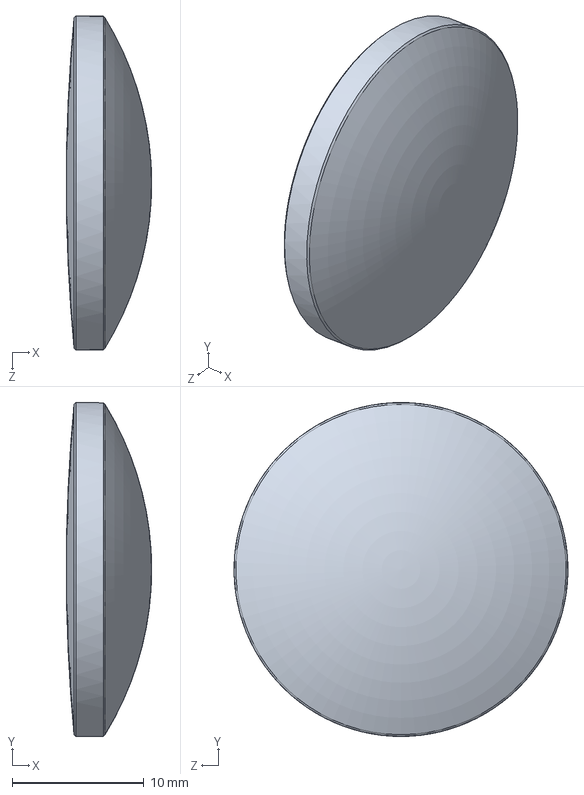
[picture p318: CAD file, 2026-07-06]
09_Kovachy_Lab/Optics Board/Optics/LBF254-040-Solidworks.sldprt
6.50 x 25.4 x 25.4 mm
