cross-isaac/IsaacCross_Senior_Thesis/09_Kovachy_Lab/Referene Cell/Reference Cell/baffle/rod.SLDPRT

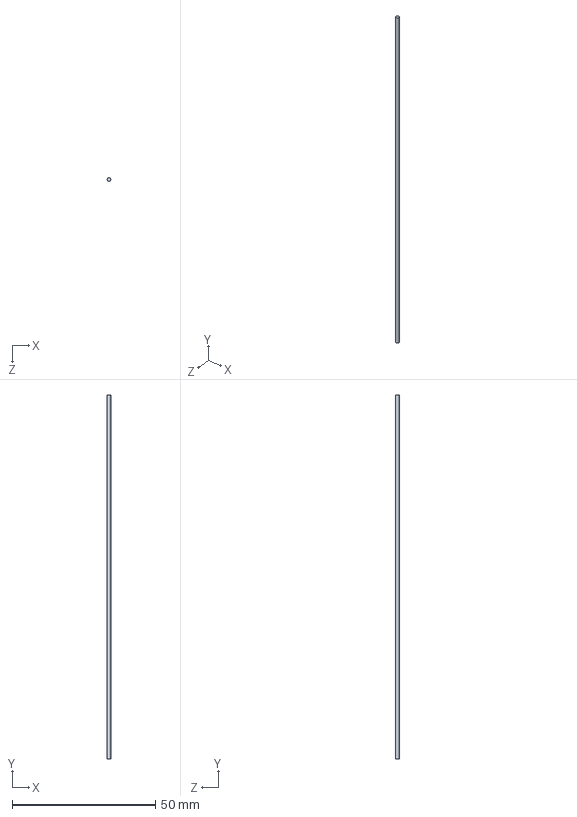
[picture p319: CAD file, 2026-07-06]
09_Kovachy_Lab/Referene Cell/Reference Cell/baffle/rod.SLDPRT
1.27 x 127.0 x 1.27 mm
