cross-isaac/IsaacCross_Senior_Thesis/09_Kovachy_Lab/Referene Cell/Reference Cell/hot window/window capture ring_RHD.SLDPRT

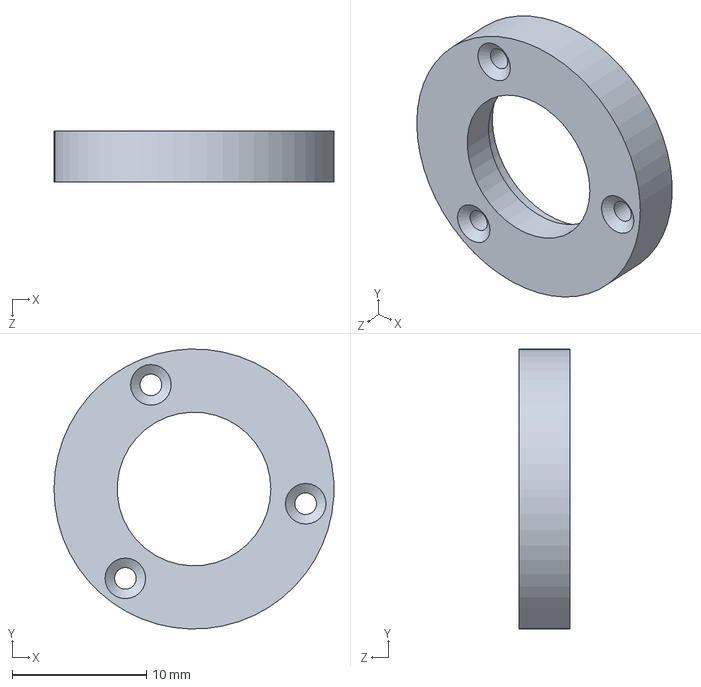
[picture p320: CAD file, 2026-07-06]
09_Kovachy_Lab/Referene Cell/Reference Cell/hot window/window capture ring_RHD.SLDPRT
20.8 x 20.8 x 3.81 mm
