cross-isaac/IsaacCross_Senior_Thesis/09_Kovachy_Lab/Referene Cell/Reference Cell/tft1ky00002.stp

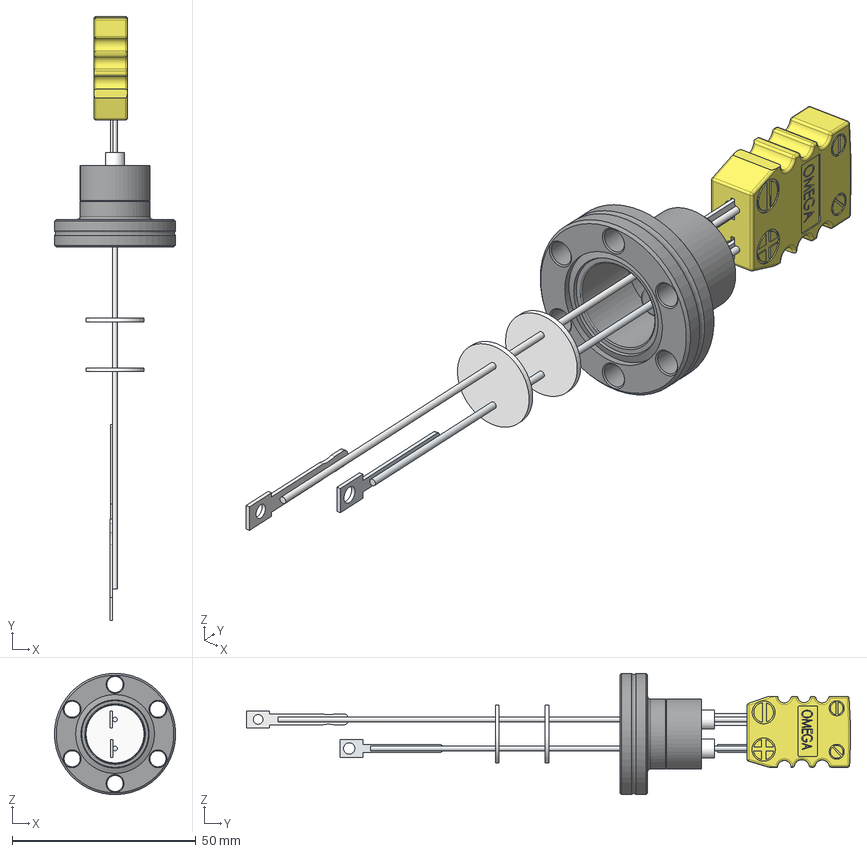
[picture p321: CAD file, 2026-07-06]
09_Kovachy_Lab/Referene Cell/Reference Cell/tft1ky00002.stp
33.0 x 164.4 x 33.0 mm
