cross-isaac/IsaacCross_Senior_Thesis/09_Kovachy_Lab/Strontium Resevoir/oven/Oven.STEP/Sr Reservoir.STEP

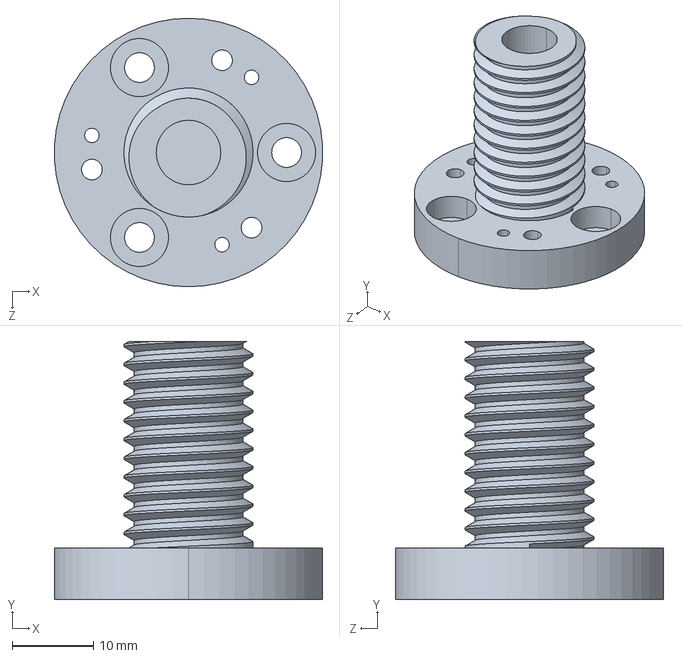
[picture p322: CAD file, 2026-07-06]
09_Kovachy_Lab/Strontium Resevoir/oven/Oven.STEP/Sr Reservoir.STEP
33.0 x 31.8 x 33.0 mm
