cross-isaac/IsaacCross_Senior_Thesis/09_Kovachy_Lab/Strontium Resevoir/Resevoir isolated 2.0.SLDPRT

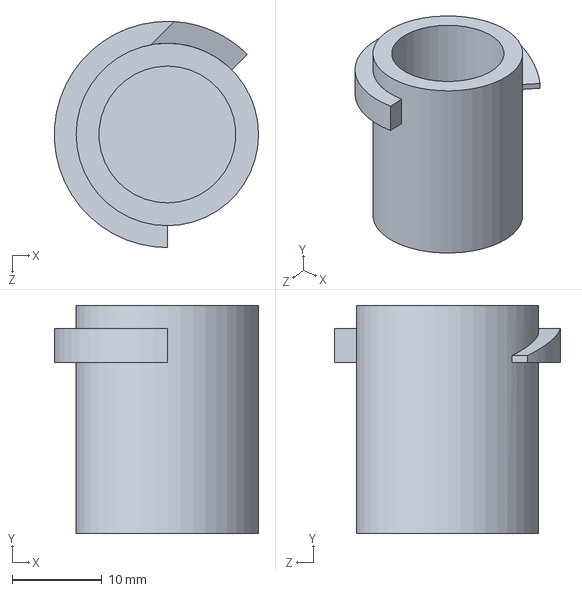
[picture p323: CAD file, 2026-07-06]
09_Kovachy_Lab/Strontium Resevoir/Resevoir isolated 2.0.SLDPRT
22.7 x 25.4 x 25.2 mm
