cross-isaac/IsaacCross_Senior_Thesis/02_Beam_Source_Design/CAD/Crystal_Growth_Chamber/CHEX Aparatus 2/Feedthru int for IC (1)/SChex dkl 1.stp

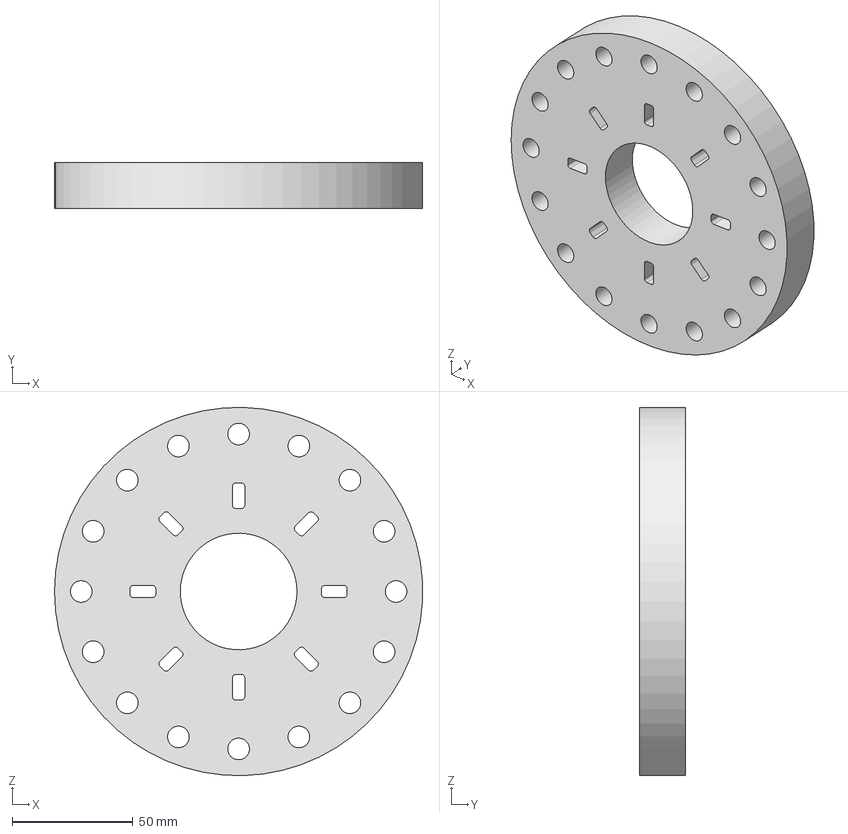
[picture p324: CAD file, 2026-07-06]
02_Beam_Source_Design/CAD/Crystal_Growth_Chamber/CHEX Aparatus 2/Feedthru int for IC (1)/SChex dkl 1.stp
152.3 x 19.0 x 152.3 mm
