cross-isaac/IsaacCross_Senior_Thesis/02_Beam_Source_Design/CAD/Crystal_Growth_Chamber/Local Chamber/Heat Shield Extender.SLDPRT

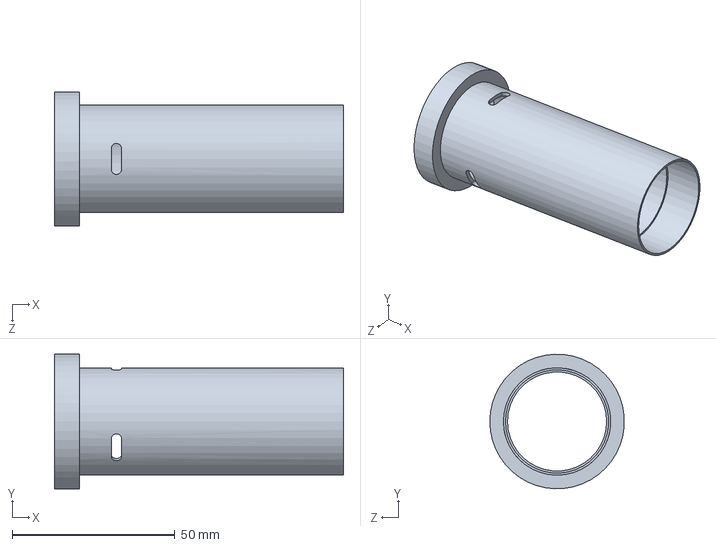
[picture p326: CAD file, 2026-07-06]
02_Beam_Source_Design/CAD/Crystal_Growth_Chamber/Local Chamber/Heat Shield Extender.SLDPRT
88.9 x 41.4 x 41.4 mm
