cross-isaac/IsaacCross_Senior_Thesis/02_Beam_Source_Design/CAD/Oven_SW_Models/Components/cft10v0752.stp

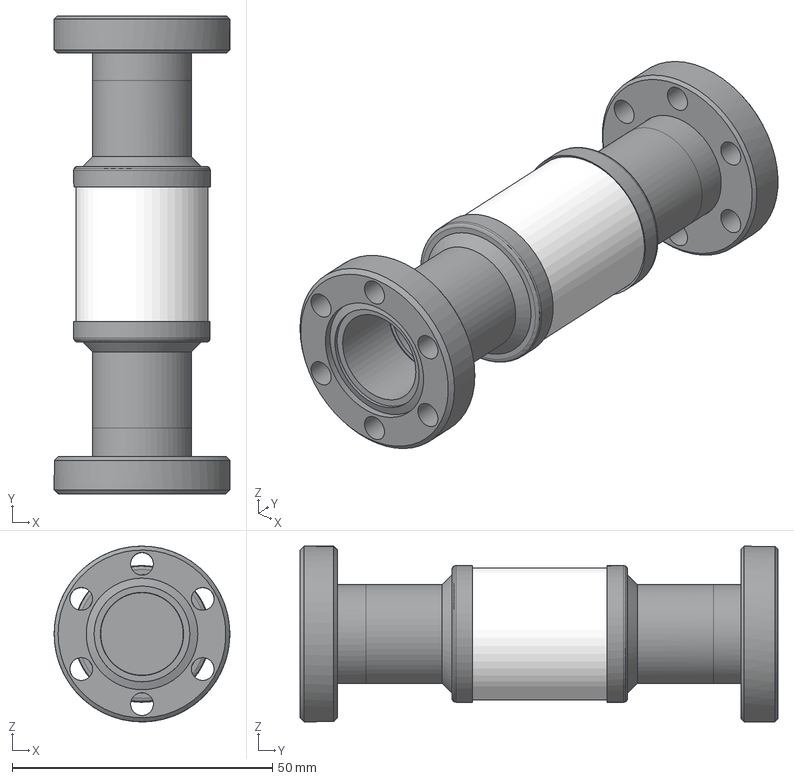
[picture p327: CAD file, 2026-07-06]
02_Beam_Source_Design/CAD/Oven_SW_Models/Components/cft10v0752.stp
33.8 x 91.9 x 33.8 mm
