cross-isaac/IsaacCross_Senior_Thesis/02_Beam_Source_Design/CAD/Oven_SW_Models/Oven/lft211temv.SLDPRT

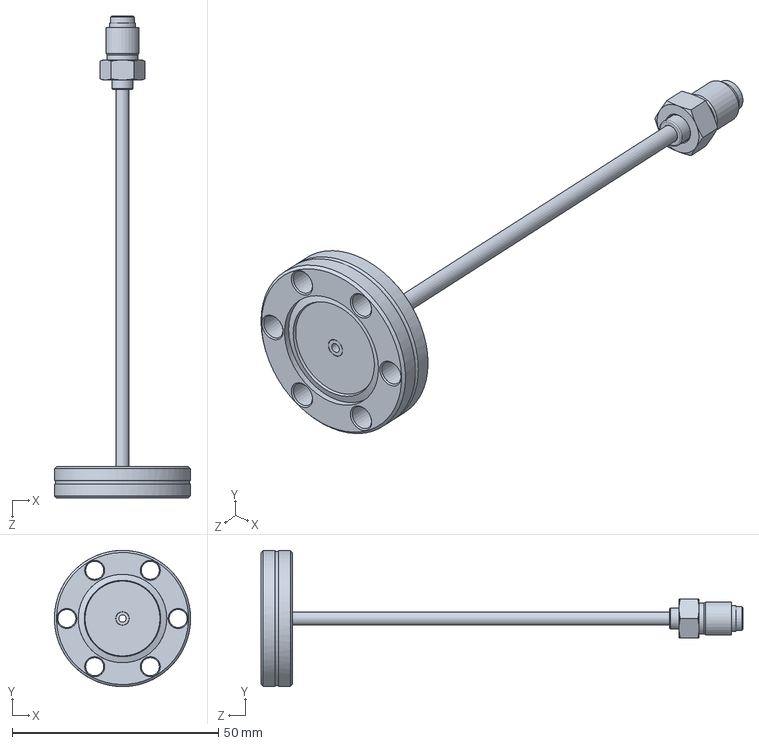
[picture p329: CAD file, 2026-07-06]
02_Beam_Source_Design/CAD/Oven_SW_Models/Oven/lft211temv.SLDPRT
33.0 x 33.0 x 116.8 mm
