cross-isaac/IsaacCross_Senior_Thesis/09_Kovachy_Lab/Copper Piece/Copper Base.SLDPRT

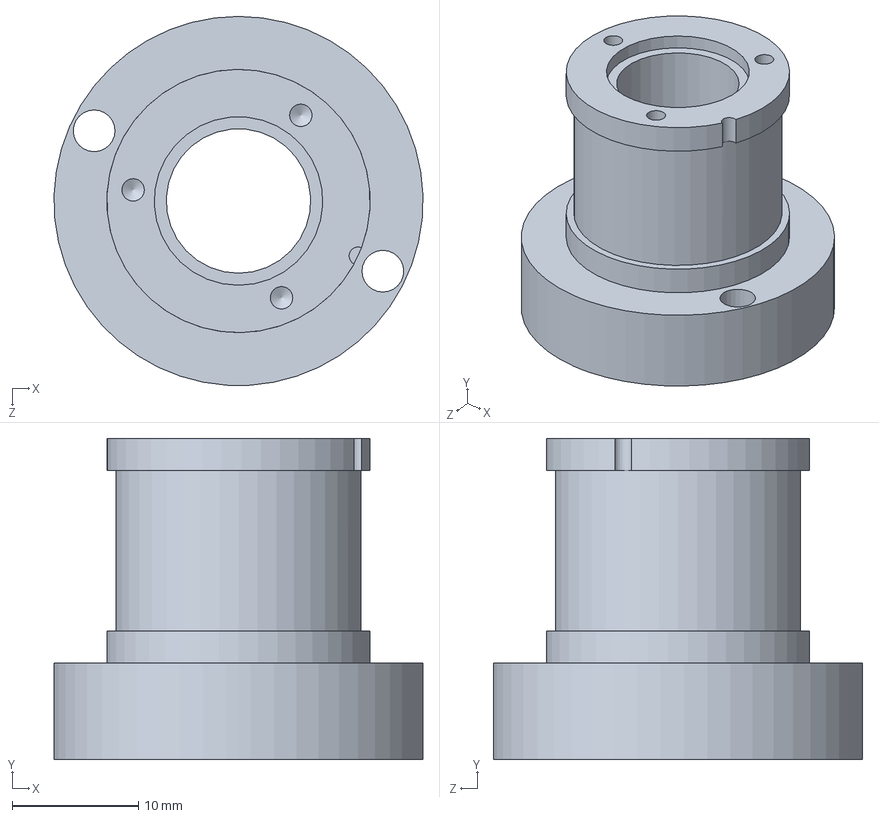
[picture p331: CAD file, 2026-07-06]
09_Kovachy_Lab/Copper Piece/Copper Base.SLDPRT
29.2 x 25.4 x 29.2 mm
