cross-isaac/IsaacCross_Senior_Thesis/09_Kovachy_Lab/Optics Board/Mounts/TR1.5-Solidworks.sldprt

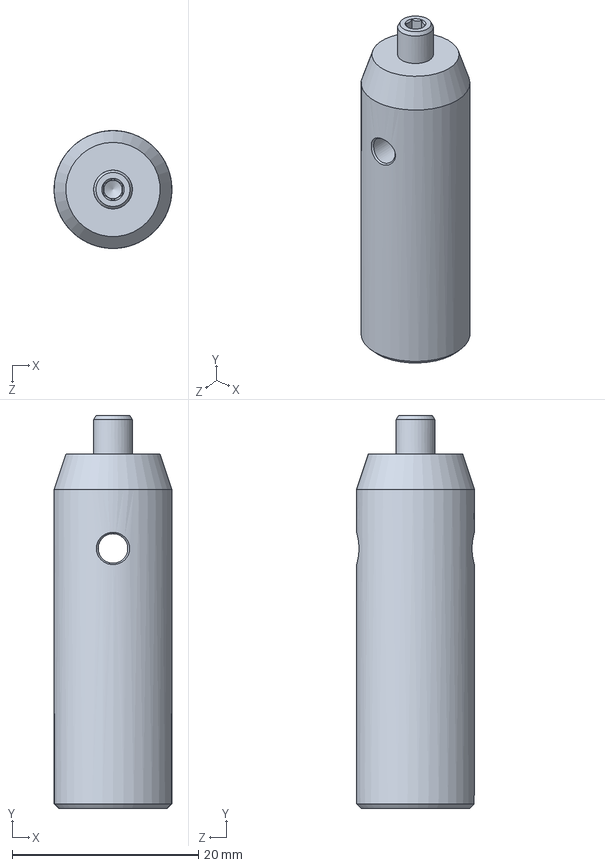
[picture p332: CAD file, 2026-07-06]
09_Kovachy_Lab/Optics Board/Mounts/TR1.5-Solidworks.sldprt
12.7 x 42.2 x 12.7 mm
