cross-isaac/IsaacCross_Senior_Thesis/09_Kovachy_Lab/Referene Cell/Reference Cell/hot window/0.5 inch sapph window design/0.5middlering.SLDPRT

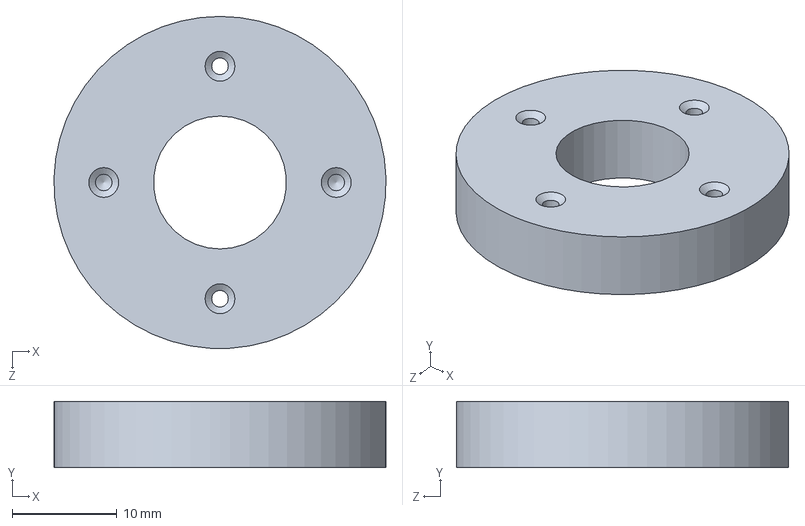
[picture p333: CAD file, 2026-07-06]
09_Kovachy_Lab/Referene Cell/Reference Cell/hot window/0.5 inch sapph window design/0.5middlering.SLDPRT
31.7 x 6.35 x 31.8 mm
