cross-isaac/IsaacCross_Senior_Thesis/09_Kovachy_Lab/Strontium Resevoir/oven/Oven.STEP/oven stack big.STEP

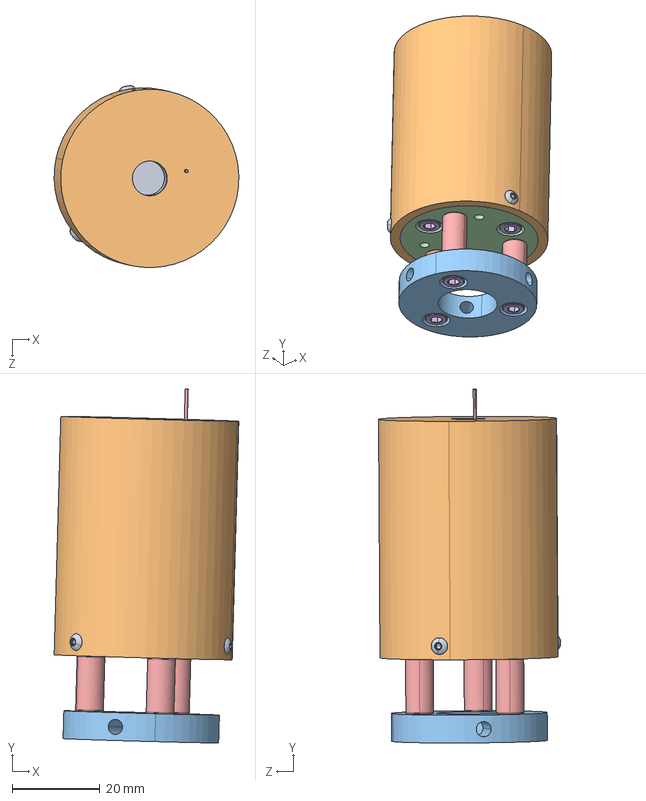
[picture p334: CAD file, 2026-07-06]
09_Kovachy_Lab/Strontium Resevoir/oven/Oven.STEP/oven stack big.STEP
42.1 x 80.7 x 41.5 mm
Sr Reservoir
shield
spaceroven (anchor)
spaceroven (shield)
94335A115_Electrical-Insulating Female Threaded Standoff_94335A115 x 6
92196A425_18-8 Stainless Steel Socket Head Screw_92196A425 x 12
TCapture
94610A210_Extreme-Temperature Ceramic Washer (1)_94610A210 x 2
92949A078_18-8 Stainless Steel Button Head Hex Drive Screw_92949A078 x 4
Sr Clamp
Sr Clamp 2
91771A931_Passivated 18-8 Stainless Steel Phillips Flat Head Screw_91771A931
3009A287_Hardened Undersized High-Speed M2 Tool Steel Rod_3009A287
