cross-isaac/IsaacCross_Senior_Thesis/09_Kovachy_Lab/Strontium Resevoir/oven/TCapture.SLDPRT

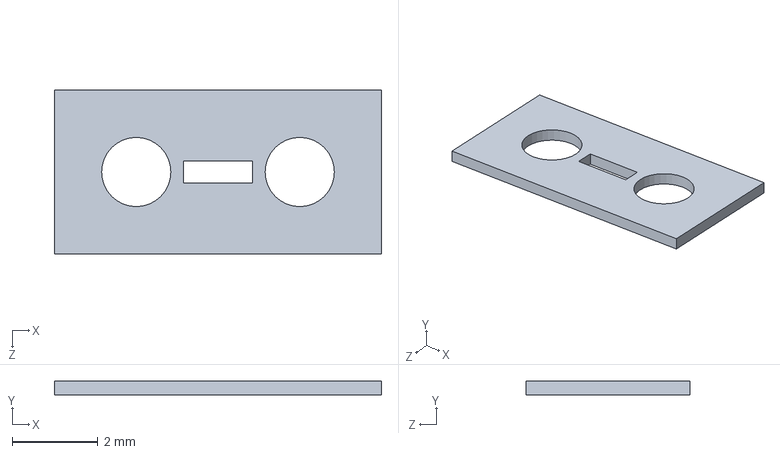
[picture p335: CAD file, 2026-07-06]
09_Kovachy_Lab/Strontium Resevoir/oven/TCapture.SLDPRT
7.62 x 0.317 x 3.81 mm
