cross-isaac/IsaacCross_Senior_Thesis/02_Beam_Source_Design/CAD/Crystal_Growth_Chamber/CHEX Cryo Chamber/CHEX stuff for Isaac/CHEX stuff for Isaac/Chex S ogi 1.stp

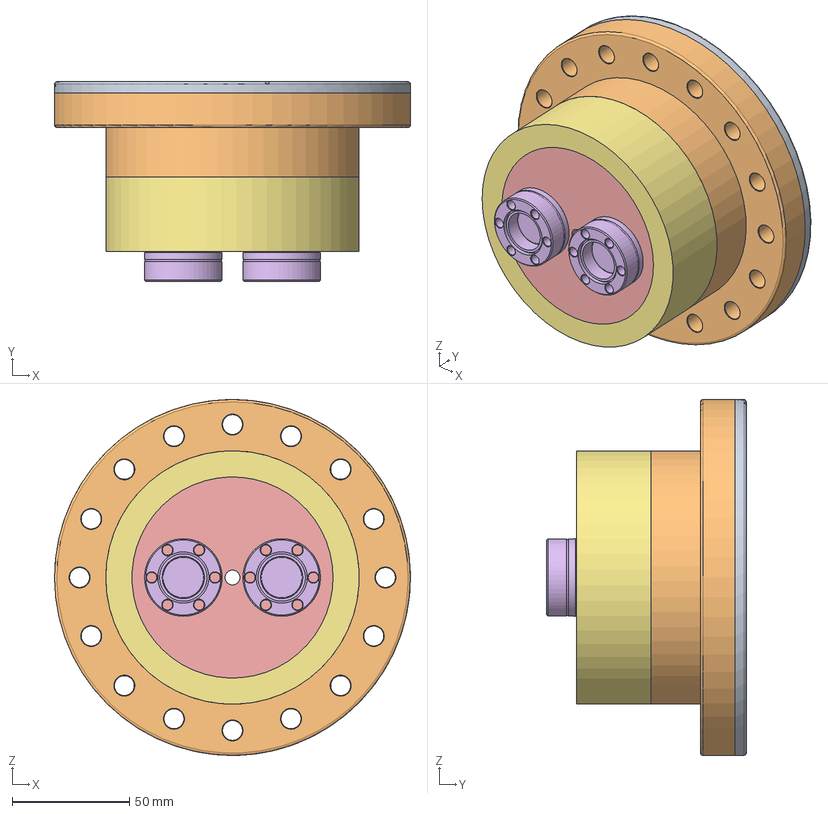
[picture p336: CAD file, 2026-07-06]
02_Beam_Source_Design/CAD/Crystal_Growth_Chamber/CHEX Cryo Chamber/CHEX stuff for Isaac/CHEX stuff for Isaac/Chex S ogi 1.stp
151.7 x 85.1 x 151.7 mm
LOS5021049
LOS5021027
CHEX S OGI 1 inner
CHEX S OGI 1 outer
