cross-isaac/IsaacCross_Senior_Thesis/02_Beam_Source_Design/CAD/Oven_SW_Models/Oven/Oven.STEP

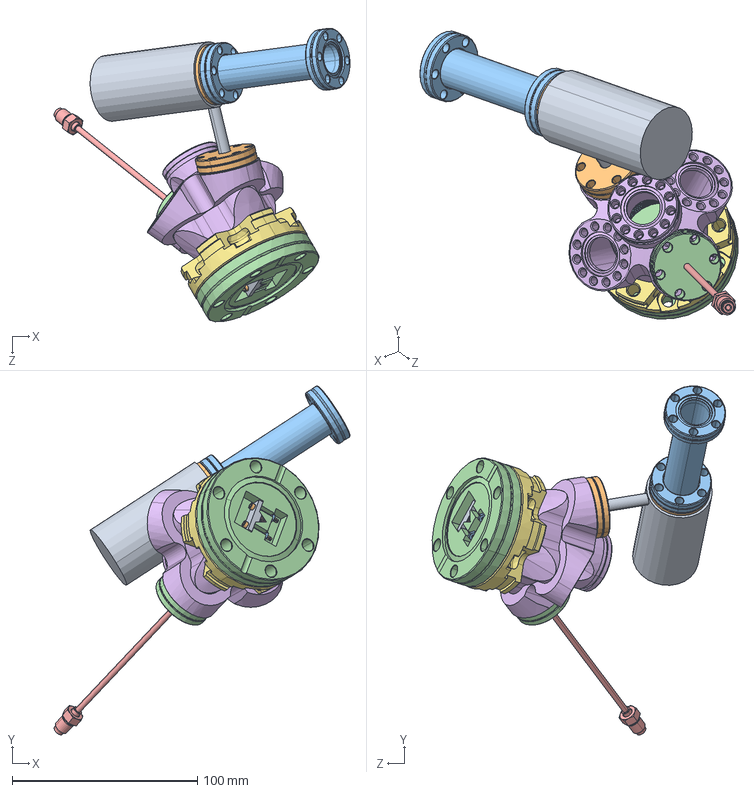
[picture p338: CAD file, 2026-07-06]
02_Beam_Source_Design/CAD/Oven_SW_Models/Oven/Oven.STEP
159.9 x 188.6 x 158.6 mm
NozzleClamp
92196A083_18-8 Stainless Steel Socket Head Screw_92196A083 x 2
91841A003_18-8 Stainless Steel Hex Nut_91841A003 x 2
ModDoubleBlank
Capillaries
Multiplexer
f0133x025n.stp x 2
fn-0133.stp
lft211temv
