cross-isaac/IsaacCross_Senior_Thesis/09_Kovachy_Lab/Copper Piece/2.0/copper base_square 2.1.SLDPRT

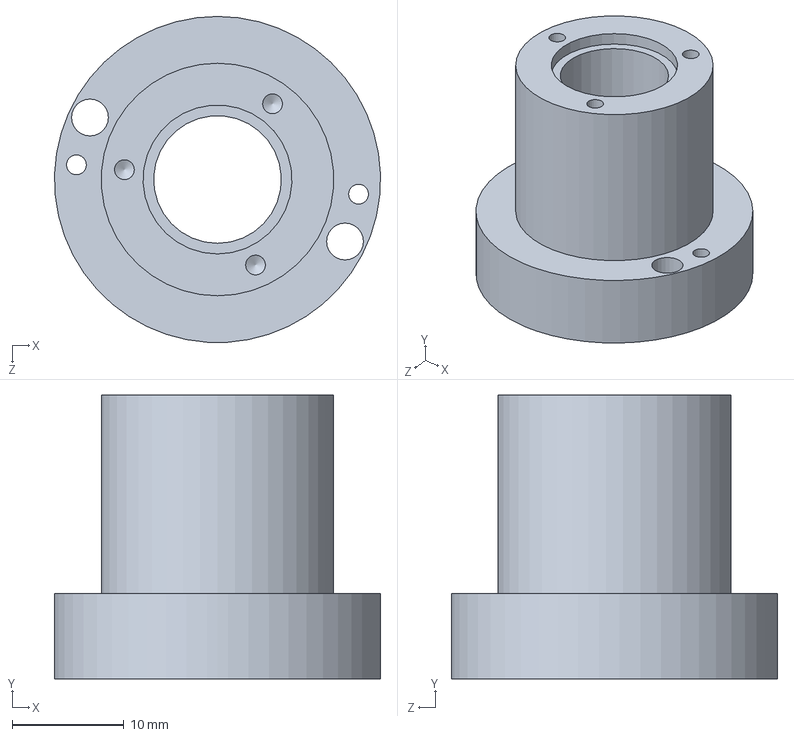
[picture p339: CAD file, 2026-07-06]
09_Kovachy_Lab/Copper Piece/2.0/copper base_square 2.1.SLDPRT
29.2 x 25.4 x 29.2 mm
