cross-isaac/IsaacCross_Senior_Thesis/09_Kovachy_Lab/Copper Piece/Copper Base Threaded.SLDPRT

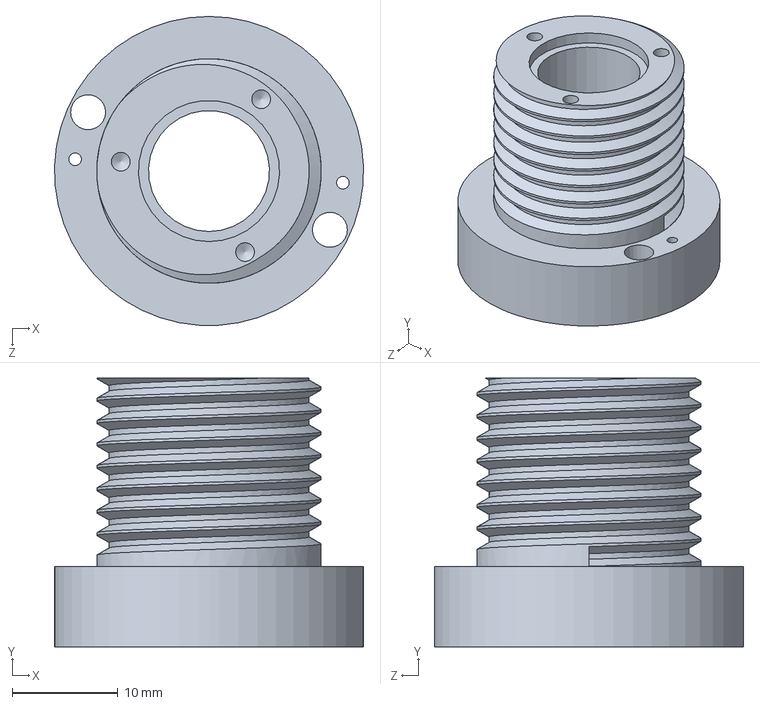
[picture p340: CAD file, 2026-07-06]
09_Kovachy_Lab/Copper Piece/Copper Base Threaded.SLDPRT
29.2 x 25.4 x 29.2 mm
