cross-isaac/IsaacCross_Senior_Thesis/09_Kovachy_Lab/Optics Board/Cylinder.SLDPRT

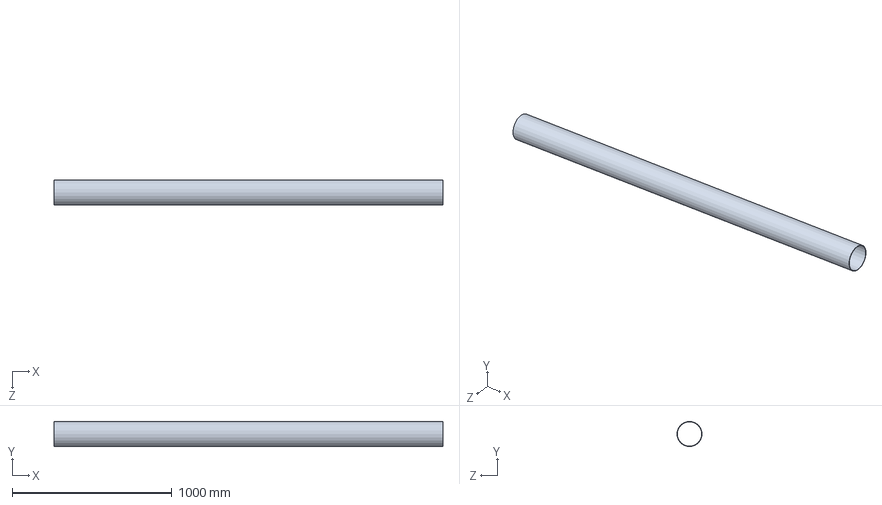
[picture p341: CAD file, 2026-07-06]
09_Kovachy_Lab/Optics Board/Cylinder.SLDPRT
2438.4 x 157.5 x 157.5 mm
