cross-isaac/IsaacCross_Senior_Thesis/09_Kovachy_Lab/Optics Board/Mounts/PM3-Solidworks.sldprt

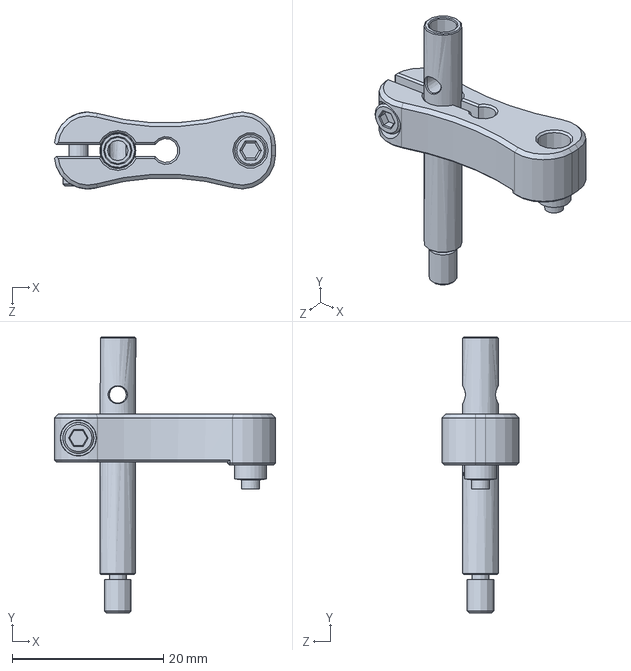
[picture p342: CAD file, 2026-07-06]
09_Kovachy_Lab/Optics Board/Mounts/PM3-Solidworks.sldprt
29.2 x 36.4 x 10.2 mm
