cross-isaac/IsaacCross_Senior_Thesis/09_Kovachy_Lab/Referene Cell/Reference Cell/hot window/0.5 inch sapph window design/0.5copperbase.SLDPRT

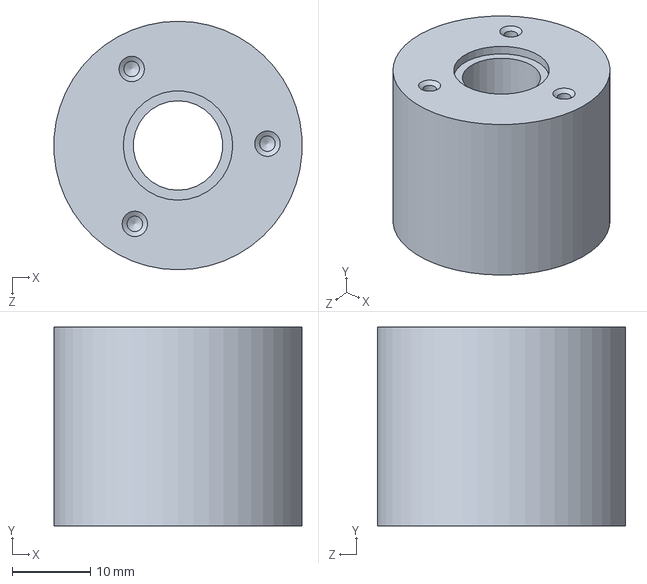
[picture p343: CAD file, 2026-07-06]
09_Kovachy_Lab/Referene Cell/Reference Cell/hot window/0.5 inch sapph window design/0.5copperbase.SLDPRT
31.7 x 25.4 x 31.8 mm
