cross-isaac/IsaacCross_Senior_Thesis/09_Kovachy_Lab/Referene Cell/Reference Cell/vpzl-275.stp

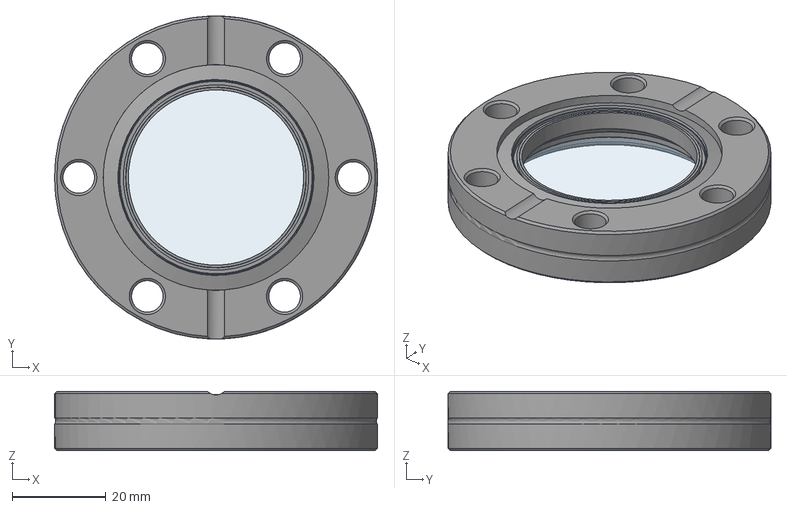
[picture p344: CAD file, 2026-07-06]
09_Kovachy_Lab/Referene Cell/Reference Cell/vpzl-275.stp
69.1 x 69.1 x 12.7 mm
