cross-isaac/IsaacCross_Senior_Thesis/02_Beam_Source_Design/CAD/Chamber_SW_Models/dff133x000.SLDPRT

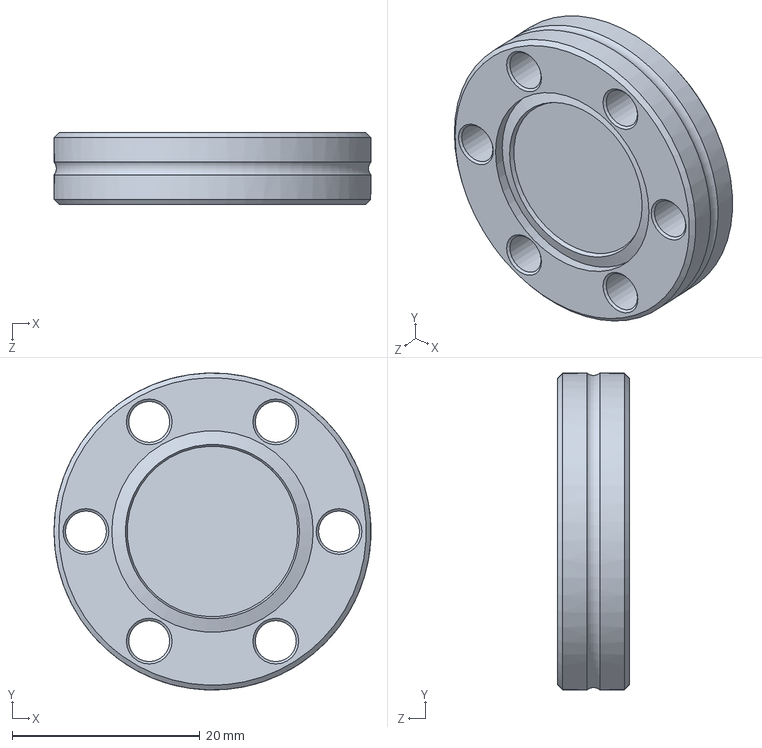
[picture p346: CAD file, 2026-07-06]
02_Beam_Source_Design/CAD/Chamber_SW_Models/dff133x000.SLDPRT
33.8 x 33.8 x 7.62 mm
