cross-isaac/IsaacCross_Senior_Thesis/02_Beam_Source_Design/CAD/Crystal_Growth_Chamber/Local Chamber/Simple CryoStat.SLDPRT

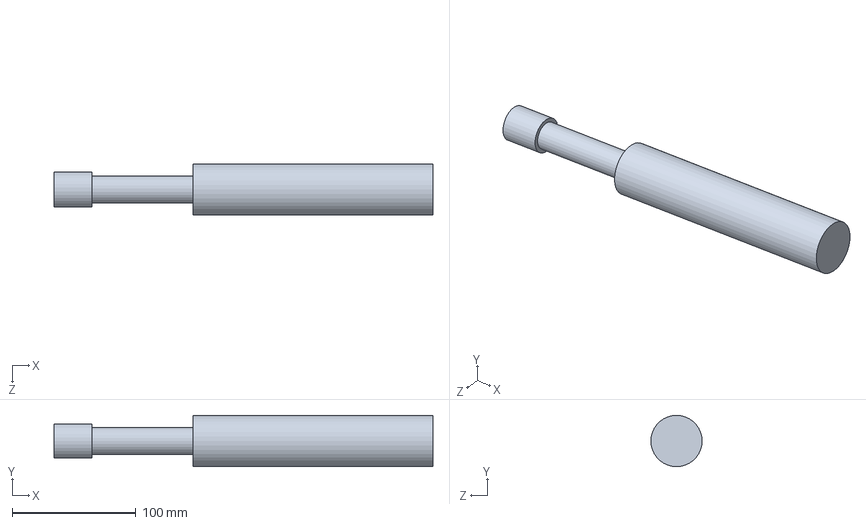
[picture p347: CAD file, 2026-07-06]
02_Beam_Source_Design/CAD/Crystal_Growth_Chamber/Local Chamber/Simple CryoStat.SLDPRT
305.8 x 41.4 x 41.4 mm
