cross-isaac/IsaacCross_Senior_Thesis/02_Beam_Source_Design/CAD/Oven_SW_Models/Nozzle/SquareHolder.SLDPRT

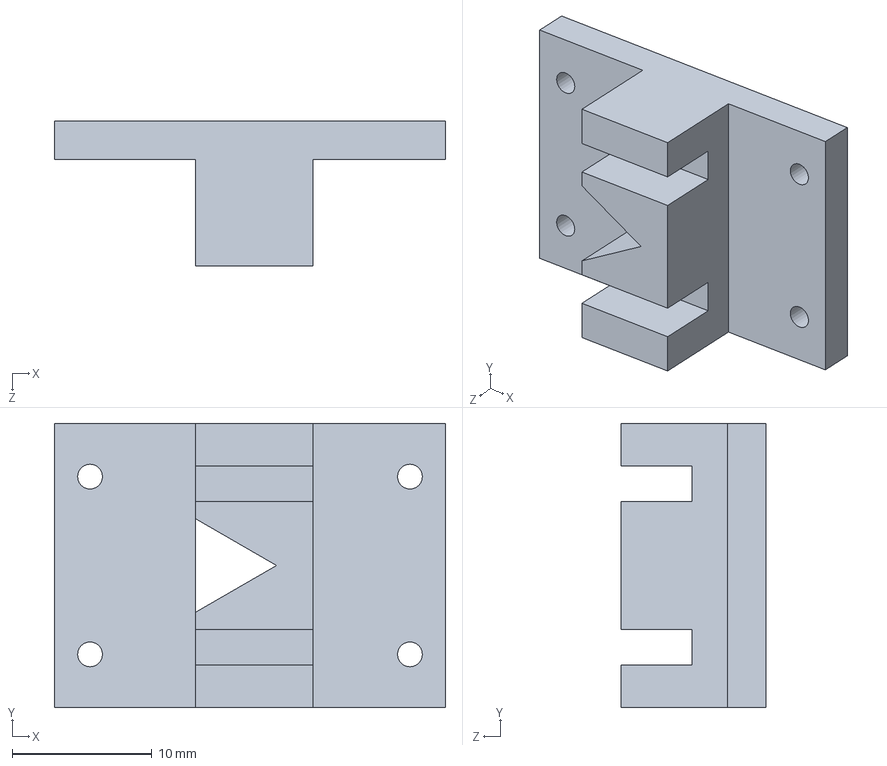
[picture p348: CAD file, 2026-07-06]
02_Beam_Source_Design/CAD/Oven_SW_Models/Nozzle/SquareHolder.SLDPRT
27.9 x 20.3 x 10.4 mm
