cross-isaac/IsaacCross_Senior_Thesis/09_Kovachy_Lab/Optics Board/Mounts/KS1CE-Solidworks.sldprt

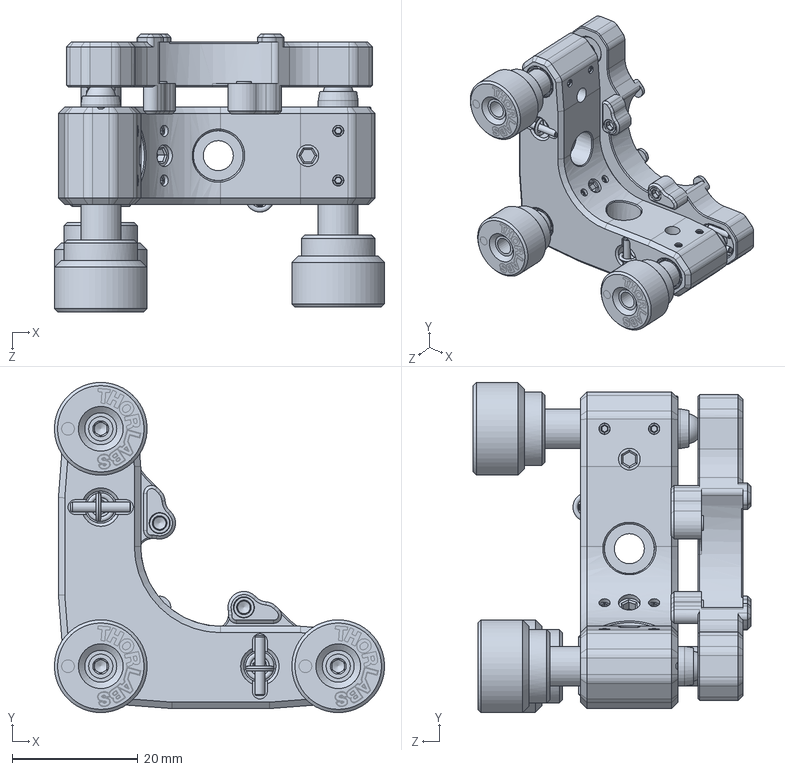
[picture p349: CAD file, 2026-07-06]
09_Kovachy_Lab/Optics Board/Mounts/KS1CE-Solidworks.sldprt
52.4 x 52.5 x 44.1 mm
