cross-isaac/IsaacCross_Senior_Thesis/09_Kovachy_Lab/Optics Board/PDA8A2-Solidworks.sldprt

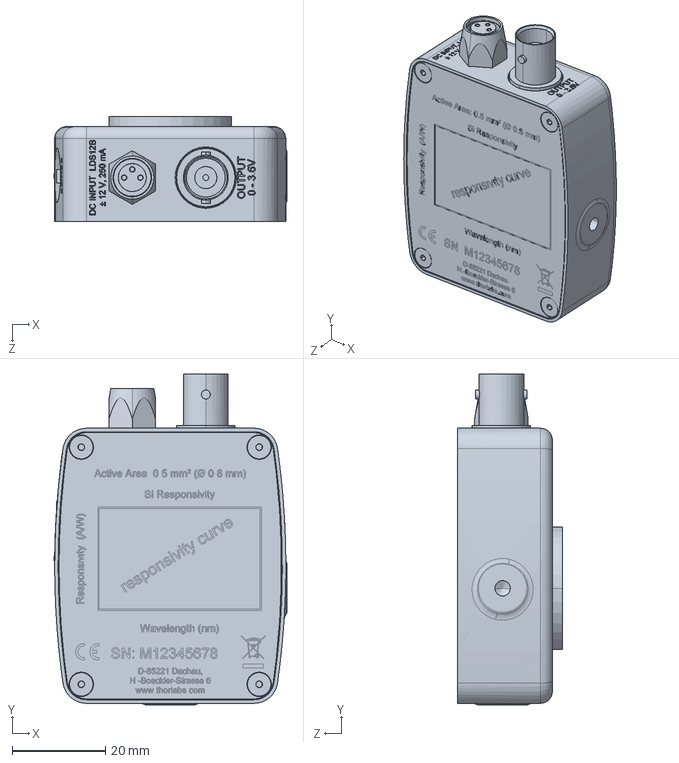
[picture p350: CAD file, 2026-07-06]
09_Kovachy_Lab/Optics Board/PDA8A2-Solidworks.sldprt
49.9 x 70.9 x 22.5 mm
