cross-isaac/IsaacCross_Senior_Thesis/09_Kovachy_Lab/Referene Cell/Reference Cell/hot window/TCcapture.SLDPRT

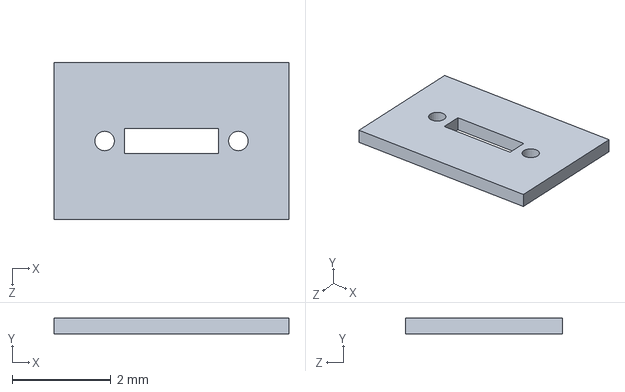
[picture p351: CAD file, 2026-07-06]
09_Kovachy_Lab/Referene Cell/Reference Cell/hot window/TCcapture.SLDPRT
4.76 x 0.317 x 3.17 mm
