cross-isaac/IsaacCross_Senior_Thesis/09_Kovachy_Lab/Referene Cell/Reference Cell/t-0275.stp

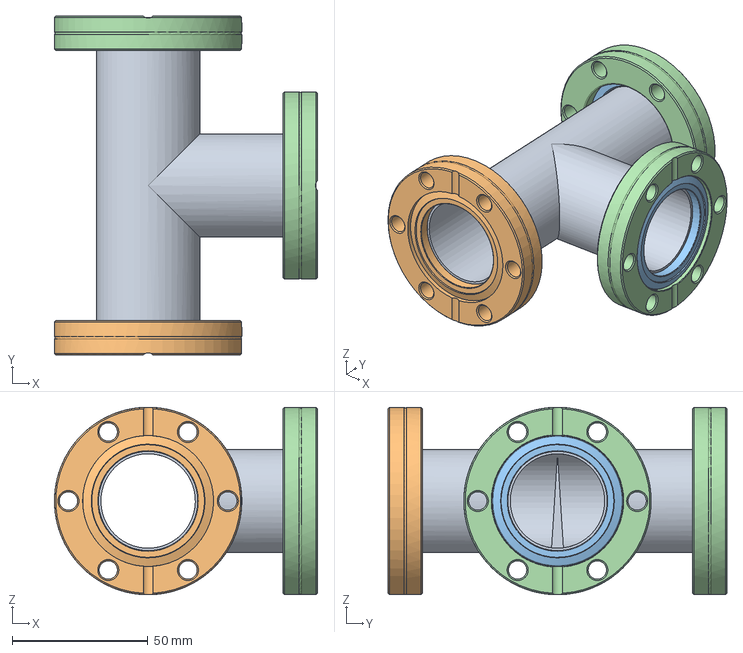
[picture p352: CAD file, 2026-07-06]
09_Kovachy_Lab/Referene Cell/Reference Cell/t-0275.stp
97.0 x 124.9 x 69.1 mm
