cross-isaac/IsaacCross_Senior_Thesis/02_Beam_Source_Design/CAD/Crystal_Growth_Chamber/Local Chamber/inner chamber flange pipe draft.stp.SLDPRT

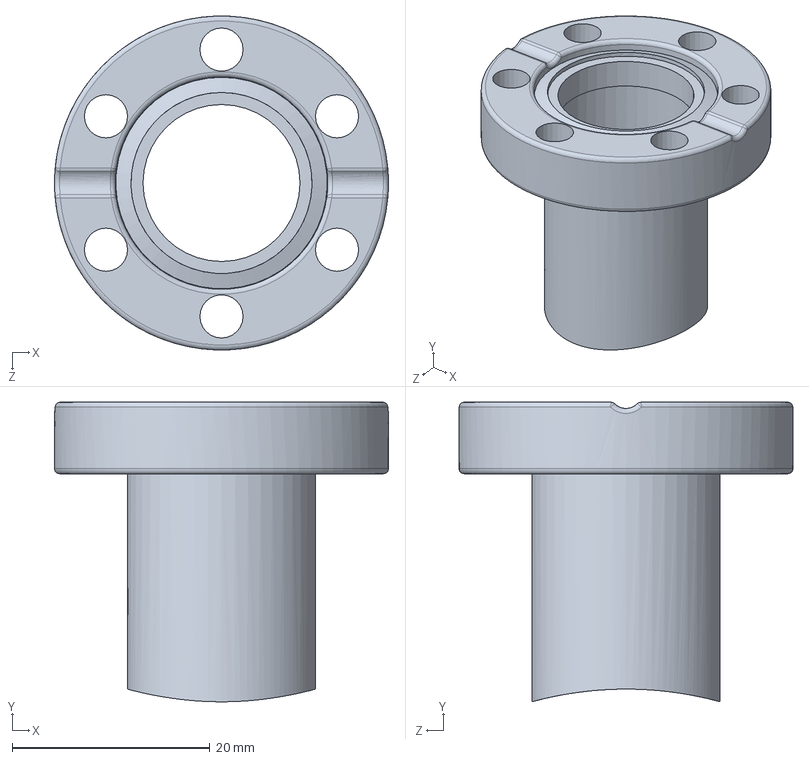
[picture p353: CAD file, 2026-07-06]
02_Beam_Source_Design/CAD/Crystal_Growth_Chamber/Local Chamber/inner chamber flange pipe draft.stp.SLDPRT
33.8 x 30.3 x 33.8 mm
