cross-isaac/IsaacCross_Senior_Thesis/02_Beam_Source_Design/CAD/Oven_SW_Models/Nozzle/Microcapillary (.004 ID .008 OD).SLDPRT

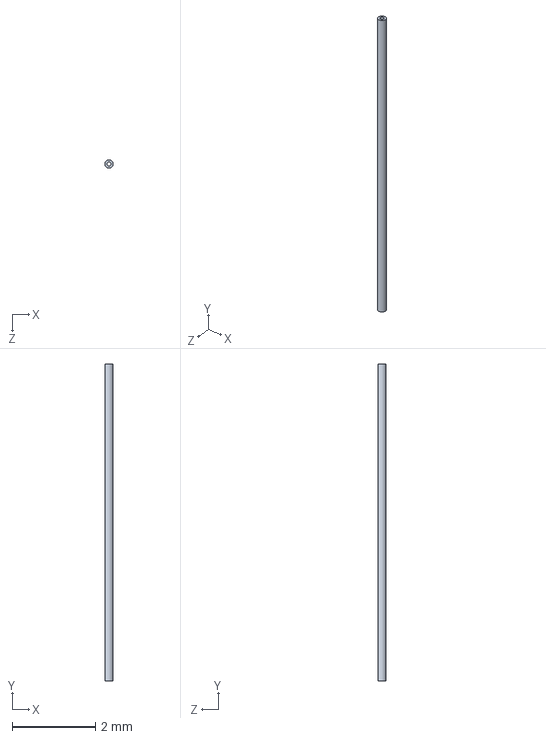
[picture p354: CAD file, 2026-07-06]
02_Beam_Source_Design/CAD/Oven_SW_Models/Nozzle/Microcapillary (.004 ID .008 OD).SLDPRT
0.202 x 7.62 x 0.203 mm
