cross-isaac/IsaacCross_Senior_Thesis/09_Kovachy_Lab/Optics Board/Mounts/TR2-Solidworks.sldprt

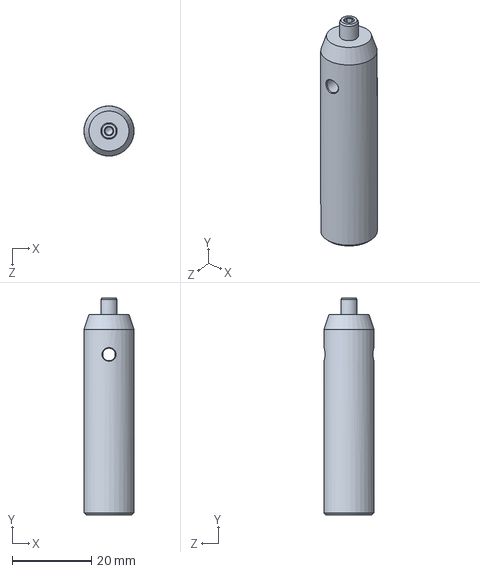
[picture p355: CAD file, 2026-07-06]
09_Kovachy_Lab/Optics Board/Mounts/TR2-Solidworks.sldprt
12.7 x 54.9 x 12.7 mm
