cross-isaac/IsaacCross_Senior_Thesis/09_Kovachy_Lab/Optics Board/Optics Board Laser.SLDPRT

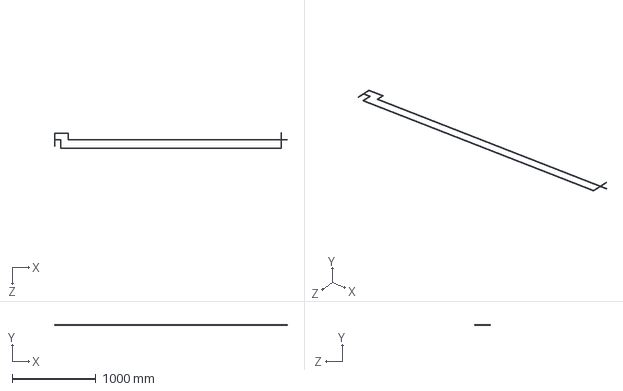
[picture p356: CAD file, 2026-07-06]
09_Kovachy_Lab/Optics Board/Optics Board Laser.SLDPRT
2776.7 x 6.73 x 191.6 mm
