cross-isaac/IsaacCross_Senior_Thesis/09_Kovachy_Lab/Referene Cell/Reference Cell/hot window/window capture ring.SLDPRT

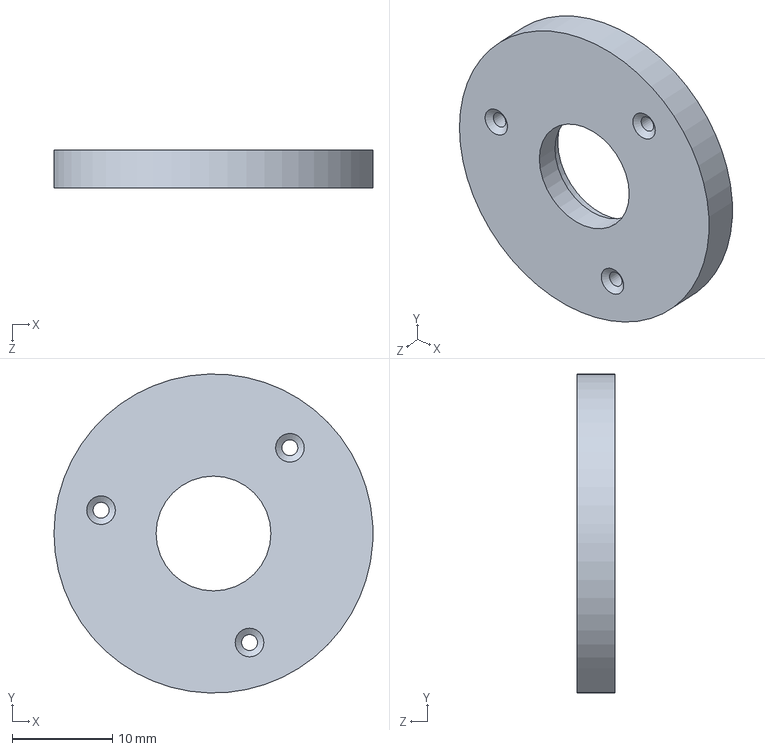
[picture p357: CAD file, 2026-07-06]
09_Kovachy_Lab/Referene Cell/Reference Cell/hot window/window capture ring.SLDPRT
31.8 x 31.7 x 3.81 mm
