cross-isaac/IsaacCross_Senior_Thesis/02_Beam_Source_Design/CAD/Chamber_SW_Models/fn-0275s.SLDASM

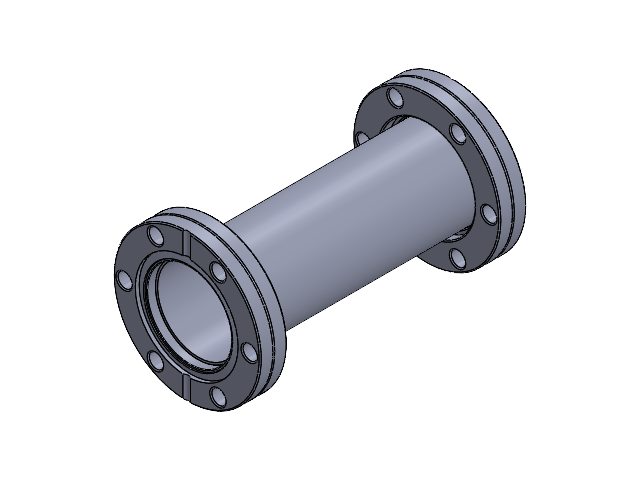
[picture p358: CAD file, 2026-07-06]
02_Beam_Source_Design/CAD/Chamber_SW_Models/fn-0275s.SLDASM
P0001617.stp
P0000133.stp
P0000436_2.stp
P0000490.stp
