cross-isaac/IsaacCross_Senior_Thesis/02_Beam_Source_Design/CAD/Oven_SW_Models/Oven V1.SLDASM

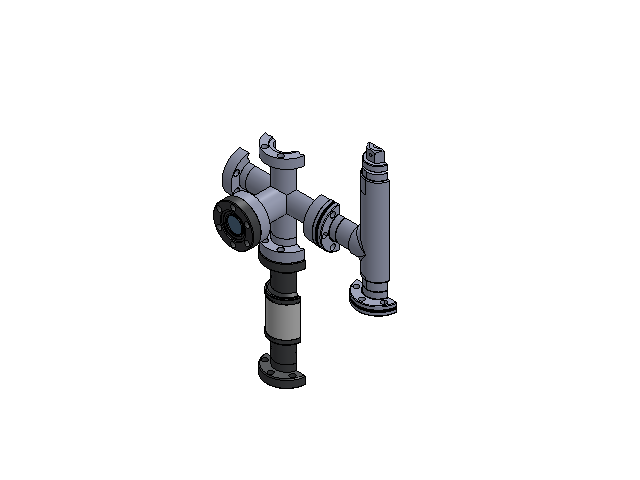
[picture p359: CAD file, 2026-07-06]
02_Beam_Source_Design/CAD/Oven_SW_Models/Oven V1.SLDASM
thermal break
cross
valve
vpzl-133ss.stp x 2
Nozzle
