cross-isaac/IsaacCross_Senior_Thesis/09_Kovachy_Lab/Copper Piece/Copper Base + Cap.SLDASM

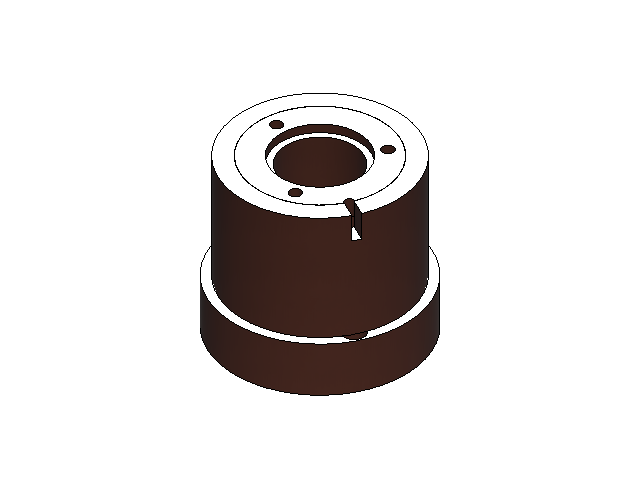
[picture p360: CAD file, 2026-07-06]
09_Kovachy_Lab/Copper Piece/Copper Base + Cap.SLDASM
Copper Base
Copper Cap
