cross-isaac/IsaacCross_Senior_Thesis/02_Beam_Source_Design/CAD/Oven_SW_Models/Nozzle/Nozzle2.SLDASM

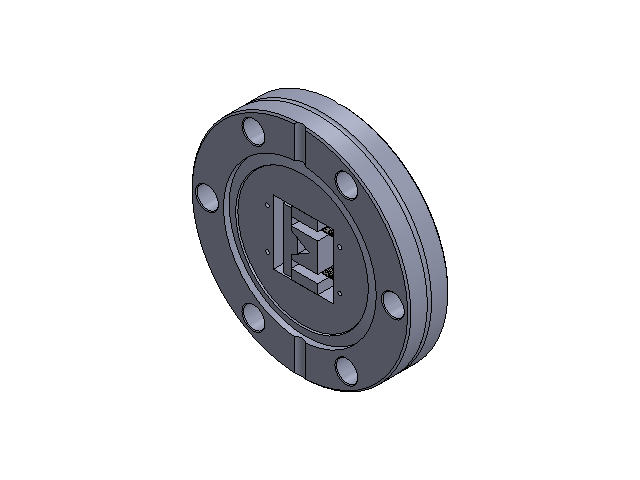
[picture p361: CAD file, 2026-07-06]
02_Beam_Source_Design/CAD/Oven_SW_Models/Nozzle/Nozzle2.SLDASM
ModDoubleBlankCopy
92196A083_18-8 Stainless Steel Socket Head Screw x 2
NozzleClamp
ModDoubleBlank2
