cross-isaac/IsaacCross_Senior_Thesis/09_Kovachy_Lab/Optics Board/Optics Board Vapor Cell.SLDASM

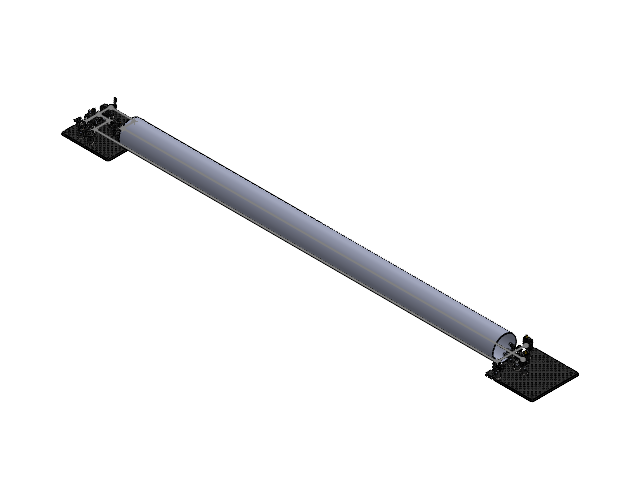
[picture p362: CAD file, 2026-07-06]
09_Kovachy_Lab/Optics Board/Optics Board Vapor Cell.SLDASM
MB12D-Solidworks x 2
WPH05M-694-Solidworks x 2
BE1-Solidworks x 15
TR1.5-Solidworks x 15
PH1.5-Solidworks x 15
RSP1-Solidworks x 2
PM3-Solidworks x 2
KM100PM-Solidworks x 2
PBS122-Solidworks x 2
KS1CE-Solidworks x 6
PF10-03-G01-Solidworks x 6
PDA8A2-Solidworks x 2
AD15NT-Solidworks
F810APC-635-Solidworks
KM100-Solidworks (2)
LBF254-040-Solidworks x 2
LMR1-Solidworks (1) x 2
Thick Laser
