cross-isaac/IsaacCross_Senior_Thesis/09_Kovachy_Lab/Strontium Resevoir/oven/Strontium Oven.SLDASM

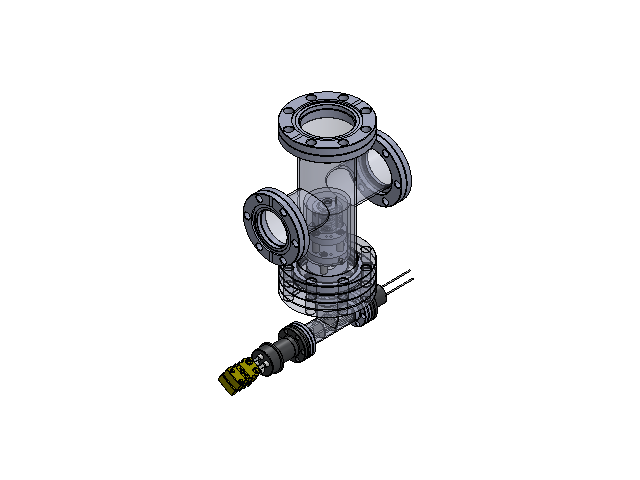
[picture p363: CAD file, 2026-07-06]
09_Kovachy_Lab/Strontium Resevoir/oven/Strontium Oven.SLDASM
P0000439.stp
P0000494.stp
P0000489.stp
P0000436.stp
P0000157.stp
P0002155.stp
P0000127.stp
Sr Reservoir
shield
spaceroven (anchor)
spaceroven (shield)
94335A115_Electrical-Insulating Female Threaded Standoff x 6
92196A425_18-8 Stainless Steel Socket Head Screw x 12
TCapture
94610A210_Extreme-Temperature Ceramic Washer (1) x 2
92949A078_18-8 Stainless Steel Button Head Hex Drive Screw x 4
Sr Clamp
Sr Clamp 2
91771A931_Passivated 18-8 Stainless Steel Phillips Flat Head Screw
3009A287_Hardened Undersized High-Speed M2 Tool Steel Rod
92311A193_18-8 Stainless Steel Cup-Point Set Screw x 3
rf337x133.stp
P0001598_1.stp x 2
P0000430_1.stp x 2
P0002051_1.stp
P0001581_1.stp
tft2ky00002.stp
eft0124052z.stp
