cross-isaac/IsaacCross_Senior_Thesis/02_Beam_Source_Design/CAD/Crystal_Growth_Chamber/CHEX Aparatus 2/Feedthru int for IC (1)/Feedthru int 4drawing.SLDASM

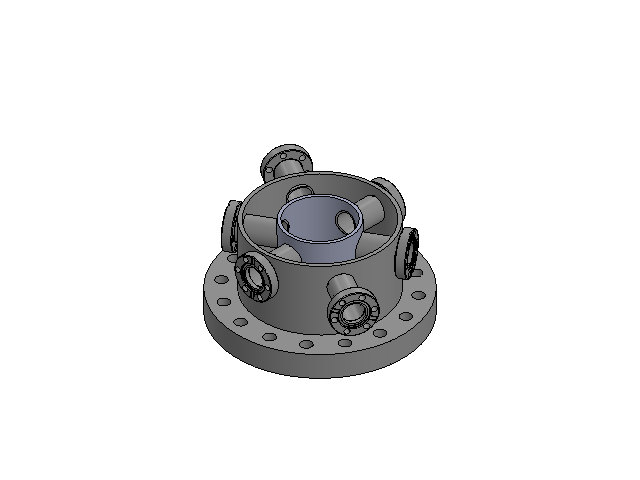
[picture p364: CAD file, 2026-07-06]
02_Beam_Source_Design/CAD/Crystal_Growth_Chamber/CHEX Aparatus 2/Feedthru int for IC (1)/Feedthru int 4drawing.SLDASM
SChex dkl 1 x 2
longer flange thing draft x 6
Inner Feedthrough Chamber
feedthru int a2
