cross-isaac/IsaacCross_Senior_Thesis/02_Beam_Source_Design/CAD/Chamber_SW_Models/Block Diagram UHV chamber.SLDASM

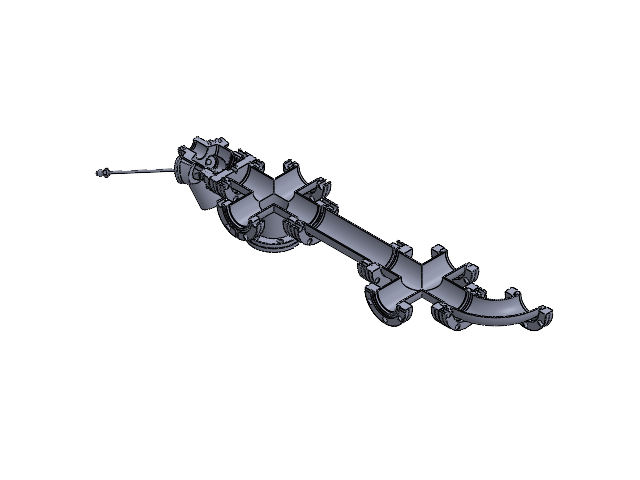
[picture p365: CAD file, 2026-07-06]
02_Beam_Source_Design/CAD/Chamber_SW_Models/Block Diagram UHV chamber.SLDASM
P0000489.stp x 3
P0000436.stp x 3
P0002135.stp
P0000127.stp x 3
P0001617.stp
P0000133.stp
P0000436_2.stp
P0000490.stp
P0000489_2.stp x 2
P0000436_3.stp x 2
P0002094.stp
P0000127_2.stp x 2
P0000489_3.stp x 2
P0000436_4.stp x 2
P0002031.stp
Multiplexer
ModifiedFlangeV1
f0133x025n.stp
ArLine
