cross-isaac/IsaacCross_Senior_Thesis/09_Kovachy_Lab/Strontium Resevoir/Assembled Res 1.0.SLDASM

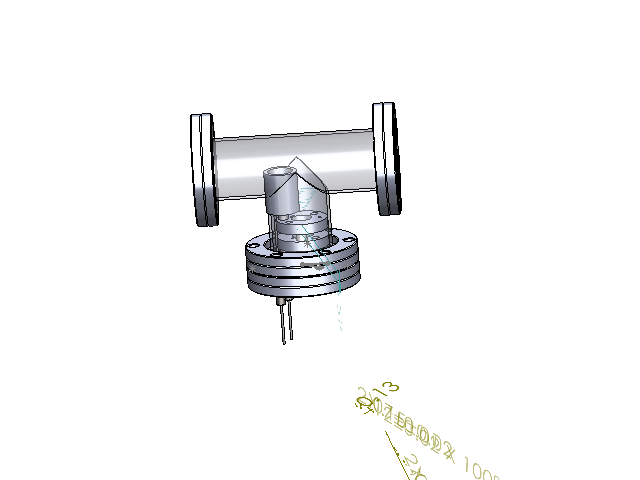
[picture p366: CAD file, 2026-07-06]
09_Kovachy_Lab/Strontium Resevoir/Assembled Res 1.0.SLDASM
0.5outerringRHD
0.5middleringRHD x 2
spacer x 5
92311A193_18-8 Stainless Steel Cup-Point Set Screw x 2
Resevoir isolated 1.0
f0275x000_modified
P108041 x 2
P0000489.stp x 2
P0000436.stp x 2
P0002053.stp
P0000127.stp
