cross-isaac/IsaacCross_Senior_Thesis/02_Beam_Source_Design/CAD/Chamber_SW_Models/Block Diagram Beam Source.SLDASM

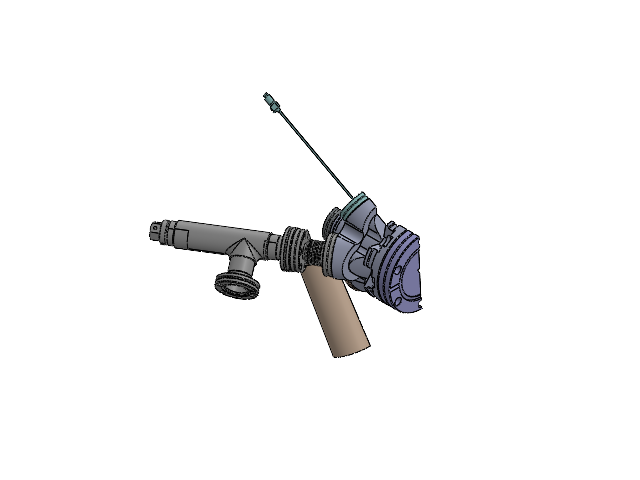
[picture p367: CAD file, 2026-07-06]
02_Beam_Source_Design/CAD/Chamber_SW_Models/Block Diagram Beam Source.SLDASM
Multiplexer
ModifiedFlangeV1
f0133x025n.stp
ArLine
vzcr20r
vpzl-133ldio3
f0133n000tln
P0000430.stp
P0000472.stp
24015-BELLOWS-CORE.stp
24015-CONVOLUTION_DBLS.stp x 2
AM00834_AM00834D00500W035L0310M01.stp x 2
24015-F0133X000N.stp
