cross-isaac/IsaacCross_Senior_Thesis/02_Beam_Source_Design/CAD/Crystal_Growth_Chamber/CHEX Cryo Chamber/CHEX stuff for Isaac/CHEX stuff for Isaac/CHEX L/Chex L ogi 1.SLDASM

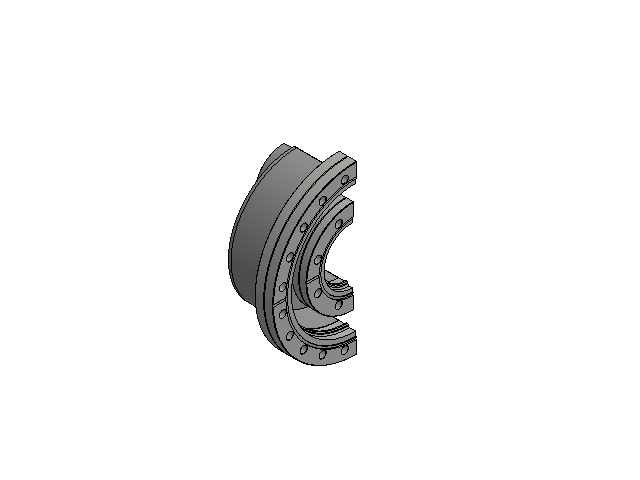
[picture p368: CAD file, 2026-07-06]
02_Beam_Source_Design/CAD/Crystal_Growth_Chamber/CHEX Cryo Chamber/CHEX stuff for Isaac/CHEX stuff for Isaac/CHEX L/Chex L ogi 1.SLDASM
5004149.stp
5004103.stp
L OGI outer 1.stp
L OGI Inner.stp
9110027.stp x 2
