cross-isaac/IsaacCross_Senior_Thesis/09_Kovachy_Lab/Strontium Resevoir/Assembled Res 3.40.SLDASM

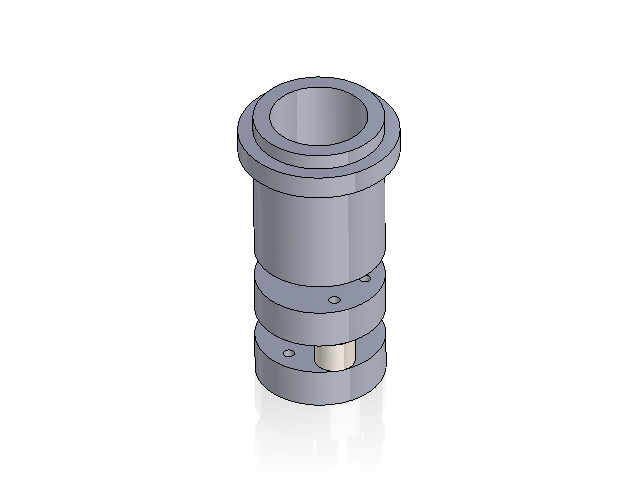
[picture p369: CAD file, 2026-07-06]
09_Kovachy_Lab/Strontium Resevoir/Assembled Res 3.40.SLDASM
Basic metal plate x 2
spacer x 3
Resevoir isolated 2.0
