cross-isaac/IsaacCross_Senior_Thesis/02_Beam_Source_Design/CAD/Oven_SW_Models/Oven/LeakValve.SLDASM

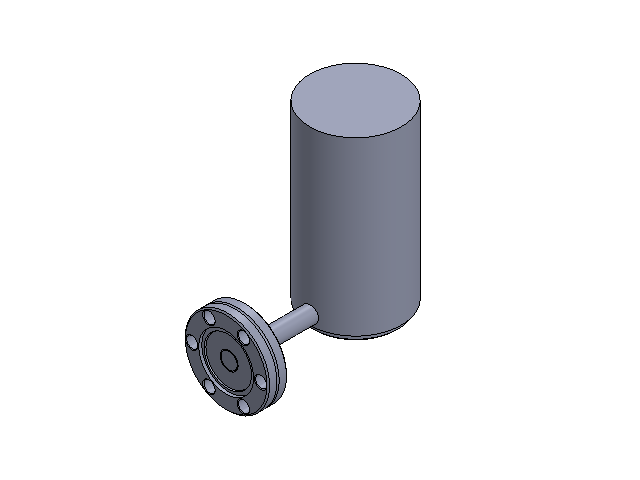
[picture p370: CAD file, 2026-07-06]
02_Beam_Source_Design/CAD/Oven_SW_Models/Oven/LeakValve.SLDASM
f0133x025n.stp x 2
