cross-isaac/IsaacCross_Senior_Thesis/02_Beam_Source_Design/CAD/Crystal_Growth_Chamber/CHEX Cryo Chamber/CHEX stuff for Isaac/CHEX stuff for Isaac/CHEX S/Chex S ogi 1.SLDASM

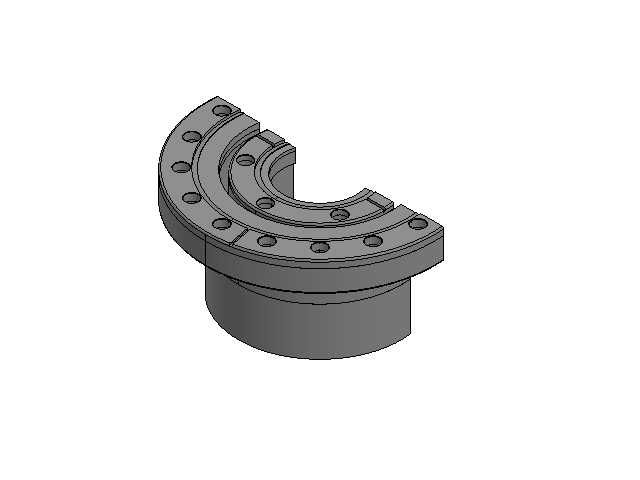
[picture p371: CAD file, 2026-07-06]
02_Beam_Source_Design/CAD/Crystal_Growth_Chamber/CHEX Cryo Chamber/CHEX stuff for Isaac/CHEX stuff for Isaac/CHEX S/Chex S ogi 1.SLDASM
LOS5021049.stp
LOS5021027.stp
CHEX S OGI 1 inner.stp
9110025.stp x 2
CHEX S OGI 1 outer.stp
