cross-isaac/IsaacCross_Senior_Thesis/09_Kovachy_Lab/Strontium Resevoir/Cross Connector.SLDASM

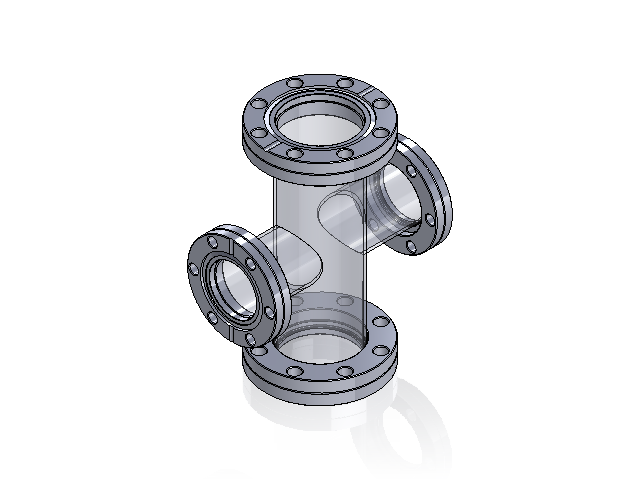
[picture p372: CAD file, 2026-07-06]
09_Kovachy_Lab/Strontium Resevoir/Cross Connector.SLDASM
P0000439.stp
P0000494.stp
P0000489.stp
P0000436.stp
P0000157.stp
P0002155.stp
P0000127.stp
