cross-isaac/IsaacCross_Senior_Thesis/09_Kovachy_Lab/Strontium Resevoir/oven/oven stack big.SLDASM

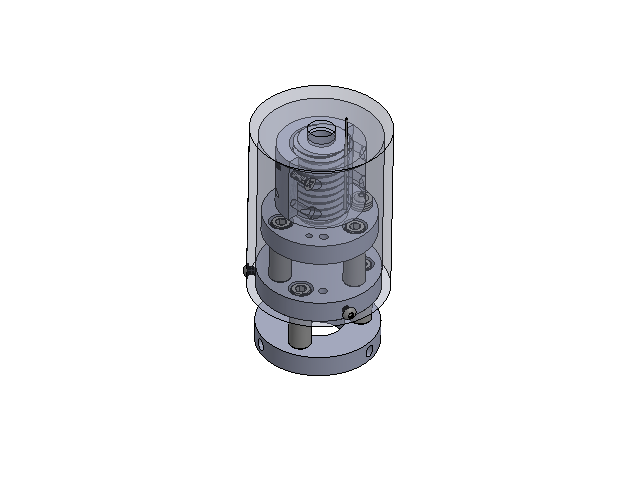
[picture p373: CAD file, 2026-07-06]
09_Kovachy_Lab/Strontium Resevoir/oven/oven stack big.SLDASM
Sr Reservoir
shield
spaceroven (anchor)
spaceroven (shield)
94335A115_Electrical-Insulating Female Threaded Standoff x 6
92196A425_18-8 Stainless Steel Socket Head Screw x 12
TCapture
94610A210_Extreme-Temperature Ceramic Washer (1) x 2
92949A078_18-8 Stainless Steel Button Head Hex Drive Screw x 4
Sr Clamp
Sr Clamp 2
91771A931_Passivated 18-8 Stainless Steel Phillips Flat Head Screw
3009A287_Hardened Undersized High-Speed M2 Tool Steel Rod
