cross-isaac/IsaacCross_Senior_Thesis/02_Beam_Source_Design/CAD/Chamber_SW_Models/l-0275.SLDASM

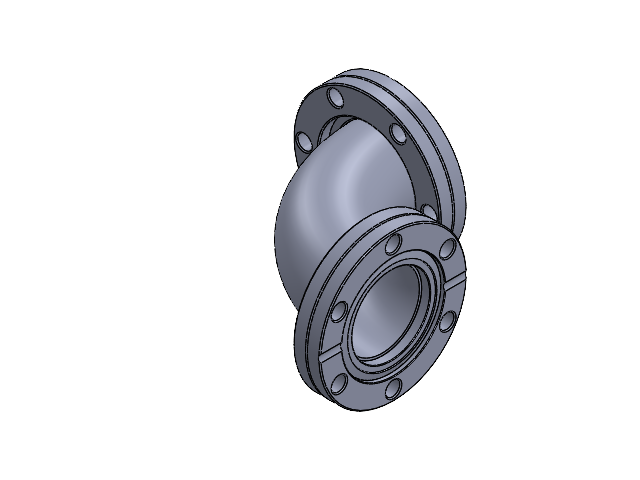
[picture p374: CAD file, 2026-07-06]
02_Beam_Source_Design/CAD/Chamber_SW_Models/l-0275.SLDASM
P0000489_3.stp x 2
P0000436_4.stp x 2
P0002031.stp
