cross-isaac/IsaacCross_Senior_Thesis/09_Kovachy_Lab/Strontium Resevoir/All Together 2.0.SLDASM

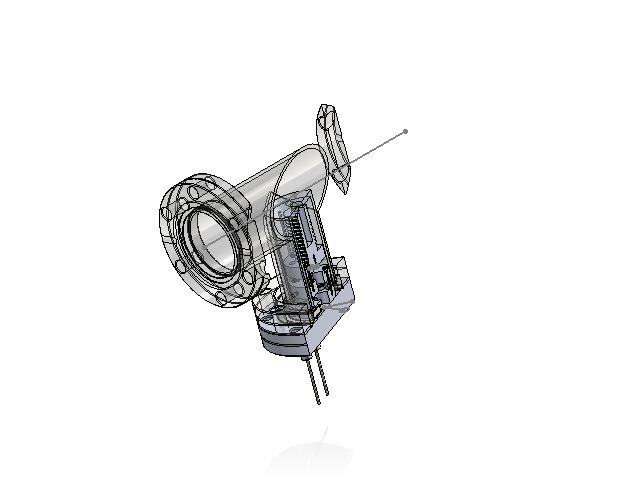
[picture p375: CAD file, 2026-07-06]
09_Kovachy_Lab/Strontium Resevoir/All Together 2.0.SLDASM
f0275x000_modified
P108041 x 2
P0000489.stp x 2
P0000436.stp x 2
P0002053.stp
P0000127.stp
reservoir
spaceroven (anchor)
spaceroven (shield)
shield
3-16_Spacer x 6
2-56 SH Screw x 6
TCcapture
92311A193_18-8 Stainless Steel Cup-Point Set Screw x 3
