cross-isaac/IsaacCross_Senior_Thesis/02_Beam_Source_Design/CAD/Chamber_SW_Models/c-0275.SLDASM

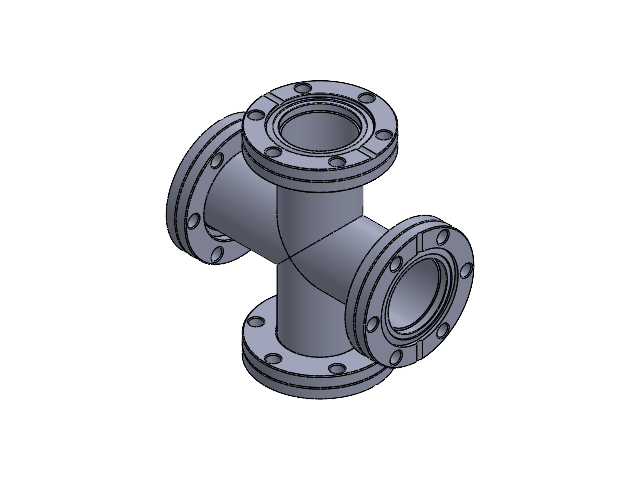
[picture p376: CAD file, 2026-07-06]
02_Beam_Source_Design/CAD/Chamber_SW_Models/c-0275.SLDASM
P0000489_2.stp x 2
P0000436_3.stp x 2
P0002094.stp
P0000127_2.stp x 2
