cross-isaac/IsaacCross_Senior_Thesis/02_Beam_Source_Design/CAD/Chamber_SW_Models/c6-0275.SLDASM

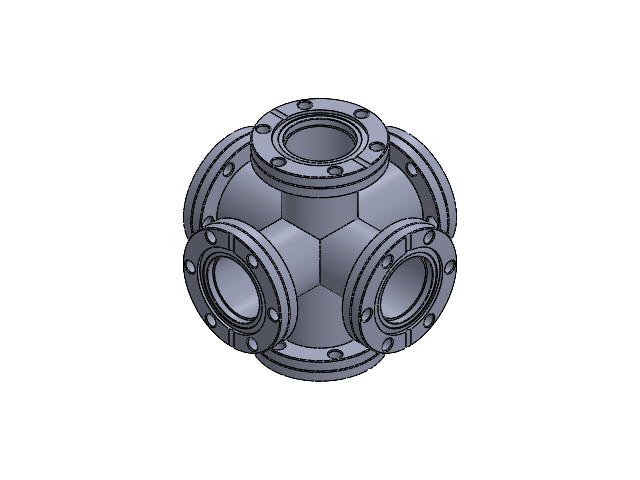
[picture p377: CAD file, 2026-07-06]
02_Beam_Source_Design/CAD/Chamber_SW_Models/c6-0275.SLDASM
P0000489.stp x 3
P0000436.stp x 3
P0002135.stp
P0000127.stp x 3
