cross-isaac/IsaacCross_Senior_Thesis/02_Beam_Source_Design/CAD/Chamber_SW_Models/LeakValve.SLDASM

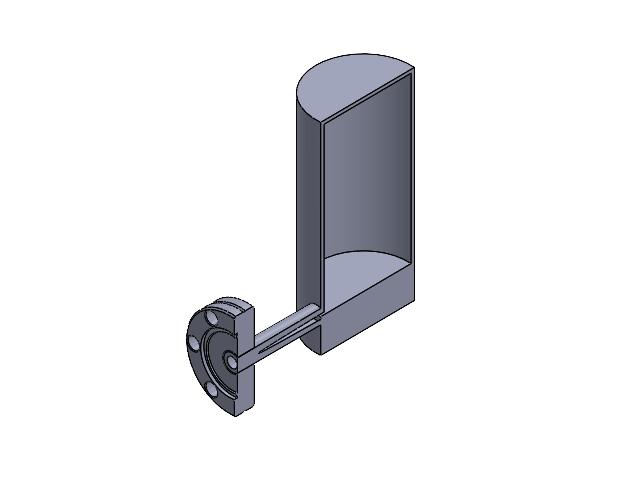
[picture p378: CAD file, 2026-07-06]
02_Beam_Source_Design/CAD/Chamber_SW_Models/LeakValve.SLDASM
f0133x025n.stp
