cross-isaac/IsaacCross_Senior_Thesis/09_Kovachy_Lab/Referene Cell/Reference Cell/Reference Cell UHV Setup (Kovachy Group's conflicted copy 2023-04-11).SLDASM

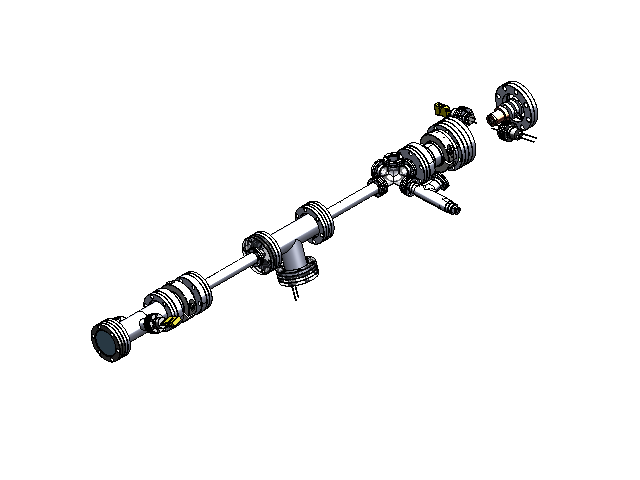
[picture p379: CAD file, 2026-07-06]
09_Kovachy_Lab/Referene Cell/Reference Cell/Reference Cell UHV Setup (Kovachy Group's conflicted copy 2023-04-11).SLDASM
A0595-1-CF.step x 2
P0000489.stp x 3
P0000436.stp x 3
P0001598.stp x 5
P0000430.stp x 5
P0002151.stp
P0000127.stp x 2
P0001581.stp x 4
tft1ky00002.stp
eft0124052.stp x 2
vpzl-275.stp
P0002053.stp
tube x 2
dff133x062.stp x 4
rf275x133.stp x 4
vzcr20r.stp
P0002116.stp
6436K25_Clamping Two-Piece Shaft Collar x 2
f0275x000_modified
P108041 x 2
0.5copperbase
0.5window x 2
window capture ring
0.5middlering x 2
spacer x 12
0.5outerring
0.5shield
92311A426_18-8 Stainless Steel Cup-Point Set Screw x 3
tft1ky00002
P0000439.stp
P0000494.stp
P0000157.stp
copper base_square
window capture ring_RHD
91771A055_Passivated 18-8 Stainless Steel Phillips Flat Head Screw x 3
0.5middleringRHD
0.5middlemiddleringRHD
0.5outerringRHD
TCcapture
rf337x275t.stp
92311A193_18-8 Stainless Steel Cup-Point Set Screw x 3
rod x 8
baffle piece x 8
clamp x 32
