cross-isaac/IsaacCross_Senior_Thesis/(list of files, cad)

Other CAD files:
09_Kovachy_Lab/Referene Cell/Reference Cell/hot window/0.5outerringRHD.SLDPRT
09_Kovachy_Lab/Strontium Resevoir/oven/Oven.STEP/shield.STEP
09_Kovachy_Lab/Strontium Resevoir/Resevoir isolated 1.0.SLDPRT
02_Beam_Source_Design/CAD/Crystal_Growth_Chamber/Local Chamber/inner wall nipple.stp.SLDPRT
09_Kovachy_Lab/Copper Piece/Copy of Copy of Copy of copper base_square.SLDPRT
09_Kovachy_Lab/Referene Cell/Reference Cell/rf275x133.stp
09_Kovachy_Lab/Strontium Resevoir/oven/spaceroven (anchor).SLDPRT
09_Kovachy_Lab/Optics Board/Optics/PF10-03-P01-Solidworks (1).sldprt
09_Kovachy_Lab/Referene Cell/Reference Cell/hot window/copper base_square.SLDPRT
02_Beam_Source_Design/CAD/Crystal_Growth_Chamber/Local Chamber/straw.stp.SLDPRT
02_Beam_Source_Design/CAD/Oven_SW_Models/Components/thermal break.SLDPRT
02_Beam_Source_Design/CAD/Oven_SW_Models/Nozzle/ModBlank.SLDPRT
09_Kovachy_Lab/Referene Cell/Reference Cell/hot window/spacer.SLDPRT
09_Kovachy_Lab/Strontium Resevoir/oven/Oven.STEP/TCapture.STEP
09_Kovachy_Lab/Copper Piece/2.0/0.5shield 2.0.SLDPRT
09_Kovachy_Lab/Strontium Resevoir/oven/Oven.STEP/spaceroven (shield).STEP
09_Kovachy_Lab/Strontium Resevoir/oven/Sr Reservoir.SLDPRT
02_Beam_Source_Design/CAD/Chamber_SW_Models/vzcr20r.SLDPRT
02_Beam_Source_Design/CAD/Chamber_SW_Models/ArLine.SLDPRT
02_Beam_Source_Design/CAD/Chamber_SW_Models/mew0750251c1.SLDASM
02_Beam_Source_Design/CAD/Chamber_SW_Models/vpzl-133.SLDPRT
02_Beam_Source_Design/CAD/Crystal_Growth_Chamber/CHEX Aparatus 2/CHEX Appartus 2 Drawings/CHEX Appartatus 2 Drawing 1.SLDDRW
02_Beam_Source_Design/CAD/Crystal_Growth_Chamber/CHEX Aparatus 2/CHEX Appartus 2 Drawings/CHEX Appartatus 2 Drawing 2.SLDDRW
02_Beam_Source_Design/CAD/Crystal_Growth_Chamber/CHEX Aparatus 2/Feedthru int for IC (1)/Feedthru int 4drawing.SLDDRW
02_Beam_Source_Design/CAD/Crystal_Growth_Chamber/CHEX Aparatus 2/Feedthru int for IC (1)/SChex dkl 1.SLDDRW
02_Beam_Source_Design/CAD/Crystal_Growth_Chamber/CHEX Aparatus 2/Feedthru int for IC (1)/SChex dkl 1.SLDPRT
02_Beam_Source_Design/CAD/Crystal_Growth_Chamber/CHEX Aparatus 2/Feedthru int for IC (1)/feedthru int a2.SLDPRT
02_Beam_Source_Design/CAD/Crystal_Growth_Chamber/CHEX Aparatus 2/Feedthru int for IC (1)/longer flange thing draft.SLDPRT
02_Beam_Source_Design/CAD/Crystal_Growth_Chamber/CHEX Aparatus 2/apparatus 2 copy.SLDASM
02_Beam_Source_Design/CAD/Crystal_Growth_Chamber/CHEX Aparatus 2/apparatus 2.SLDASM
02_Beam_Source_Design/CAD/Crystal_Growth_Chamber/CHEX Cryo Chamber/CHEX stuff for Isaac/CHEX stuff for Isaac/5004103a.stp
02_Beam_Source_Design/CAD/Crystal_Growth_Chamber/CHEX Cryo Chamber/CHEX stuff for Isaac/CHEX stuff for Isaac/5004149a.stp
02_Beam_Source_Design/CAD/Crystal_Growth_Chamber/CHEX Cryo Chamber/CHEX stuff for Isaac/CHEX stuff for Isaac/CHEX L/5004103a.SLDPRT
02_Beam_Source_Design/CAD/Crystal_Growth_Chamber/CHEX Cryo Chamber/CHEX stuff for Isaac/CHEX stuff for Isaac/CHEX L/5004149a.SLDPRT
02_Beam_Source_Design/CAD/Crystal_Growth_Chamber/CHEX Cryo Chamber/CHEX stuff for Isaac/CHEX stuff for Isaac/CHEX L/CHEX L Full Chamber + Cryo.SLDASM
02_Beam_Source_Design/CAD/Crystal_Growth_Chamber/CHEX Cryo Chamber/CHEX stuff for Isaac/CHEX stuff for Isaac/CHEX S/CHEX S Full Chamber + Cryo.SLDASM
02_Beam_Source_Design/CAD/Crystal_Growth_Chamber/CHEX Cryo Chamber/CHEX stuff for Isaac/CHEX stuff for Isaac/CHEX S/LOS5021027.SLDPRT
02_Beam_Source_Design/CAD/Crystal_Growth_Chamber/CHEX Cryo Chamber/CHEX stuff for Isaac/CHEX stuff for Isaac/CHEX S/LOS5021049.SLDPRT
02_Beam_Source_Design/CAD/Crystal_Growth_Chamber/CHEX Cryo Chamber/CHEX stuff for Isaac/CHEX stuff for Isaac/LOS5021027.stp
02_Beam_Source_Design/CAD/Crystal_Growth_Chamber/CHEX Cryo Chamber/CHEX stuff for Isaac/CHEX stuff for Isaac/LOS5021049.stp
02_Beam_Source_Design/CAD/Crystal_Growth_Chamber/Chambes Side by Side.SLDASM
02_Beam_Source_Design/CAD/Crystal_Growth_Chamber/Local Aparatus Drawings/LA Deconstructed Drawring.SLDDRW
02_Beam_Source_Design/CAD/Crystal_Growth_Chamber/Local Aparatus Drawings/Simple Cryo+Mount Drawing.SLDDRW
02_Beam_Source_Design/CAD/Crystal_Growth_Chamber/Local Chamber/A1671.stp.SLDPRT
02_Beam_Source_Design/CAD/Crystal_Growth_Chamber/Local Chamber/Basic holder.SLDPRT
02_Beam_Source_Design/CAD/Crystal_Growth_Chamber/Local Chamber/Chamber.SLDPRT
02_Beam_Source_Design/CAD/Crystal_Growth_Chamber/Local Chamber/Intrsumentation Skirt 1.0.SLDPRT
02_Beam_Source_Design/CAD/Crystal_Growth_Chamber/Local Chamber/Simple Cryo+Mount.SLDASM
02_Beam_Source_Design/CAD/Crystal_Growth_Chamber/Local Chamber/Simple Cryo+Mount.STEP
02_Beam_Source_Design/CAD/Crystal_Growth_Chamber/Local Chamber/double knife edge flange (1).SLDPRT
02_Beam_Source_Design/CAD/Crystal_Growth_Chamber/Local Chamber/electronics skirt.SLDASM
02_Beam_Source_Design/CAD/Crystal_Growth_Chamber/Local Chamber/electronics skirt.stp
02_Beam_Source_Design/CAD/Crystal_Growth_Chamber/Local Chamber/longer flange thing draft.SLDPRT
02_Beam_Source_Design/CAD/Crystal_Growth_Chamber/Local Chamber/longer flange thing draft.stp
02_Beam_Source_Design/CAD/Crystal_Growth_Chamber/Local Chamber/ogi 2.SLDASM
02_Beam_Source_Design/CAD/Crystal_Growth_Chamber/Local Chamber/ogi 2.stp
02_Beam_Source_Design/CAD/Crystal_Growth_Chamber/Local Chamber/ogi 3.SLDASM
02_Beam_Source_Design/CAD/Crystal_Growth_Chamber/Local Chamber/ogi 3.stp
02_Beam_Source_Design/CAD/Crystal_Growth_Chamber/Local Chamber/outer chamber flange pipe draft.stp
02_Beam_Source_Design/CAD/Crystal_Growth_Chamber/Local Chamber/outer chamber flange pipe draft.stp.SLDPRT
02_Beam_Source_Design/CAD/Crystal_Growth_Chamber/Local Chamber/outer wall nipple.stp.SLDPRT
02_Beam_Source_Design/CAD/Oven_SW_Models/Components/505482.SLDASM
02_Beam_Source_Design/CAD/Oven_SW_Models/Nozzle/Nozzle.SLDASM
02_Beam_Source_Design/CAD/Oven_SW_Models/Nozzle/Sketches/Microcapillary (.004 ID .008 OD).SLDDRW
02_Beam_Source_Design/CAD/Oven_SW_Models/Nozzle/Sketches/ModDoubleBlank.SLDDRW
02_Beam_Source_Design/CAD/Oven_SW_Models/Nozzle/Sketches/ModifiedFlange.SLDDRW
02_Beam_Source_Design/CAD/Oven_SW_Models/Nozzle/Sketches/ModifiedFlangeV1.SLDDRW
02_Beam_Source_Design/CAD/Oven_SW_Models/Nozzle/Sketches/NozzleClamp.SLDDRW
02_Beam_Source_Design/CAD/Oven_SW_Models/Nozzle/Sketches/SquareHolder.SLDDRW
02_Beam_Source_Design/CAD/Oven_SW_Models/Oven/Oven.SLDASM
02_Beam_Source_Design/CAD/Oven_SW_Models/Oven/OvenWithCross.SLDASM
06_Figures_and_Media/Lab_Art/Blender/Crystal 1.blend
06_Figures_and_Media/Lab_Art/Blender/Crystal by Code.blend
06_Figures_and_Media/Lab_Art/Blender/Untitled.blend
09_Kovachy_Lab/Copper Piece/2.0/Assem1.SLDASM
09_Kovachy_Lab/Copper Piece/Copper Piece Print.SLDDRW
09_Kovachy_Lab/Optics Board/Mounts/KM100PM-Solidworks.sldprt
09_Kovachy_Lab/Optics Board/Mounts/PH1.5-Solidworks.sldprt
09_Kovachy_Lab/Optics Board/Mounts/RSP05_M-Solidworks.sldprt
09_Kovachy_Lab/Optics Board/Mounts/Thick Laser 2.SLDPRT
09_Kovachy_Lab/Optics Board/SampleOpticsPlate.STEP
09_Kovachy_Lab/Optics Board/thick laser 2.SLDPRT
09_Kovachy_Lab/Referene Cell/Reference Cell/6436K25_Clamping Two-Piece Shaft Collar.SLDPRT
09_Kovachy_Lab/Referene Cell/Reference Cell/92311A193_18-8 Stainless Steel Cup-Point Set Screw.SLDPRT
09_Kovachy_Lab/Referene Cell/Reference Cell/92311A426_18-8 Stainless Steel Cup-Point Set Screw.SLDPRT
09_Kovachy_Lab/Referene Cell/Reference Cell/A0595-1-CF.step
09_Kovachy_Lab/Referene Cell/Reference Cell/P108041.SLDPRT
09_Kovachy_Lab/Referene Cell/Reference Cell/alumina tube.SLDPRT
09_Kovachy_Lab/Referene Cell/Reference Cell/c-0275-133.stp
09_Kovachy_Lab/Referene Cell/Reference Cell/c-0337-133.stp
09_Kovachy_Lab/Referene Cell/Reference Cell/c5-0133.stp
09_Kovachy_Lab/Referene Cell/Reference Cell/dff133x062.stp
09_Kovachy_Lab/Referene Cell/Reference Cell/eft0124052.stp
09_Kovachy_Lab/Referene Cell/Reference Cell/f0275x000_modified.SLDPRT
09_Kovachy_Lab/Referene Cell/Reference Cell/f0275x000nm.stp
09_Kovachy_Lab/Referene Cell/Reference Cell/hot window/0.5 inch sapph window resistive heater design/hot window stack RHDRevC.SLDASM
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
