cross-isaac/IsaacCross_Senior_Thesis/06_Figures_and_Media/Thesis_Figures/Ch03_Beam Source Design/Nozzle_Assembly_Together_SW.PNG

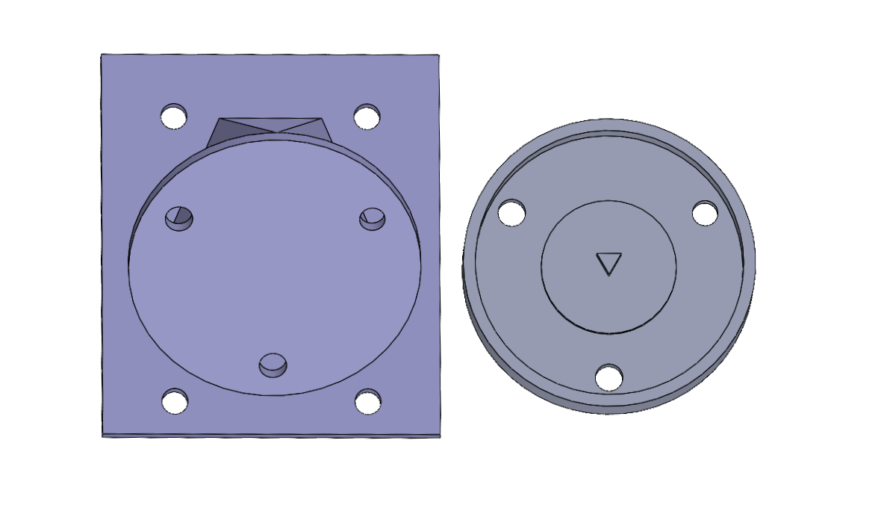
06_Figures_and_Media/Thesis_Figures/Ch03_Beam Source Design/Nozzle_Assembly_Together_SW.PNG
