cross-isaac/IsaacCross_Senior_Thesis/09_Kovachy_Lab/Strontium Resevoir/oven/PerformanceLog.txt

Number of Contacts: 373
Number of contact data: 11539
