cross-isaac/IsaacCross_Senior_Thesis/09_Kovachy_Lab/Heating Data/Air Test/SS Heating Test.pdf

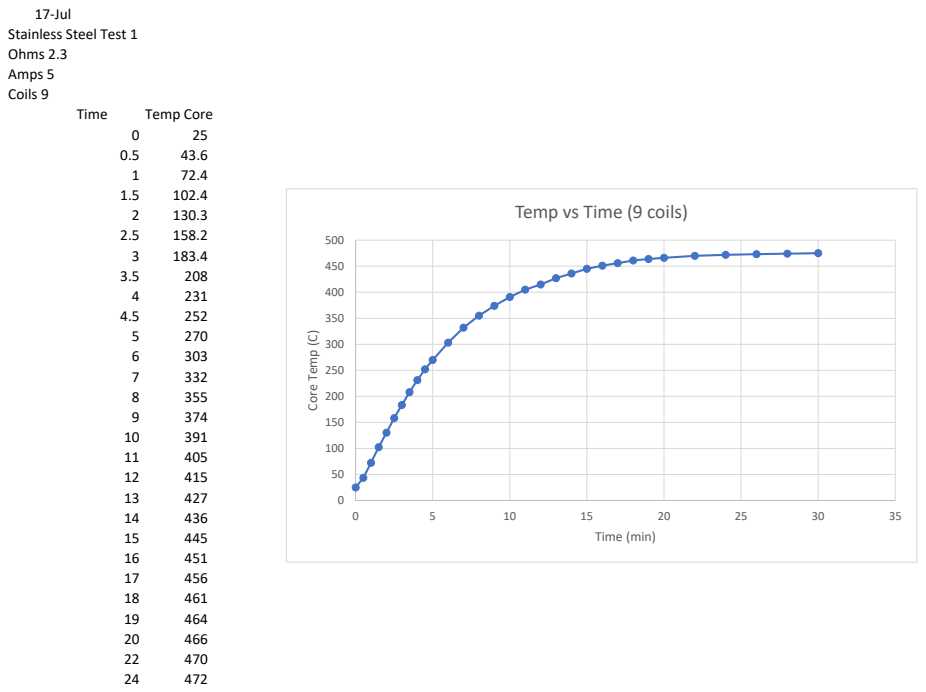
[picture p383: page 1]
17-Jul Stainless Steel Test 1 Ohms 2.3 Amps 5 Coils 9; Time; Temp Core 0; Core Temp (C); Time (min)

Temp vs Time (9 coils)

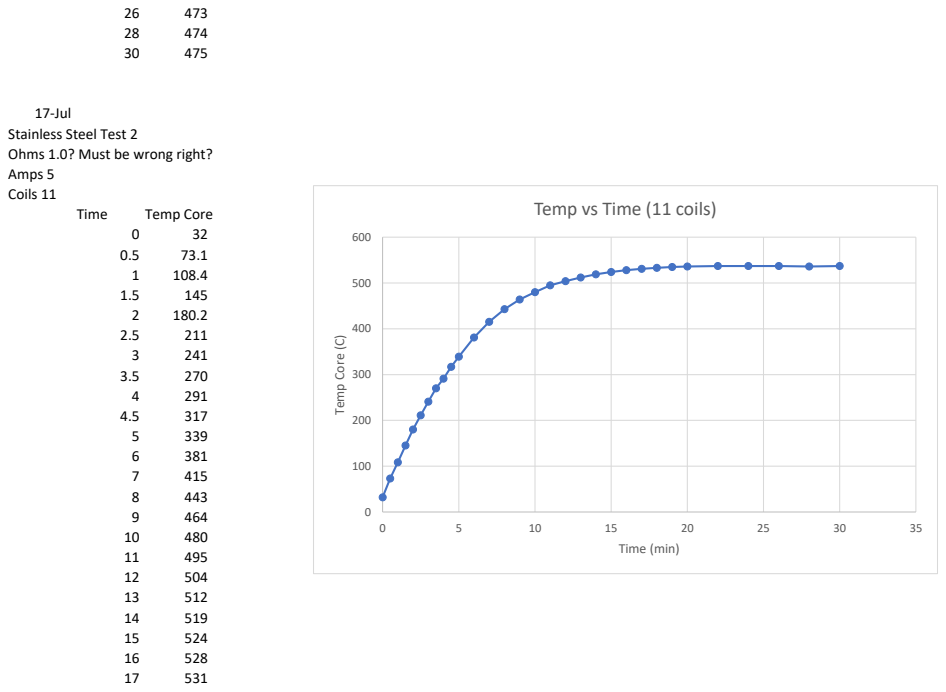
[picture p384: page 2]
Time; Temp Core 0; Temp Core (C); Time (min)

17-Jul
Stainless Steel Test 2
Ohms 1.0? Must be wrong right?
Amps 5
Coils 11

Temp vs Time (11 coils)

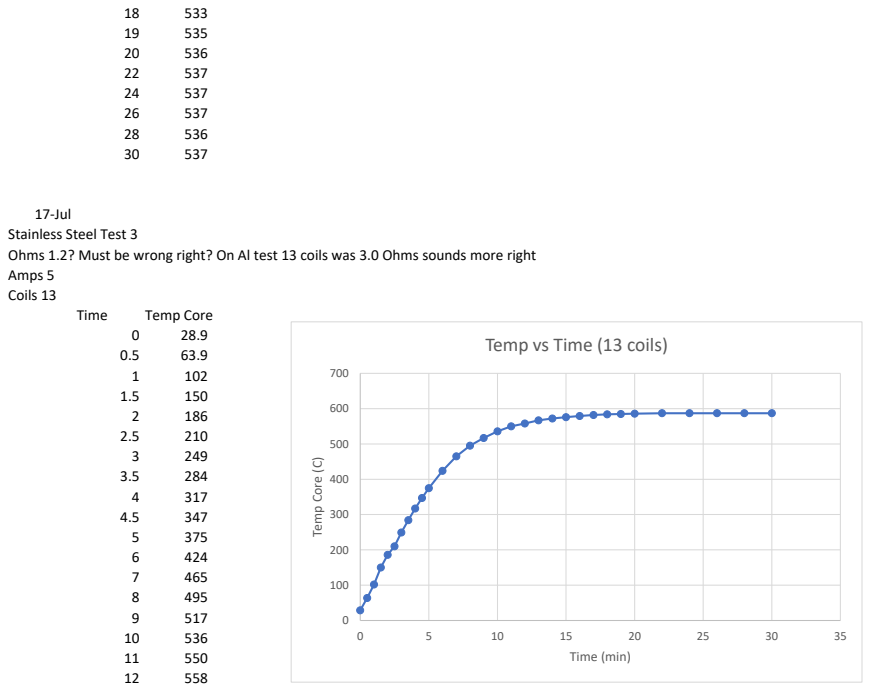
[picture p385: page 3]
Time; Temp Core; Temp Core (C); Time (min)

17-Jul
Stainless Steel Test 3
Ohms 1.2? Must be wrong right? On Al test 13 coils was 3.0 Ohms sounds more right
Amps 5
Coils 13

Temp vs Time (13 coils)

13 | 567
14 | 572
15 | 576
16 | 579
17 | 582
18 | 584
19 | 585
20 | 586
22 | 587
24 | 587
26 | 587
28 | 587
30 | 587

18-Jul
Stainless Steel Test 4
Ohms 1.9
Amps 5
Coils 7
Time | Temp Core
0 | 21.8
0.5 | 38.8
1 | 58.6
1.5 | 81.2
2 | 105
2.5 | 128.7
3 | 146.8
3.5 | 165.1
4 | 184.7
4.5 | 201
5 | 218
6 | 247

### Temp vs Time (7 coils)

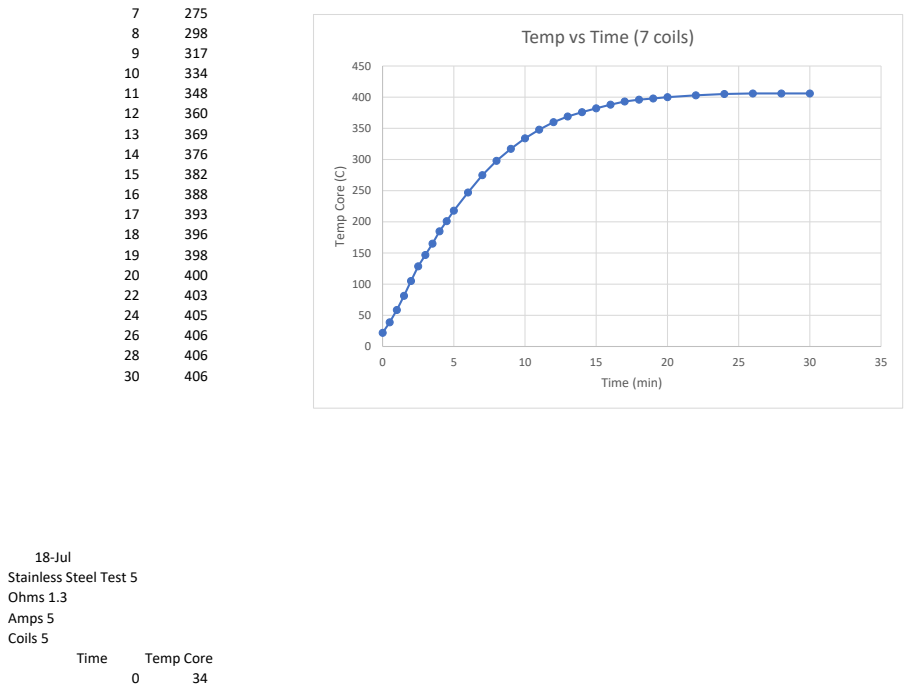
[picture p386: page 5]
18-Jul Stainless Steel Test 5 Ohms 1.3 Amps 5 Coils 5; Time; Temp Core 0; Temp Core (C); Time (min)

### Temp vs Time (5 coils)

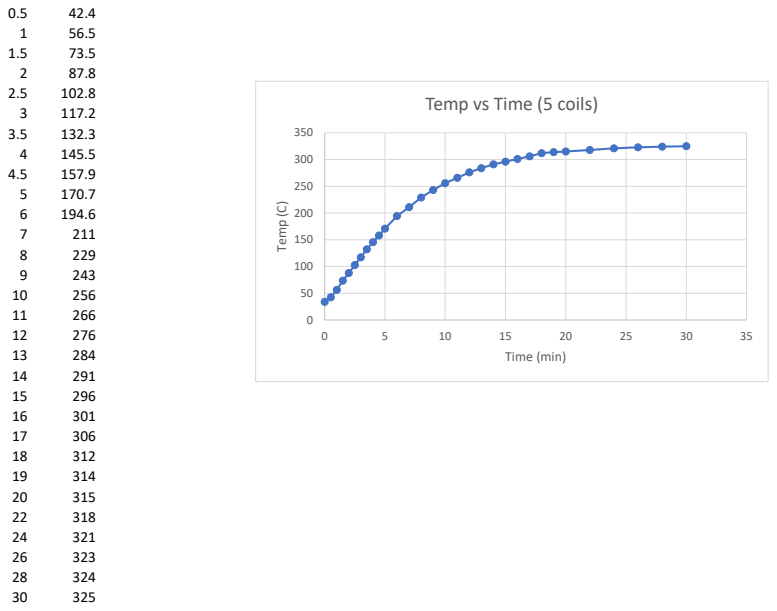
[picture p387: page 6]
Temp (C); Time (min)

1

1
