cross-isaac/IsaacCross_Senior_Thesis/03_Heaters_and_Monitoring/TempReading/test.csv

time | 1_C | 2_C | 3_C | 4_C
18:24:24 | 24.14 | 24.83 | 25.41 | 25.43
18:24:24 | 24.11 | 24.79 | 25.35 | 25.41
18:24:24 | 24.14 | 24.75 | 25.27 | 25.39
18:24:24 | 24.14 | 24.77 | 25.28 | 25.39
18:24:25 | 24.14 | 24.87 | 25.32 | 25.39
18:24:28 | 24.14 | 24.84 | 25.30 | 25.35
18:24:30 | 24.18 | 24.81 | 25.34 | 25.38
18:24:33 | 24.14 | 24.77 | 25.39 | 25.39
18:24:35 | 24.14 | 24.89 | 25.34 | 25.32
18:24:38 | 24.21 | 25.12 | 25.33 | 25.35
18:24:40 | 25.09 | 25.12 | 25.39 | 25.46
18:24:43 | 26.24 | 25.16 | 25.43 | 25.41
18:24:45 | 27.43 | 25.12 |  | 25.41
18:24:48 | 28.44 | 25.04 | 34.68 | 25.35
18:24:51 | 28.98 | 28.23 | 35.01 | 25.44
18:24:53 | 29.29 | 30.25 | 35.10 | 25.41
18:24:56 | 29.32 | 31.12 | 35.22 | 25.43
18:24:58 | 29.32 | 31.80 | 35.23 | 25.38
18:25:01 | 29.19 | 31.84 | 35.32 | 25.48
18:25:03 | 29.05 | 31.80 | 36.43 | 25.84
18:25:06 | 28.92 | 30.99 | 34.00 | 25.57
18:25:08 | 28.71 | 30.34 | 31.53 | 25.48
18:25:11 | 28.54 | 29.84 | 30.32 | 25.52
18:25:14 | 28.31 | 29.34 | 28.89 | 25.49
18:25:16 | 28.10 | 28.91 | 28.39 | 25.52
18:25:19 | 27.90 | 28.72 | 28.07 | 25.56
18:25:21 | 27.76 | 28.34 | 27.41 | 25.52
18:25:24 | 27.63 | 28.00 | 27.23 | 25.54
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
