cross-isaac/IsaacCross_Senior_Thesis/03_Heaters_and_Monitoring/TempReading/test2.csv

time | RTD_C | 1_C | 2_C | 3_C
18:04:19 | 23.57 | 25.05 | 25.39 | 26.23
18:04:19 | 23.60 | 25.02 | 25.24 | 26.19
18:04:19 | 23.60 | 24.94 | 25.27 | 26.25
18:04:20 | 23.57 | 24.91 | 25.33 | 26.23
18:04:23 | 23.57 | 24.89 | 25.30 | 26.27
18:04:25 | 23.57 | 24.95 | 25.20 | 26.21
18:04:28 | 23.60 | 29.61 | 25.21 | 26.21
18:04:30 | 23.60 | 31.64 | 25.37 | 26.27
18:04:33 | 23.60 | 32.66 | 25.35 | 26.31
18:04:35 | 23.60 | 32.88 | 25.54 | 26.37
18:04:38 | 23.60 | 32.23 | 33.66 | 26.39
18:04:40 | 23.60 | 31.60 | 33.96 | 26.37
18:04:43 | 23.60 | 31.12 | 32.11 | 26.34
18:04:46 | 23.64 | 30.59 | 28.89 | 26.39
18:04:48 | 24.45 | 30.12 | 27.47 | 26.37
18:04:51 | 25.84 | 29.55 | 26.61 | 26.41
18:04:53 | 27.19 | 29.16 | 26.48 | 26.48
18:04:56 | 28.07 | 28.89 | 26.55 | 26.39
18:04:58 | 28.51 | 28.61 | 26.19 | 26.31
18:05:01 | 28.61 | 28.34 | 25.86 | 26.34
18:05:03 | 28.61 | 28.05 | 25.57 | 26.34
18:05:06 | 28.44 | 27.75 | 25.63 | 26.29
18:05:08 | 28.24 | 27.55 | 25.49 | 26.32
18:05:11 | 28.04 | 27.41 | 25.52 | 26.39
18:05:14 | 27.83 | 27.12 | 25.50 | 26.37
18:05:17 | 27.56 | 27.01 | 25.43 | 26.48
