cross-isaac/IsaacCross_Senior_Thesis/03_Heaters_and_Monitoring/TempReading/test3.csv

time | RTD1_C | RTD2_C
17:59:39 | 28.37 | 26.51
17:59:39 | 28.24 | 26.48
17:59:39 | 28.10 | 26.51
17:59:39 | 28.00 | 26.51
