cross-isaac/IsaacCross_Senior_Thesis/03_Heaters_and_Monitoring/TempReading/test4.csv

time | RTD_C | TC1_C | TC2_C | TC3_C
17:42:07
17:42:07 | 27.63 | 26.74 | 1372.05 | 1372.05
17:42:07 | 27.49 | 26.52 | 1372.05 | 1372.05
17:42:07 | 27.39 | 26.34 | 1372.05 | 1372.05
17:42:07 | 27.26 | 26.08 | 1372.05 | 1372.05
17:42:07 | 27.19 | 25.98 | 1372.05 | 1372.05
17:42:07 | 27.09 | 25.83 | 1372.05 | 1372.05
17:42:08 | 26.99 | 25.73 | 1372.05 | 1372.05
17:42:10 | 26.92 | 25.60 | 1372.05 | 1372.05
17:42:13 | 26.82 | 25.45 | 1372.05 | 1372.05
17:42:16 | 26.72 | 25.41 | 1372.05 | 1372.05
17:42:18 | 26.61 | 25.48 | 1372.05 | 1372.05
