cross-isaac/IsaacCross_Senior_Thesis/03_Heaters_and_Monitoring/TempReading/test5.csv

time | IN Water_C | OUT Water_C
18:00:26 | 27.22 | 26.68
18:00:26 | 27.12 | 26.72
18:00:26 | 27.05 | 26.72
18:00:26 | 26.99 | 26.68
18:00:26 | 26.92 | 26.68
18:00:26 | 27.02 | 26.72
18:00:26 | 27.12 | 26.65
18:00:26 | 27.26 | 26.72
18:00:26 | 27.29 | 26.68
18:00:26 | 27.29 | 26.68
18:00:26 | 27.32 | 26.72
18:00:26 | 27.32 | 26.72
18:00:26 | 27.26 | 26.72
18:00:26 | 27.22 | 26.75
18:00:26 | 27.19 | 26.75
18:00:28 | 27.09 | 26.78
18:00:30 | 27.26 | 26.82
18:00:33 | 27.70 | 27.12
18:00:35 | 28.34 | 27.90
18:00:37 | 28.78 | 28.65
18:00:39 | 29.09 | 29.12
18:00:41 | 29.22 | 29.39
18:00:44 | 29.29 | 29.53
18:00:46 | 29.25 | 29.56
18:00:48 | 29.19 | 29.53
