cross-isaac/IsaacCross_Senior_Thesis/04_Beam_Characterization/results/background_deg1/background_results_deg1.csv

height | Scale1 | eScale1 | Scale2 | eScale2 | Scale3 | eScale3 | Scale4 | eScale4
200 | 0.002024738867800637 | 0.0011918437274517797 | 0.002868912090162823 | 1444.7476366918684 | 0.002296619290952151 | 2832.391550281341 | 0.0030099223347122006 | 1875.642259906553
300 | 0.0017386398937618138 | 0.0001860578595141217 | 0.0027108453542439293 | 2439.325837110513 | 0.001972527395871282 | 2238.335252394645 | 0.003871021941862521 | 0.002048663688777016
400 | 0.0011616799272921809 | 3.5242805983867137e-05 | 0.006948563062877611 | 5438.528125609494 | 0.005519973800667252 | 2.6574596739706064e-05 | 0.007981039551025176 | 0.00010801067495035729
500 | 0.003079013159924063 | 0.000348733403404752 | 0.0023617696965629875 | 2148.8174083639237 | 0.0021280460446391203 | 1765.913469010341 | 0.004955606610215921 | 4.028149182737851e-05
600 | 0.004757676570977937 | 4.2154224773763685e-05 | 0.0016420754340040178 | 0.00015818723045824776 | 0.0006040398866632949 | 6.469753518795607e-05 | 0.0019776882289559397 | 0.00011522009832602744
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
