cross-isaac/IsaacCross_Senior_Thesis/04_Beam_Characterization/780nm_Probe_System/780_Beam_Size/horizontal.png

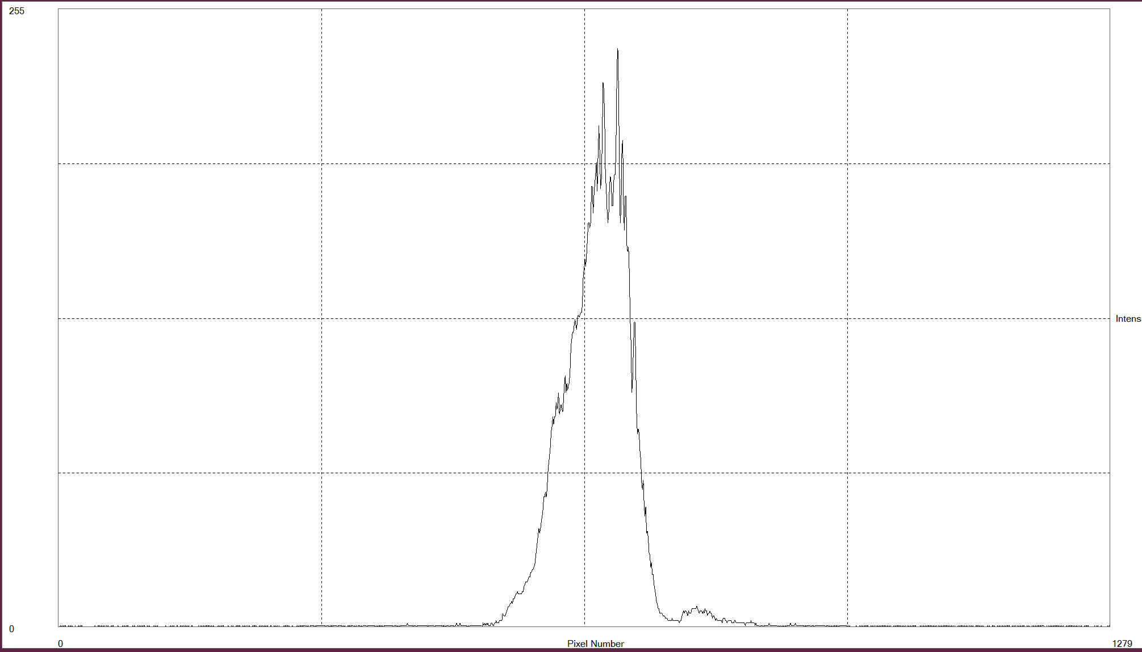
04_Beam_Characterization/780nm_Probe_System/780_Beam_Size/horizontal.png
