cross-isaac/IsaacCross_Senior_Thesis/04_Beam_Characterization/results/background_deg1/fit_plots/900_side4_fit.png

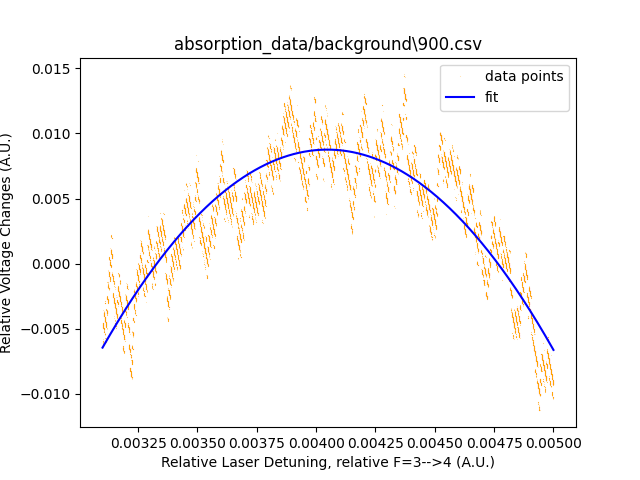
04_Beam_Characterization/results/background_deg1/fit_plots/900_side4_fit.png
