cross-isaac/IsaacCross_Senior_Thesis/04_Beam_Characterization/results/background_deg2/fit_plots/200_side3_fit.png

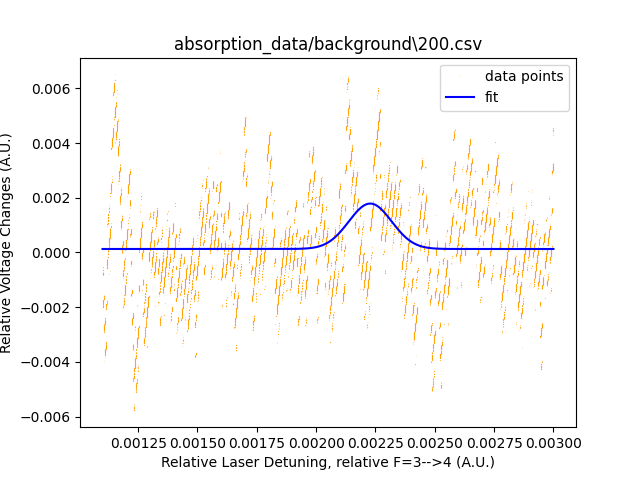
04_Beam_Characterization/results/background_deg2/fit_plots/200_side3_fit.png
