cross-isaac/IsaacCross_Senior_Thesis/04_Beam_Characterization/results/background_deg2/fit_plots/400_side2_fit.png

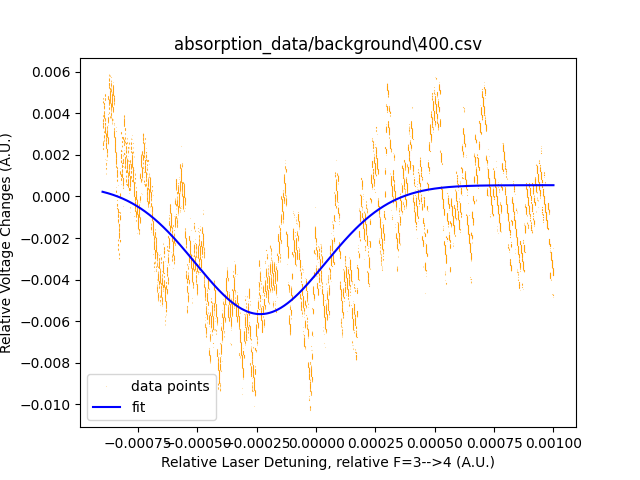
04_Beam_Characterization/results/background_deg2/fit_plots/400_side2_fit.png
