cross-isaac/IsaacCross_Senior_Thesis/04_Beam_Characterization/results/background_deg2/fit_plots/800_side1_fit.png

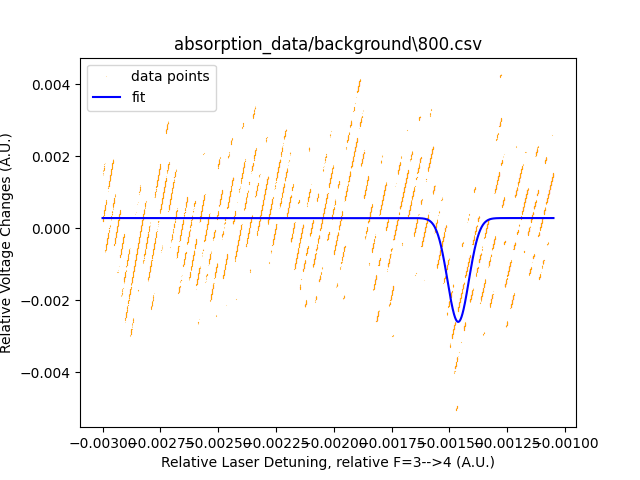
04_Beam_Characterization/results/background_deg2/fit_plots/800_side1_fit.png
