cross-isaac/IsaacCross_Senior_Thesis/04_Beam_Characterization/results/figures/all_versions/beam_summary_101225_Rb_zone1_gaussian_gaussian_chi2_7p80_theta_1p327deg.png

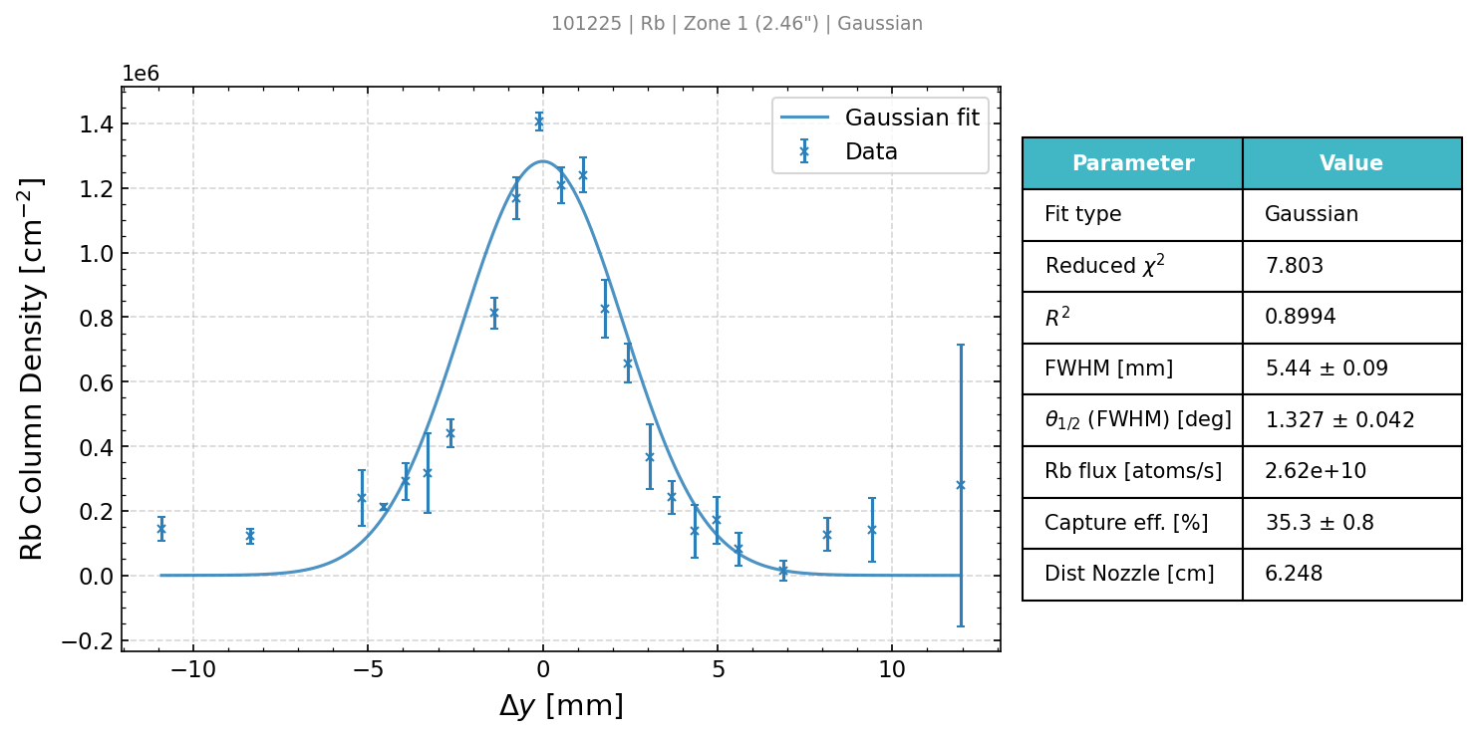
04_Beam_Characterization/results/figures/all_versions/beam_summary_101225_Rb_zone1_gaussian_gaussian_chi2_7p80_theta_1p327deg.png
