cross-isaac/IsaacCross_Senior_Thesis/04_Beam_Characterization/results/figures/all_versions/beam_summary_101225_Rb_zone2_gaussian_gaussian_chi2_2p18_theta_1p914deg.png

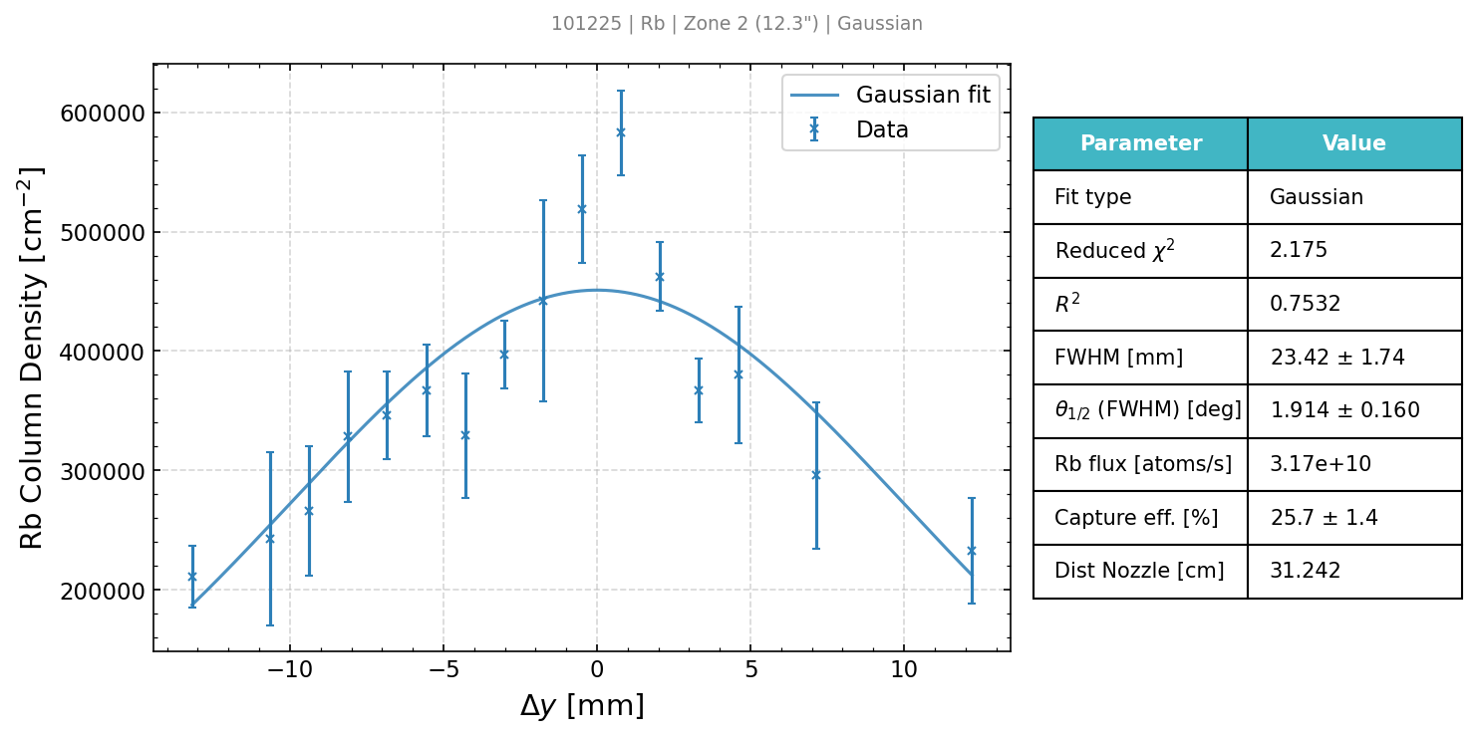
04_Beam_Characterization/results/figures/all_versions/beam_summary_101225_Rb_zone2_gaussian_gaussian_chi2_2p18_theta_1p914deg.png
