cross-isaac/IsaacCross_Senior_Thesis/04_Beam_Characterization/results/figures/all_versions/beam_summary_101225_Rb_zone2_mod_CAUTION_gaussian_gaussian_chi2_1p32_theta_1p108deg.png

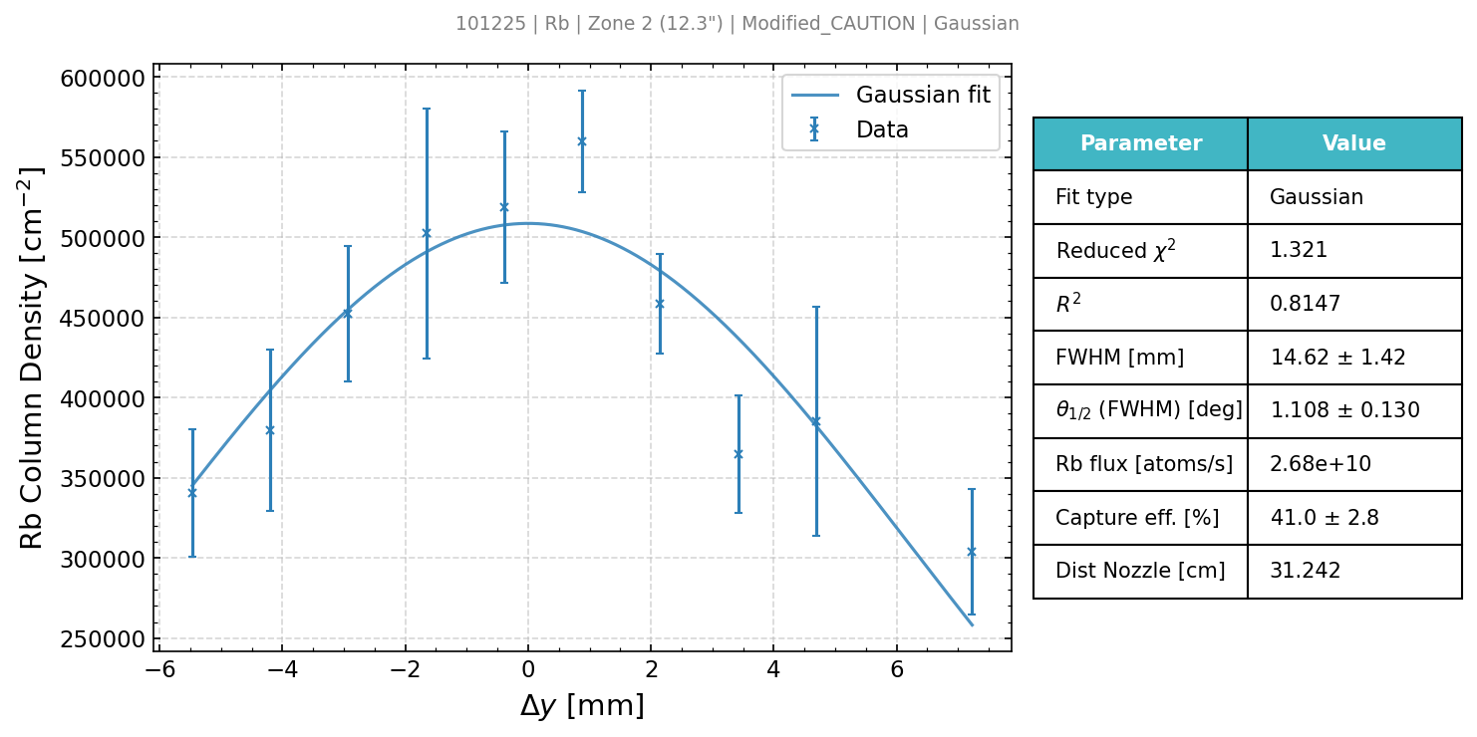
04_Beam_Characterization/results/figures/all_versions/beam_summary_101225_Rb_zone2_mod_CAUTION_gaussian_gaussian_chi2_1p32_theta_1p108deg.png
