cross-isaac/IsaacCross_Senior_Thesis/04_Beam_Characterization/results/figures/all_versions/beam_summary_112825_RbAr_zone1_gaussian_gaussian_chi2_5p51_theta_1p122deg.png

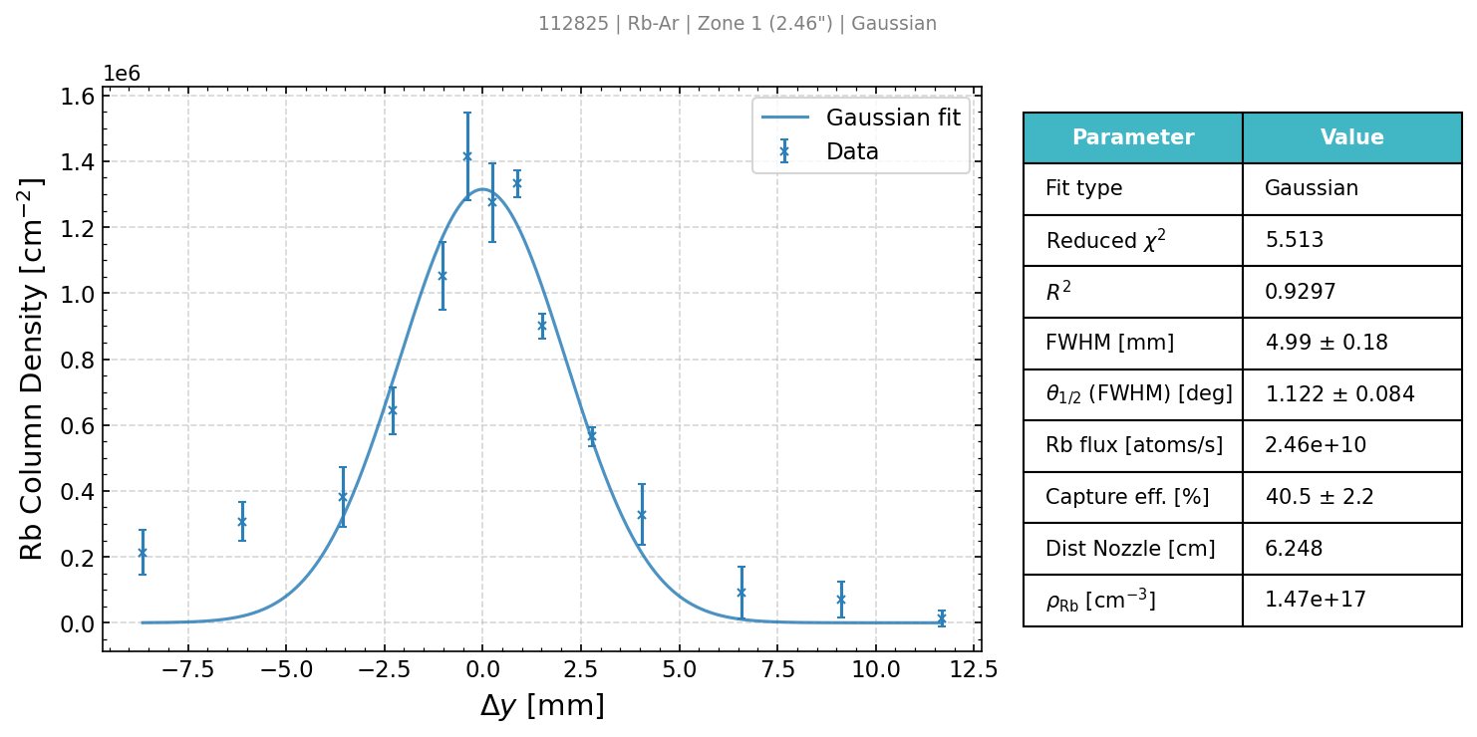
04_Beam_Characterization/results/figures/all_versions/beam_summary_112825_RbAr_zone1_gaussian_gaussian_chi2_5p51_theta_1p122deg.png
