cross-isaac/IsaacCross_Senior_Thesis/04_Beam_Characterization/results/results_101225/Far/fit_plots/350_side3_fit.png

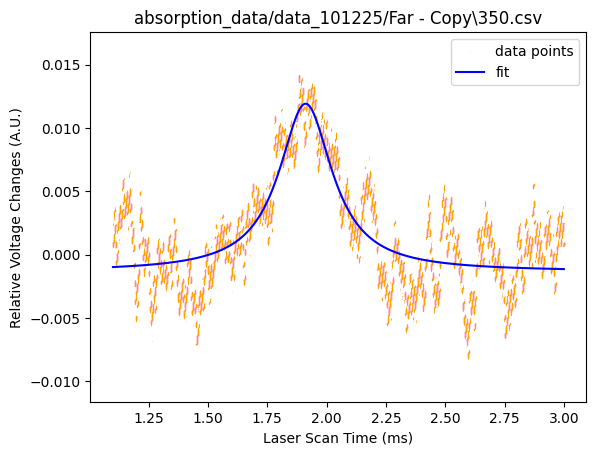
04_Beam_Characterization/results/results_101225/Far/fit_plots/350_side3_fit.png
