cross-isaac/IsaacCross_Senior_Thesis/04_Beam_Characterization/results/results_101225/Far/flux_data/fit_plots/full2converted_side2_fit.png

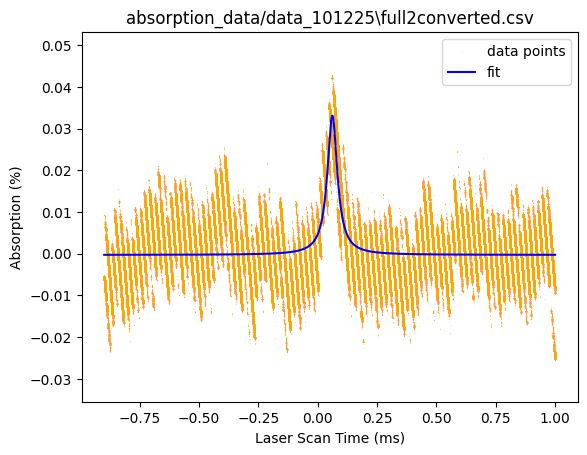
04_Beam_Characterization/results/results_101225/Far/flux_data/fit_plots/full2converted_side2_fit.png
