cross-isaac/IsaacCross_Senior_Thesis/04_Beam_Characterization/results/results_101225/Near/flux_data/combined_flux_101225_near.png

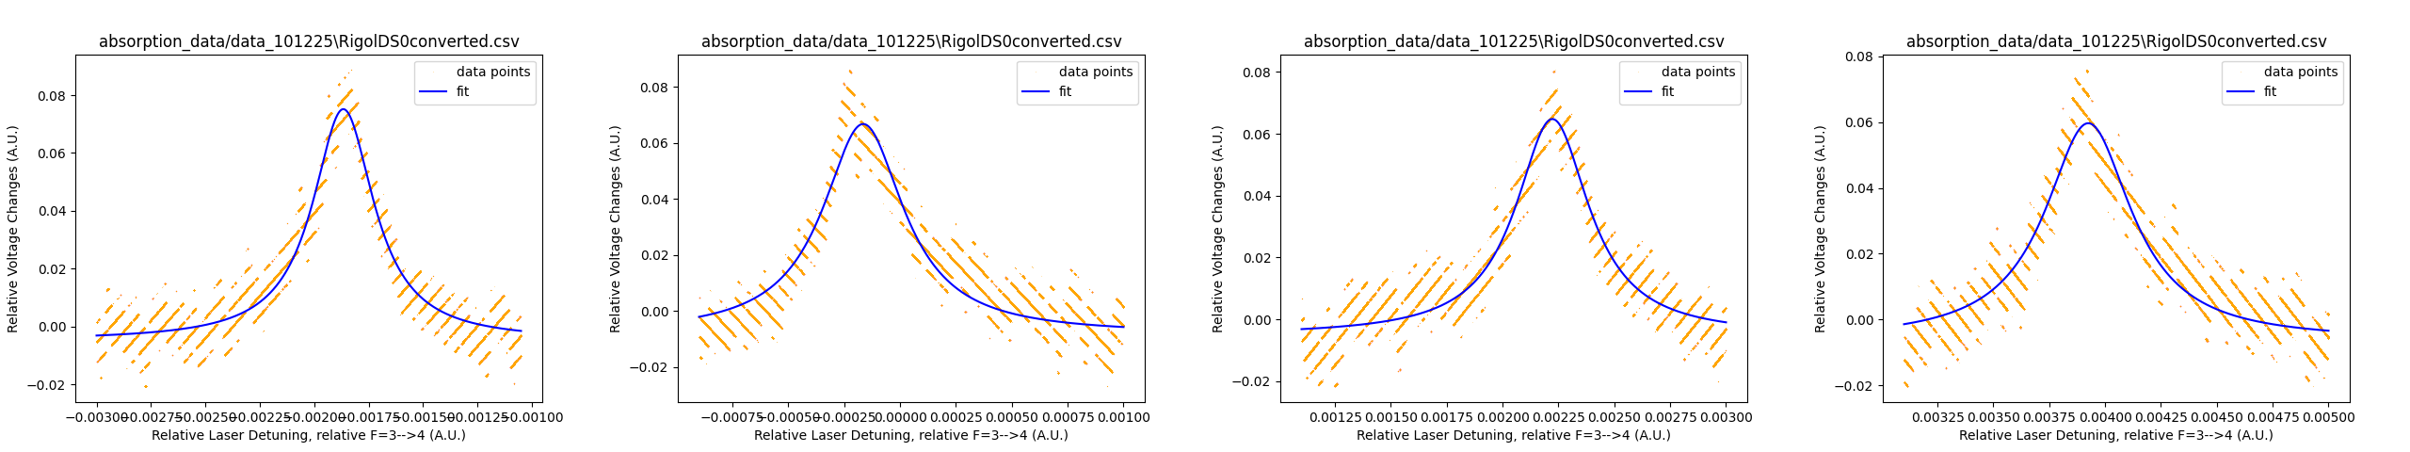
04_Beam_Characterization/results/results_101225/Near/flux_data/combined_flux_101225_near.png
