cross-isaac/IsaacCross_Senior_Thesis/04_Beam_Characterization/results/results_101225/Near/flux_data/fit_plots/RigolDS0converted_side4_fit.png

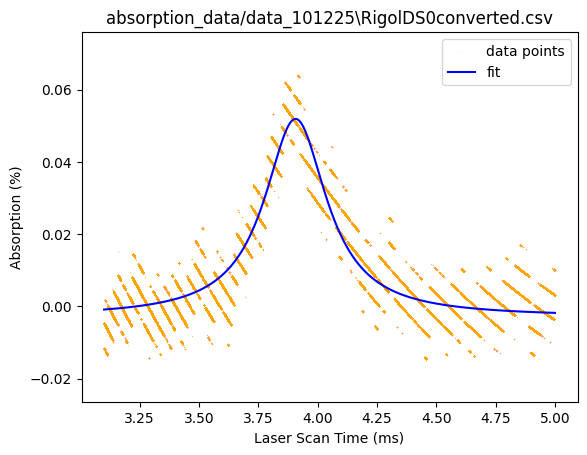
04_Beam_Characterization/results/results_101225/Near/flux_data/fit_plots/RigolDS0converted_side4_fit.png
