cross-isaac/IsaacCross_Senior_Thesis/04_Beam_Characterization/results/results_112825/fit_plots/500_side1_fit.png

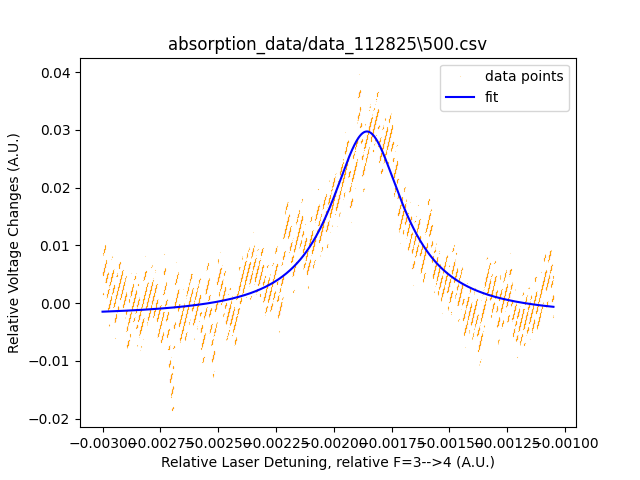
04_Beam_Characterization/results/results_112825/fit_plots/500_side1_fit.png
