cross-isaac/IsaacCross_Senior_Thesis/04_Beam_Characterization/results/results_112825/flux_data/combined_flux_112825.png

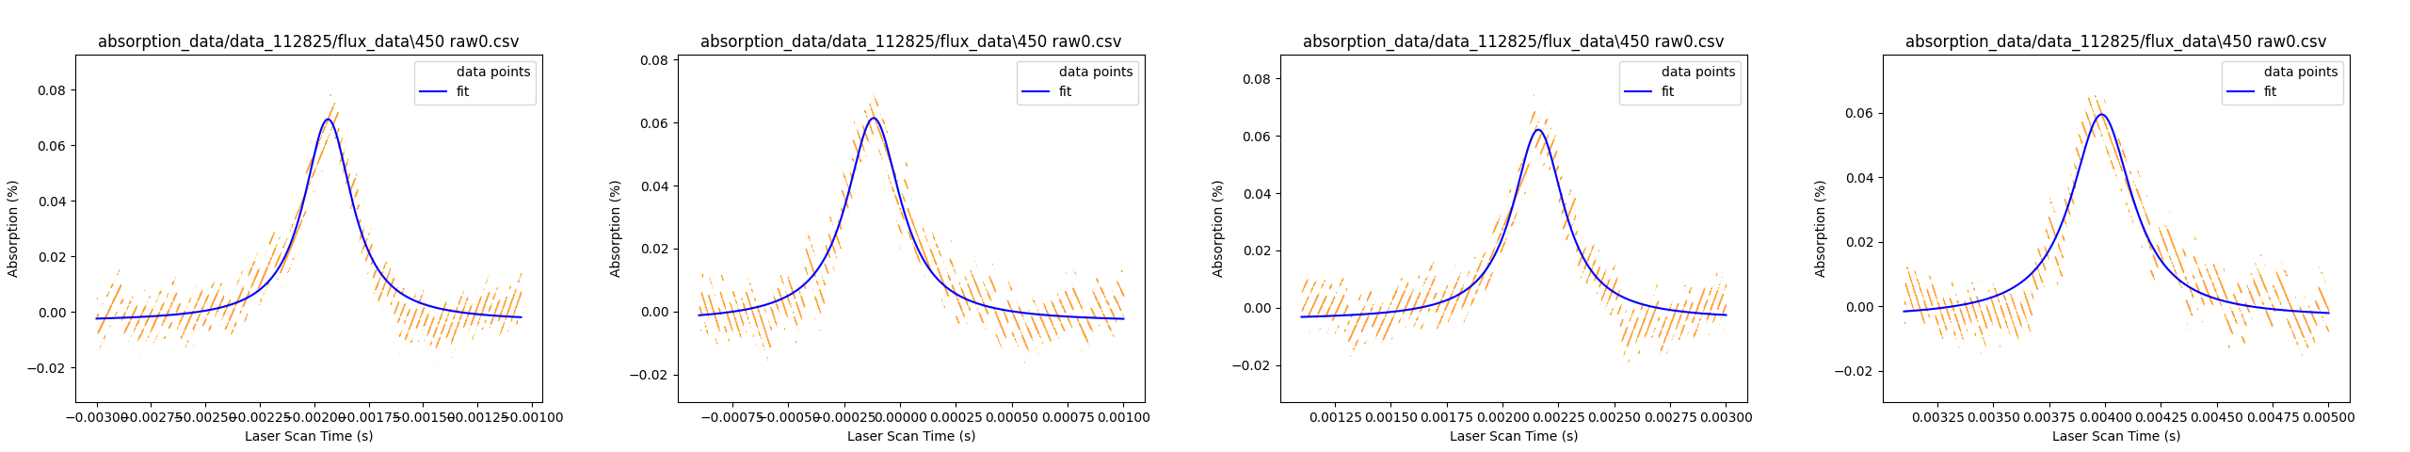
04_Beam_Characterization/results/results_112825/flux_data/combined_flux_112825.png
