cross-isaac/IsaacCross_Senior_Thesis/04_Beam_Characterization/results/results_112825/flux_data/fit_plots/450 raw0_side1_fit.png

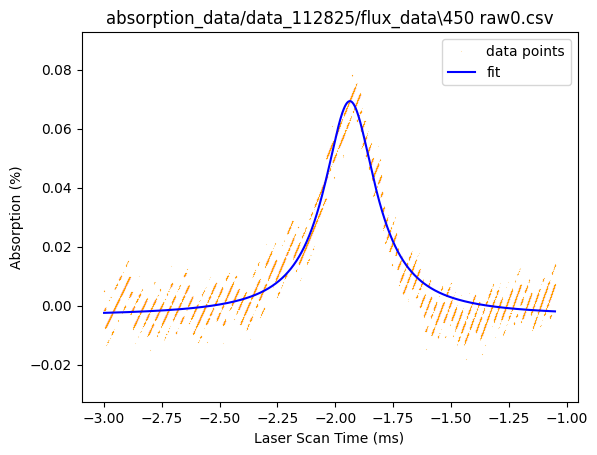
04_Beam_Characterization/results/results_112825/flux_data/fit_plots/450 raw0_side1_fit.png
