cross-isaac/IsaacCross_Senior_Thesis/06_Figures_and_Media/Thesis_Figures/Ch05_characterization_methods/112825/TC_00182.JPG

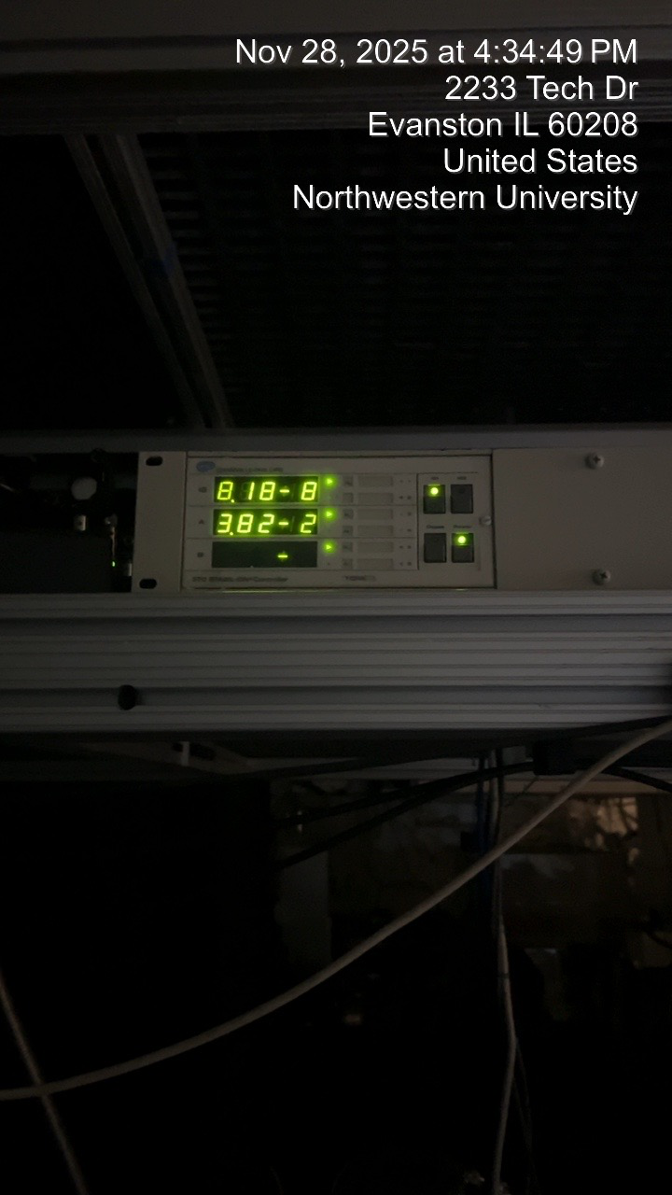
06_Figures_and_Media/Thesis_Figures/Ch05_characterization_methods/112825/TC_00182.JPG
