cross-isaac/IsaacCross_Senior_Thesis/06_Figures_and_Media/Thesis_Figures/Ch05_characterization_methods/spatial_dist_example.png

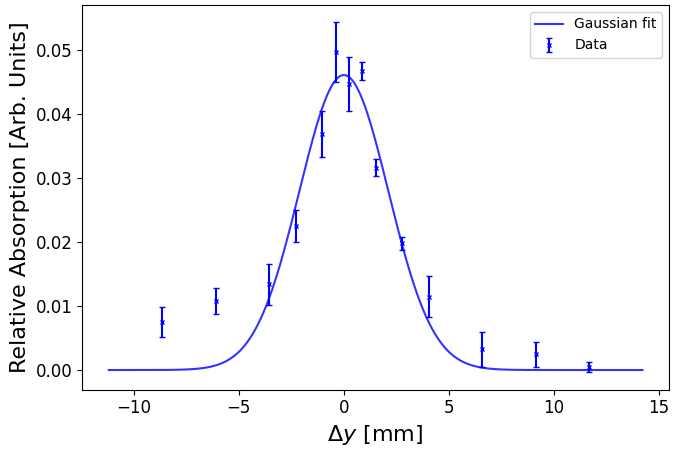
06_Figures_and_Media/Thesis_Figures/Ch05_characterization_methods/spatial_dist_example.png
