cross-isaac/IsaacCross_Senior_Thesis/06_Figures_and_Media/Thesis_Figures/ch06_results/Rb-Ar/112825_RA_nolef_div.png

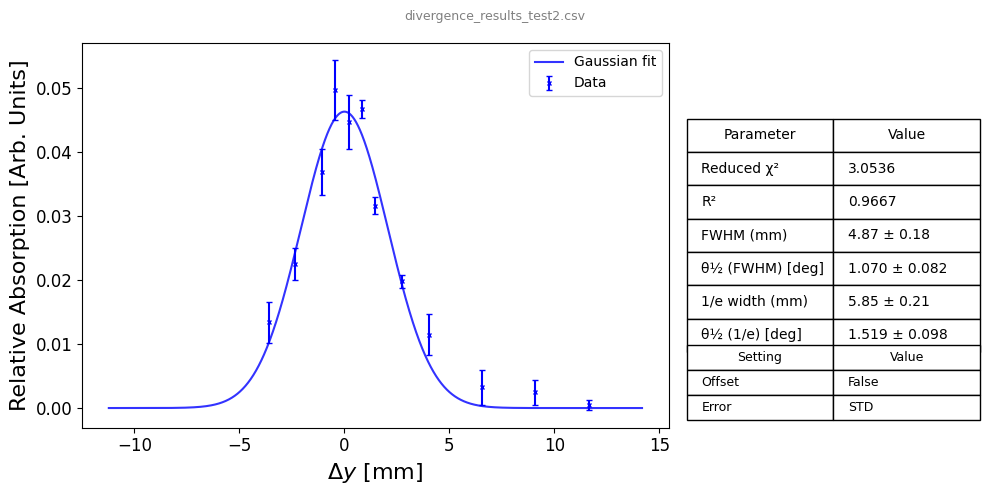
06_Figures_and_Media/Thesis_Figures/ch06_results/Rb-Ar/112825_RA_nolef_div.png
