cross-isaac/IsaacCross_Senior_Thesis/06_Figures_and_Media/Thesis_Figures/ch06_results/summary_beamsource_plots_combined.png

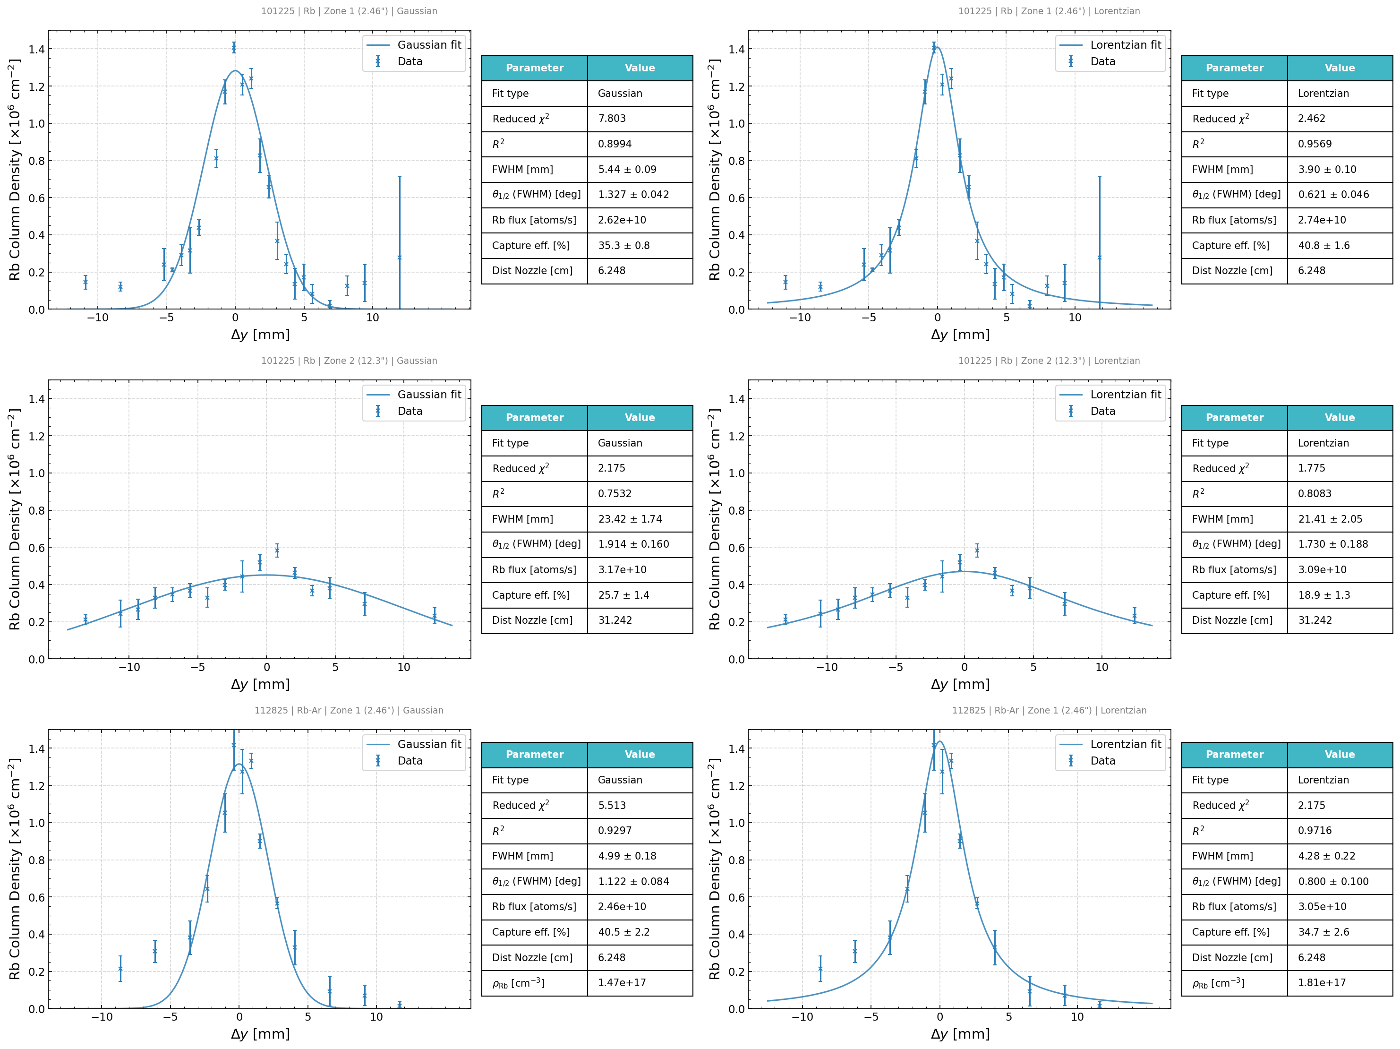
06_Figures_and_Media/Thesis_Figures/ch06_results/summary_beamsource_plots_combined.png
