cross-isaac/IsaacCross_Senior_Thesis/09_Kovachy_Lab/RGA Baseline Test-20230825T200258Z-001/RGA Baseline Test/Empty Cross/08082023_1345.png

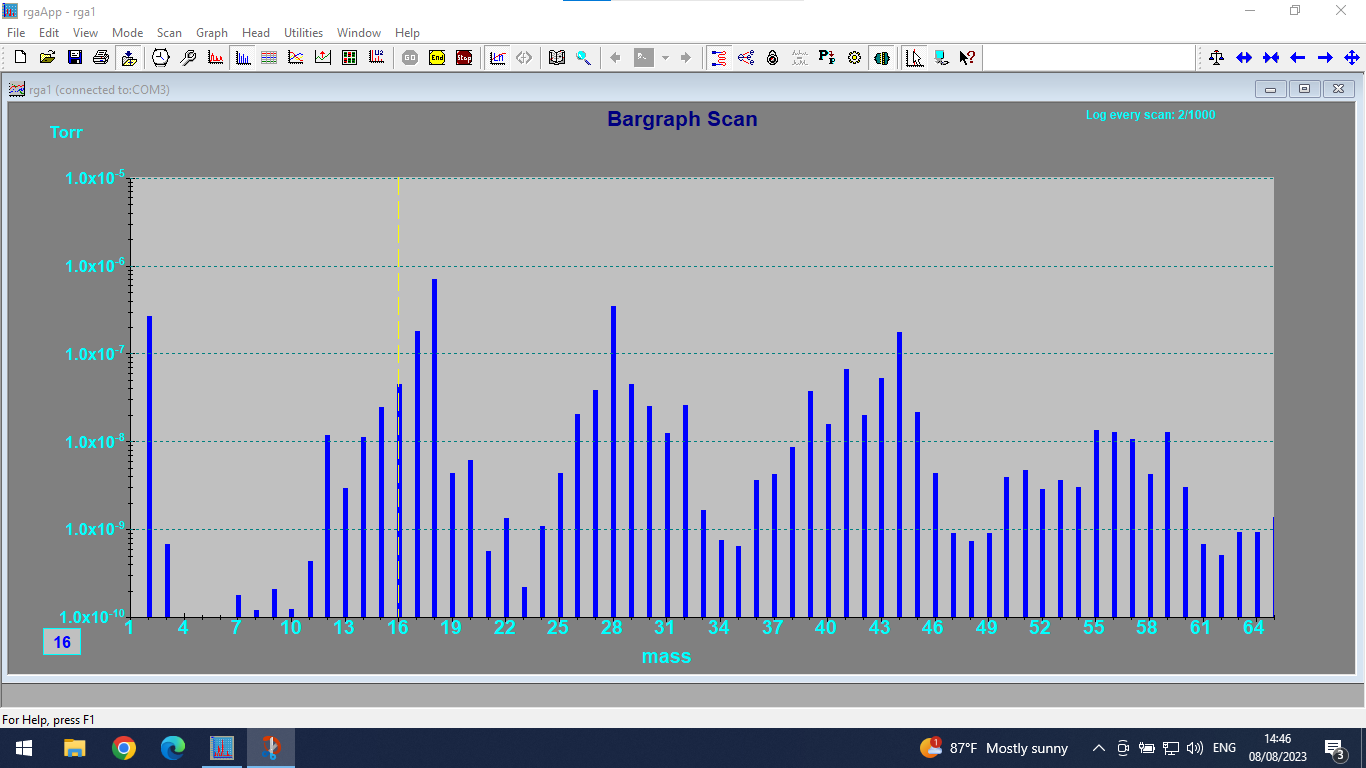
09_Kovachy_Lab/RGA Baseline Test-20230825T200258Z-001/RGA Baseline Test/Empty Cross/08082023_1345.png
