cross-isaac/IsaacCross_Senior_Thesis/09_Kovachy_Lab/RGA Baseline Test-20230825T200258Z-001/RGA Baseline Test/Empty Cross/08102023_0836.png

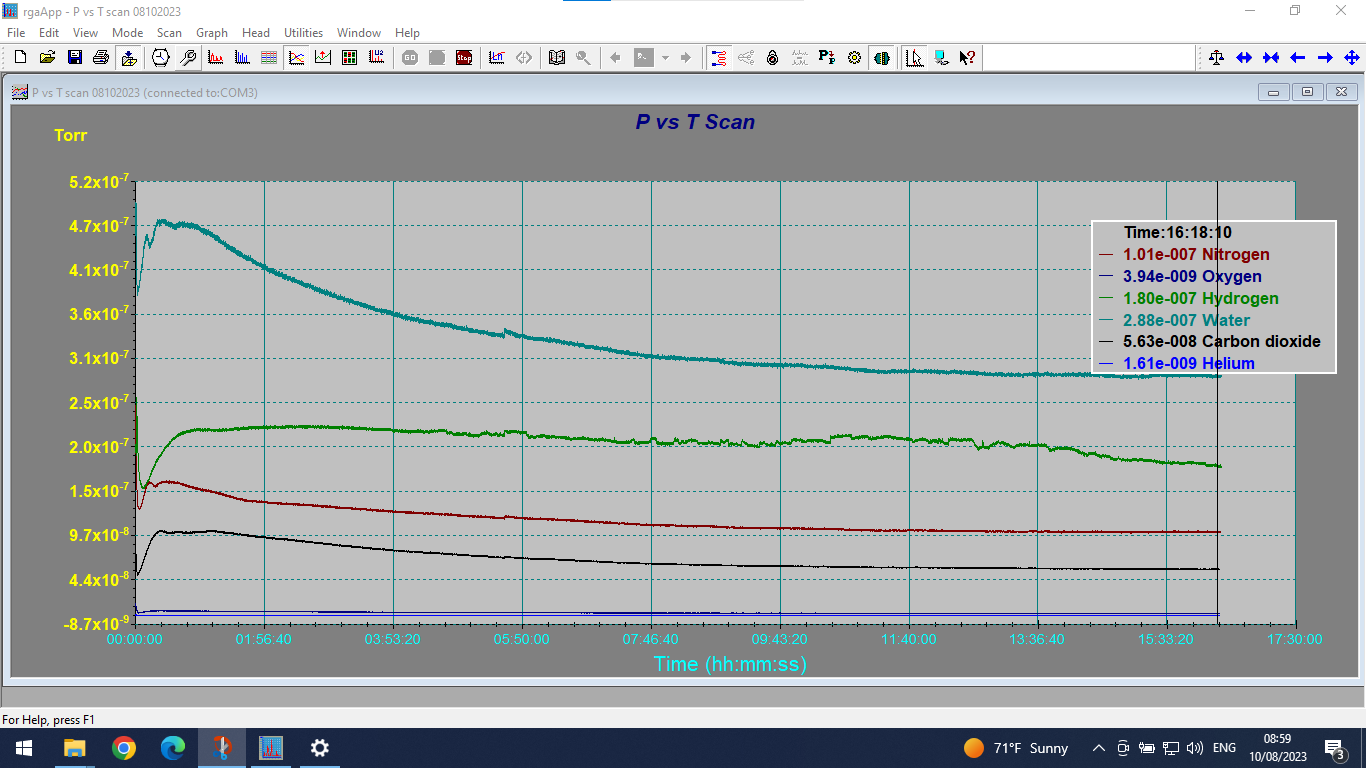
09_Kovachy_Lab/RGA Baseline Test-20230825T200258Z-001/RGA Baseline Test/Empty Cross/08102023_0836.png
