cross-isaac/IsaacCross_Senior_Thesis/02_Beam_Source_Design/CAD/Chamber_SW_Models/Block Diagram UHV test chamber.pdf

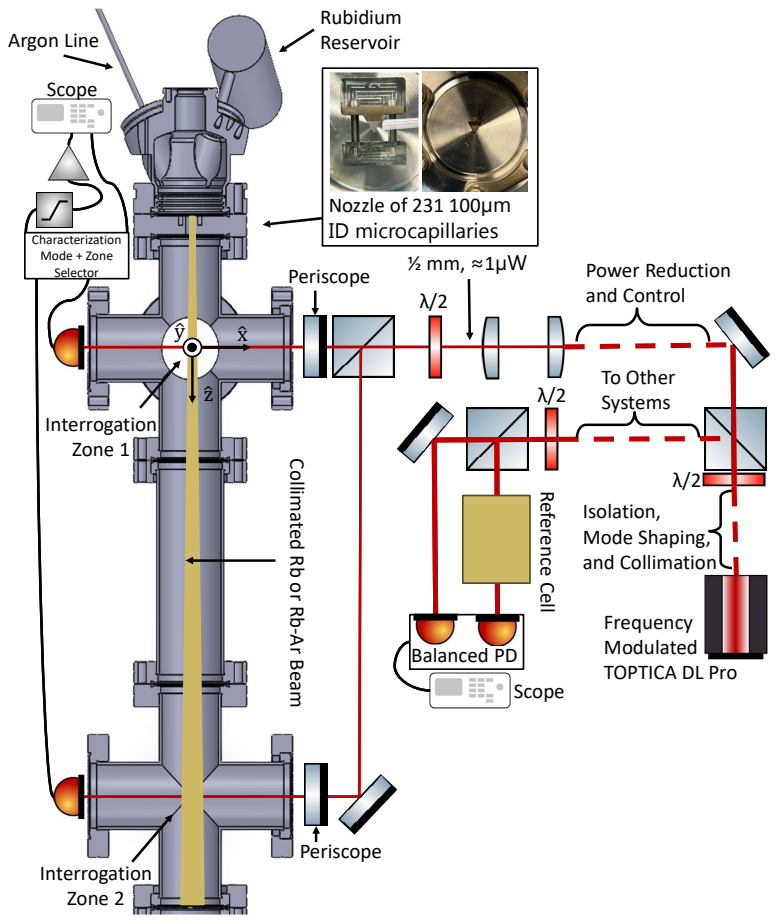
[picture p586: page 1]
Power Reduction and Control; To Other Systems; Periscope; Balanced PD Scope; Scope; Characterization Mode + Zone Selector; Interrogation Zone 1; Interrogation Zone 2; Rubidium; Argon Line; Reservoir

Nozzle of 231 100µm
ID microcapillaries
Periscope Collimated Rb or Rb-Ar Beam

Reference Cell Isolation,
Mode Shaping,
and Collimation

Frequency
Modulated
TOPTICA DL Pro
