cross-isaac/IsaacCross_Senior_Thesis/09_Kovachy_Lab/Heating Data/Air Test/Copper Heating test.pdf

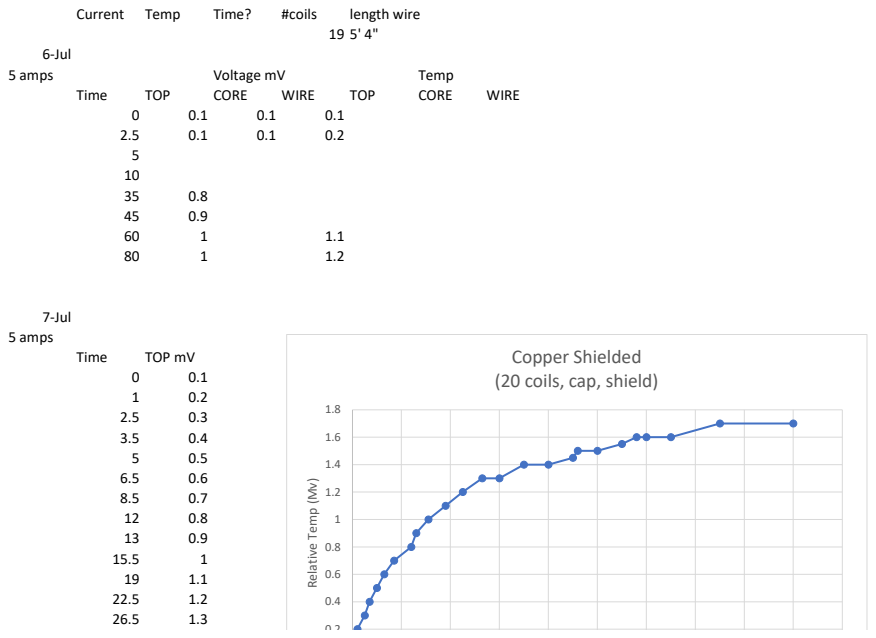
[picture p587: page 1]
Current Temp; Time?; #coils; length wire; 6-Jul; 5 amps; Voltage mV; Temp; Time; TOP; CORE; WIRE; 7-Jul 5 amps; TOP mV; 1.8 Relative Temp ⁽Mv⁾

Copper Shielded
(20 coils, cap, shield)

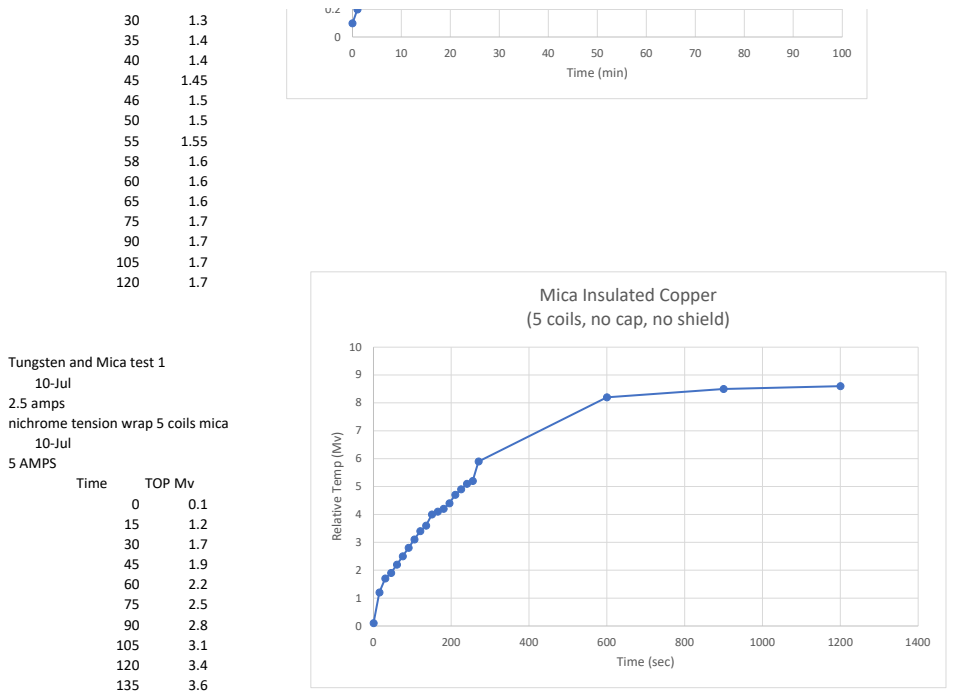
[picture p588: page 2]
Time; TOP Mv; Time (min); 1400 Relative Temp ⁽Mv⁾; Time (sec)

Mica Insulated Copper
(5 coils, no cap, no shield)

Tungsten and Mica test 1
10-Jul
2.5 amps
nichrome tension wrap 5 coils mica
5 AMPS

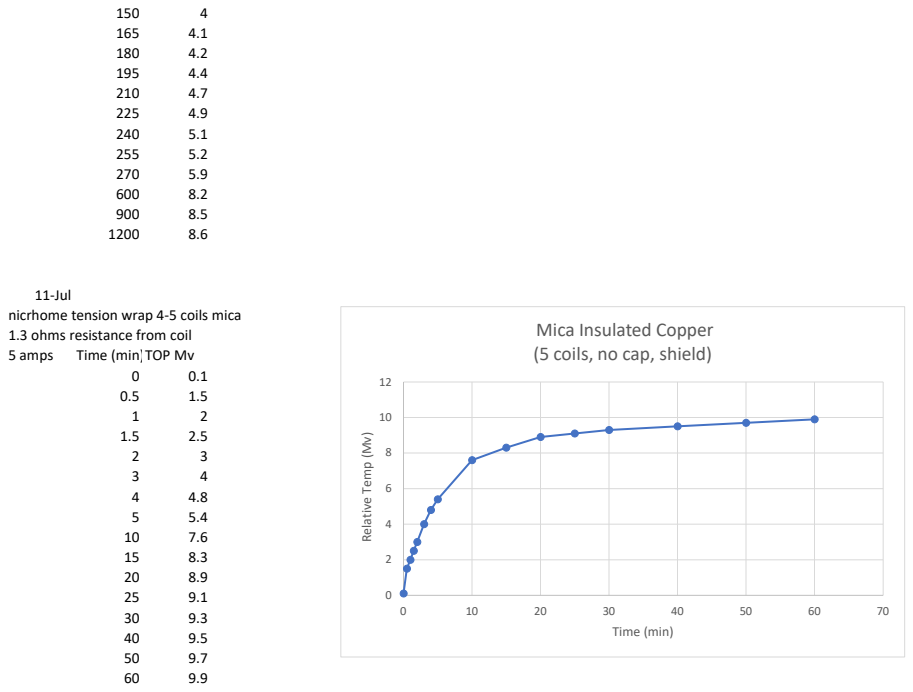
[picture p589: page 3]
5 amps; Time (min)TOP Mv; 70 Relative Temp ⁽Mv⁾; Time (min)

11-Jul
nicrhome tension wrap 4-5 coils mica
1.3 ohms resistance from coil

Mica Insulated Copper
(5 coils, no cap, shield)

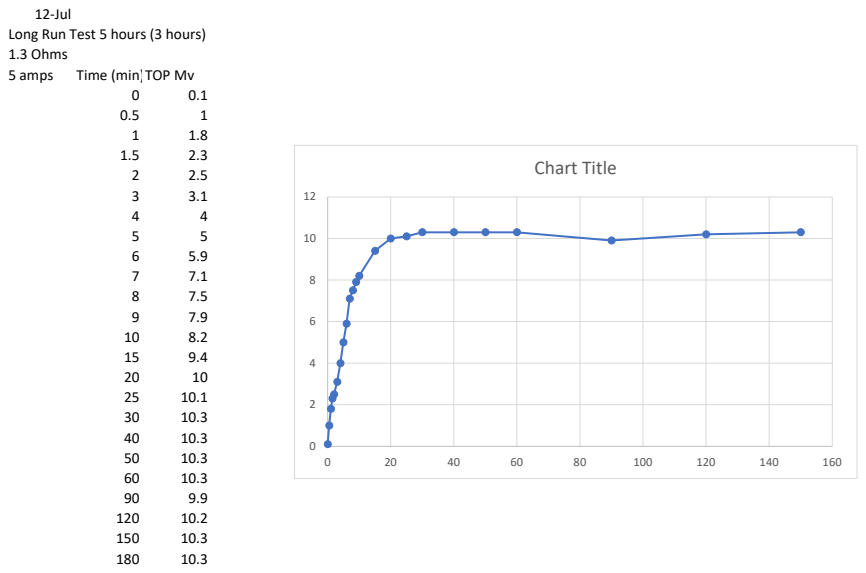
[picture p590: page 4]
5 amps; Time (min)TOP Mv; Chart Title

12-Jul
Long Run Test 5 hours (3 hours)
1.3 Ohms

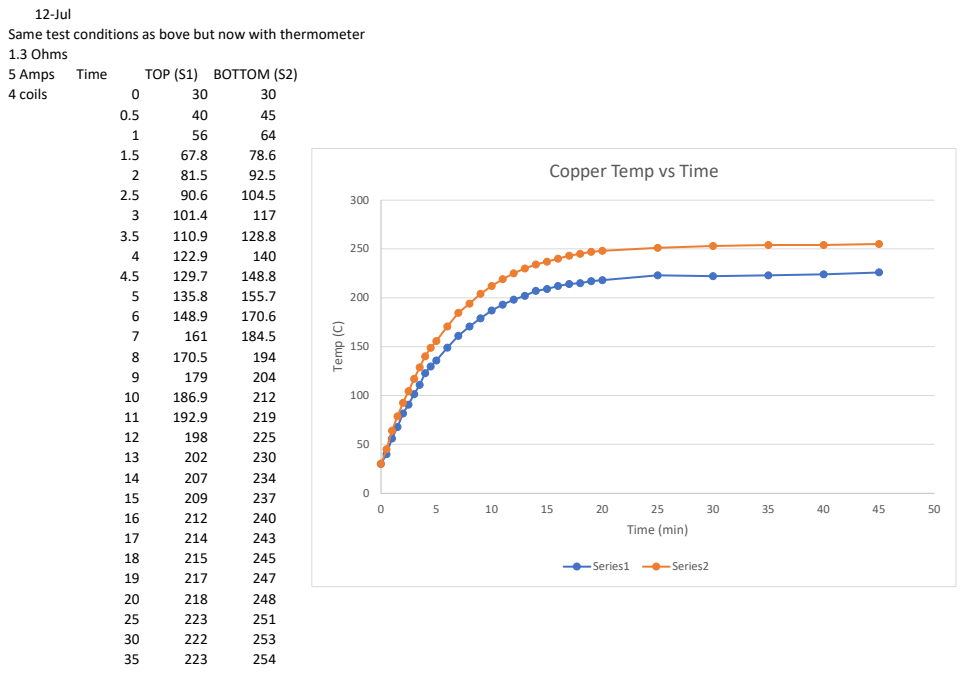
[picture p591: page 5]
5 Amps Time; TOP (S1) BOTTOM (S2); 4 coils; 50 Temp ⁽C⁾; Time (min); Series1; Series2

12-Jul
Same test conditions as bove but now with thermometer
1.3 Ohms

Copper Temp vs Time

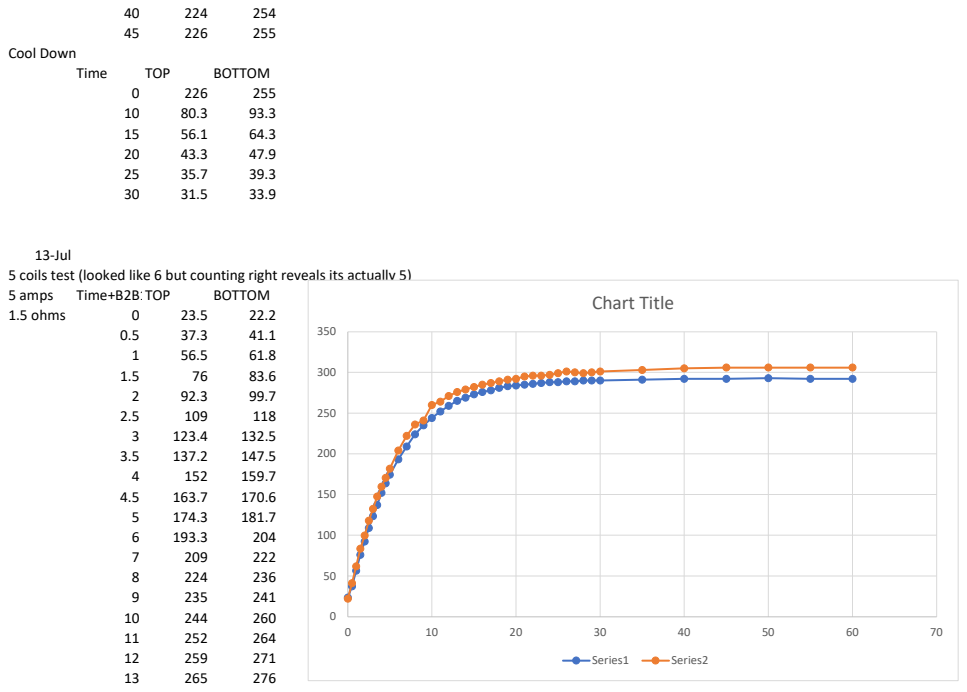
[picture p592: page 6]
Cool Down; Time; TOP; BOTTOM; 5 amps; Time+B2B185:B223 TOP; 1.5 ohms; Chart Title; Series1; Series2

13-Jul
5 coils test (looked like 6 but counting right reveals its actually 5)

14 | 269 | 279
15 | 273 | 282
16 | 276 | 285
17 | 278 | 287
18 | 281 | 289
19 | 283 | 291
20 | 284 | 292
21 | 285 | 295
22 | 286 | 296
23 | 287 | 296
24 | 288 | 297
25 | 288 | 299
26 | 289 | 301
27 | 289 | 300
28 | 290 | 299
29 | 290 | 300
30 | 290 | 301
35 | 291 | 303
40 | 292 | 305
45 | 292 | 306
50 | 293 | 306
55 | 292 | 306
60 | 292 | 306

### 6 coils 1.8 ohms 5 amps

Time | TOP | BOTTOM
0 | 25.6 | 26.6
0.5 | 52.8 | 59
1 | 67.1 | 79.5

### Chart Title

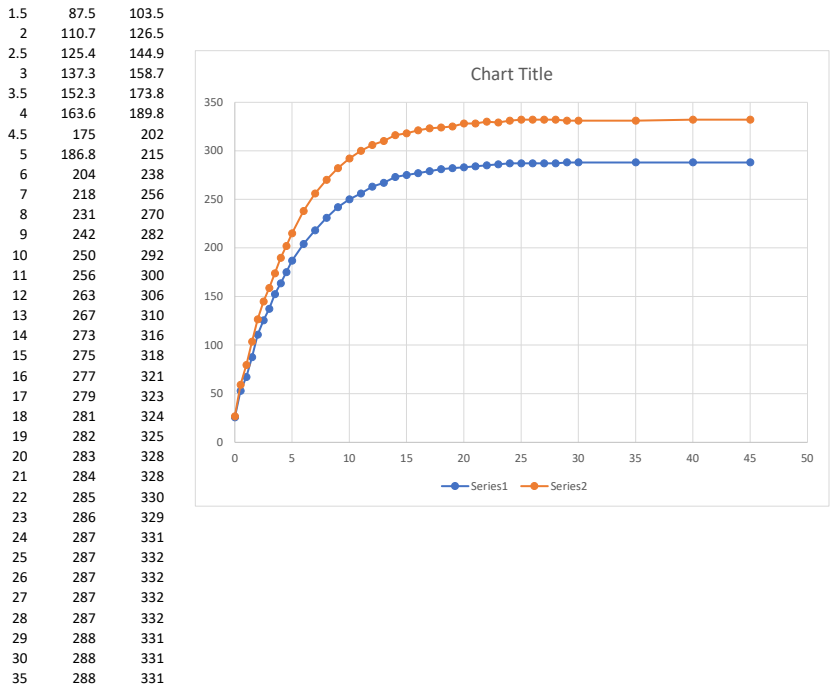
[picture p593: page 8]
Series1; Series2

40 | 288 | 332
45 | 288 | 332 Side note, definitely had a contact issue because when measured separately found 309 for TOP

0 0.1
60 0.2
150 0.3
210 0.4
300 0.5
390 0.6
510 0.7
720 0.8
780 0.9
930

1
1140 1.1
1350 1.2

1590 1.3
1800 1.3
2100 1.4
2400 1.4
2700 1.45
2760 1.5
3000 1.5
3300 1.55
3480 1.6
3600 1.6
3900 1.6
4500 1.7
5400 1.7
6300 1.7
7200 1.7
