cross-isaac/IsaacCross_Senior_Thesis/02_Beam_Source_Design/CAD/Oven_SW_Models/Nozzle/Sketches/ModifiedFlangeV1.pdf

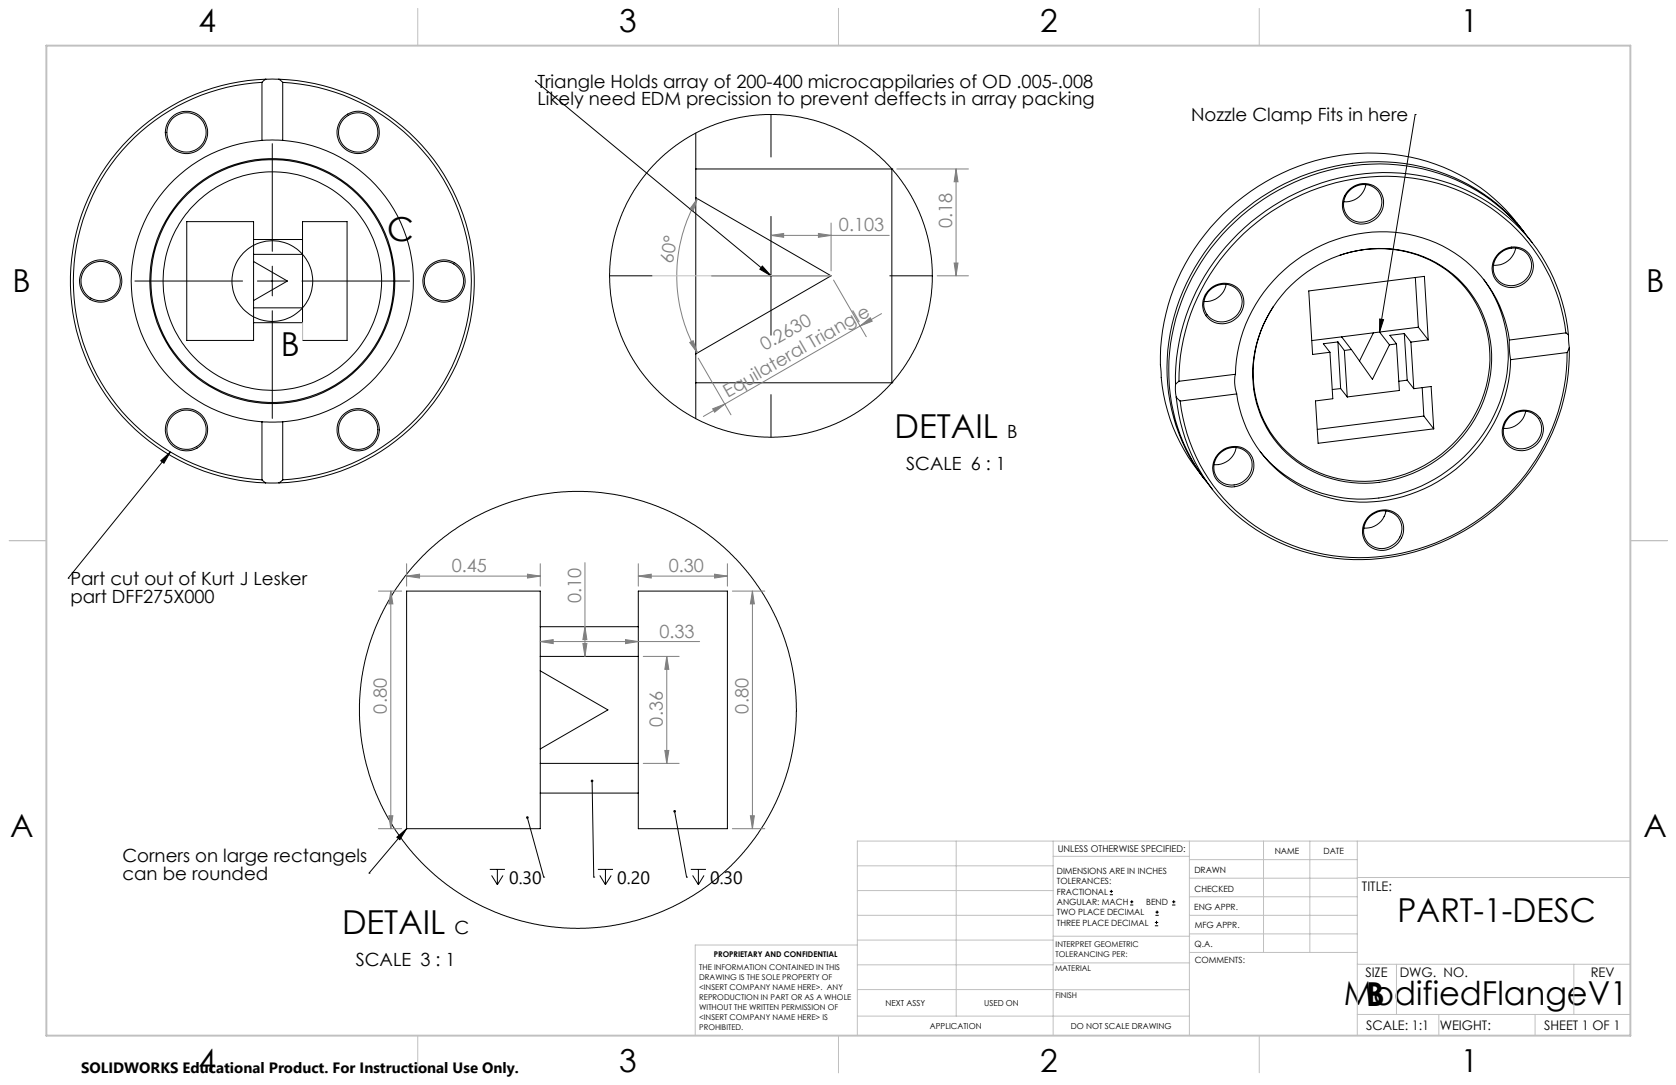
[picture p595: page 1]
Equilateral Triangle; DETAIL B; SCALE 6 : 1; DETAIL C; SCALE 3 : 1

Triangle Holds array of 200-400 microcappilaries of OD .005-.008
Likely need EDM precission to prevent deffects in array packing

Nozzle Clamp Fits in here

Part cut out of Kurt J Lesker
part DFF275X000

Corners on large rectangels
can be rounded

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

CHECKED | | | TITLE: PART-1-DESC

ENG APPR.
MFG APPR.

INTERPRET GEOMETRIC TOLERANCING PER: | Q.A.
MATERIAL | ModifiedFlangeV1 | SIZE B | DWG. NO. | REV

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

NEXT ASSY | USED ON | FINISH

APPLICATION | DO NOT SCALE DRAWING | | SCALE: 1:1 | WEIGHT: | SHEET 1 OF 1

SOLIDWORKS Educational Product. For Instructional Use Only.
