cross-isaac/IsaacCross_Senior_Thesis/09_Kovachy_Lab/Strontium Resevoir/oven/Sketch/shield.pdf

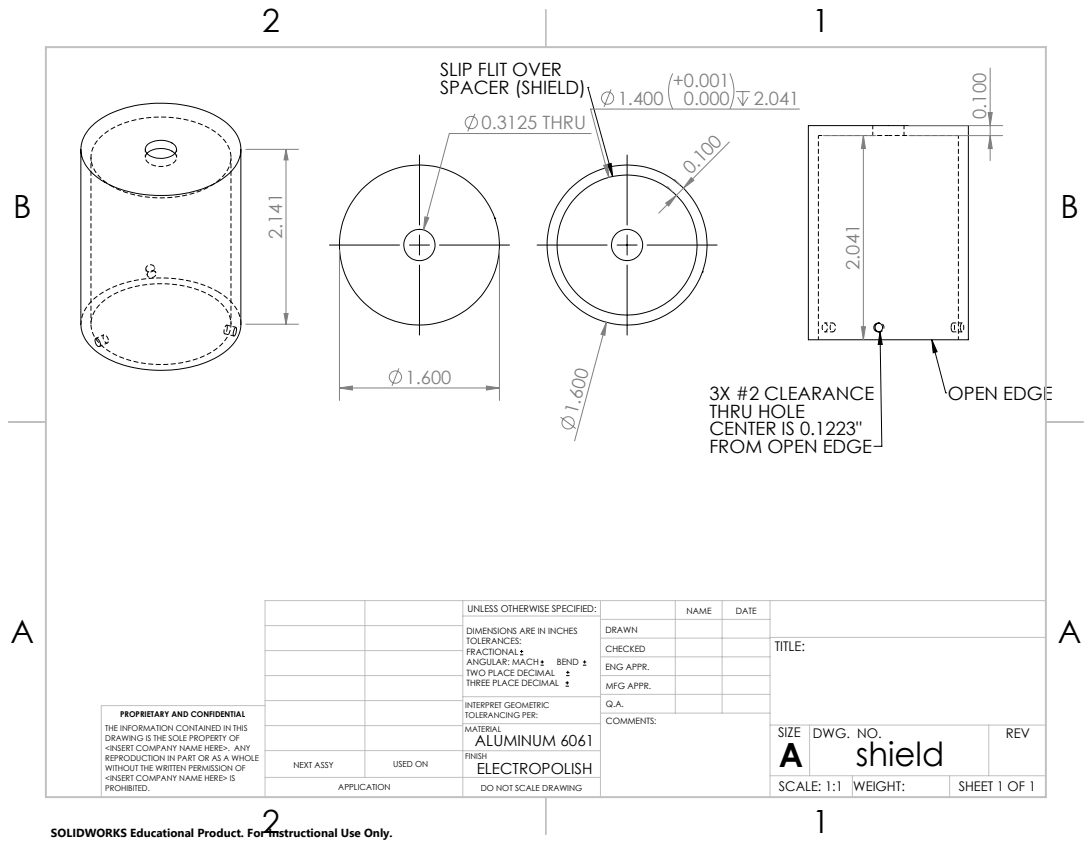
[picture p597: page 1]
OPEN EDGE

SLIP FLIT OVER
SPACER (SHIELD)
0.3125 THRU

3X #2 CLEARANCE
THRU HOLE
CENTER IS 0.1223"
FROM OPEN EDGE

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

CHECKED | | | TITLE:

ENG APPR.
MFG APPR.

INTERPRET GEOMETRIC TOLERANCING PER: | Q.A.
MATERIAL ALUMINUM 6061 | | SIZE A | DWG. NO. shield | REV

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

NEXT ASSY | USED ON | FINISH ELECTROPOLISH

APPLICATION | DO NOT SCALE DRAWING | | SCALE: 1:1 | WEIGHT: | SHEET 1 OF 1

SOLIDWORKS Educational Product. For Instructional Use Only.
