cross-isaac/IsaacCross_Senior_Thesis/09_Kovachy_Lab/Strontium Resevoir/oven/Sketch/Sr Reservoir.pdf

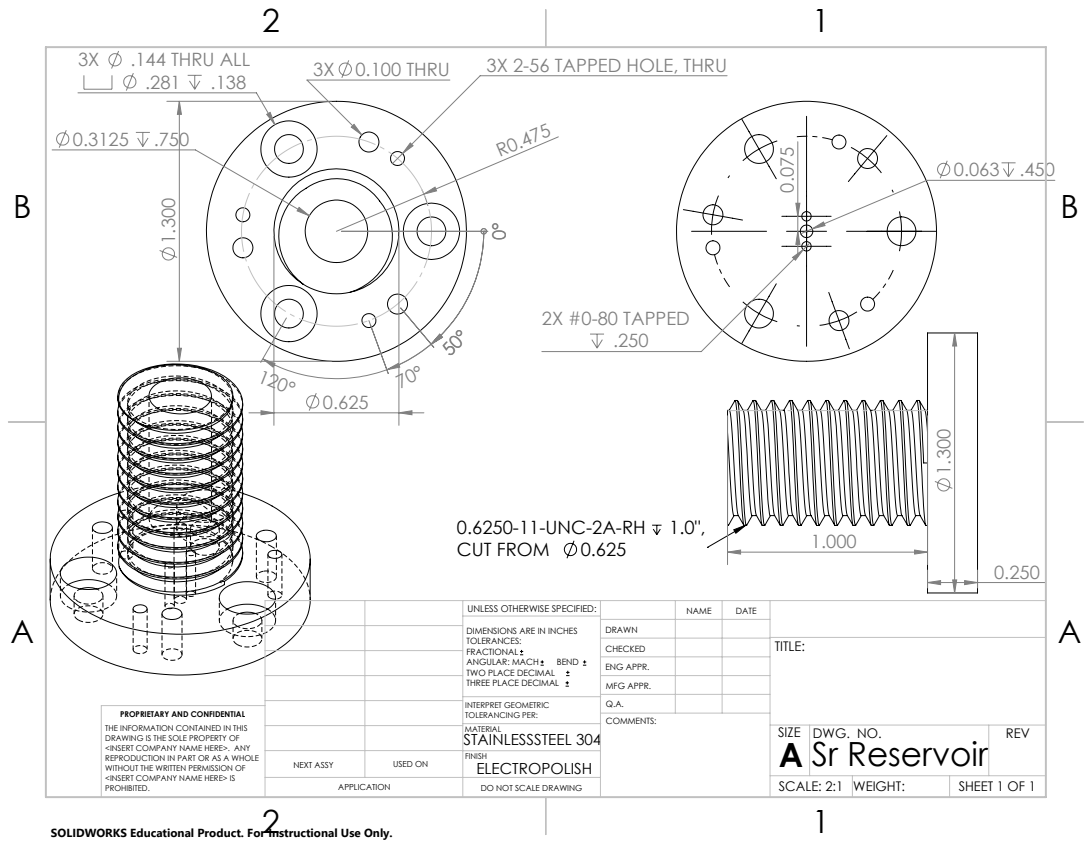
[picture p598: page 1]
3X 0.100 THRU 3X; .144 THRU ALL; 2X #0-80 TAPPED; 1.000 0.6250-11-UNC-2A-RH 1.0",; CUT FROM

3X 2-56 TAPPED HOLE, THRU 0°

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

CHECKED | | | TITLE:

ENG APPR.
MFG APPR.

INTERPRET GEOMETRIC TOLERANCING PER: | Q.A.
MATERIAL STAINLESSSTEEL 304 | | SIZE A | DWG. NO. Sr Reservoir | REV

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

NEXT ASSY | USED ON | FINISH ELECTROPOLISH

APPLICATION | DO NOT SCALE DRAWING | | SCALE: 2:1 | WEIGHT: | SHEET 1 OF 1

SOLIDWORKS Educational Product. For Instructional Use Only.
