cross-isaac/IsaacCross_Senior_Thesis/08_Proposals_and_Applications/Proposals/WURG2023_IsaacCross (Got).pdf

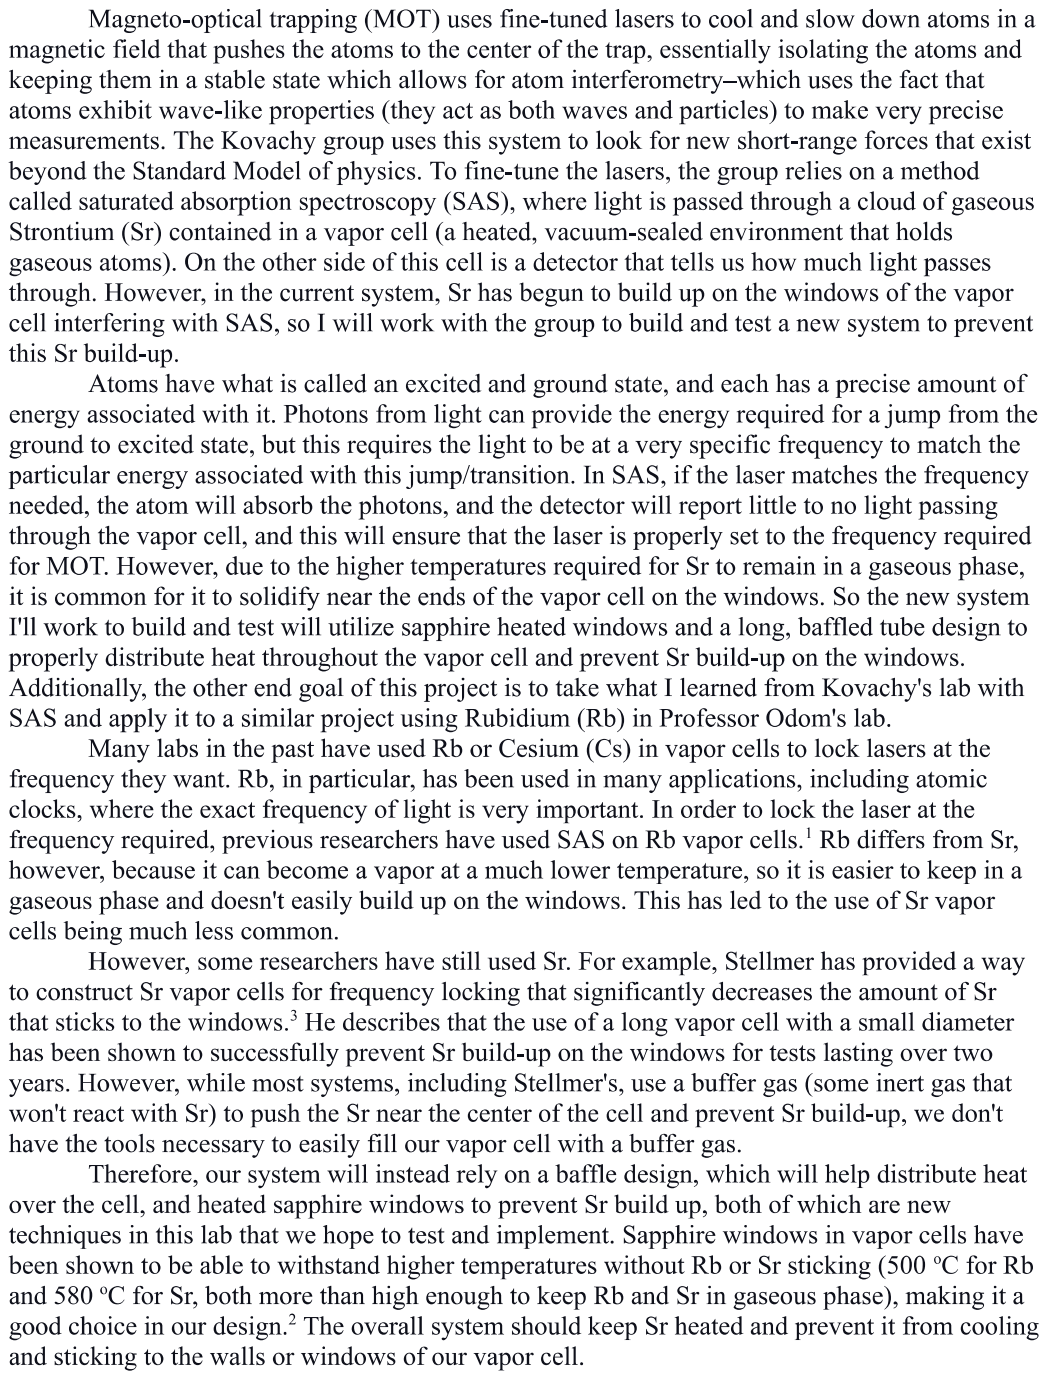
[picture p599: page 1]

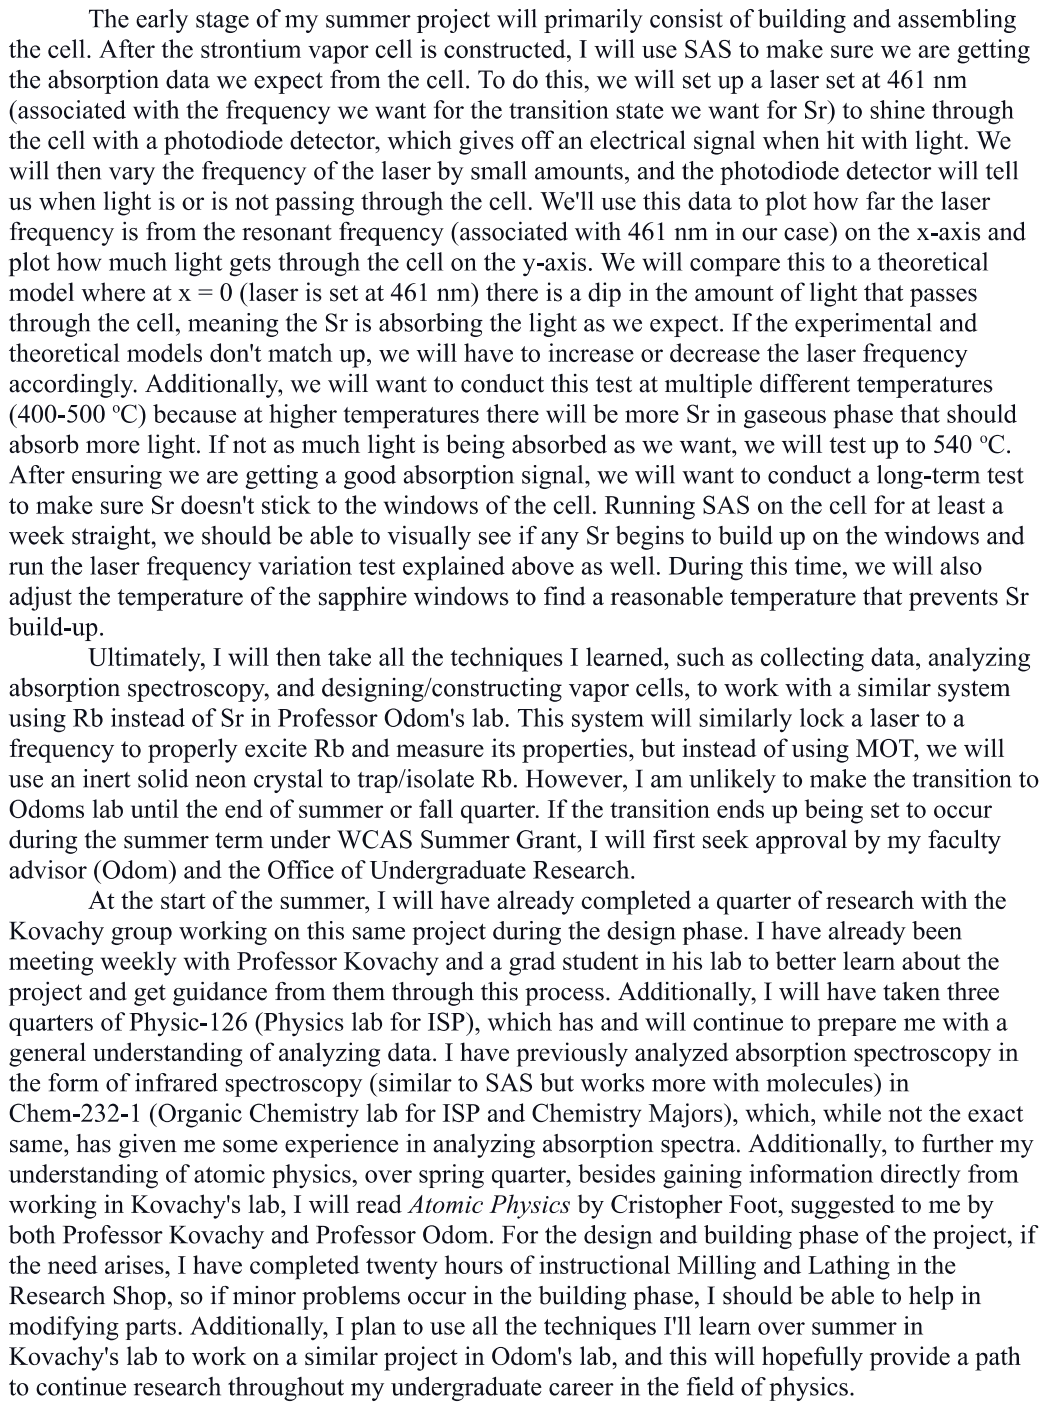
[picture p600: page 2]

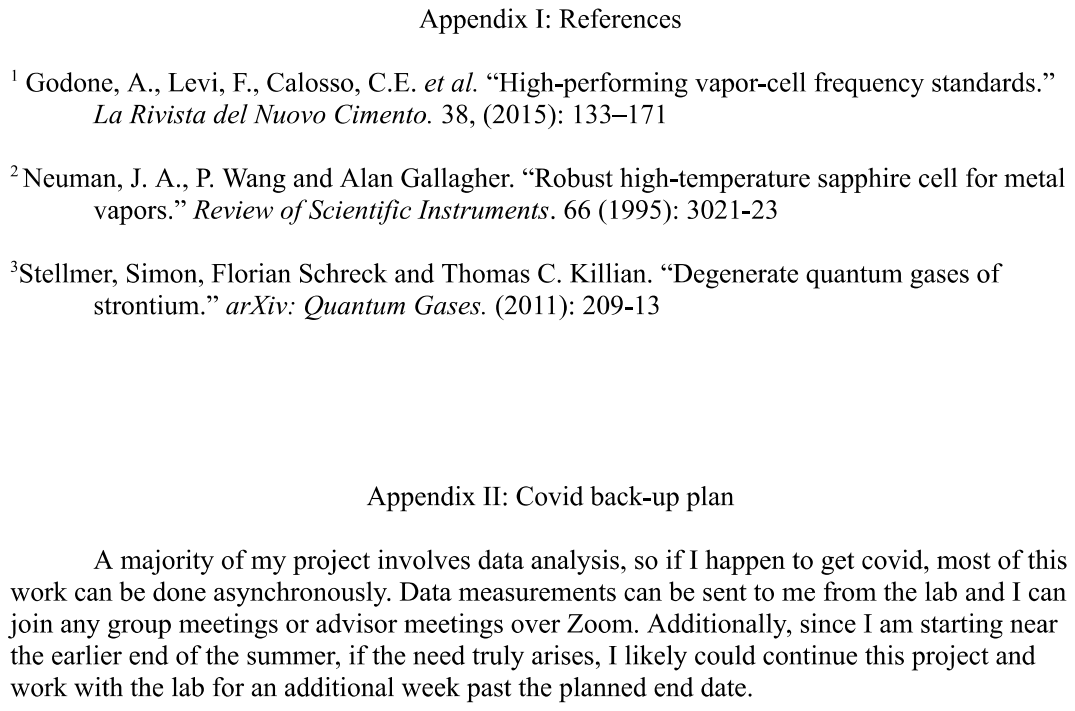
[picture p601: page 3]
