cross-isaac/IsaacCross_Senior_Thesis/02_Beam_Source_Design/CAD/Crystal_Growth_Chamber/CHEX Aparatus 2/CHEX Appartus 2 Drawings/CHEX Apparatus 2 Drawing 1.PDF

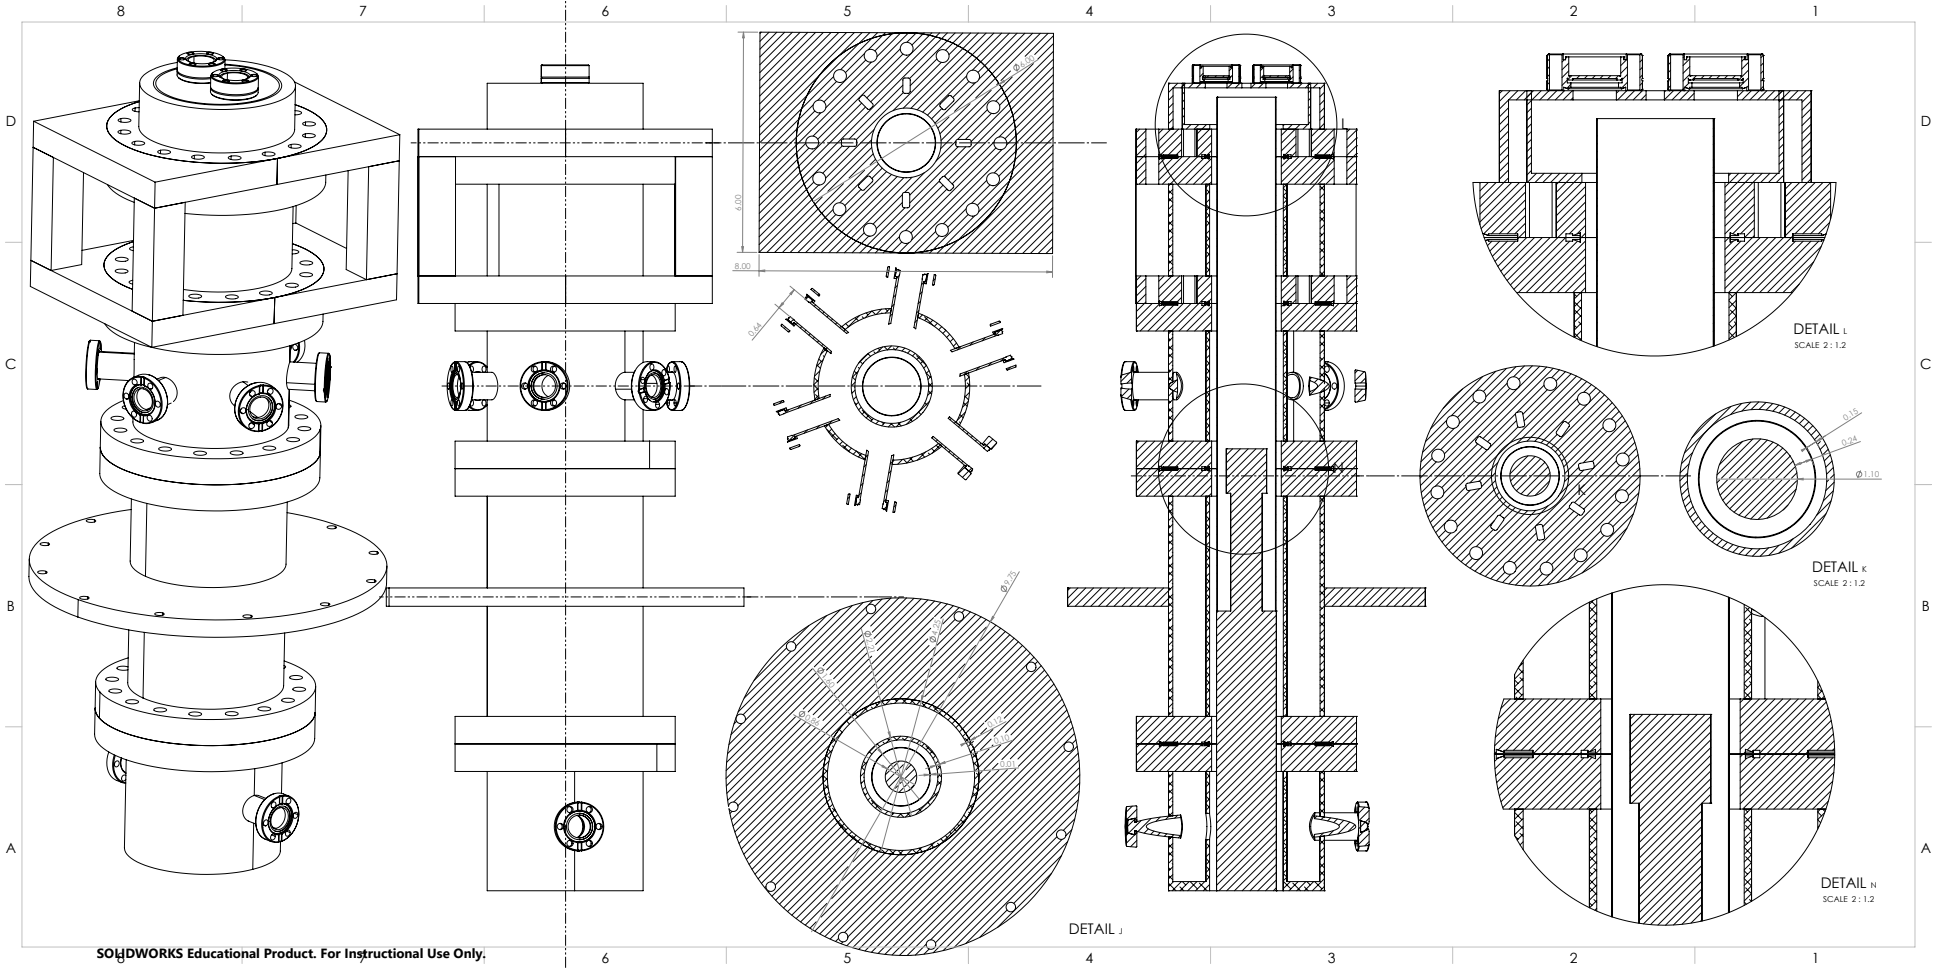
[picture p602: page 1]
DETAIL J; DETAIL K; SCALE 2 : 1.2; DETAIL L; DETAIL N

SOLIDWORKS Educational Product. For Instructional Use Only.
