cross-isaac/IsaacCross_Senior_Thesis/03_Heaters_and_Monitoring/ss_heater_T_vs_t.pdf

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

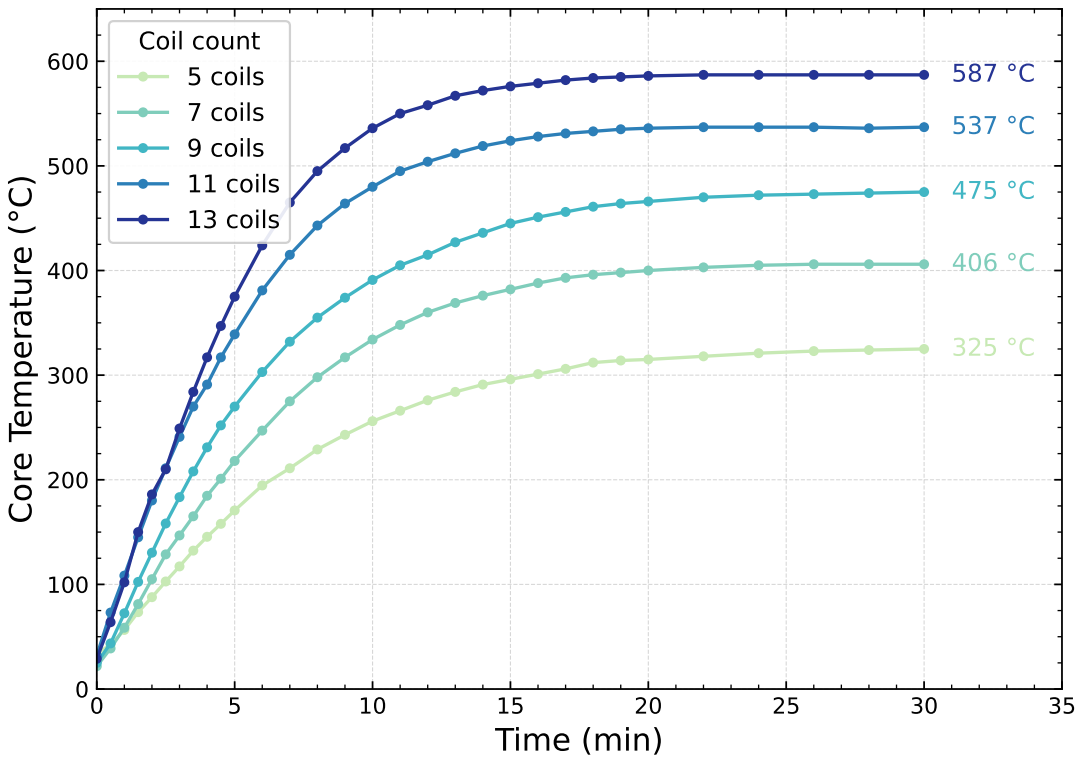
[picture p603: page 1]
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
