cross-isaac/IsaacCross_Senior_Thesis/99_Archive/ai_generated_drafts/oven_design.pdf

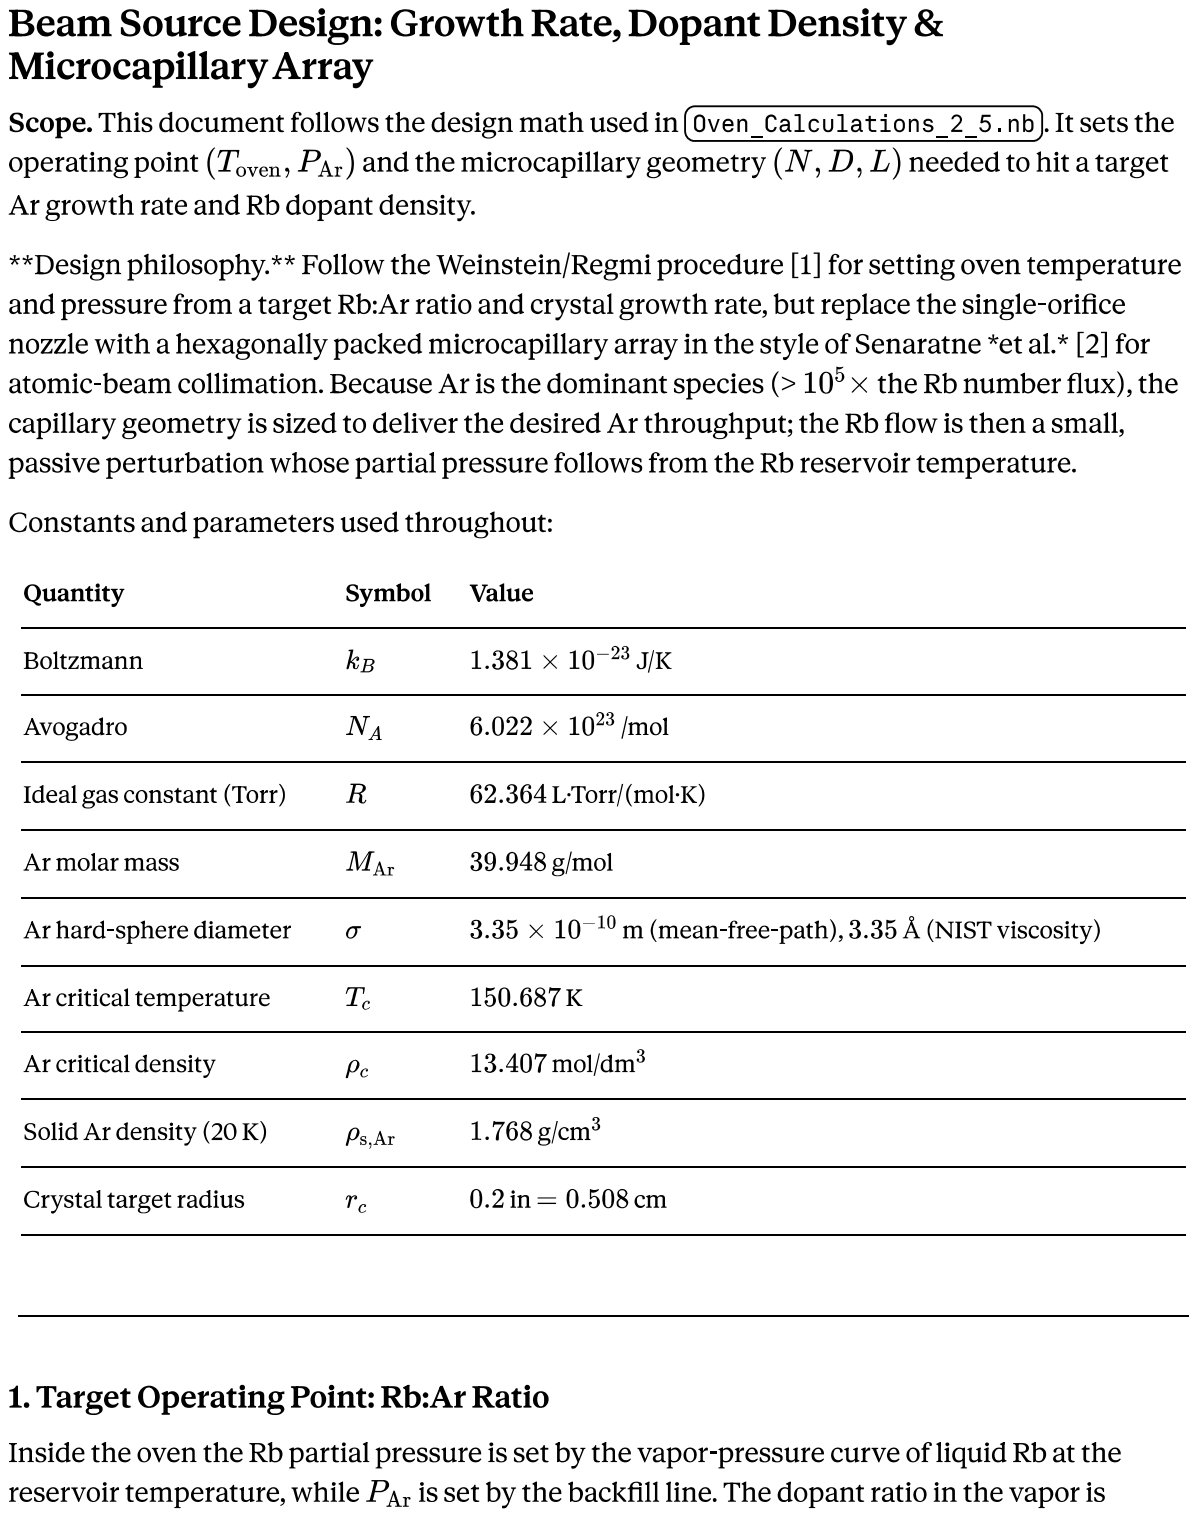
[picture p604: page 1]

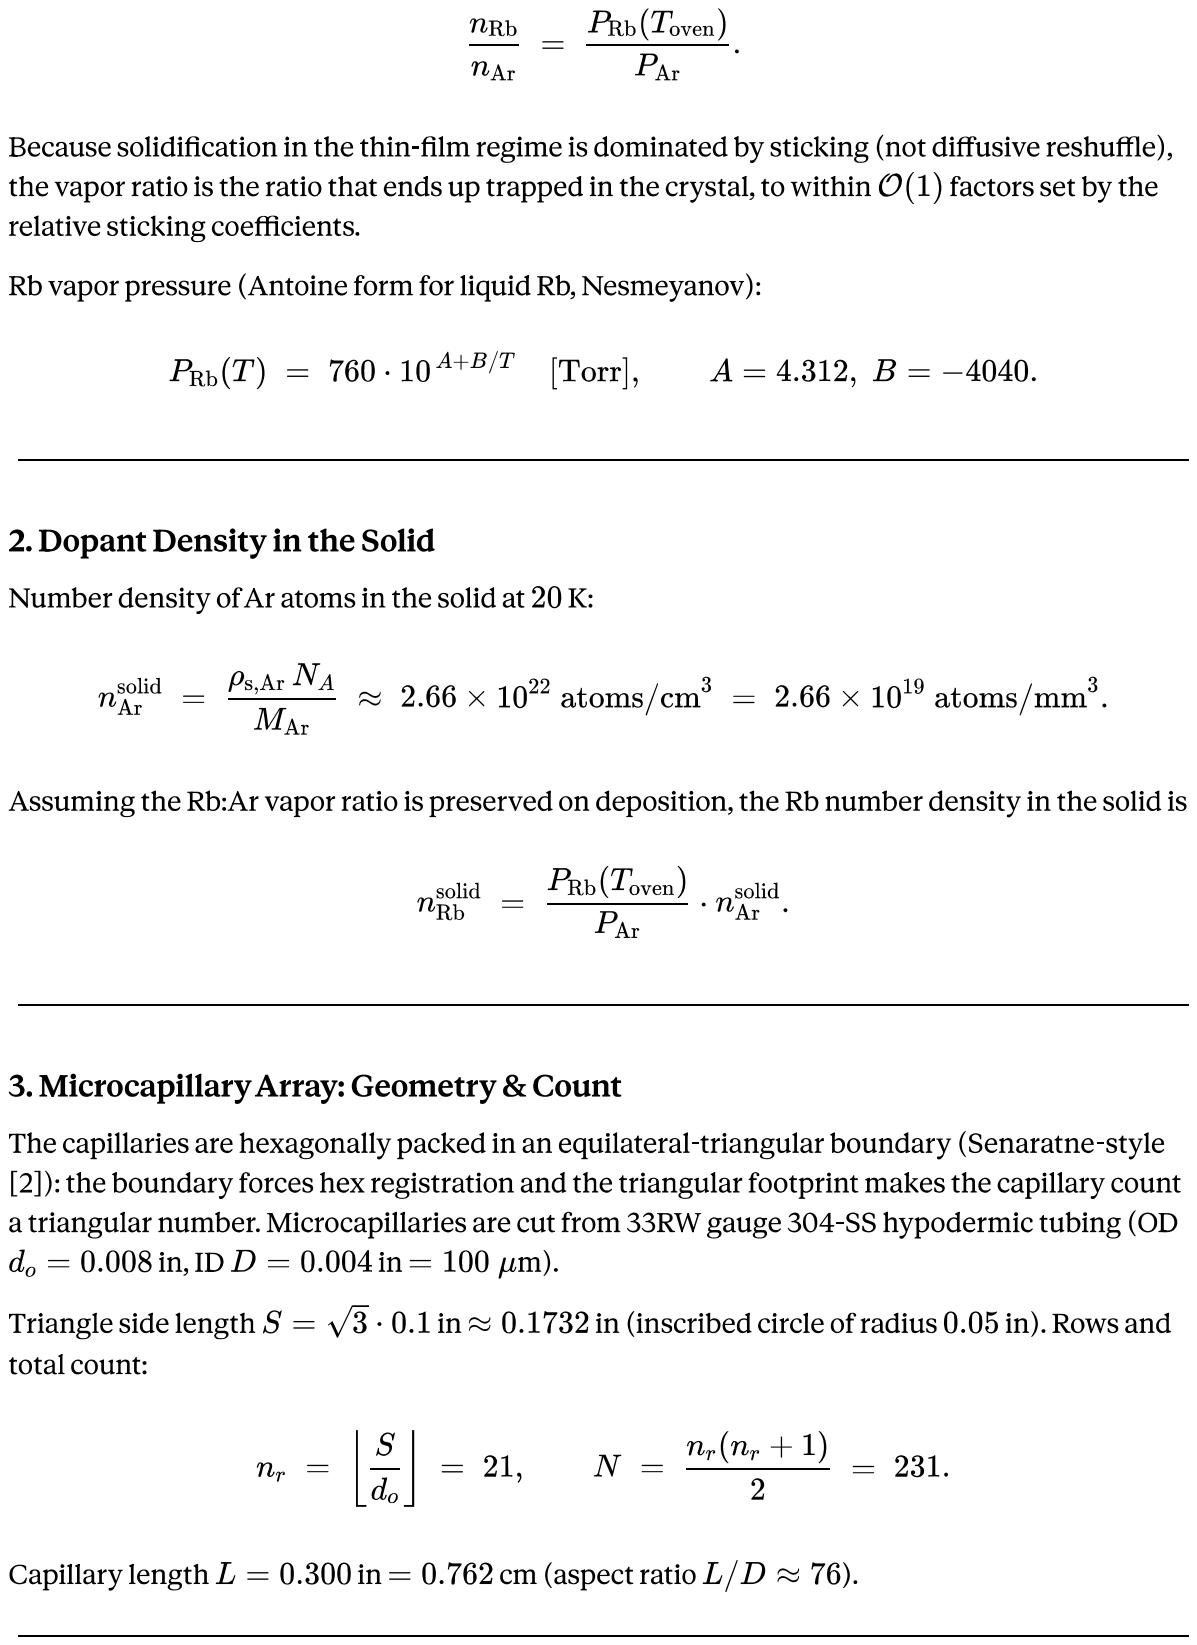
[picture p605: page 2]

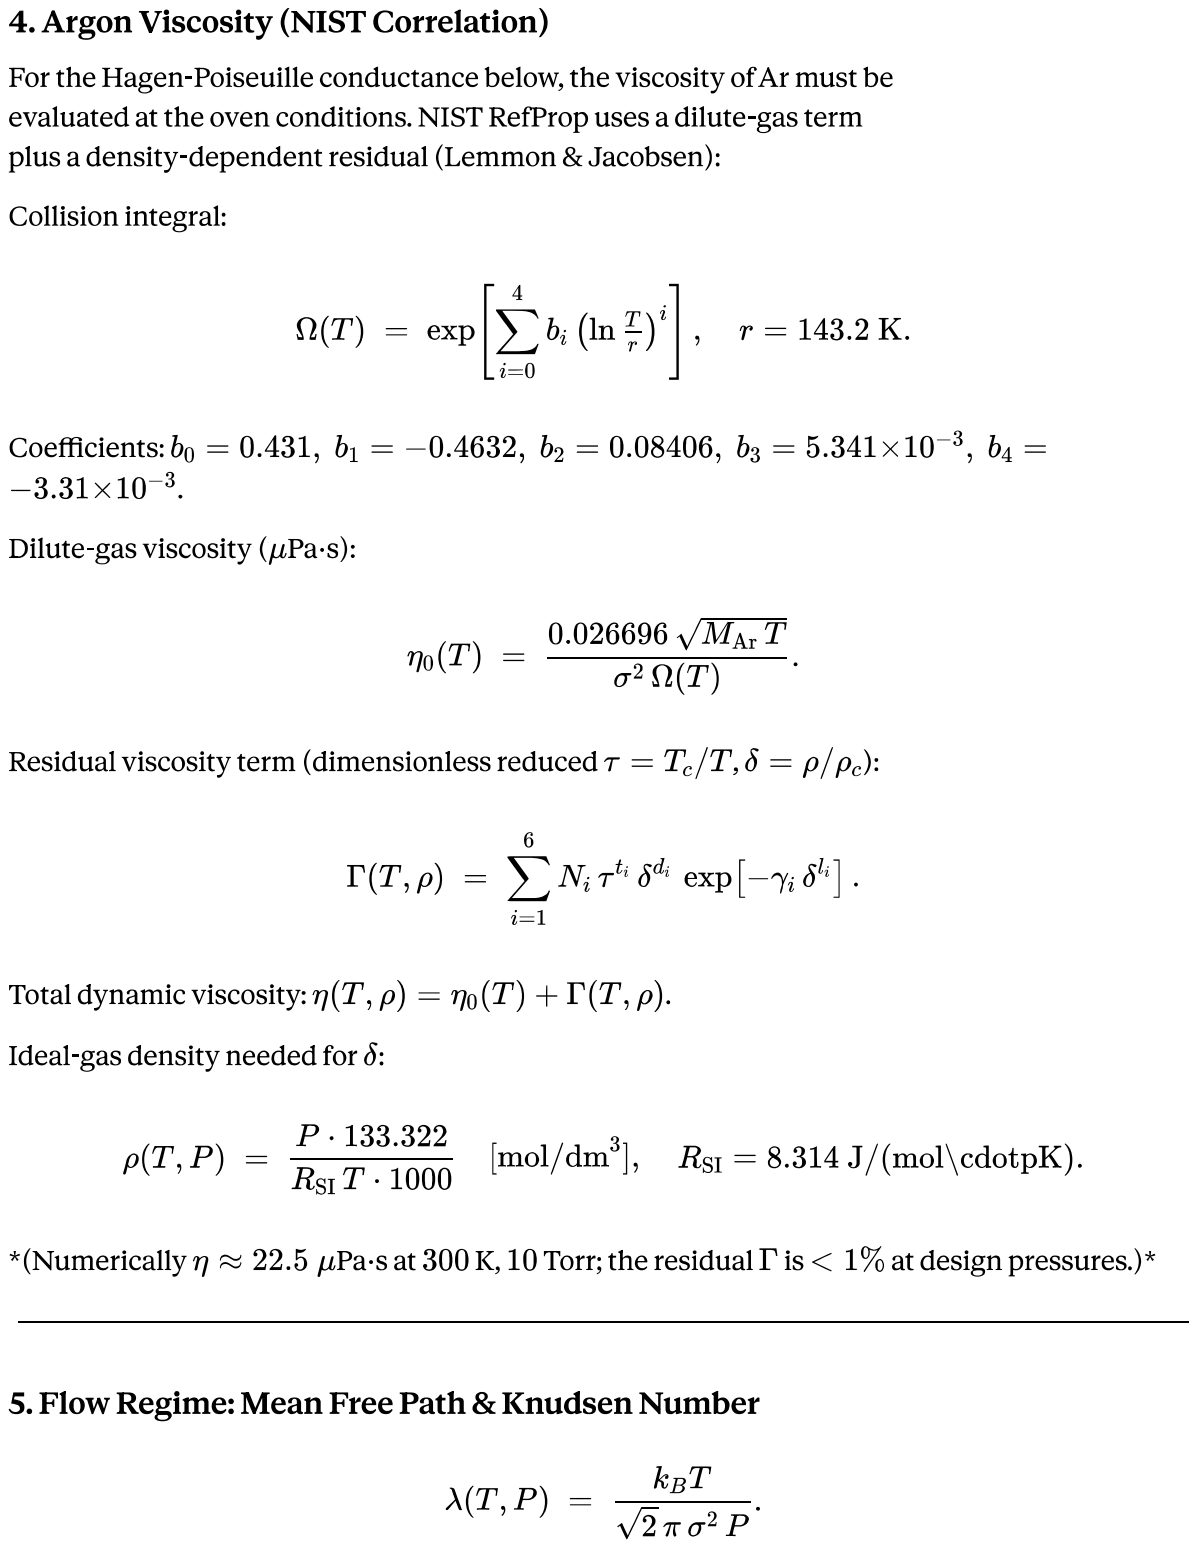
[picture p606: page 3]

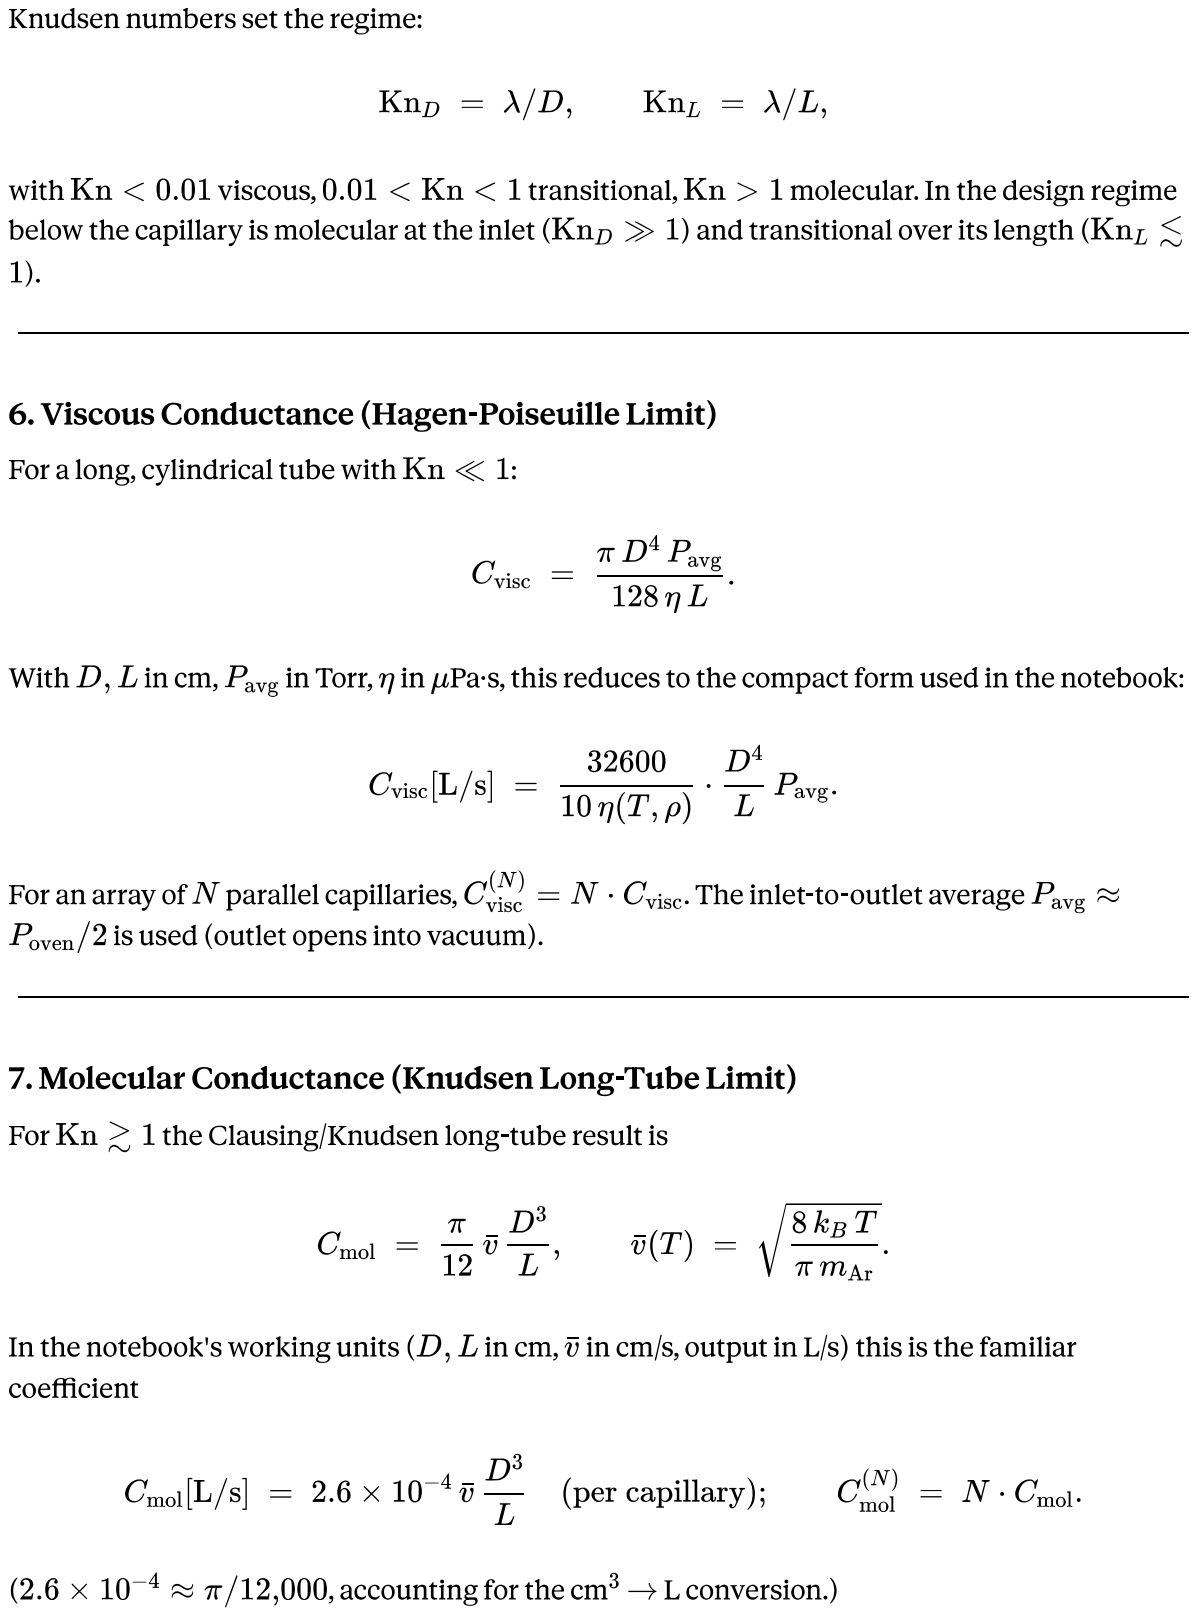
[picture p607: page 4]

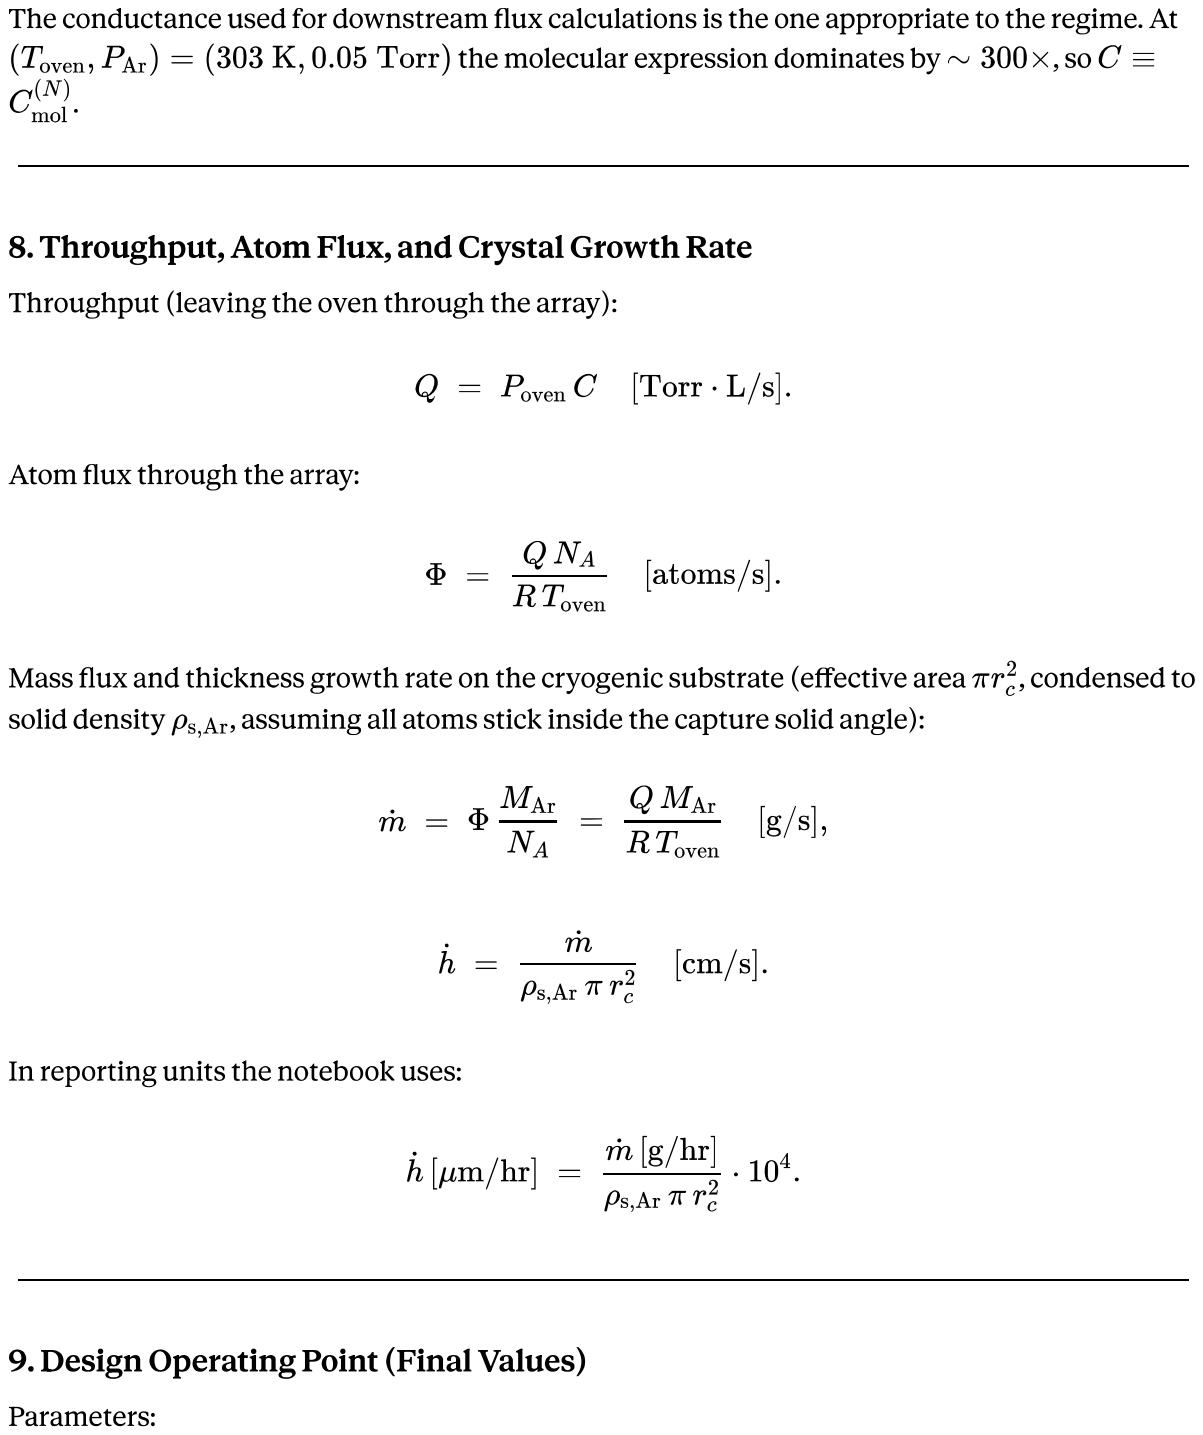
[picture p608: page 5]

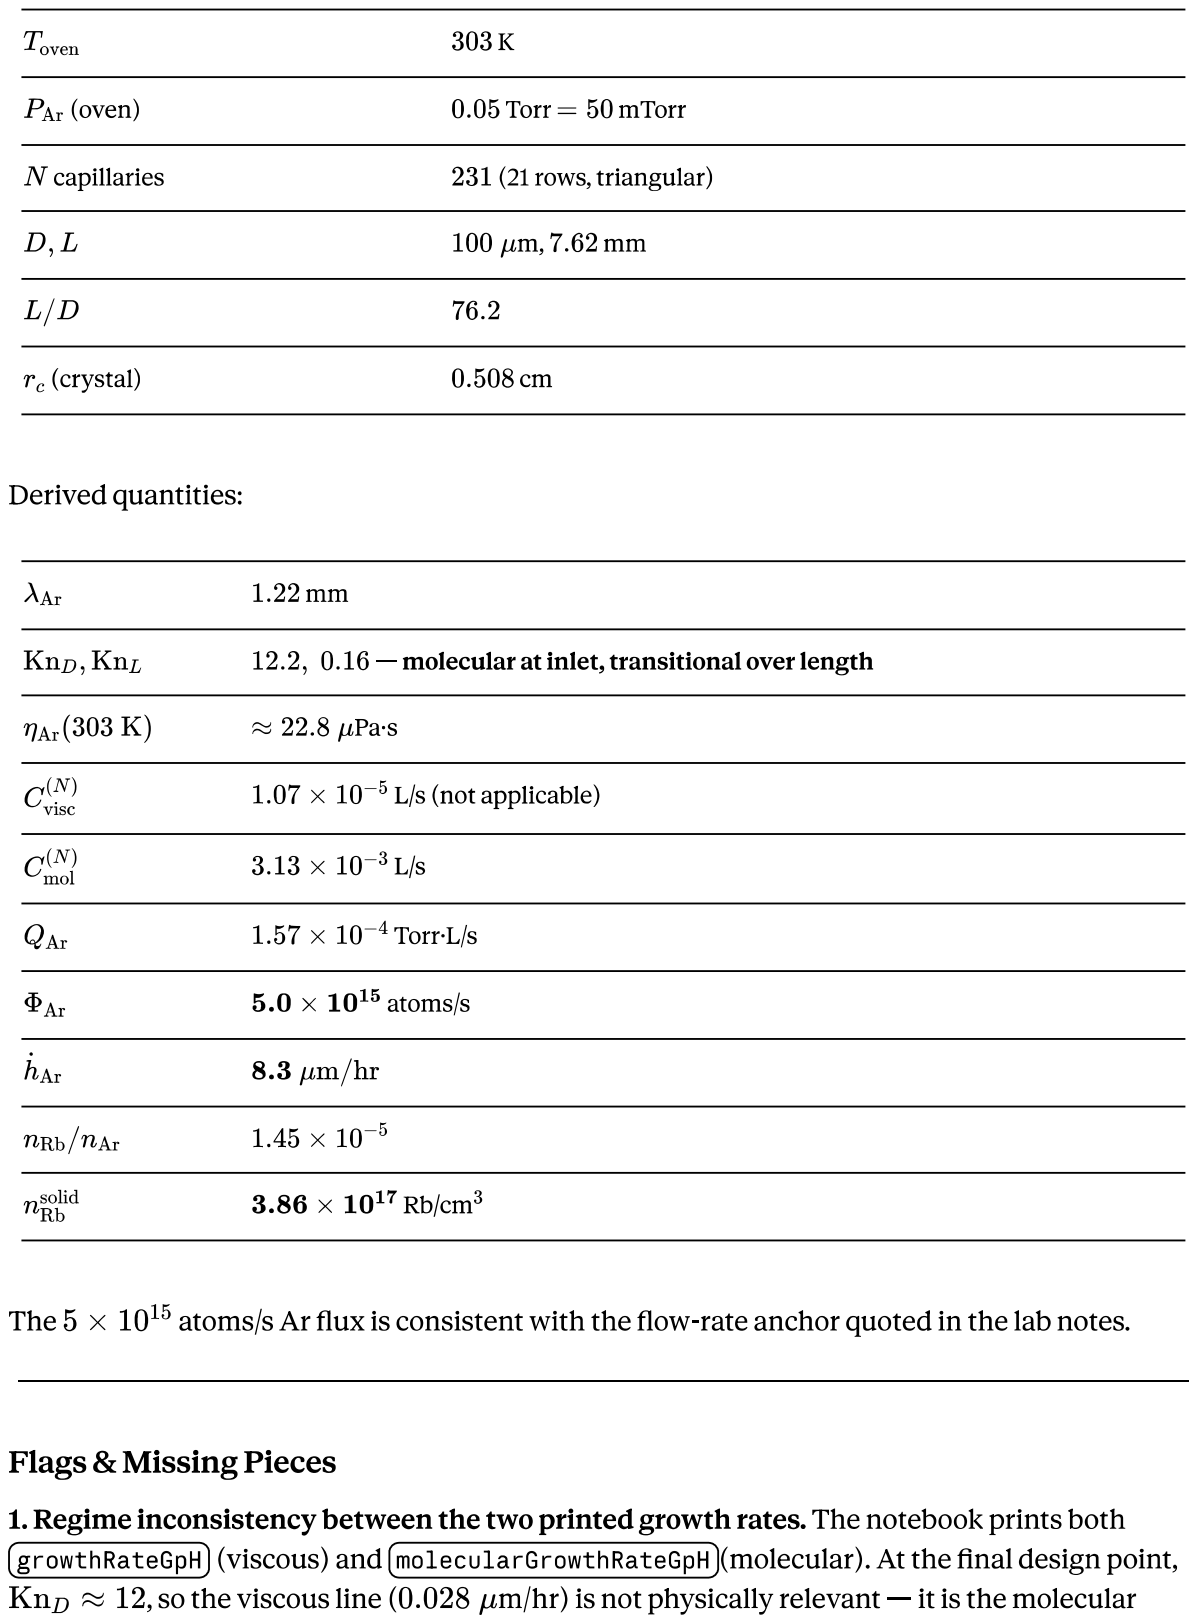
[picture p609: page 6]

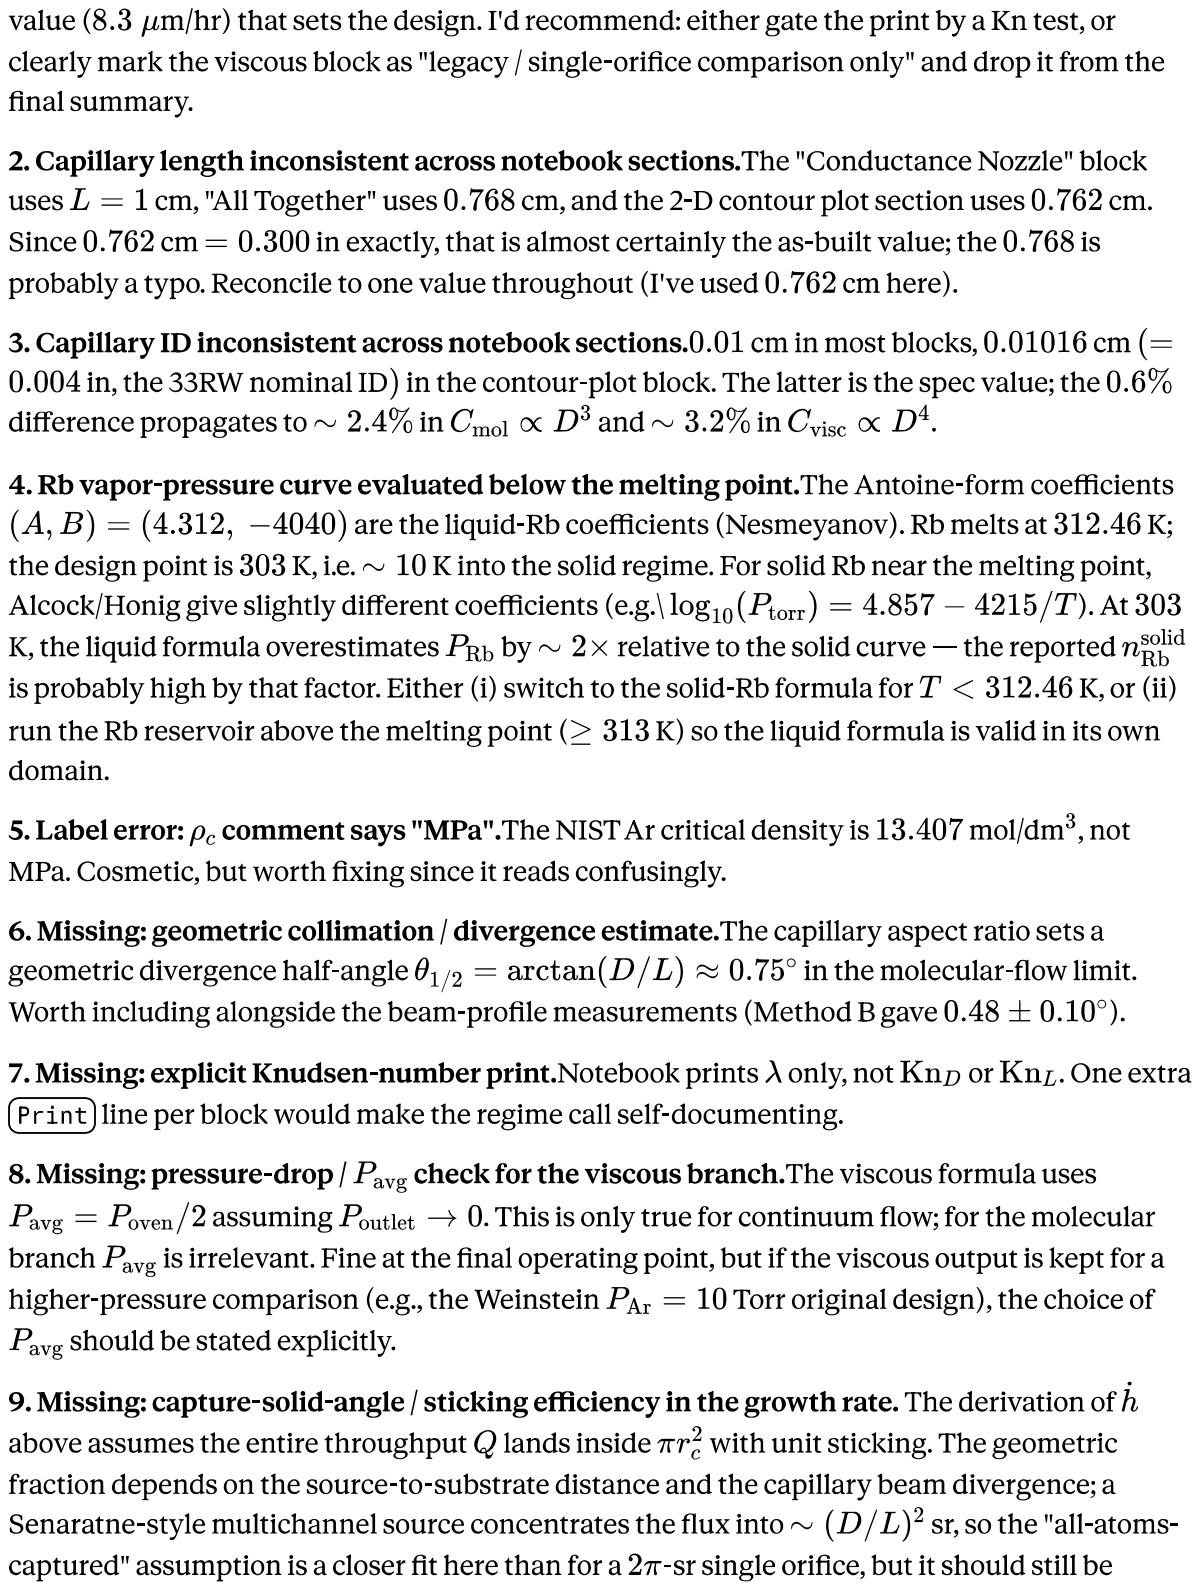
[picture p610: page 7]

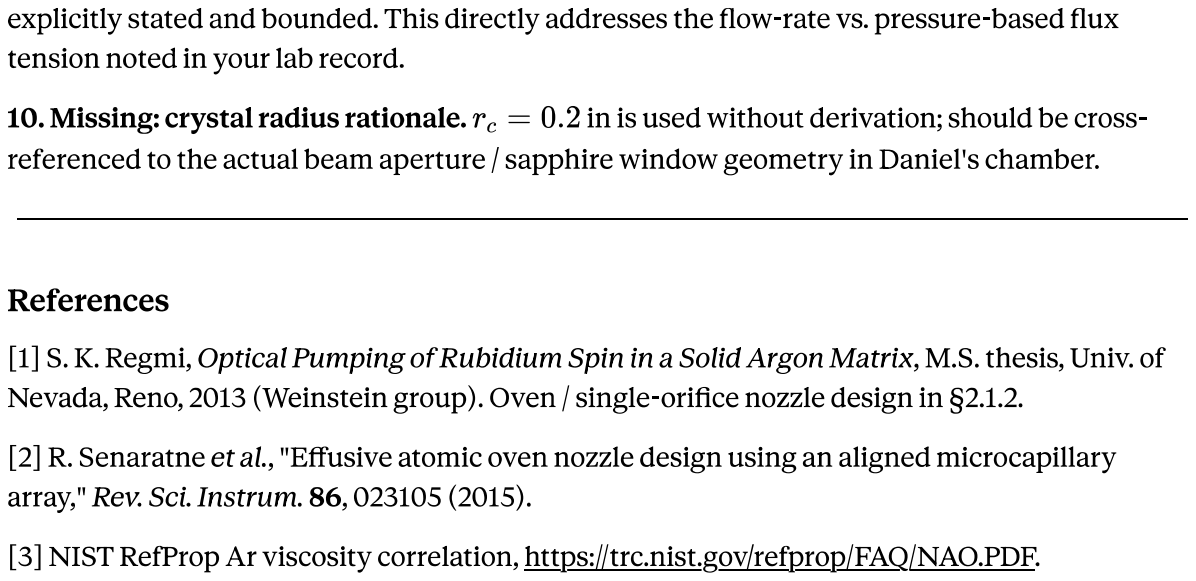
[picture p611: page 8]
