cross-isaac/IsaacCross_Senior_Thesis/06_Figures_and_Media/Thesis_Figures/Ch03_Beam Source Design/IMG_99182BD7-4ECD-4829-AF9E-D99A37C33C2F.JPEG

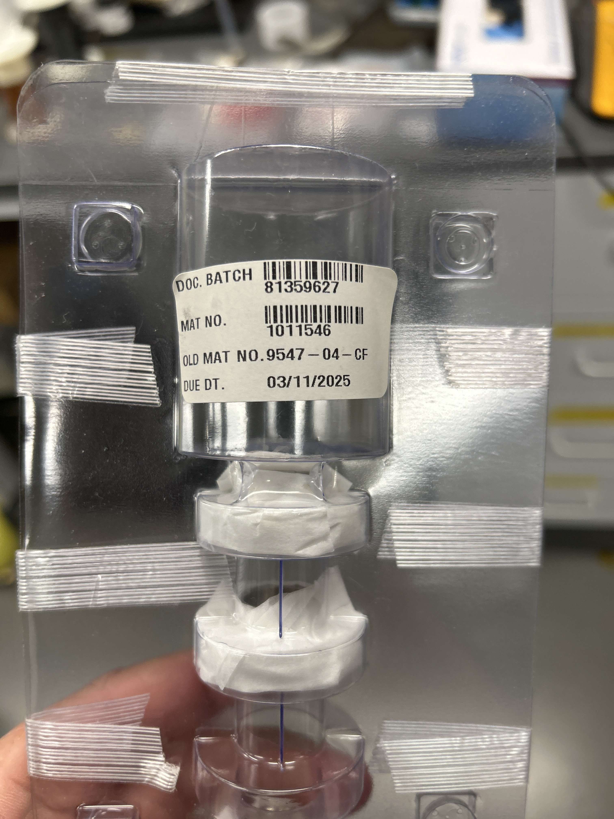
06_Figures_and_Media/Thesis_Figures/Ch03_Beam Source Design/IMG_99182BD7-4ECD-4829-AF9E-D99A37C33C2F.JPEG
