cross-isaac/IsaacCross_Senior_Thesis/06_Figures_and_Media/Thesis_Figures/Ch03_Beam Source Design/IMG_D8F9E0DE-85B2-4FBB-9C0F-9AD1AD2484E8.JPEG

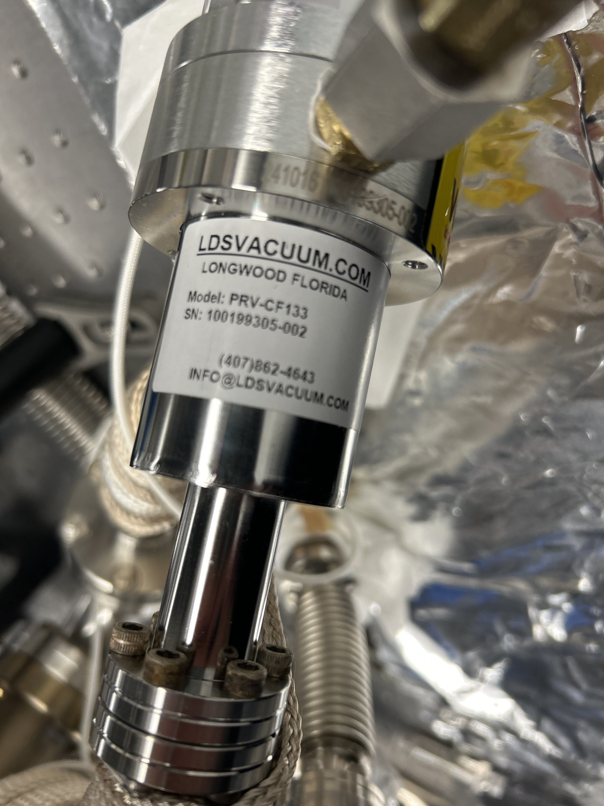
06_Figures_and_Media/Thesis_Figures/Ch03_Beam Source Design/IMG_D8F9E0DE-85B2-4FBB-9C0F-9AD1AD2484E8.JPEG
